pachurii-knowledge/empty-sekai-lake/fpga/openroad/ASAP7_STATIC_ANALYSIS.md

# ASAP7 Static RTL Analysis — Single-Core niigo-lake OoO + SoC

> **Scope:** the single-core out-of-order RISC-V core + SoC as it enters ASAP7 synthesis — build config
> `RV64 + OOO_4WIDE + L1_CACHES + L1D_CACHE + AXI_MEMSYS + FPGA_BUILD + SYNTHESIS` (COHERENT=0; CCD/L2 param/`ifdef`-gated off).
> **Target flow:** OpenROAD *integrated* synthesis (yosys-slang frontend + generic ABC technology map) onto the
> ASAP7 7.5-track 7nm predictive PDK (RVT cells, TT corner, 1× collateral). Generic ABC has **no DSP macros, no
> register retiming, and no SRAM-macro mapping step** — those three gaps drive most of what follows.

> **Method:** a multi-agent static-analysis workflow — 11 per-subsystem analyzers, each finding adversarially
> verified against the cited RTL by a second agent, then ranked/synthesized — cross-referenced against the
> real per-block ASAP7 Fmax measured in the OpenROAD trial run (pre-CTS, placed parasitics). 31 timing findings
> and 36 cell-mapping findings survived verification.

> _Generated 2026-07-02. This is a design reference for the `asap7-synth` branch; it recommends RTL/flow changes
> but the numbers above the whole-core scale wall are structural lower bounds, not a routed/closed Fmax._

---

## Executive summary

As synthesized today the single-core niigo-lake OoO+SoC is bound at **~41.7 MHz by the CVFPU FP64 FMA**, whose 53×53→106b mantissa multiply and the following 164-bit CPA sit in one register-bounded stage (`fpnew_fma.sv:338/381`); the CVFPU DISTRIBUTED split (NumPipeRegs=2) never partitions the `*` operator, and generic ABC has neither DSP macros nor register retiming to fix it. The `ooo_mul_unit` 64×64 multiply (`ooo_mul_unit.sv:94-95`) is the same disease one tier up at ~103.6 MHz. The single biggest *area/mappability* risk is that OpenROAD integrated-syn has **no SRAM-macro step, so every inferred memory becomes flops**: L1 data ~262 Kbit, ITTAGE ~306 Kbit, TAGE ~46 Kbit, plus the 4096-bit 8R4W phys_reg_file and the 32×~348b ROB — together the dominant cell area *and* the source of async 1024:1 / 64:1 read-mux delay cones. The whole-core Fmax is unmeasured (ABC died mid-rewrite at 8.85M ANDs — the scale wall), so the 42 MHz floor is a structural-certain lower bound, not a routed number. Headline recommendation: **blackbox the L1 data/tag and register-then-SRAM the ITTAGE/TAGE tables, and replace the two monolithic multipliers (`*`) with operator-internally-pipelined Booth/Wallace CSA trees** — this attacks the binding timing path and the #1 area sink simultaneously; everything else (branch_stack, LSQ store-format, phys_reg_file mux) is second-tier below the 42 MHz floor.

## Top timing bottleneck paths (ranked)

| Rank | Path | Subsystem | Root cause | Est. severity | Measured Fmax | Evidence |
|---|---|---|---|---|---|---|
| 1 | FMA mantissa mult → 164b CPA in one stage | niigo_fp_unit / CVFPU FMA | 53×53 `product = mantissa_a*mantissa_b` + `sum_pos/neg` 164b adders, no reg between; DISTRIBUTED doesn't split `*` | **BINDING (high)** | **41.7 MHz** | `cvfpu/src/fpnew_fma.sv:338,381,387`; `niigo_fp_unit.sv:44-52` |
| 2 | FMA normalize/round tail (no OUT reg) | niigo_fp_unit / CVFPU FMA | 109b LZC → 164b variable left shift → 63b round increment, NUM_OUT_REGS=0 | high (co-critical w/ #1) | 41.7 MHz | `fpnew_fma.sv:514-524,551,600-621`; `fpnew_rounding.sv:65` |
| 3 | ooo_mul 64×64 `*` in stage S1 | Int execute (mul) | monolithic 128-level array multiply, MUL_LATENCY=3 is metadata-only, no DSP/retiming | high | 103.6 MHz | `ooo_mul_unit.sv:94-95,91,160-170` |
| 4 | abort_mask/reset_mask squash broadcast | riscv_core_ooo cross-module | 4-bit net fanned to ~10 modules; `(* max_fanout=64 *)` ignored by yosys/ABC; routed OOC worst path abort_mask_q→DivUnit ~39ns | high (fanout/route-bound) | 199.8 (div logic); route binds | `riscv_core_ooo.sv:438-446,1506-1519` |
| 5 | branch_stack resolve→allocate two comb blocks in one cycle | Frontend checkpoints | Block R abort cross-product + 192b restore mux → Block A serial 4-slot allocate + 32×6b map copy, all reg→reg | high (frontend binder) | **74.3 MHz** | `branch_stack.sv:70-125,130-164,94-96` |
| 6 | LSQ block-W: wakeup CAM → AGU add → 128b store-format barrel shift ×16 | LSQ | per-entry CAM match → 64b AGU add → `format_store_split` 128b var shift, re-derived twice | high | — (standalone 12.2 artifact) | `load_store_queue.sv:855-919,1263-1286` |
| 7 | LSQ head-skip priority encoder → rotated 16:1 ~750b struct mux | LSQ | sq_valid over 16 + rotated reverse-priority scan + wide-struct mux, fed by abort_mask broadcast | high | — | `load_store_queue.sv:376-405,414,975-1038` |
| 8 | phys_reg_file 18-port async read + 4-way WB bypass | Rename/regfile | 64×64 flops, 18×64:1×64b read muxes + write-forward compare cascade pulls WB bus into read path | high | — (2229.9 is map-table, not RF) | `phys_reg_file.sv:26-43`; `riscv_core_ooo.sv:133` |
| 9 | ITTAGE async table read → 1024:1 mux → provider select → 64b target mux | Frontend indirect pred | async-read flop arrays at hashed idx, whole lookup in fetch cycle | high (unmeasured, pipelineable) | — (timeout >2400s) | `ittage_predictor.sv:66-102` |
| 10 | active_list commit head-skip → 4× 32:1 ~348b packet mux | ROB | rotating reverse-priority scan + wide-packet mux on input side of FB2b commit reg | medium | — (2.5 artifact) | `active_list.sv:257-292,306-348` |
| 11 | int_issue_queue wakeup CAM → select → 16:1 ~600b payload mux | Int issue | per-slot associative compare vs 6 tags → serial ALU 2-pick → 5-port payload mux, single-cycle loop | medium | — (0.9 artifact) | `int_issue_queue.sv:90-120,159-167,179-199` |
| 12 | ooo_writeback_bus 6→4 serial-priority crossbar + ready feedback | Writeback | lane-serial priority, 6:1 wide-packet mux, mul/div/fp_writeback_ready reg→comb→reg | medium | — | `ooo_writeback_bus.sv:70-106` |
| 13 | ooo_alu_pipe single-cycle 64b add + 3 barrel shifts + redundant target/cmp recompute | Int execute (ALU) | actual_target_for computed 3× + branch_cmp rerun, into one WB reg | medium | — (0/FAIL artifact) | `ooo_alu_pipe.sv:403-467,58-60,91` |
| 14 | DTLB/ITLB CAM → PMP 16-region priority match (data + 4× fetch) | Priv/MMU translate | 16-way assoc compare chained into 16×54b range-decode+priority-encode; 6 pmp_checker instances | medium | 264.6 (mmu_tlb UB) | `riscv_core_ooo.sv:1017-1071,1138-1170`; `pmp_checker.sv:65-119` |
| 15 | Commit-trap decode → trap_controller delegation → pc_next + die-wide flush | Commit/trap | 4-lane serial exception priority + medeleg/mideleg select + 32-wide restore mux fanout | medium | — | `riscv_core_ooo.sv:1944-2047,643-659,2361-2366` |

Below the 42 MHz floor and reported for completeness only: L1D/L1I load-hit 52-bit 4-way tag compare + way/word mux (`l1_dcache.sv:162-233`, `l1_icache.sv:149-171`), radix-16 divider 16-way mult-compare (199.8 MHz, `ooo_div_unit.sv:269-290`), PLIC 3-pass argmax (`plic.sv:120-150`), free_list 4-wide pointer carry (102.4 MHz).

## ASAP7 cell-mapping problems (ranked)

**Inferred-memory mass (flop-mapped; no SRAM step) — consolidated bit-count:**

| Array | Geometry | Bits | Read type | SRAM-able? |
|---|---|---|---|---|
| ITTAGE tables | 4×1024×64b target + tag/conf/useful/valid | **~306 Kbit** | **async** (hashed idx) | only after registering read |
| L1 data (L1I+L1D) | 2 × (4way×64set×512b) | **~262 Kbit** | sync 1R/1W-masked | **yes — textbook 1RW** |
| TAGE-SC-L tables | counter/useful/tag/base + sc_bias | ~46 Kbit | **async** | only after registering read |
| L1 tag (L1I 2×repl + L1D) | 4way×64set×52b (RV64) | ~40 Kbit | sync 1W1-2R | yes (1W2R→2×1RW) |
| RAS | 128×64b | ~8 Kbit | async 128:1 | no (shrink depth) |
| active_list ROB | 32×~348b | ~11 Kbit | 8W + 32-parallel | no (split payload) |
| phys_reg_file | 64×64b, 18R/4W async | 4096b | **async** | no (multiport) |
| FP regfile | 32×64b, 12R/4W async | 2048b | async | no (small) |
| LSQ entries | 16×~750b | ~12 Kbit | assoc CAM | no |
| IQ entries | 16×~600b | ~9.6 Kbit | assoc CAM 5R | no |

| Rank | Issue | Category | Geometry/detail | Severity | Evidence | Recommendation |
|---|---|---|---|---|---|---|
| 1 | L1 data arrays → ~262 Kbit flops | inferred-memory | 2×131072b, sync 1R(4-way)/1W byte-masked, reset-free | **high** | `l1_data_array.sv:36-50` | Blackbox 4× ASAP7 1RW 64×512 w/ byte-write (OpenRAM) per instance; #1 area sink |
| 2 | ITTAGE tables → ~306 Kbit flops, **async** read | inferred-memory | 1024-deep ×4 banks, 1024:1 async mux | **high** | `ittage_predictor.sv:34-47,80-102` | Register hashed idx into fetch-1 stage → sync-read → SRAM per bank; else cut INDEX_BITS |
| 3 | phys_reg_file 8R4W(→18-port) async RF | inferred-memory | 4096b flops + 18×64:1×64b mux + 4-way WB bypass in read cone | **high** | `phys_reg_file.sv:26-43` | Not SRAM-able; bank/replicate read ports, move WB bypass to registered read stage |
| 4 | ooo_mul + FMA monolithic `*` lose DSP+retiming | multiplier | 64×64→128b, 53×53→106b; ~104/~128 array levels | **high** | `ooo_mul_unit.sv:94-95`; `fpnew_fma.sv:338` | Booth-r4 + Wallace/Dadda CSA tree, pipe-cut at S0/S1/S2 (see roadmap #2) |
| 5 | TAGE tables → ~46 Kbit flops, async read | inferred-memory | 1024-deep, hashed idx | medium | `tage_sc_l_predictor.sv:39-49,85-130` | Register read → SRAM, or accept flops off critical path |
| 6 | L1 tag arrays flops; L1I 2× replicated (ren2 snoop) | inferred-memory | 52-bit RV64 tag drives 4-way compare; ~40 Kbit | medium | `l1_tag_array.sv:41-55`; `niigo_mem.vh:41` | Map 1W2R→two 1RW SRAM; or time-share L1I 2nd read port to avoid FF doubling |
| 7 | active_list ROB ~11 Kbit in squash/commit cone | inferred-memory | 32×348b, 8 random-idx writes + 32-wide clear | medium | `active_list.sv:89-120,196-209` | Split ~290b read-mostly payload into sync-read buffer keyed by active_id; keep control bits as flop ROB |
| 8 | RAS 128-deep flop array, full copy/cycle | inferred-memory | 8 Kbit + 128:1 mux; over-provisioned | medium | `riscv_core_ooo.sv:134,243,1734` | Reduce RAS_DEPTH 128→16-32 (4-8× FF cut); or 1W1R RF |
| 9 | FP regfile 12R4W async at rename | inferred-memory | 2048b, 3 src ×4 lanes broadcast | medium | `riscv_core_ooo.sv:412-413,1871-1874` | Read FP srcs at ISSUE not rename, or bank; shrinks 12×32:1 cone |
| 10 | Divider infers 16 mult-compares/iter | multiplier | 16×(68b×4b) + var 68b×4b per iter | medium | `ooo_div_unit.sv:274-278` | Comparator-only radix-16 (precompute 1..15× via adds) → no `*` inferred; timing OK, area lever |
| 11 | `(* max_fanout=64 *)` inert through yosys/ABC | xilinx-attr | 4-bit abort_mask to ~10 modules | medium | `riscv_core_ooo.sv:438-446` | Use OpenROAD `repair_design -max_fanout`; pre-replicate abort_mask per-consumer in RTL |
| 12 | Predictor arrays drop reset under SYNTHESIS → power-up X (not 0) as flops | reset-clock | ~352 Kbit no-reset flops; X tag/conf → spurious cold hits | medium | `ittage_predictor.sv:125-141`; `tage_sc_l_predictor.sv:170-187` | Add sync reset/POR-clear for tag/conf/valid bits (or BIST if SRAM); X-clean gate-sim |
| 13 | vendored `gated_clk_cell` is passthrough (ICG removed) | vendor-cell | `clk_out=clk_in`, enable dead → all CVFPU flops free-run | medium | `.../gated_clk_cell.v:37,47` | Swap in ASAP7 ICG cell for power gating, else accept dynamic power |
| 14 | reset-to-constant data arrays force async-set/reset DFF variety + wide reset net | reset-clock | RF SP/GP, free_list i+32, 32×348b ROB on one async tree | medium | `phys_reg_file.sv:45-49`; `free_list.sv:91-98` | Async-reset only pointers/valid; init payloads via first-write or small fill-FSM |
| 15 | niigo_memsys sim-fuzzer 5× 32b LCG + 64b cyc counter/adder/compare unguarded in FPGA build | initial-block / wide-arith | 5 const mults + `$test/$value$plusargs`; live device-latency 64b compare | low | `mem/niigo_memsys.sv:214-270,248-252,511-522` | `ifndef SYNTHESIS` the fuzzer; replace cyc_q scheme w/ small fixed down-counter |
| 16 | riscv_core_ooo perf-counter arrays + `initial $display` unguarded | initial-block | ~(buckets+40)×64b dead flops feeding only $display | low | `riscv_core_ooo.sv:2564-2567,2728-2745` | Wrap in `ifndef SYNTHESIS`/PERF_COUNTERS define |
| 17 | 6× pmp_checker duplicated 16×64b range-decode (4× FetchPMP) | wide-arith | per-fetch-lane replicas; page-granular perm identical across 16B block | low | `riscv_core_ooo.sv:992-999,1061-1068,1138-1147` | One region-match per fetch group + cheap per-word offset logic → cut ~3 decoders |
| 18 | Async reset core-wide, no reset-deassertion synchronizer | reset-clock | ~40 files posedge/negedge rst_l, single clock | low | `phys_reg_file.sv:45`; no rst_sync in src/ | Add 2-FF async-assert/sync-deassert reset synchronizer for tapeout |

CLINT/PLIC/UART state, mmu_tlb CAM, free_list/rename_map/busy_table, L1 valid/dirty/PLRU are **correctly** flops (associative/parallel/flash-clear semantics no SRAM can serve) — exclude from the SRAM pass; no latch/tri-state/vendor-primitive issues found outside the ICG cell.

## Recommended branch roadmap

Ordered by payoff-per-risk. Items 1-3 attack area+mappability with essentially zero functional risk; 4-5 attack the binding timing path with contained risk; 6+ are cleanup/flow.

1. **SRAM-macro blackbox the L1 data + L1 tag arrays.** The RTL is already textbook-SRAM-shaped (single sync read returning 4 ways, single byte-masked write per way). Map each L1 data way to an ASAP7 1RW 64×512 macro (OpenRAM/foundry compiler), L1 tag 1W2R→two 1RW copies, blackbox before ABC. **Payoff:** removes ~262 Kbit + ~40 Kbit of flops (the #1 area sink) and collapses the 64:1×512 read mux into a bitline access. **Correctness risk:** near-zero — module interface unchanged, behavior identical; verify byte-write-mask semantics match. **Bit-identical:** yes, single-core path unaffected (memory contents, not control).

2. **Replace the two monolithic multipliers with operator-internally-pipelined Booth/Wallace CSA trees.** `ooo_mul_unit` 64×64 and CVFPU FMA 53×53 each become Booth-radix-4 PP-gen + Dadda/Wallace reduction with an **explicit register between PP-generation and PP-reduction/CPA**, cutting at the existing S0/S1/S2 (mul) and INP/MID (FMA) boundaries. For the FMA the minimal first step is bumping ADDMUL `NumPipeRegs` (`niigo_fp_unit.sv:44`) so a reg lands mid-tree, but the coarse DISTRIBUTED split makes a dedicated pipelined multiplier module the reliable fix. **Payoff:** directly lifts the **41.7 MHz binding floor** and the 103.6 MHz mul path — the single highest-Fmax-leverage change. **Correctness risk:** medium — new multiplier RTL must be bit-exact vs the `*` result; validate against RV64G ACT M/D (289/289) and FP (D-fadd/fmul/fmadd) plus riscv-dv random vs Sail/Spike. Latency change ripples to scoreboard/wakeup timing — re-verify OoO scheduling. **Bit-identical:** architectural results identical; pipeline *depth* changes, so this is a microarchitectural (not COHERENT-gated) change — single-core semantics preserved, cycle counts differ.

3. **Register-then-SRAM (or shrink) the ITTAGE + TAGE tables.** Move the hashed index compute into a fetch-1 pipe stage so the array read is **synchronous**, do tag-compare/provider-select the next cycle, then map each 1024-deep bank to an ASAP7 SRAM; the async 1024:1 mux disappears. If a memory compiler is unavailable, cut INDEX_BITS (1024→256/512). **Payoff:** removes ~306+46 Kbit of async-read flops (largest predictor area) and takes the lookup off the fetch-cycle comb cone. **Correctness risk:** low-functional (predictions are hints, mispredicts recovered at branch resolve) but **adds a fetch-redirect latency cycle** — re-tune BP timing and confirm xv6 boot + branch-heavy riscv-dv still pass; also fix the power-up-X hazard (item 12) since flops no longer "power up to 0." **Bit-identical:** no (prediction timing shifts) — but architecturally transparent; keep off the COHERENT/CCD path (already excluded).

4. **branch_stack: split resolve/allocate into two pipe stages** (register `meta_premerge`/`valid_mask_premerge`), and register the 192b checkpoint restore mux. **Payoff:** lifts the 74.3 MHz frontend binder above the mul tier; unblocks whatever Fmax items 1-3 expose. **Correctness risk:** medium — checkpoint allocate/resolve is timing-sensitive to mispredict recovery; validate with riscv-dv branch-mask stress (the flow that found the `64daa82`/`80b6f86` deadlocks) + full ACT. **Bit-identical:** no (adds a cycle to checkpoint alloc) — microarch change, single-core semantics preserved.

5. **phys_reg_file + FP regfile: move the writeback bypass into a registered read stage and read FP sources at issue.** Bank/replicate read ports; drop the async-read requirement by adding one operand-read pipe stage. **Payoff:** removes the 18×64:1 + 4-way-compare cone from the read→execute path and the 12-way FP async read from rename. **Correctness risk:** high-touch — an added operand stage changes bypass timing across every FU; extensive ACT + riscv-dv re-verification. **Bit-identical:** no (pipeline depth) — do only if items 1-4 leave the RF cone binding.

6. **Latch/vendor/flow hygiene (low risk, do early alongside #1):** (a) swap `gated_clk_cell` passthrough for an ASAP7 ICG cell (or accept free-running FP flops); (b) `ifndef SYNTHESIS`-guard the niigo_memsys LCG fuzzer, the 64-bit cyc_q latency model, the perf-counter arrays, and the `initial $display`; (c) add a 2-FF reset-deassertion synchronizer; (d) reduce RAS_DEPTH 128→32; (e) rely on OpenROAD `repair_design -max_fanout` (not the inert Vivado attr) for abort_mask, and/or pre-replicate abort_mask per-consumer in RTL. **Payoff:** removes dead flops + wide sim-only arith from the netlist, fixes recovery/removal and X-propagation for tapeout. **Correctness risk:** minimal (sim-only or physical); the RAS-depth and buffering changes are functionally transparent. **Bit-identical:** RAS depth changes prediction only; the rest is synth-invisible.

7. **Flow-side options if the scale wall persists:** the whole-core ABC map died at 8.85M ANDs, so consider (a) an **external yosys + ABC with `-fast`/partitioned `synth` and `abc -dff`/retiming (`abc9`)** instead of integrated-syn, giving real register retiming that would materially help the multipliers/adders; (b) hierarchical/bottom-up synthesis (synthesize L1/predictor/FMA as pre-mapped macros, then the core) to dodge the flat-ABC blow-up; (c) config reduction for a first closing point — drop to RV32 (halves tag widths, mul/FMA sizes), fewer PHYS_REGS, smaller predictor tables. **Payoff:** a whole-core Fmax number at all, plus retiming for free on the `*`/CPA paths. **Risk:** flow-only, no RTL semantics change; RV32 config is a different verification target (RV32G 247/247), not the RV64 boot path.

## Verification & caveats

- **Structural-certain (verified by source inspection, independent of any Fmax number):** the two monolithic `*` operators (`ooo_mul_unit.sv:94-95`, `fpnew_fma.sv:338`), the async-read predictor arrays, the 8R4W phys_reg_file cone, the flop-mapping of all inferred memories (no SRAM step), the inert `max_fanout` attribute, the passthrough ICG cell, and the unguarded sim-only logic. These hold regardless of measurement.
- **Measured (pre-CTS placed parasitics, integrated-syn generic ABC):** only the **trustworthy self-contained blocks** — FMA 41.7, mul 103.6, div 199.8, branch_stack 74.3, free_list 102.4, mmu_tlb 264.6 (translate upper bound), ptw 655.6, rename_map 2229.9, busy_table 3506.6. The 42 MHz FMA is the lowest *real* block and the cited floor.
- **Do NOT quote as real numbers:** the standalone artifacts — int_issue_queue 0.9, tage_sc_l 1.3, active_list 2.5, load_store_queue 12.2, ooo_alu_pipe/dispatch/commit/fetch_decode 0/FAIL — are false combinational-loops through ports the core breaks externally, or const-fold to nothing in isolation. Their *structure* (ranked above) is real; their solo Fmax is meaningless.
- **Timeout (>2400s standalone, too big for solo ABC in 40 min):** l1_dcache, l1_icache, ittage_predictor, niigo_memsys — no isolated Fmax exists for these; their cones are ranked on structural depth only.
- **Scale wall / no whole-core number:** the full `riscv_core_ooo` slang-elaborates clean (0 err), ABC mapped 9.46M→8.85M ANDs then **died mid-rewrite** — there is **no measured whole-core Fmax**. The 42 MHz floor is therefore a *lower-bound binder*, not a routed/closed number; real whole-core Fmax will be at or below it once cross-module cones (abort_mask broadcast, translate chains, trap flush) and routing are included. FB2b's own observation that routed OOC ran ~5× worse than Quick-place on the Vivado/FPGA path corroborates that broadcast/route effects (rank 4) dominate once physical.
- **RV64 geometry drivers:** the 52-bit L1 tag comparator width and the FP64 53×53 / 64×64 multiply sizes are set by the RV64+Sv39 build; an RV32 config (roadmap #7c) materially shrinks all three. All numbers above are for the RV64 + OOO_4WIDE + L1_CACHES + L1D_CACHE + AXI_MEMSYS + FPGA_BUILD + SYNTHESIS single-core config (COHERENT=0, CCD/L2 param/ifdef-gated off).

---

## Appendix A — Per-subsystem verified findings (full detail)

_Every finding below survived the adversarial evidence-verification pass. `Fmax=-1` means no applicable
standalone measurement (artifact/timeout); see the caveats above._

### Frontend branch prediction (TAGE-SC-L / ITTAGE), fetch/decode, and branch checkpoint/recovery — single-core OoO RV64G+Sv39, ASAP7 via OpenROAD integrated-syn (yosys-slang + generic ABC, NO SRAM macros / NO retiming / NO DSP).

**Timing findings**

| # | Finding | Endpoints | Root cause | Sev | Fmax | Why ABC won't fix | Evidence |
|---|---|---|---|-----|---|---|---|
| 1 | branch_stack: two data-dependent always_comb blocks in series (resolve -> allocate) plus wide checkpoint restore/copy form the reg->reg critical path | meta_q[*]/valid_mask_q/map_q (regs) -> Block R resolve comb (meta_premerge/valid_mask_premerge) -> Block A allocate comb -> meta_next/valid_mask_next/map_next -> meta_q/valid_mask_q/map_q (regs) | The FB2b false-loop split left two combinational blocks chained in ONE cycle. Block R (resolve, lines 70-125) builds the abort cross-product by looping all BRANCH_STACK_SIZE(=4) checkpoints testing meta_q[slot].branch_mask[resolve_id] (lines 97-101), then clears/re-ANDs every checkpoint's branch_mask (lines 104-111). Its outputs valid_mask_premerge/meta_premerge feed Block A (allocate, lines 130-164): a serial first-free priority select over the 4 slots (lines 138-153) that also copies the 32x6-bit rename snapshot into map_next (lines 149-151). Add the 32x6b(=192-bit) map_q[resolve_id] restore mux (lines 94-96, a 4:1 over 32x6b vectors). All one register-to-register cone. | high | 74.3 | Single-cycle checkpoint allocate+resolve is architectural: both comb blocks read AND write the same registered arrays (meta_q/valid_mask_q/map_q) within one clock, so ABC cannot retime a register into the middle, and there is no DSP/arch lever. Only an RTL redesign (register meta_premerge, or split allocate/resolve into two pipe stages) removes it. Note: 74.3 MHz is above the 41.7 MHz FMA floor, so this is the frontend binding path but not the whole-core binder. | `src/branch_stack.sv:70-125 (Block R resolve + abort cross-product 97-111), 130-164 (Block A serial allocate + 32x6b map copy 149-151), 94-96 (192-bit restore mux)` |
| 2 | ittage_predictor: combinational (async) read of 1024-deep multi-bank tables -> 1024:1 mux tree -> tag compare -> serial provider priority -> 64-bit target select, all inside the fetch cycle | lookup_pc / history_q (input + reg) -> prediction_target / prediction_valid / prediction_info (comb outputs, consumed same fetch cycle to redirect fetch) | idx[0..2]/tag[0..2] are XOR hashes of lookup_pc and history_q (lines 66-78) used as COMBINATIONAL addresses into 1024-entry arrays read directly in always_comb (lines 80-102). With no SRAM step each async read is a 1024:1 mux; three banks are tag(10b)+confidence(2b) compared for hit (lines 80-82), a serial if-chain resolves the provider (lines 84-93), then a 4:1 unique-case mux selects among four XLEN=64-bit targets (lines 97-102). Giant mux cones stacked before the compare and the wide target select. | high | -1 | No SRAM-macro mapping step means the 306 Kbit stays flip-flops with async-read mux trees; because the read address is combinational, the array cannot even become a synchronous-read SRAM without moving the hash/read to a prior stage. ABC has no retiming/pipelining authority over this fetch-cycle lookup — it is an RTL/microarchitecture change. (Standalone ABC times out >2400s; no isolated Fmax.) | `src/ittage_predictor.sv:66-78 (hash addresses), 80-82 (per-bank hit compare), 84-93 (serial provider priority), 97-102 (64-bit 4:1 target mux)` |
| 3 | tage_sc_l_predictor: async multi-bank read + serial provider priority + statistical-corrector threshold compare produce the conditional prediction combinationally in the fetch cycle | lookup_pc / history (inputs) -> prediction / prediction_info (comb outputs, same fetch cycle) | Counter/tag/useful arrays are read combinationally at hashed indices (lines 85-112), feeding hit compares, a serial if-chain provider select (lines 114-123), a unique-case tage_prediction mux (lines 125-130), then the SC path: async sc_bias read, signed threshold pick and two signed comparisons for sc_override (lines 138-144). A chained read -> select -> signed-compare cone in one cycle. Tables ~45.5 Kbit, smaller than ITTAGE, so lower absolute depth. | medium | -1 | Same async-read flop-array structure with no SRAM step; the SC signed compares and provider chain are inherent to the algorithm in this stage. ABC cannot register/pipeline the fetch-cycle read; only registering the read (sync-read) or shrinking the corrector changes it. (Its standalone 1.3 MHz is a false-comb-loop artifact — not quoted as a real number.) | `src/tage_sc_l_predictor.sv:85-112 (async hashed reads), 114-130 (serial provider + tage_prediction), 138-144 (SC signed-threshold override compare)` |
| 4 | ooo_fetch_decode: serial control-prefix/fault dependency chain across the 4 lanes plus x4-replicated deep nested-case decoder feed decode_lanes combinationally | instr[3:0]/fetch_pc/fetch_fault_lane (inputs) -> decode_lanes[OOO_WIDTH] (comb outputs into rename) | prefix_unpredicted_control is a serial JAL/JALR carry chain across the 4 lanes (lines 37-43) and prefix_fault a second serial carry (lines 50-52); each lane's validity depends on the older lane. These gate four parallel riscv_decode instances (lines 57-75), each a deep nested unique-case opcode->funct3->funct7/funct12 tree (riscv_decode.sv:171-944), followed by immediate_for and uses_rs1/uses_rs2 combinational functions (lines 97-99). Replicated 4x with a serial prefix in front. | low | -1 | ABC can flatten/optimize the case logic but cannot remove the inherent per-lane serial prefix dependency or the 4x decoder replication; those are microarchitectural. Not the binding path (decode is registered before rename and the design floor is the 42 MHz FMA), listed for completeness of the fetch/decode cone. | `src/ooo_fetch_decode.sv:37-53 (serial prefix/fault chains), 57-75 (x4 decoder instantiation), 97-99 (imm/use functions); src/riscv_decode.sv:171-944 (nested unique-case decode tree)` |

**Cell-mapping findings**

| # | Issue | Category | Geometry/detail | Sev | Evidence | Recommendation |
|---|---|---|---|-----|---|---|
| 1 | ITTAGE predictor tables are ASYNCHRONOUS-read inferred memories; with OpenROAD integrated-syn having no SRAM-macro step they all map to flip-flops with 1024:1 async-read mux trees (largest single memory in this scope, and a real timing contributor to the ITTAGE timing finding). | inferred-memory | base_target + tage_target_0/1/2 = 4 x 1024 x 64b = 262,144b targets; base_valid 1024x1; tage_confidence/useful = 6 x 1024 x 2b = 12,288b; tage_tag = 3 x 1024 x 10b = 30,720b. Total 306,176 bits (~306 Kbit). Read: COMBINATIONAL/async, up to 4 distinct addresses/cycle (base_index + idx[0..2]); Write: 1 port (update). Async read. | high | `src/ittage_predictor.sv:34-47 (array declarations), 80-102 (combinational reads at idx/base_index)` | #1 area+timing item in this scope. As written the read is combinational so it cannot map to any SRAM macro: first register the read (compute idx/tag and read in a fetch-1 stage, feed a registered lookup) to make it synchronous-read, THEN target ASAP7 single-/dual-port SRAM macros via a memory compiler (one bank per 1024-deep array, packing tag+conf+useful into one word). If macros are unavailable, cut INDEX_BITS to shrink the flop count. Leaving it as 306 Kbit of async-read flops is the dominant area cost of the block. |
| 2 | TAGE-SC-L predictor tables are ASYNCHRONOUS-read inferred memories mapping to flip-flops (no SRAM step); smaller than ITTAGE but same structural problem. | inferred-memory | base_table 1024x2b + tage_counter_0/1/2 3x1024x2b + tage_useful 3x1024x2b + tage_tag 3x1024x10b + sc_bias 256x6b(signed). Total 46,592 bits (~45.5 Kbit). Read: combinational/async at hashed idx/base_index/sc_index; Write: 1 port. Async read. | medium | `src/tage_sc_l_predictor.sv:39-49 (declarations), 85-112 (async bank reads), 138-139 (async sc_bias read)` | Register the lookup read to enable sync-read SRAM mapping, or accept flops (45 Kbit is tolerable but still worst-case flop area). If moving to SRAM, merge each bank's counter+useful+tag into a single word so one 1024-deep macro serves a bank; the sc_bias (256x6) is small enough to stay flops. |
| 3 | Predictor arrays deliberately drop their reset under SYNTHESIS (`ifndef SYNTHESIS` gates the async reset and the array-clear loops), on the premise that inferred RAM powers up to 0 — but with no SRAM-macro step they become FLOPS that power up to X in silicon; uninitialized tag/confidence bits can produce spurious cold-start 'hits'. | reset-clock | ~306 Kbit (ITTAGE) + ~46 Kbit (TAGE-SC-L) of flip-flops with no reset. always_ff is posedge-clk-only under SYNTHESIS; tag/confidence/useful/valid start X until first overwrite. | medium | `src/tage_sc_l_predictor.sv:170-187 (reset in `ifndef SYNTHESIS`, comment 32-38); src/ittage_predictor.sv:125-141 (reset in `ifndef SYNTHESIS`, comment 29-32)` | Functionally self-correcting (targets/predictions are hints, mispredicts recovered by branch resolve), but the 'RAM powers up to 0' premise is false under ASAP7 flop mapping. If the tables stay flops, add a synchronous reset for at least the tag/confidence/valid bits (or a small power-on clear FSM) so cold-start hits cannot fire on X; if they become SRAM macros, add a BIST/clear sequence. Also flag for X-propagation-clean gate-sim. |

### OoO rename/dispatch/ROB/regfile array cluster (ooo_dispatch_control, rename_map_table, free_list, busy_table, active_list, phys_reg_file) — RV64G single core, ASAP7 integrated-syn (yosys-slang + generic ABC, no SRAM macros / no retiming / no DSP)

**Timing findings**

| # | Finding | Endpoints | Root cause | Sev | Fmax | Why ABC won't fix | Evidence |
|---|---|---|---|-----|---|---|---|
| 1 | phys_reg_file: 18 async read ports x 64:1x64b operand mux + 4-port write-forward cascade over a 64x64 flop RF | registers[63:0][63:0] flops (and writeback-bus write_data) -> rs1_data[9]/rs2_data[9] outputs -> ALU0/ALU1/mul/div/FP operand inputs | READ_PORTS is overridden at instantiation to PHYS_READ_PORTS = FU_ISSUE_PORTS(5)+OOO_WIDTH(4) = 9 (riscv_core_ooo.sv:133), so the always_comb builds 18 combinational read ports (9 rs1 + 9 rs2). Each read is registers[rs1[i]] -- a 64:1, 64-bit-wide select tree off the flat flop array (phys_reg_file.sv:30-31) -- followed by a 4-way write-forward compare/mux cascade (write_prd[w]==rs1[i] -> substitute write_data[w], :32-40). With no SRAM-macro step the whole 4096-bit array is flops and every operand is a pure combinational AOI mux cone; the write-forward also pulls the writeback bus into the read path. | high | -1 | Generic ABC has no SRAM-macro mapping step, so the array stays flops and the read stays a combinational 64:1x64b tree per port; the read is async (always_comb) so it cannot become a clocked SRAM port without an added operand pipe stage (an RTL/arch change ABC cannot do); ABC can only rebalance the mux/AOI depth, not remove the 18x64:1 select or the write-forward compare cascade. | `src/phys_reg_file.sv:26 (flat flop array), :28-43 (18-port async read + 4-way write bypass), :30-31 (64:1 read), :32-40 (write-forward); src/riscv_core_ooo.sv:133 (PHYS_READ_PORTS=9)` |
| 2 | free_list: 4-wide serial allocate/free pointer carry chain over the 64-entry circular buffer | entries_q[64]/head_q/tail_q/count_q flops -> alloc_prd[3:0] outputs (and entries_next -> entries_q writeback) | The allocate loop advances head_next data-dependently through 4 lanes, each iteration doing a 64:1 6-bit read entries_next[head_next] then head_next+1 (carry-style serial dependency, free_list.sv:61-70); the free loop then advances tail_next through 4 lanes writing entries_next[tail_next] (:72-78); count_next threads a serial 4-add/4-sub chain and the restore path adds free_distance() (a subtract + wrap-compare, :46 & :81-89). All 4 pops + 4 pushes of the FIFO resolve in one cycle as a serial ripple. | medium | 102.4 | The 4-deep pointer carry-dependency and the variable-index array read/write muxes are algorithmic (one-cycle 4-wide pop+push of a circular FIFO); the entire cone is confined to one always_comb feeding registers, so there is no internal register boundary for ABC to retime across, and ABC keeps no DSP/carry structure that would collapse the serial adds. Measured 102 MHz is well above the 42 MHz binding block, so this is a second-tier structural item, not the critical path. | `src/free_list.sv:61-70 (serial head_next alloc chain + indexed read), :72-78 (serial tail_next free-push), :46 & :81-89 (restore_reclaim free_distance), :39-48 (count reductions)` |
| 3 | active_list commit SKIP+PRESENT: 32-entry rotating head-skip priority scan feeding four 32:1 ~348-bit ROB-packet muxes | entries_q[32] (~348b each) + abort_mask -> sq_valid[32] -> head_skip_n reverse-priority scan -> base_head -> 4x 32:1 commit-packet select -> commit_valid_next/commit_packet_next register | sq_valid is computed from all 32 entries (valid && (branch_mask & abort_mask)==0, active_list.sv:257-260). head_skip_n is a 32-iteration reverse (k=31..0) priority encode whose index is a variable-rotated wrap address head_after_pop+k, i.e. a barrel-rotate select over the 32-bit valid vector (:283-292). base_head then drives four parallel 32:1 muxes each selecting a full ~348-bit active_entry_t packet (pc/instr/data/csr_wdata/fp_data..., :293 & :306-348). This rotate-priority-select + wide packet mux is the deepest residual combinational cone inside the ROB on the input side of the FB2b commit register. | medium | -1 | The FB2b 2-stage cut already registered the commit OUTPUT (commit_valid_q/commit_packet_q), but this select cone lives entirely on the input side of that register, so retiming cannot move it further without a new arch stage; the variable-rotation priority select and the 4x 32:1 wide-packet mux are structural -- ABC rebalances AOI depth but cannot remove the 32-way rotate/select or narrow the packet. (Standalone active_list Fmax of 2.5 MHz is a false-comb-loop artifact and not quoted.) | `src/active_list.sv:257-260 (sq_valid over 32), :283-292 (rotating reverse priority scan), :293 & :306-348 (base_head -> 4x 32:1 ~348b packet mux), :89-115 (active_entry_t width, ACTIVE_LIST_SIZE=32 in ooo_types.vh:22)` |

**Cell-mapping findings**

| # | Issue | Category | Geometry/detail | Sev | Evidence | Recommendation |
|---|---|---|---|-----|---|---|
| 1 | phys_reg_file 'registers' infers a 64x64-bit (4096-bit) multi-ported register file with 18 async read ports + 4 write ports; with no SRAM-macro step it becomes ~4k flops plus 18 combinational read-mux cones -- the #1 area item and a real read-mux timing item. | inferred-memory | 64 deep x 64 wide = 4096 bits; 18 async (combinational) read ports (9 rs1 + 9 rs2, READ_PORTS=9) with 4-port same-cycle write-forward; 4 sync write ports | high | `src/phys_reg_file.sv:26 (logic [PHYS_REGS-1:0][XLEN-1:0] registers), :28-43 (async read + write-forward), :51-56 (4 write ports); src/riscv_core_ooo.sv:133 (READ_PORTS=PHYS_READ_PORTS=9)` | An 18-async-read / 4-write RF cannot map to a single-/dual-port ASAP7 SRAM. Options: (1) instantiate a hard multi-port RF / latch-array macro; (2) bank + read-replicate into compiled SRAMs with synchronous (registered) read and add one operand-read pipe stage (drops the async-read requirement); or (3) accept flops but expect ~4k DFF + 18x64:1x64b mux area/delay. As-is it stays flops and is both the largest area and a HIGH operand-mux delay. |
| 2 | active_list entries_q infers a 32-entry x ~348-bit (~11 Kbit) ROB flop array with 8 random-index write ports (4 allocate-by-active_id + 4 writeback-by-writeback_id) plus an all-32-entry branch-mask clear/squash every cycle -- correctly flops (not SRAM-able), but ~11 Kbit of flops sitting in the commit/broadcast cone. | inferred-memory | 32 deep x ~348 bits (~11 Kbit); 4 allocate + 4 writeback random-index write ports + 32-wide parallel branch-mask clear; 4x 32:1 read for commit present | medium | `src/active_list.sv:89-115 (active_entry_t ~348b), :119-120 (entries_q[32]/entries_next), :196-209 (all-entry reset_mask/abort_mask update), :380-428 (4 allocate writes), :434-452 (4 writeback writes)` | Keep the control ROB as flops (8 write ports + all-entry parallel update rule out an SRAM), but shrink the flop count: split the wide read-mostly payload (pc/instr/data/csr_wdata/fp_data ~290 of the ~348 bits) into a separate sync-read buffer/SRAM indexed by active_id and keep only the control/status bits (valid/done/exception/exc_cause/halted/branch_mask/is_*/rd/prd/old_prd) in the flop ROB. That removes ~9 Kbit of flops from the squash-broadcast and commit-present cones. |
| 3 | Large async-reset-to-constant data arrays force the bigger async-reset DFF variants and a per-index SET/RESET flop mix, and create a very high-fanout reset net: phys_reg_file resets 4096 RF flops (all-0 then SP=STACK_END, GP=USER_DATA_START), free_list resets entries_q[i] <= i+32 (64 flops each to a DIFFERENT constant), active_list resets 32x~348-bit entries_q. | reset-clock | async active-low reset; ~4096 RF flops (2 per-index non-zero constants) + 64x6 free-list flops (64 distinct constants) + ~11 Kbit ROB flops, all on one async reset tree | medium | `src/phys_reg_file.sv:45-49 (registers<='0 + SP/GP constants); src/free_list.sv:91-98 (entries_q[i]<=i+32 per-index constant); src/active_list.sv:477-490 (32x~348b async reset)` | On ASAP7 async reset-to-constant needs the larger async DFF cells and, for free_list's i+32 / phys_reg_file's SP/GP, a bit-pattern-dependent mix of preset/clear flops plus a die-wide reset net. Reset only the pointers/valid bits async (head/tail/count, entry.valid) and make the data payloads reset-less or sync-reset, initializing the free-list ordering and SP/GP via the first writes or a tiny reset-fill FSM. This cuts reset fanout, avoids the SET/RESET DFF variety, and unblocks moving payloads to SRAM (per the active_list/phys_reg_file recommendations). |
| 4 | free_list entries_q (64x6), rename_map_table map_q (32x6) and busy_table busy_q (64x1) infer small multi-ported flop arrays -- confirmed NOT SRAM candidates (too small / too many concurrent random-index ports) and correctly left as flops; no latch inference in any of the six modules (every always_comb output is fully defaulted). | inferred-memory | free_list entries_q 64 x 6 bits (384b); rename map_q 32 x 6 bits (192b); busy_q 64 x 1 bit; all small, multi-write, async-read | low | `src/free_list.sv:25-26 (entries_q 64x6); src/rename_map_table.sv:25-26 (map_q/map_next 32x6); src/busy_table.sv:20 (busy_q 64x1); default-assign heads at phys_reg_file.sv:30-31 (rs*_data defaulted before write-forward), no latches` | Leave these as flops -- an SRAM macro cannot serve their 4 concurrent write / 8-12 concurrent async-read random-index patterns, and at 384/192/64 bits the flop cost is negligible. No action needed; documented here to close out the SRAM-vs-flops question and to confirm no latch/tri-state/vendor-primitive/initial-block issues exist in this scope. |

### OoO integer issue/execute + writeback datapath (int_issue_queue, ooo_alu_pipe, ooo_mul_unit, ooo_div_unit, ooo_writeback_bus); RV64 + OOO_4WIDE + L1D + AXI + FPGA_BUILD + SYNTHESIS, ASAP7 via OpenROAD integrated-syn (yosys-slang + generic ABC map, no DSP/no retiming/no SRAM macros)

**Timing findings**

| # | Finding | Endpoints | Root cause | Sev | Fmax | Why ABC won't fix | Evidence |
|---|---|---|---|-----|---|---|---|
| 1 | Monolithic 64x64 combinational multiply confined to one pipe stage (mul unit critical path) | s0_lhs_mag_q / s0_rhs_mag_q (stage-0 magnitude regs) -> combinational 64x64 unsigned array multiply -> s1_prod_mag_q (stage-1 128-bit product reg) | MUL_LATENCY=3 is a METADATA pipeline: S0 captures operand magnitudes+sign, S2 does the two's-complement sign-restore + width-select, but the ENTIRE 128-bit partial-product reduction is a single '*' living wholly in S1 ({0,s0_lhs_mag_q}*{0,s0_rhs_mag_q} at :94-95). No register in the middle of the product, so the CSA/array reduction is one un-split combinational cone. | high | 103.6 | Generic ABC has no register retiming to spread the CSA tree across the S0->S1->S2 flops, and no DSP48 macro to absorb the array; it maps '*' to a flat ~128-level ripple of AND2 + full-adder cells with no re-balance/pipeline. Fix requires an explicitly-registered Booth/Wallace multiplier in RTL. | `src/ooo_mul_unit.sv:94-95 (single '*'); :42-48 (S0/S1 stage regs); :30 (MUL_LATENCY=3); :160-170 (S2 mul_select negate+width-select)` |
| 2 | Wakeup-CAM -> ready-select priority pick -> 16:1 wide payload mux (single-cycle scheduler wakeup/select loop) | entries_q[0..15] (IQ slot regs) -> associative wakeup compare (entries_wake) -> sel_rdy -> lowest_idx pick-2 -> 16:1 issue_entry_t (~600b) mux -> issue_entry[port] (select->execute pipeline register) | Per cycle every one of 16 slots compares prs1 AND prs2 (6b each) against OOO_WIDTH=4 completion tags + ALU_ISSUE_PORTS=2 speculative tags, the ready set feeds sel_rdy, then a SERIAL ALU pick-2 (alu1 candidate mask depends on alu0_idx), then a 16-to-1 mux of the ~600-bit issue_entry_t on each of 5 FU ports. Classic wakeup->select->payload-mux single-cycle loop. | medium | -1 | Single-cycle by construction (back-to-back issue needs wakeup->select->execute in one cycle), so no register to retime into; ABC cannot restructure a CAM/associative compare into a faster primitive. NOTE: the standalone 0.9 MHz is a false comb-loop artifact through core-broken ports, NOT a real number. | `src/int_issue_queue.sv:90-120 (wakeup CAM); :143-154 (sel_rdy/eligibility); :159-167 (serial ALU 2-pick); :317-322 (lowest_idx priority encoder); :179,184,189,194,199 (16:1 entries_wake[idx] payload muxes); struct src/ooo_types.vh:104-130` |
| 3 | 6->4 serial-priority writeback crossbar with writeback_ready readback into FU advance | alu0/alu1/load/mul/div/fp writeback packets -> source_valid abort gate -> serial lane(4) x source(6) priority arbiter -> per-lane 6:1 wide packet mux -> writeback_data/prd/... (phys_reg_file write + wakeup); AND source_accepted[3/4/5] -> mul/div/fp_writeback_ready -> FU advance | A 6-source -> 4-lane crossbar where lane N's assignment depends on lanes 0..N-1 via source_accepted (serial priority chain), each lane a 6:1 mux of the full writeback_packet_t. The same arbiter combinationally produces mul/div/fp_writeback_ready which flow back to the FU advance logic (reg->comb->reg cross-module path). | medium | -1 | The arbiter must resolve within the writeback cycle (pure comb between reg stages by design), so no retiming applies; ABC cannot parallelize the lane-serial priority dependency or shrink the wide 6:1 packet mux without an RTL restructure (e.g. per-source pre-assigned lanes). | `src/ooo_writeback_bus.sv:70-73 (source_valid abort gate); :75-99 (serial lane x source arbiter + wide packet mux); :101-106 (writeback_ready feedback to FUs)` |
| 4 | abort_mask / reset_mask high-fanout broadcast to per-FU/per-slot branch-mask compares | branch-recovery register (abort_mask_q / reset_mask) -> (branch_mask & abort_mask)!=0 compares and (branch_mask & ~reset_mask) ages in every issue-queue slot, both ALU pipes, mul (per stage), div, and the writeback bus | A single 4-bit control vector is broadcast to essentially every stateful element in the issue/execute/writeback cluster; a very high-fanout net whose placed delay is buffer-tree/routing dominated, not logic-level dominated. | medium | -1 | Fanout/buffering is a place-and-route + buffer-tree problem, not Boolean restructuring. The committed (* max_fanout=64 *) split (riscv_core_ooo.sv ~445) caps levels but latency plateaus once route-bound (matches the FB2b routed-OOC ~5x-worse observation); ABC does not add or balance the buffer tree. | `abort_mask: src/int_issue_queue.sv:145,223,291; src/ooo_alu_pipe.sv:45,115; src/ooo_mul_unit.sv:54,89,99,109; src/ooo_div_unit.sv:61,111; src/ooo_writeback_bus.sv:72,101-106,121-125. reset_mask: src/int_issue_queue.sv:91; src/ooo_mul_unit.sv:87,93,102,117; src/ooo_div_unit.sv:172` |
| 5 | Single-cycle 64-bit ALU: barrel shift + adder + branch-target adder + redundant compare/target recompute | rs1_data / rs2_data -> {alu_result 64b add/sub + SLL/SRL/SRA barrel shifters + SLT comparators, op-muxed} and {actual_target_for pc+imm / (src1+imm) adders} and {branch_cmp} -> wb_next.{data,redirect_pc,branch_mispredict} -> writeback reg | One always_comb builds the whole ALU result AND branch resolution in a single cycle: a 64-bit adder plus three 64-bit barrel shifters op-muxed, in parallel with actual_target_for (evaluated at :60, AGAIN inside branch_mispredict_for :383, and control_taken re-runs branch_cmp at :91). The redundant target/compare re-evaluations widen the cone into the single writeback register. | medium | -1 | Single-cycle ALU by design -- no register to retime into. ABC may CSE the thrice-computed actual_target_for/branch_cmp, but the irreducible 64-bit barrel-shift + adder + comparator mux cone remains. Standalone 0/FAIL is a const-fold artifact, not a real number. | `src/ooo_alu_pipe.sv:433-451 (alu_result add/shift/slt case); :403-415 (actual_target_for adders); :58-60 (redirect_pc + branch_mispredict); :91 (control_taken -> branch_cmp); :454-467 (branch_cmp)` |
| 6 | Radix-16 quotient-digit select: 16-way multiply-compare per iteration + terminal-iteration tail | remainder_q / divisor_q / dividend_q (regs) -> trial_remainder shift-in -> select_qdigit (16x (68b x 4b) multiply + 68b '<=' compare, keep-largest) -> 68b subtract -> (final iter) sign-restore negate + word_result sext -> remainder_q / packet_q.data (regs) | select_qdigit evaluates divisor*i and compares against the remainder for all 16 candidate digits combinationally (a 16-wide multiply+compare tree), followed by the 68-bit partial-remainder subtract. On the terminal iteration the same cone additionally chains final_result's two's-complement negate and the W-form sext in one cycle. | low | 199.8 | No retiming across the iterative FSM's per-cycle boundary; the 16-way mult-compare is structural. Reported for completeness -- 199.8 MHz is well above the mul/FP binding floor, so not the core critical path, but it is why the divider does not go faster. | `src/ooo_div_unit.sv:269-279 (select_qdigit 16-way mult-compare); :136-140 (trial_remainder + subtract); :144-150 (terminal-iteration inline recompute); :281-290 (final_result negate)` |

**Cell-mapping findings**

| # | Issue | Category | Geometry/detail | Sev | Evidence | Recommendation |
|---|---|---|---|-----|---|---|
| 1 | The 64x64 magnitude multiply is a single behavioral '*'. On Vivado this infers a retimed DSP48 cascade; under ASAP7 integrated-syn (generic ABC, no DSP, no retiming) it maps to a flat combinational array/CSA multiplier of AND2 + full-adder cells -- the ~104 MHz path and a large AND-gate/area contributor. | multiplier | 64x64 -> 128-bit unsigned product, one combinational stage (S1); ~128 logic levels; plus a 128-bit negate + 128:64 width-select in S2 | high | `src/ooo_mul_unit.sv:94-95 (the '*'); :160-170 (128-bit two's-complement negate + width-select in mul_select); :30 (MUL_LATENCY=3, metadata-only)` | Do not rely on retiming/DSP. Instantiate an explicitly-pipelined multiplier: Booth-radix-4 partial-product gen + a Wallace/Dadda CSA tree with the partial sums REGISTERED across S0/S1/S2 so ABC sees a balanced, already-split array; or split the '*' into hi/lo partial products registered mid-tree. |
| 2 | The divider infers multipliers inside its iteration: select_qdigit computes divisor_ext*i for i=0..15 (16 constant multiplies) and the remainder/terminal update use divisor_q*qdigit (variable 68b x 4b). Generic ABC folds the constant multiplies to shift-add and maps the variable one to array logic, replicated per iteration -- area-heavy even though timing (200 MHz) is acceptable. | multiplier | 16x (68b x 4b-constant) multiply + 68b compare per iteration; plus one 68b x 4b variable multiply on the remainder update | medium | `src/ooo_div_unit.sv:274-278 (16x divisor_ext*REM_W'(i) compare); :139-140 and :148-149 (REM_W'(divisor_q) * REM_W'(qdigit))` | Replace the 16-way multiply-compare with comparator-only radix-16 digit selection: precompute the 1x..15x divisor multiples once per division via adds (or drop to non-restoring radix-4 with 2 subtract/compare per step) so NO '*' is inferred inside the loop; removes the array-multiplier instances from the mapped netlist. |
| 3 | entries_q is a 16-entry array of the ~600-bit issue_entry_t (~9.6 Kflop) with 4-wide parallel insert, per-slot associative wakeup writes, and an all-slot parallel read for the 5-port select. This is the 'memories-become-flops' area problem, but here it correctly CANNOT be an SRAM (associative wakeup CAM + parallel 5-port select read + 4-wide write). Note the 3x64b FP operand fields (fp_src1/2/3_data) ride in every integer slot too. | inferred-memory | 16 depth x ~600b x (4 write ports + per-slot wakeup update) x (5-port full parallel read) -- async associative read/CAM, ~9.6 Kflop; ~192b of that is FP operand payload (3x fp_reg_data_t=64b) | low | `src/int_issue_queue.sv:32-33 (entries_q/entries_next); struct src/ooo_types.vh:104-130 (issue_entry_t: pc/imm/predicted_pc 3x64b + fp_src1/2/3_data 3x64b)` | Keep as flops -- no SRAM macro applies (associative + 5-port parallel). The actionable ASAP7 area lever is narrowing what the IQ replicates: hold the 3x64b FP operands in a separate small payload store read only when an FU_FP entry is picked, instead of carrying fp_src1/2/3_data in all 16 CAM slots. |

### niigo_fp_unit / CVFPU FMA (fpnew_fma, FP64 PARALLEL ADDMUL instance)

**Timing findings**

| # | Finding | Endpoints | Root cause | Sev | Fmax | Why ABC won't fix | Evidence |
|---|---|---|---|-----|---|---|---|
| 1 | 53x53 mantissa multiply co-located with the 164-bit 3-operand aligned adder in ONE pipeline stage (the FP64 FMA binding cone) | inp_pipe_operands_q[1] (FMA input pipe reg, NUM_INP_REGS=1) -> mid_pipe_sum_q[1] (FMA mid pipe reg, NUM_MID_REGS=1) | In DISTRIBUTED mode with NumPipeRegs=2 the split resolves to NUM_INP_REGS=1 / NUM_MID_REGS=1 / NUM_OUT_REGS=0 (fpnew_fma.sv:79-93). Between the input reg and the mid reg (which captures `sum`) sit, in strict series: fpnew_classifier -> op_select -> the single combinational mantissa multiply `product = mantissa_a * mantissa_b` (53x53 -> 106b, fpnew_fma.sv:338) in parallel with the variable addend align barrel-shift `(mantissa_c << 163) >> addend_shamt` (fpnew_fma.sv:362-363), both feeding the 164-bit (3p+5) carry-propagate adder `sum_pos = product_shifted + addend_shifted + inject_carry_in` (:381) plus the parallel 164-bit subtractor `sum_neg` (:387) and the select mux (:390). No register sits between the multiplier product and the CPA, so a full 53x53 array multiply followed by a 164-bit add resolves in a single clock => 41.7 MHz. | high | 41.7 | Generic ABC technology mapping does NO register retiming and NO DSP inference: the `*` becomes a flat partial-product ripple/array (no Booth/Wallace pipelining, no DSP48 macro), and the fixed DISTRIBUTED register placement pins the multiply and the 164-bit CPA into the same stage. ABC cannot move a register between product and sum, balance the two stages, or map the array multiply to a faster macro. Fix requires an RTL change: raise NumPipeRegs so a register lands between PP-generation and PP-reduction/add, or swap in an explicitly pipelined multiplier. | `src/cvfpu/src/fpnew_fma.sv:338 (product = mantissa_a*mantissa_b), :328-330 (widths: product 2p=106b, product_shifted 3p+4=163b), :343 (product_shifted), :362-363 (addend align barrel shift), :381/:387/:390 (sum_pos/sum_neg 164b adders + select mux); split params src/cvfpu/src/fpnew_fma.sv:79-93; NumPipeRegs=2/DISTRIBUTED src/niigo_fp_unit.sv:43-53; wrapper note src/niigo_fp_unit.sv:34-42` |
| 2 | Second FMA stage (normalize + round) has no trailing output register: LZC(109b) -> 164-bit variable left barrel shift -> 63-bit rounding increment resolve in one clock | mid_pipe_sum_q[1] (FMA mid reg) -> fpnew_buffer_result_q (niigo_fp_unit output buffer reg, niigo_fp_unit.sv:200-205) | Because NUM_OUT_REGS=0 (NumPipeRegs=2, DISTRIBUTED), the entire post-multiply cone is one register-bounded stage: leading-zero count over LOWER_SUM_WIDTH=2p+3=109 bits (i_lzc, fpnew_fma.sv:517-524) -> norm_shamt select (:529-548) -> the variable NORMALIZATION left barrel shift `sum_shifted = sum_q << norm_shamt` over 164 bits with shamt ~0..163 (:551) -> small_norm 1-bit renorm mux (:555-575) -> the rounding carry-propagate increment `abs_rounded_o = abs_value_i + round_up` over EXP+MAN=63 bits (fpnew_rounding.sv:65). Its output feeds straight out of fpnew_fma (out_pipe has 0 regs) into the wrapper buffer register. Co-critical with (next-limiting after) the multiply stage inside the same measured 41.7 MHz block. | medium | 41.7 | No retiming means ABC cannot pull a register into this stage from the wrapper buffer, and the 164-bit variable shift + 63-bit CPA are inherently log-depth mux/carry chains that ABC maps as-is. Only an added pipeline register (higher NumPipeRegs, i.e. an OUT stage) or a carry-select/prefix-adder + registered LZC restructure shortens it. | `src/cvfpu/src/fpnew_fma.sv:514-524 (sum_lower + 109b lzc), :551 (sum_q << norm_shamt, 164b variable shift), :555-575 (small_norm + sticky), :600-621 (pre-round assemble + fpnew_rounding instance), src/cvfpu/src/fpnew_rounding.sv:65 (63b increment); NUM_OUT_REGS=0 at src/cvfpu/src/fpnew_fma.sv:89-93; buffer capture src/niigo_fp_unit.sv:200-205` |

**Cell-mapping findings**

| # | Issue | Category | Geometry/detail | Sev | Evidence | Recommendation |
|---|---|---|---|-----|---|---|
| 1 | The FMA mantissa multiply is a single combinational `*` that loses both DSP mapping and retiming under OpenROAD generic-ABC synthesis, becoming a flat partial-product array (the #1 timing AND area cost of the binding block). | multiplier | 53x53 -> 106-bit unsigned combinational multiply (PRECISION_BITS=53 for FP64); one fpnew_fma instance per active FP format under PARALLEL ADDMUL; purely combinational, no internal registers, product width 2p=106b. | high | `src/cvfpu/src/fpnew_fma.sv:338 (assign product = mantissa_a * mantissa_b) with widths at :328-330` | ASAP7/ABC has no DSP macro and no retiming, so the monolithic `*` must be restructured in RTL: instantiate a pipelined Booth-radix-4 + Wallace/Dadda-tree multiplier with an explicit register between PP-generation and PP-reduction (or between reduction and the final CPA), or map to a characterized ASAP7 multiplier block. Minimally bump ADDMUL NumPipeRegs (niigo_fp_unit.sv:44), but the coarse DISTRIBUTED split means a hand-placed register or a dedicated multiplier module is the reliable fix. |
| 2 | Two large VARIABLE barrel shifters in the FMA datapath map to deep 2:1 mux trees (no shifter macro, no retiming) and, with the multiply, dominate the two FMA stages. | wide-arith | Addend align shift: 53-bit mantissa_c placed into a 3p+4=163b field then right-shifted by a 0..163 variable amount. Normalization shift: 164b (3p+5) `sum_q << norm_shamt`, shamt ~0..163. Both fully combinational. | medium | `src/cvfpu/src/fpnew_fma.sv:362-363 (addend align shift) and :551 (normalization shift)` | Register the shift amount and split each barrel shifter across a pipeline boundary (log-depth mux tree per stage), keeping the align shift out of the same stage as the multiply. On ASAP7 these become balanced 2:1 MUX2 trees; without an added register ABC leaves them in the single register-bounded stage they sit in today. |
| 3 | Wide ripple carry-propagate adders in the FMA/round path (no carry-select / prefix-adder structure, no retiming) add to the two stage delays. | wide-arith | Two 164-bit (3p+5) mantissa adders sum_pos/sum_neg in stage 1, and one 63-bit (EXP+MAN) rounding increment in stage 2; all plain `+` combinational CPAs. | low | `src/cvfpu/src/fpnew_fma.sv:381 (sum_pos) and :387 (sum_neg); src/cvfpu/src/fpnew_rounding.sv:65 (abs_value_i + round_up)` | ABC synthesizes these as ripple/simple CPAs; for ASAP7 timing let them share a pipeline boundary with the shifters (see above) and, if still critical, force a prefix (Kogge-Stone/Brent-Kung) adder via an explicit adder module rather than relying on ABC to pick a fast carry structure. |

### LSQ + OoO memory subsystem (load_store_queue, niigo_memsys) — synth config RV64 + OOO_4WIDE + L1_CACHES + L1D_CACHE + AXI_MEMSYS + FPGA_BUILD, single core (COHERENT=0, no CCD)

**Timing findings**

| # | Finding | Endpoints | Root cause | Sev | Fmax | Why ABC won't fix | Evidence |
|---|---|---|---|-----|---|---|---|
| 1 | LSQ wakeup CAM -> AGU 64-bit adder -> 128-bit store-format barrel shifter (format_store_split), replicated x16 entries | writeback bus wakeup_prd[3:0]/wakeup_data[3:0] -> entries_wake[*].store_data/.store_mask/.addr (registered into entries_q) | Block W (the sole wakeup reader) runs, for each of the 16 MemQ entries, a 4-lane x 2-operand 6-bit associative match (prs1==wakeup_prd[w], prs2==wakeup_prd[w]). An rs1 match drives a 64-bit AGU add (addr = wakeup_data + imm, line 862); an rs2 match calls format_store_split, a 128-bit variable left shift ({{XLEN{0}},value}<<{byte_sel,3'b0}) plus a parallel 16-bit byte-mask barrel shift (1280-1281). A SECOND per-entry loop (896-919) re-derives the same fields with another format_store_split, duplicating the barrel shifter. The per-entry tail CAM-match -> wakeup_data mux -> 64-bit adder -> 128-bit barrel shifter is in series, once per registered input, all in one always_comb. | high | -1 | format_store_split is a pure combinational task writing the entry array once per cycle; there is no intermediate register in the cone for ABC to retime, so the barrel shift + AGU add stay one stage. A barrel shifter has no carry-save/DSP equivalent and generic ABC only restructures the mux tree, not shorten it across a register boundary. FB2b comments (line 850) already label format_store_split 'the store_data worst-path tail'. | `src/load_store_queue.sv:855-884 (CAM match + AGU add), :872-879 and :896-919 (format_store_split re-derive), :1263-1286 (format_store_split barrel-shift/mask definition)` |
| 2 | Leading-invalid head-skip priority encoder -> rotated 16:1 wide-struct mux (headq) feeding all per-op head decisions, rooted at high-fanout abort_mask | entries_q[*].entry.valid/.branch_mask + abort_mask broadcast -> headq -> load_writeback packet + head_delta + store-commit data-port outputs | sq_valid[i] = ((branch_mask & abort_mask)==0) && valid over all 16 entries (377-378); head_skip_n is a reverse-scan 16-way priority encoder over ROTATED indices sq_valid[head_q+k] (398-404); headq = entries_q[head_next_skip] is a 16:1 mux of the ~750-bit entry struct (414). headq feeds all six per-op head-decision blocks plus load formatting, and head_after_retire drives a SECOND rotated 16:1 struct read entries_q[head_after_retire] for the store-commit beat (975-1038). abort_mask is a high-fanout broadcast ((* max_fanout=64 *) upstream in riscv_core_ooo.sv) fanning into all 16 sq_valid compares here AND the 16-entry block-M squash-zero (938-942). | high | -1 | Architectural priority-select + wide-struct mux inside one always_comb from registered state to registered outputs; ABC can rebalance the priority tree but cannot pipeline it (no register in the cone) and cannot reduce the abort_mask broadcast fanout, which the tool must buffer/route. No arithmetic transform applies to a priority encoder or a ~750-bit struct mux. | `src/load_store_queue.sv:376-379 (sq_valid), :398-405 (priority head-skip), :414 (headq 16:1 struct mux), :975-1038 (head_after_retire second rotated read + store-commit), :938-942 (block-M abort_mask 16-entry squash)` |
| 3 | Single-core AMO read-modify-write cone: format_load -> amo_result (wide ALU/min-max) -> format_store_split (three serial variable-shift/wide-arith stages) | data_load (memsys load response) -> entries_q[head].store_data/.store_mask + load_writeback.data (via head_delta) | With COHERENT=0 the agent COP_AMO path const-folds out, so AMOs resolve in the LSQ load-complete branch (735-770): format_load(data_load) (64-bit variable right shift + 7-way sign/zero-extend mux, 1290-1304) -> amo_result (64-bit adder + XOR/AND/OR + two signed and two unsigned 64-bit magnitude comparators selected by a 9-way amo_op case, plus a word_op sign-extend pre-stage, 1328-1354) -> format_store_split (128-bit variable left shift, 1263-1286). Three serial variable-shift/wide-ALU stages in one combinational cycle off a single registered input. | medium | -1 | The whole RMW is one always_comb expression from a registered response to a registered store field with no intermediate flop, so ABC has no register to retime; the min/max magnitude comparators and the two barrel shifts are structurally deep and gain nothing from DSP or carry-save mapping. Only an added pipeline stage (arch change) shortens it. | `src/load_store_queue.sv:735-770 (AMO load-complete branch), :1290-1304 (format_load), :1328-1354 (amo_result add/logic/min-max), :1263-1286 (format_store_split)` |

**Cell-mapping findings**

| # | Issue | Category | Geometry/detail | Sev | Evidence | Recommendation |
|---|---|---|---|-----|---|---|
| 1 | niigo_memsys latency-fuzzer 5 LCG streams (each a 32-bit constant multiply s*1664525) plus the fz config initial blocks with $test$plusargs/$value$plusargs/$display are compiled into the synth/FPGA build with no `ifndef SYNTHESIS` guard. They should const-fold out (fz_en is initial-only, driven by $test$plusargs -> 0 at synth), but the guard makes elimination deterministic rather than DCE-dependent. | initial-block | 3 initial blocks (fz config via $test/$value$plusargs/$display, LCG seeding, stall-counter init) + 5x 32-bit LCG feedback regs updated by lcg_next = s*32'd1664525 + 32'd1013904223 (constant mult -> shift-add tree + 32-bit add) | low | `src/mem/niigo_memsys.sv:214-224 (fz config initial + $test/$value$plusargs/$display), :226-228 (lcg_next constant multiply), :234-240 (LCG seed initial), :263-270 (fuzz ready streams)` | Wrap the fuzzer (config initials, the 5 LCG streams, lcg_next/lcg_range, the ready/ack fuzz FSMs) in `ifndef SYNTHESIS`, or force `assign fz_en=1'b0;` under SYNTHESIS/FPGA_BUILD, so ABC never sees the $-tasks or the five 32-bit constant multipliers and they fold out deterministically instead of relying on frontend DCE of an initial-only fz_en. |
| 2 | 64-bit free-running cyc_q counter plus a 64-bit adder and 64-bit magnitude comparator are sim-latency-model machinery carried live into the FPGA build; in the active L1D device-bypass path they only reproduce a fixed D_RESP_DELAY that a small counter could do. This logic is NOT DCE'd (it drives the real dev_resp_valid/dev_pend_q device response path). | wide-arith | cyc_q = 64-bit up-counter (increments every cycle); dev_due_q = cyc_q + const (64-bit add); dev_resp_valid = (cyc_q >= dev_due_q) (64-bit unsigned compare), per device-bypass response | low | `src/mem/niigo_memsys.sv:248-252 (64-bit cyc_q counter), :511 (cyc_q>=dev_due_q compare), :521-522 (dev_due_q 64-bit add)` | Under FPGA_BUILD replace the cyc_q/due-time scheme with a small fixed-latency down-counter (or 1-cycle device response), removing the 64-bit counter + 64-bit adder + 64-bit comparator from the synth netlist; it is pure sim-timing modelling that costs real flops and a wide comparator on the live device path. |
| 3 | LSQ entries_q is the largest flop bank in this scope and is correctly a register array, NOT a missed SRAM target. Flag so the ASAP7 flow (no SRAM-macro step) neither tries to macro-map it nor mis-attributes its area/read-mux depth to a 'missing SRAM'. | inferred-memory | 16 entries deep x ~750-bit packed mem_entry_t (~12 Kbit at RV64); fully async (combinational) read from many contexts in one cycle (4 insert lanes, per-entry wakeup CAM, per-entry branch-abort squash, head_delta head write, store-commit read) with an associative wakeup/snoop match on EVERY entry | low | `src/load_store_queue.sv:98-128 (mem_entry_t), :171-186 (entries_q/entries_wake/entries_premerge arrays), :845-920 (block-W associative wakeup), :1119-1138 (multi-lane insert)` | Keep entries_q as flops: the per-entry associative wakeup match + per-entry squash preclude any single/dual-port SRAM macro. Do NOT attempt SRAM mapping; budget it as ~12 Kbit of flops and focus reduction on the update logic (block-W barrel shifters) and the head-select mux, not on memory-macro substitution. |

### L1 caches (l1_dcache / l1_icache + shared l1_tag_array / l1_data_array / l1_plru), RV64G+Sv39 FPGA_BUILD synth config

**Timing findings**

| # | Finding | Endpoints | Root cause | Sev | Fmax | Why ABC won't fix | Evidence |
|---|---|---|---|-----|---|---|---|
| 1 | L1D load-hit resolve cone: 4-way 52-bit PA tag compare -> way-select -> word-select mux to resp_data | l1_tag_array/l1_data_array sync-read output regs (tag_rdata/dat_rdata) + valid_q[] flops -> combinational hit_oh/any_hit/hit_way -> 512b way mux -> 64b word mux -> resp_data output pin (captured in the LSQ load-response stage) | In the single S_LOOKUP cycle: (a) four parallel L1_TAG_BITS-wide equality compares tag_rdata[w]==op_tag; at RV64/Sv39 L1_TAG_BITS = MEMORY_ADDR_WIDTH(61) - INDEX(6) - WORD(3) = 52 bits (only 20 at RV32); (b) an async 64:1 mux valid_q[op_idx] qualifying each compare; (c) a priority encode to hit_way; (d) a 4:1 512-bit way mux dat_rdata[hit_way]; (e) an 8:1 64-bit word mux [op_woff*XLEN+:XLEN]. The whole compare+2-level-select chain is combinational between the registered array read and the module output. | medium | -1 | The tag/data array reads are a hard registered boundary on the input and resp_data is a module output, so ABC cannot retime the compare+select into an adjacent cycle; generic mapping cannot restructure a 4-way set-associative lookup (associative compare + way-then-word select is architectural). The 52-bit comparator width is fixed by RV64 address geometry, not by mapping. | `src/mem/l1_dcache.sv:162-168 (hit_oh/any_hit/hit_way), src/mem/l1_dcache.sv:230-233 (resp_data way+word mux), src/mem/niigo_mem.vh:41 (L1_TAG_BITS = MEMORY_ADDR_WIDTH - L1_INDEX_BITS - LINE_WORD_BITS)` |
| 2 | L1I fetch-group extraction: 4-way 52-bit tag compare -> 512-bit way mux -> 4x variable word-select barrel extract | l1_tag_array/l1_data_array sync-read regs (tag_rdata/dat_rdata) + valid_q[] flops -> any_hit/hit_way -> sel_line 512b way mux -> per-lane wsel word select -> ifetch_resp_data[MEMORY_READ_WIDTH] output pins | Same 4x 52-bit associative tag compare and 64:1 valid_q[p_idx] qualification as the L1D, feeding hit_way, then sel_line = dat_rdata[hit_way] (4:1 512-bit way mux), then a MEMORY_READ_WIDTH-wide replicated variable word extraction: for each lane j, wsel = p_loff + LINE_WORD_BITS'(j) (a 3-bit add) selects an 8:1 64-bit slice sel_line[wsel*XLEN+:XLEN]. That is MEMORY_READ_WIDTH parallel barrel-style 8:1 muxes off the 512-bit line, all combinational after the registered array read. | medium | -1 | tag_rdata/dat_rdata are registered array outputs and ifetch_resp_data is a module output, so the compare + way mux + per-lane word barrel cannot be retimed away; no arch change is available to generic ABC. Width (52-bit tag, 512-bit line, MEMORY_READ_WIDTH lanes) is set by RV64 geometry + MEMORY_READ_WIDTH. | `src/mem/l1_icache.sv:149-158 (any_hit/hit_way), src/mem/l1_icache.sv:163-171 (sel_line + per-lane wsel word extract), src/mem/niigo_mem.vh:41 (L1_TAG_BITS)` |
| 3 | Flop-inferred array read is a 64:1 wide registered mux (no SRAM macro to absorb it) | l1_data_array mem[] / l1_tag_array tags[] storage flops -> 64:1 select by ridx -> rdata/rtag read register (registered->registered, one cycle apart) | Because OpenROAD integrated-syn has no SRAM-macro step, mem[SETS]/tags[SETS] become flip-flop arrays and the sync read rdata[w] <= mem[ridx] becomes a full L1_SETS(64):1 mux -- 512 bits wide per way for data (x4 ways) and 52 bits wide per way for tag (x4 ways, x2 read ports in the L1I because ren2/snoop is active). This registered->registered array-access mux (log2(64)=6 mux levels x wide datapath) is instantiated for every cache access and is the physical form the array read takes once macros are absent. | medium | -1 | ABC cannot infer/instantiate an SRAM macro to collapse the addressed read into a bitline access; it can only build a discrete mux tree over the storage flops. Both ends are registers one cycle apart by construction so no retiming helps. Fix requires a memory-compiler / macro step outside ABC. | `src/mem/l1_data_array.sv:36-50 (per-way mem decl + sync read), src/mem/l1_tag_array.sv:41-55 (per-way tags + two sync-read ports)` |

**Cell-mapping findings**

| # | Issue | Category | Geometry/detail | Sev | Evidence | Recommendation |
|---|---|---|---|-----|---|---|
| 1 | l1_data_array infers as a large flip-flop array (no SRAM-macro step) -- the #1 area sink and the source of the array read/write mux logic | inferred-memory | Per instance: WAYS(4) x SETS(64) x LINE_BITS(512) = 131,072 bits; L1I + L1D together = 262,144 bits (~256 Kbit). Ports: 1 sync-read (registered, returns ALL 4 ways in parallel -> 2048-bit read register) + 1 byte-masked write (one way per access, LINE_BITS/8 = 64 byte-write enables). Sync read. | high | `src/mem/l1_data_array.sv:36-50 (generate per-way mem decl :38, sync read :39-41, per-byte masked write :42-48), src/mem/niigo_mem.vh:27-28,37-38` | Provide an ASAP7-compatible SRAM macro (OpenRAM or foundry compiler) and blackbox it in synthesis: e.g. 4x single-bank 64x512 1RW with native byte-write-mask (or fold ways into one 64x2048 with a way-select), instantiated behind this module's interface. Absent a macro step this array alone is ~131K flops/instance and dominates cell area + adds the 64:1x512 read mux and 64-lane write-enable decode -- it should be the first block pointed at a memory compiler. |
| 2 | l1_tag_array infers as flops with duplicate-tags read-port replication; RV64/Sv39 pushes the tag to 52 bits, driving the 4-way compare cone | inferred-memory | Per instance: WAYS(4) x SETS(64) x TAG_BITS = 13,312 bits at TAG_BITS=52 (RV64: MEMORY_ADDR_WIDTH 61 - INDEX 6 - WORD 3; only 20 bits at RV32). L1I activates the 2nd read port (ren2, snoop) -> per-way replication ~2x (~26.6 Kbit); L1D ties ren2=0 so the replica optimizes away. Ports: 1-2 sync-read + 1 write. | medium | `src/mem/l1_tag_array.sv:41-55 (per-way tags, two sync-read ports :45-50, write :51-53), src/mem/niigo_mem.vh:41 (L1_TAG_BITS = MEMORY_ADDR_WIDTH - L1_INDEX_BITS - LINE_WORD_BITS)` | 13 Kbit is tolerable as flops, but (a) recognize the 52-bit RV64 tag as the width driver of the 4x tag comparators in the L1I/L1D hit cones, and (b) since the C4b snoop is intentionally off the fetch critical cycle, consider not replicating a 2nd physical read port (time-share the single read port or a tiny 2R1W RF macro) to avoid doubling the L1I tag flops. If a small dual-read SRAM/RF macro is available in ASAP7, map it; otherwise keep as flops. |
| 3 | valid/dirty/PLRU are flop arrays with async index read and single-cycle flash-clear -- correctly NOT SRAM, but the 64:1 async read sits in the hit/PLRU cone | inferred-memory | Per cache: valid_q [L1_SETS(64)] x [L1_WAYS(4)], dirty_q 64x4 (L1D only), plru_q 64x3. Read: ASYNC by op_idx/p_idx (a 64:1 mux over the flop array) feeding hit-detect and the PLRU victim; Write: single-cycle flash-clear of ALL 64 sets on fence.i/inval_all + per-access updates. | low | `src/mem/l1_dcache.sv:101-105 (decls), src/mem/l1_dcache.sv:460-479 (all-set valid/dirty next-state loop); src/mem/l1_icache.sv:85-88 (decls), src/mem/l1_icache.sv:321-336 (flash-invalidate all sets)` | Keep as flops -- the single-cycle all-set flash-clear (fence.i / halt flush) is exactly why these cannot live in the tag/data SRAM, so this is the correct structure. Only note the async 64:1 valid_q[idx] read as a contributor to the L1I/L1D hit cones. If area-pressed later, an epoch/valid-generation scheme would let valid move into the tag SRAM, but it is not required for correctness or for the FMA-bound critical path. |

### Privileged CSR / MMU / PMP subsystem (priv_csr_file.sv, trap_controller.sv, ptw.sv, mmu_tlb.sv, pmp_checker.sv) for niigo-lake single-core OoO, RV64G+Sv39, ASAP7 via OpenROAD integrated-syn (yosys-slang + generic ABC, no SRAM/DSP/retiming).

**Timing findings**

| # | Finding | Endpoints | Root cause | Sev | Fmax | Why ABC won't fix | Evidence |
|---|---|---|---|-----|---|---|---|
| 1 | PMP check: 16 parallel 54-bit TOR/NAPOT comparators feeding a serial lowest-matching-entry priority select, replicated 3x on the translate/fetch/PTW paths | post-DTLB resolved PA / fetched-word PA / PTE PA + pmpcfg[4]/pmpaddr[16] CSR flops -> fault -> access-fault gating (DataPMP on LSQ data path, FetchPMP on fetch path, PtwPMP on PTW address) | pmp_checker.always_comb evaluates all 16 entries: each does a 54-bit TOR pair-compare (addr_word>=lo && addr_word<hi) or a NAPOT a^(a+1) ignore-mask + 54-bit masked equality or NA4 equality (parallel), then a running 'matched' flag implements lowest-index-wins. This is a genuine priority-select over 16 wide comparators with no internal register, and the cone is instantiated 3x (PtwPMP/DataPMP/FetchPMP) in this single-core RV64+L1D+AXI build. The paddr it consumes is itself a late TLB-output mux, so PMP sits on the translate/fetch critical path. Above the 42 MHz FMA floor (mmu_tlb standalone 264.6 MHz, ptw 655.6 MHz), so it is not the core Fmax limiter, but it is the priv-mmu subsystem's own worst un-retimeable comb cone. | low | -1 | There is no internal register to retime; ABC can rebalance the priority-select boolean and the parallel comparators but cannot remove the lowest-index-wins serialization semantics or the 3x replication, and no DSP/macro implements a comparator-priority structure. Only an RTL change (register the paddr->PMP handoff, or compute one shared PMP result and route it) shortens it. | `src/pmp_checker.sv:65-119 (16-entry loop + serial 'matched' priority), 48-59 (napot_match a^(a+1) + 54-bit masked compare), 81-90 (54-bit TOR/NA4 comparators), 92-110 (lowest-match select), 38-41 (PMP_AW=54 at RV64)` |

**Cell-mapping findings**

| # | Issue | Category | Geometry/detail | Sev | Evidence | Recommendation |
|---|---|---|---|-----|---|---|
| 1 | mmu_tlb is a 16-entry fully-associative flop CAM with an asynchronous associative read; with no SRAM-mapping step it correctly becomes flops + 16-way comparators, and it is instantiated twice (ITLB + DTLB). | inferred-memory | 16 entries x {1b valid + VM_VPN_W(27b) vpn + VM_ASID_W asid + VM_PPN_W(44b) ppn + 8b perm + 2b level} ~= 1.6 Kbit/instance; 1 synchronous write port, 1 fully-associative ASYNCHRONOUS read port; x2 instances (ITLB+DTLB) ~= 3.1 Kbit total | low | `src/mmu_tlb.sv:49-55 (valid_q/vpn_q/asid_q/ppn_q/perm_q/level_q unpacked arrays), 58-78 (vpn_match per-bit compare + match[] associative compute), 80-95 (async first-match ENTRIES:1 mux of ppn/perm/level), 97-112 (single synchronous round-robin write via repl_q)` | Leave as standard-cell flop CAM: a 16-entry fully-associative single-cycle-async-lookup TLB is NOT an SRAM-macro candidate at any PDK (an SRAM cannot do the parallel VPN/level associative compare), so no macro-mapping action applies. Measured 264.6 MHz standalone, so timing is fine; if TLB area/compare depth becomes a concern that is an RTL/arch change (fewer ENTRIES or a set-associative sync-read TLB). |
| 2 | priv_csr_file holds the PMP config/address CSRs as async-read register arrays copied every cycle in an always_comb onto packed output ports that drive the three pmp_checker instances -- architectural CSR flops (correctly not SRAM), but the source of the 3x PMP compare-cone replication. | inferred-memory | pmpaddr_q[16] x MXLEN(64b) = 1024b + pmpcfg_q[4] x 32b = 128b = ~1.15 Kbit of SW-visible CSR flops, async random read, fanned combinationally (fanout ~3, one per PtwPMP/DataPMP/FetchPMP checker) | low | `src/priv_csr_file.sv:178-179 (pmpcfg_q[4]/pmpaddr_q[16] decls), 184-187 (always_comb copy to pmpcfg_o/pmpaddr_o), 176-177 (PMPADDR WARL mask)` | Keep as flops (architectural CSRs, not an SRAM target); there is no mapping-step remedy. The fanout itself is modest (~3), so the real cost is the triplicated PMP compare cone this feeds (see the PMP timing finding). To bound both, an RTL change -- register the pmpaddr/pmpcfg handoff or compute one shared PMP result and route it -- is the lever, not a cell-mapping action. |

### SoC device bus (CLINT/PLIC/UART) — src/clint.sv, src/plic.sv, src/uart.sv. Build: RV64G+Sv39, OOO_4WIDE + L1_CACHES + L1D_CACHE + AXI_MEMSYS + FPGA_BUILD + SYNTHESIS, single core (NUM_HARTS=1, NPORT=1, NCTX=2, NSOURCES=31, XLEN=64 so NSUB=2). ASAP7 integrated-syn (yosys-slang + generic ABC, no SRAM/DSP/retiming).

**Timing findings**

| # | Finding | Endpoints | Root cause | Sev | Fmax | Why ABC won't fix | Evidence |
|---|---|---|---|-----|---|---|---|
| 1 | PLIC highest-priority-source argmax (3 serially-dependent priority-bit narrowing passes + 31-way lowest-id encoder) feeds the LSQ device-read data path — deepest cone in the device block, non-binding | prio_q/enable_q/thresh_q/inflight_q/sw_pend_q registers (+ src_irq input) -> best_pri[c]/best_id[c] -> reg_read(claim)/claim-arbiter -> load_data output -> LSQ device-read capture reg (also -> irq_m/s_external -> trap logic) | Associative select-highest-priority over 31 sources. elig[s] first does 31 parallel 3-bit (prio_q[s] > thresh_q[c]) compares ANDed with gw_pending & enable (plic.sv:127-130). Max priority is found by three SEQUENTIALLY-dependent priority-bit passes b=2->1->0 (plic.sv:132-143): each pass is a 31-input OR-reduction followed by a 31-wide 'alive' mask update the NEXT bit's pass consumes — a hard cross-bit serial chain. A 31-entry lowest-id-wins priority encoder then extracts best_id (plic.sv:146-148). best_id fans into the claim arbiter (plic.sv:233-238) and the RV64 device load_data for both bus subwords (plic.sv:203,262), i.e. the whole cone sits in the combinational reg->output device-read path. | low | -1 | Pure combinational reg->output cone with no register boundary inside PLIC, so generic ABC has nothing to retime. ABC can balance each 31-input OR-reduction but cannot remove the architecturally-serial dependency where each priority-bit pass's 'alive' update feeds the next bit, nor collapse the 31-way lowest-id priority encoder — reducing depth further needs an architectural rewrite (parallel comparator/max-tree) or an added pipeline stage. Already mitigated from the old serial running-max scan to this parallel-argmax form (comment 112-119); it is ~log-depth and sits well above the 41.7 MHz CVFPU-FMA floor, so worst-in-block, NOT binding. | `src/plic.sv:120-150 (argmax), src/plic.sv:112-119 (comment: LSQ device-read worst-path cone / former post-R2' #1..#25 bottleneck), src/plic.sv:203,233-238,262 (fan-out into claim + load_data)` |

**Cell-mapping findings**

| # | Issue | Category | Geometry/detail | Sev | Evidence | Recommendation |
|---|---|---|---|-----|---|---|
| 1 | PLIC and CLINT state arrays infer flip-flop register files under integrated-syn (no SRAM-macro step) — CORRECT here: they are tiny and read fully-parallel/associatively every cycle, unlike the L1 data / ITTAGE / TAGE flop-arrays that are the real SRAM problem | inferred-memory | PLIC: prio_q 32x3b (combinational store-snoop write, read 32-wide in parallel by the argmax + a 32:1 read mux), sw_pend_q 32x1b, inflight_q 32x1b, enable_q 2x32b, thresh_q 2x3b — ~230 bits total, all read associatively with combinational read. CLINT: mtime_q 64b, mtimecmp_q 1x64b, msip_q 1x1b — combinational read plus a 64b compare/increment. | low | `src/plic.sv:94-98 (state decls), src/clint.sv:69-71 (state decls); read use at src/plic.sv:127-148 and src/clint.sv:107-115` | Keep these as standard-cell flops + read muxes; do NOT force SRAM-macro mapping. Every entry is read in parallel each cycle (the priority argmax touches all 31 sources) and written by a combinational store-snoop, which a 1-2-port synchronous SRAM cannot serve. Area is negligible (~hundreds of bits), so flop mapping is fine — the ASAP7 SRAM effort belongs on the L1 data (~262 Kbit) / ITTAGE (~306 Kbit) / phys_reg_file arrays, not here. |
| 2 | CLINT mtimecmp_q async-resets to all-ones ({64{1'b1}}), i.e. requires async-set (preset) flops; otherwise reset/clock style across all three files is clean single-clock async-active-low | reset-clock | 64-bit register (per hart) with async-active-low reset that LOADS all-ones (a set, not a clear); single clock domain (clk); reset = negedge rst_l throughout (clint.sv:142, plic.sv:270, uart.sv:117). | low | `src/clint.sv:146 (mtimecmp_q[h] <= {64{1'b1}}); reset headers src/clint.sv:142-148, src/plic.sv:270-280, src/uart.sv:117-121` | Ensure the ASAP7 target .lib exposes async-set / async-reset DFF variants so OpenROAD/ABC can map the all-ones reset to set-flops (or reset-flops with an inverted Q). No RTL change needed. UART (src/uart.sv) is otherwise clean for cell-mapping: only 8-bit architectural regs and small unique-case read muxes (read_reg), no inferred RAM, no latches; all sim-only constructs ($write/$fflush, string rx_str/$value$plusargs) are correctly excluded from synth via `ifndef SYNTHESIS (uart.sv:103-106,125-128,161-164) — no initial blocks, no vendor/Xilinx primitives, no tri-state/multi-driver in any of the three files. |

### riscv_core_ooo (OoO single-core datapath top): cross-module combinational paths, TLB+PMP translate cones, and squash/redirect broadcasts. Build: RV64 + OOO_4WIDE + L1_CACHES + L1D_CACHE + AXI_MEMSYS + FPGA_BUILD + SYNTHESIS, single core.

**Timing findings**

| # | Finding | Endpoints | Root cause | Sev | Fmax | Why ABC won't fix | Evidence |
|---|---|---|---|-----|---|---|---|
| 1 | abort_mask / abort_mask_q branch-squash broadcast: single-source high-fanout net to every speculative structure | branch_writeback (FU/branch resolve) -> ooo_branch_recovery (comb abort_mask) -> IQ / LSQ / ROB(active_list) / branch_stack / MUL / DIV / FP / ALU-S2 gate / spec_wake; abort_mask_q -> writeback_bus | abort_mask is produced combinationally by ooo_branch_recovery (:1506-1519) from the resolved branch_writeback, then consumed as a squash gate by ~10 modules across the die (active_list, int_issue_queue, ALU-S2 issue register, spec_wake, mul, div, fp, LSQ, writeback_bus). It is only a 4-bit mask (branch_mask_t) but with very high load count; the documented routed OOC worst path was abort_mask_q -> DivUnit at ~39 ns route. | high | 199.8 | This is a fanout/placement problem, not logic depth: the fix is driver replication + buffer insertion, a physical (place/route) transform. Generic ABC technology-map does not replicate high-fanout drivers, and the (* max_fanout = 64 *) attribute at :445-446 is a Vivado directive that yosys-slang/ABC ignore, so the squash net stays one global driver until OpenROAD repair_design fixes fanout. DivUnit logic is 199.8 MHz standalone; the broadcast route binds. | `src/riscv_core_ooo.sv:438-446 (max_fanout decl + FB2b comment), :1506-1519 (ooo_branch_recovery produces abort_mask), :1440-1441/:1483 (LSQ/writeback_bus consumers)` |
| 2 | DTLB associative lookup chained into DataPMP 16-region priority match (data head-translate cone) | LSQ head-VA (mem_req_vaddr) -> DTLB(mmu_tlb) CAM -> make_pa mux -> DataPMP(pmp_checker) -> lsq_xlate_fault/data_pa -> LSQ 2nd-stage translate reg | mem_req_vaddr drives the 16-entry DTLB associative lookup (mmu_tlb, :1017-1029), whose comb hit/ppn/perm/level feed dtlb_usable (:899), the make_pa superpage mux (:1045-1050), then the DataPMP pmp_checker (:1061-1068), a 16-region XLEN-wide address-range decode with first-match priority encode. pmp_data_fault -> lsq_xlate_fault (:1069-1071) and data_pa close back into the LSQ. Serial CAM-compare -> mux -> priority-match chain spanning three modules in one cycle; the FB2b registered head-translate splits only the LSQ side, not the compare/decode cone. | medium | 264.6 | Generic ABC cannot retime across the LSQ->mmu_tlb->pmp_checker module boundaries and cannot restructure an associative 16-way tag compare or a PMP first-match priority chain into a balanced tree; the CAM+priority structure is architecturally fixed. mmu_tlb alone is 264.6 MHz (upper bound); the chained PMP decode pushes below that (still well above the 42 MHz binding FMA, hence medium). | `src/riscv_core_ooo.sv:1017-1029 (DTLB inst), :899 (dtlb_usable), :1045-1050 (data_pa make_pa mux), :1061-1071 (DataPMP + lsq_xlate_fault)` |
| 3 | ITLB lookup chained into FOUR parallel FetchPMP priority matches (per-lane fetch-translate cone) | pc_q -> ITLB(mmu_tlb) CAM -> fetch_pa make_pa mux -> +4*lane adder -> 4x FetchPMP(pmp_checker) -> pmp_fetch_fault_lane -> fetch_fault_lane/fetch_fault | pc_q feeds the 16-entry ITLB lookup (:1001-1015), then itlb_usable/make_pa resolve fetch_pa (:1102-1107), then a generate loop instantiates FOUR pmp_checker instances (paddr = fetch_pa + fpl*4, :1138-1147). Outputs are per-lane in-block gated and OR-reduced into fetch_fault_lane/fetch_fault (:1159-1167). Each FetchPMP is an independent 16-region XLEN-wide decode + priority encode; the ITLB compare and PMP decode are chained; 6 pmp_checker instances total exist in this module (4x FetchPMP + DataPMP + PtwPMP). | medium | 264.6 | Same structural class as the data path: ABC cannot retime across mmu_tlb->pmp_checker or collapse associative-compare-then-priority-match; the 4-way FetchPMP replication is architectural (one PMP check per fetched word). mmu_tlb=264.6 MHz is an upper bound; the ITLB+PMP+reduce chain is slower but remains far above the binding FMA (medium). | `src/riscv_core_ooo.sv:1001-1015 (ITLB inst), :1102-1107 (fetch_pa), :1138-1147 (4x FetchPMP gen), :1159-1170 (fetch_fault_lane collapse/cause)` |
| 4 | Commit-trap detection -> trap_controller delegation -> pc_next redirect + full-pipeline flush broadcast | active_commit_packet (2-stage ROB read) -> B4 4-lane chained priority case-decode -> commit_exc_valid/commit_take_trap -> trap_controller (comb delegation) -> tc_vector/trap_redirect_pc -> pc_next; trap_take -> flush fanout + 32-entry rename-map/free-list restore mux | B4 (:1944-2047) walks OOO_WIDTH lanes in a serial priority chain (each guarded by !commit_exc_valid && !commit_take_ret) doing a full unique-case decode of MRET/SRET/ECALL/EBREAK/WFI/SFENCE plus per-mode legality checks. commit_take_trap feeds the purely combinational trap_controller (:643-659) doing medeleg/mideleg delegation + vector select, producing tc_vector -> trap_redirect_pc -> pc_next (:2361-2366). In parallel trap_take (:2061) broadcasts a flush to every speculative module and drives the 32-wide map/free restore muxes into rename_map_table/free_list. One combinational cone from ROB read to frontend redirect + die-wide flush. | medium | -1 | The cross-lane exception-priority chain and trap delegation are inherently serial (a younger-lane trap must observe older-lane results), and ABC cannot retime across the active_list -> commit-decode -> trap_controller -> priv_csr_file/frontend boundaries. The wide flush/restore fanout is again a physical broadcast, not a logic-map transform. | `src/riscv_core_ooo.sv:1944-2047 (B4 trap decode), :643-659 (trap_controller), :2061-2085 (trap_take + restore muxes), :2361-2366 (trap_redirect_pc->pc_next)` |

**Cell-mapping findings**

| # | Issue | Category | Geometry/detail | Sev | Evidence | Recommendation |
|---|---|---|---|-----|---|---|
| 1 | Architectural FP register file (fp_regs_q) is inferred as a flat flop array with a wide multi-ported async-read cone; no SRAM-macro step maps it, so it stays flops with a 12-port read mux read every dispatch cycle. | inferred-memory | 32 entries x fp_reg_data_t(64b) = 2048 bits; 12 ASYNC read ports (3 FP sources x 4 dispatch lanes, read at RENAME) + up to 4 write ports at commit; combinational (async) read | medium | `src/riscv_core_ooo.sv:412-413 (fp_regs_q/fp_regs_next decl), :1871-1874 (fp_src1/2/3_data = fp_regs_q[...] x4 lanes = 12 async reads), :2295-2298 (write at retire)` | ASAP7 integrated-syn has no SRAM-macro mapping and a 32x64 12R4W array is small enough to legitimately stay flops, but the 12-way async-read 32:1 mux is a real area+delay cost. Prefer reading FP sources at ISSUE (like the int phys regfile) rather than broadcasting all 3 sources x4 lanes at rename, or bank the array; either shrinks the async-read cone. If kept, ensure it maps to a compiled register-file cell rather than random flops+muxes. |
| 2 | Return-address stack (ras_stack_q) is a deep flop array copied wholesale every cycle with indexed combinational read/write; 128-deep is unusually large and infers ~8 Kbit of flops plus 128:1 read muxes. | inferred-memory | RAS_DEPTH=128 entries x XLEN(64b) = 8192 bits; ras_stack_next = ras_stack_q full copy each cycle (:1734) + per-lane indexed push write and indexed return-target read (128:1 async mux) | medium | `src/riscv_core_ooo.sv:134 (RAS_DEPTH=128), :243-244 (ras_stack_q/next decl), :1734 (full-array copy), :1758-1772 (per-lane indexed write on call / indexed read on return)` | 128 entries is far deeper than needed for a RAS; reduce RAS_DEPTH to 16-32 to cut the flop count ~4-8x and shrink the indexed read mux. With no SRAM macro it remains flops, so depth reduction is the direct area/timing lever; alternatively implement as a small dedicated 1W1R register-file rather than a fully-rewritten packed array. |
| 3 | (* max_fanout = 64 *) on the abort_mask/abort_mask_q squash nets is a Vivado-oriented directive that yosys-slang + generic ABC do not honor, so in the ASAP7 flow the high-fanout squash net is NOT replicated at map time. | xilinx-attr | branch_mask_t = 4-bit net, fanned to ~10 modules (IQ/LSQ/ROB/branch_stack/MUL/DIV/FP/ALU-S2/spec_wake/writeback_bus) -> very high load count per bit | medium | `src/riscv_core_ooo.sv:438-446 (max_fanout attr + comment stating it is a Vivado Quick-place directive; 'Verilator ignores it')` | Do not rely on this attribute in the OpenROAD/ASAP7 path; it is inert through yosys/ABC. Handle the abort_mask fanout with OpenROAD repair_design -max_fanout (buffer insertion / driver cloning) after tech-map, and/or manually pre-replicate abort_mask into per-consumer copies in RTL so the mapped netlist starts with distributed drivers rather than one global net. |
| 4 | Six pmp_checker instances (4x FetchPMP + DataPMP + PtwPMP) each replicate a 16-region XLEN-wide address-range decode + priority encode; as combinational cells this is a large duplicated wide-comparator area block with no SRAM/DSP mapping available. | wide-arith | 6 instances x 16 PMP entries x XLEN(64b) address-range (NAPOT/TOR) comparators + first-match priority encode; 4 of them (FetchPMP) are per-fetch-lane replicas | low | `src/riscv_core_ooo.sv:992-999 (PtwPMP), :1061-1068 (DataPMP), :1138-1147 (4x FetchPMP generate)` | The 4-way FetchPMP replication is the main duplication cost (page-granular exec permission is identical across the 16-byte block; only the region match differs per word). Consider computing one PMP region-match per fetch group and deriving per-word faults from cheap offset logic, or sharing a single region-decode with 4 lightweight range selects, to cut ~3 PMP decoders. No DSP/macro lever exists in ASAP7; this is pure comparator area/delta-delay reduction. |

### Cross-cutting ASAP7 cell-mapping + STA sweep of the single-core niigo-lake OoO core (RV64 + OOO_4WIDE + L1_CACHES + L1D_CACHE + AXI_MEMSYS + FPGA_BUILD + SYNTHESIS): whole src/ tree incl. src/mem and src/cvfpu; CCD/L2 excluded (param/ifdef-gated off in this build).

**Timing findings**

| # | Finding | Endpoints | Root cause | Sev | Fmax | Why ABC won't fix | Evidence |
|---|---|---|---|-----|---|---|---|
| 1 | CVFPU FMA mantissa multiply is one monolithic combinational '*' (BINDING block) - no DSP, no retiming to split it | operand pipe reg (mantissa_a/mantissa_b) -> product/sum pipe reg inside fpnew_fma_multi ADDMUL stage; feeds niigo_fp_unit result buffer | src/cvfpu/src/fpnew_fma_multi.sv:467 `assign product = mantissa_a * mantissa_b;` is a single 53x53->106-bit unsigned multiply (PRECISION_BITS=53 for FP64). niigo_fp_unit sets ADDMUL PipeRegs=2 / DISTRIBUTED (src/niigo_fp_unit.sv:44,52), but DISTRIBUTED only inserts registers BETWEEN dataflow modules - it does NOT partition the '*' operator, so the 106-bit product plus the product_shifted+addend sum stay one combinational cone. | high | 41.7 | Generic ABC maps '*' to a ripple/array multiplier (~106 logic levels for FP64) with no DSP hard-macro and no register retiming, so it cannot fold the existing pipe flops into the multiply array. Only an RTL change (Booth+CSA tree with an operator-internal pipeline cut) or a retiming-capable flow breaks it - out of scope for the generic map. | `src/cvfpu/src/fpnew_fma_multi.sv:458,467,469 (2p-bit product = mantissa_a*mantissa_b, product_shifted); src/niigo_fp_unit.sv:44-52 (PipeRegs=2, DISTRIBUTED)` |
| 2 | ooo_mul_unit 64x64 product is a single combinational '*' confined to stage 1 - loses DSP48 cascade + retiming | s0_lhs_mag_q / s0_rhs_mag_q (stage-0 magnitude regs) -> s1_prod_mag_q (stage-1 product reg) | src/ooo_mul_unit.sv:94-95 `s1_prod_mag_q <= {64'b0,s0_lhs_mag_q} * {64'b0,s0_rhs_mag_q};` is a 64x64->128-bit multiply as one operator. MUL_LATENCY=3 but the pipeline only brackets it (S0 capture, S1 multiply, S2 sign/width-select) - the multiply is not staged internally. The in-source comment even assumes 'Vivado infers a pipelined DSP cascade' (src/ooo_mul_unit.sv:91), which does not hold on ASAP7/ABC. | high | 103.6 | No DSP hard blocks and no register retiming in the generic ABC map, so the 128-level array multiply cannot be pipelined or mapped to a DSP cascade; the surrounding stage flops stay outside the operator. Needs an operator-internal RTL pipeline (partial-product tree split across S0->S1->S2). | `src/ooo_mul_unit.sv:30 (MUL_LATENCY=3), :91 (DSP-cascade assumption comment), :94-95 (the 64x64 '*'); result select :160-168 (mul_select)` |
| 3 | TAGE + ITTAGE predictor tables are read ASYNCHRONOUSLY from large flop arrays at a variable hashed index (per-bank 1024:1 mux + hit-compare + provider select + target mux, all combinational in one cycle) | registered history_q / lookup_pc -> hashed idx[0..2] -> async flop-array read -> tag-compare/provider-select -> prediction_info / redirect-target register | Tables are per-bank 1D arrays (src/tage_sc_l_predictor.sv:39-49, src/ittage_predictor.sv:34-47) read inside always_comb at a data-dependent index (tage:108-130, ittage:80-102). Despite the RAM-intent comments, there is NO read-address register, so with no SRAM-macro step each `tage_target_k[idx[k]]` is a 1024:1 combinational mux (ITTAGE muxes 64-bit targets x3 banks); the bank muxes feed parallel tag==tag compares, the provider priority select, and a final 64-bit target mux - one combinational chain from index hash to predicted PC. | medium | -1 | ABC cannot turn an async-read flop array into a registered sync-read SRAM - that is an RTL/architecture change (register the hashed index into a pipe stage, or map to a real SRAM). The generic map is stuck implementing 1024:1 select muxes over flops and cannot retime across the always_comb read. (Severity medium not high: the standalone 1.3 MHz number is a false-comb artifact - not quoted - and the whole-core path here is unmeasured/pipelineable, not the binding block.) | `src/ittage_predictor.sv:24 (ENTRIES=1024), :34-47 (arrays), :80-102 (async hit/provider/target select); src/tage_sc_l_predictor.sv:26-27 (ENTRIES), :39-49 (arrays), :108-130 (async reads + provider case), :138-144 (SC override chain)` |
| 4 | phys_reg_file: 8 async read ports + 4-way writeback bypass form one combinational cone feeding every execute unit | issue-queue rs1[0..3]/rs2[0..3] phys tags -> combinational RF read + 4-write-port bypass mux -> ALUx2/AGU/mul/div/FP operand inputs | src/phys_reg_file.sv:26 `logic [PHYS_REGS-1:0][XLEN-1:0] registers` (64x64) is read in always_comb (:28-43) with READ_PORTS=OOO_WIDTH=4 -> 8 async 64:1 read muxes (rs1x4+rs2x4), and each read is compared against all 4 write_prd and bypassed (write_valid[w] && write_prd[w]==rs*[i]) in the SAME always_comb. With no SRAM step the RF is flops, so the operand read that fans into every functional unit is a 64:1 mux plus a 4-entry associative bypass, all combinational, on the read->execute path. | medium | -1 | A true 8R4W async-read register file cannot be mapped to a 1-2 port synchronous SRAM; ABC must build the mux+bypass in std cells. Only RTL restructuring (banked/replicated RF, or a registered read stage that moves the WB bypass off the read-to-execute path) shrinks the cone - the generic map cannot. | `src/phys_reg_file.sv:12 (READ_PORTS=OOO_WIDTH), :17-23 (read ports), :26 (flat 64x64 array), :28-43 (async read + 4-way WB bypass in one always_comb)` |

**Cell-mapping findings**

| # | Issue | Category | Geometry/detail | Sev | Evidence | Recommendation |
|---|---|---|---|-----|---|---|
| 1 | L1 data arrays become ~262 Kbit of flip-flops (no SRAM-macro mapping step) - the single largest area item and the #1 cell-mapping problem | inferred-memory | per instance: 4 ways x 64 sets x 512b = 131072 bit; SYNC read (registered rdata), 1 read port (all 4 ways) + 1 byte-masked write port per way; instantiated TWICE (L1I + L1D) = 262144 bit total. Reset-free (RAM-style always_ff @posedge clk, no reset). | high | `src/mem/l1_data_array.sv:38 (mem[SETS] per way), :39-48 (sync read + masked write, no reset); instantiated src/mem/l1_icache.sv:79, src/mem/l1_dcache.sv:95` | RTL is already textbook-SRAM-shaped (single sync read, single write, per-way single-port). Add an SRAM-macro mapping step: map each way to an ASAP7 1RW compiled SRAM (OpenRAM) and blackbox before ABC. Left as flops it is ~262K FF (dominant area) AND slows the read-way mux. |
| 2 | ITTAGE predictor tables become ~306 Kbit of flops with ASYNC read - #1 predictor area and a real timing item (see async-read timing finding) | inferred-memory | ENTRIES=1<<INDEX_BITS=1024. base_target 1024x64 + 3x tage_target 1024x64 (=196608) + base_valid 1024x1 + 3x confidence 1024x2 + 3x useful 1024x2 + 3x tag 1024x10 ~= 306176 bit. ASYNC read (always_comb) at a variable hashed index; single write port per bank. | high | `src/ittage_predictor.sv:24 (ENTRIES), :34-47 (target/tag/counter arrays), :80-102 (async read + select)` | Shrink INDEX_BITS or convert to SYNC read: register the hashed index into a pipe stage, do tag-compare/provider-select the next cycle, then the tables map to ASAP7 SRAM and the async 1024:1 mux disappears. As-is -> ~300K FF plus the async mux cone. |
| 3 | TAGE-SC-L tables become ~46 Kbit of flops with ASYNC read (same class as ITTAGE) | inferred-memory | ENTRIES=1024, SC_ENTRIES=256. base_table 1024x2 + 3x counter 1024x2 + 3x useful 1024x2 + 3x tag 1024x10 + sc_bias 256x6 ~= 46592 bit. ASYNC read at variable hashed index. | medium | `src/tage_sc_l_predictor.sv:26-27 (ENTRIES/SC_ENTRIES), :39-49 (arrays), :108-130 (async reads + provider case)` | Same as ITTAGE: register-read (sync) to enable SRAM mapping and cut the combinational 1024:1 select; or accept as flops (smaller than ITTAGE) but keep it off the frontend critical path via a read pipeline stage. |
| 4 | phys_reg_file is a multiport (8R4W) async-read register file -> stays flops, cannot be an SRAM macro; flag so the SRAM pass does NOT grab it | inferred-memory | 64 entries x 64b = 4096 bit; 8 async read ports (rs1x4 + rs2x4) + 4 write ports + 4-way write bypass in the read always_comb. | medium | `src/phys_reg_file.sv:26 (flat registers array), :28-43 (8-port async read + WB bypass), :45-57 (4-write-port clocked write)` | Correctly kept as flops (no SRAM supports 8R4W async), so this is an accepted flop RF, not an SRAM candidate - exclude it from the SRAM-mapping pass. For timing/area, consider banking/replicating read ports and moving the write bypass into a registered read stage. |
| 5 | L1 tag arrays become flops; the L1I copy is duplicated for the C4 snoop read port (ren2), doubling its FF count | inferred-memory | per way 64 sets x L1_TAG_BITS(=MEMORY_ADDR_WIDTH - L1_INDEX_BITS - LINE_WORD_BITS ~= 52) bit x 4 ways = 13312 bit; SYNC read. L1I uses ren2 (2nd read port -> tag mem replicated => ~26624 bit); L1D ties ren2=0 (single copy ~13312 bit). | medium | `src/mem/l1_tag_array.sv:44 (tags[SETS] per way), :45-53 (two sync read ports + write); L1I ren2 used src/mem/l1_icache.sv:76, L1D ren2 tied off src/mem/l1_dcache.sv:91-92; L1_TAG_BITS src/mem/niigo_mem.vh:41` | SRAM-shaped (sync 1W2R -> two 1RW copies). Map to small ASAP7 SRAM or keep as flops (small). The tag stores a full word-address field; confirm the high PA bits are actually needed for the 0x8000_0000 RAM window before paying the width. |
| 6 | Integer and FP multipliers lose DSP hard-macros AND register retiming under generic ABC (divider is fine - iterative) | multiplier | ooo_mul_unit 64x64->128 single '*'; CVFPU FMA 53x53->106 single '*'. ooo_div_unit is iterative radix-16 (small REM_W x 4-bit qdigit products only) and measured 199.8 MHz - OK. | high | `src/ooo_mul_unit.sv:94-95; src/cvfpu/src/fpnew_fma_multi.sv:467; src/ooo_div_unit.sv:34 (DIV_ITERS=XLEN/4), :140,:275 (small qdigit products)` | Cell-mapping lens on the two timing multiplier findings: for an ASAP7 flow with no DSP and no retiming, replace the two monolithic '*' with structural operator-internally-pipelined multipliers (Booth partial products + Wallace/Dadda CSA tree with pipe cuts at the existing stage boundaries), or enable a retiming-capable synth pass. Leave the divider iterative (already good). |
| 7 | Vendored clock-gating cell gated_clk_cell.v is a functional passthrough (clk_out = clk_in) - the ICG latch/gate is removed, so all CVFPU sequential elements free-run and the enable net is dead | vendor-cell | gated_clk_cell computes clk_en_bf_latch/SE then `assign clk_out = clk_in;` (no latch, no gate); clk_en_bf_latch is unused. Cell is in the synth file list. | medium | `src/cvfpu/vendor/opene906/E906_RTL_FACTORY/gen_rtl/clk/rtl/gated_clk_cell.v:37,47 (clk_en_bf_latch computed then clk_out=clk_in); listed src/verilator.mk:29` | Replace gated_clk_cell with an ASAP7 integrated clock-gating (ICG) cell if power gating is wanted, else accept higher dynamic power (all FP flops toggle every cycle). Functionally correct for sim; a power/area concern only for the ASIC flow. |
| 8 | Simulation-only initial block and live-but-dead perf-counter flop arrays sit in the synth path unguarded (rely on the frontend to drop them) | initial-block | initial begin wait(halted); $display(...) perf dump; perf counters perf_stall_instr[PERF_STALL_BUCKETS], perf_branch_instr_counter[16], perf_jal[8], perf_jalr[8] (64b each) - live flops feeding only $display. | low | `src/riscv_core_ooo.sv:2728-2745 (initial wait/$display), :2564-2567 (perf arrays); src/ooo_alu_pipe.sv:36-41 shows the good pattern (ecall_halt_en `ifndef SYNTHESIS`)` | Wrap the wait/$display initial in `ifndef SYNTHESIS`, and gate the perf-counter arrays under `ifndef SYNTHESIS` (or a PERF_COUNTERS define) so ABC never sees ~(buckets+40)x64 dead counter flops (they synthesize unless pruned as dangling). |
| 9 | Async active-low reset used core-wide with a single clock but NO reset-deassertion synchronizer | reset-clock | ~40 RTL files use `always_ff @(posedge clk or negedge rst_l)` (async assert). Single clock domain. Large arrays (L1 data/tag, TAGE/ITTAGE) correctly drop the array-wide reset under SYNTHESIS (power-up-to-0 assumption). | low | `src/phys_reg_file.sv:45 (posedge clk or negedge rst_l) representative; src/tage_sc_l_predictor.sv:33-38 (no reset under SYNTHESIS, power-up-0); no rst_sync/reset_sync anywhere in src/` | For ASAP7 tapeout add an async-assert / sync-deassert reset synchronizer (2-FF) on the single clock domain to avoid recovery/removal violations, and verify the reset-skipping flop arrays tolerate an X-then-warmup start (TAGE/ITTAGE self-correct; confirm L1 valid bits, which live in resettable flops, still clear). |

---

## Appendix B — Measured ASAP7 per-block Fmax (baseline)

RVT/TT std cells, pre-CTS placed parasitics, OpenROAD integrated-syn + generic ABC. Harness:
`fpga/openroad/timing_flow.tcl` + `char.sh` (per-module synth→place→STA), ORFS asap7 platform RC.

| Block | Fmax (MHz) | Trust |
|---|---:|---|
| niigo_fp_unit (CVFPU FMA) | 41.7 | **binding — real** |
| ooo_mul_unit | 103.6 | real |
| ooo_div_unit | 199.8 | real |
| branch_stack | 74.3 | real |
| free_list | 102.4 | real |
| mmu_tlb | 264.6 | real (translate UB) |
| ptw | 655.6 | real |
| rename_map_table | 2229.9 | real |
| busy_table | 3506.6 | real |
| int_issue_queue | 0.9 | artifact — false comb-loop |
| tage_sc_l_predictor | 1.3 | artifact |
| active_list | 2.5 | artifact |
| load_store_queue | 12.2 | artifact |
| ooo_alu_pipe / dispatch / commit / fetch_decode | 0 / FAIL | artifact |
| l1_dcache / l1_icache / ittage_predictor / niigo_memsys | — | TIMEOUT(2400s) |
| riscv_core_ooo (whole core) | — | scale wall: ABC died at 8.85M ANDs |

Fmax = 1e6 / (period_ps − WNS_ps). ASAP7 Liberty `time_unit = 1ps`, so all STA math is in ps.
