pachurii-knowledge/empty-sekai-lake/act-config/niigo-lake/niigo-rv64gc/niigo-rv64gc.yaml

# yaml-language-server: $schema=../../../external/riscv-unified-db/spec/schemas/config_schema.json
---
$schema: config_schema.json#
kind: architecture configuration
type: fully configured
name: niigo-rv64gc
description: niigo-lake RV64GC OoO core (IMAFDC + Zicsr + Zifencei)
implemented_extensions:
  - { name: I, version: "= 2.1" }
  - { name: M, version: "= 2.0" }
  - { name: A, version: "= 2.1.0" }
  - { name: F, version: "= 2.2.0" }
  - { name: D, version: "= 2.2.0" }
  - { name: C, version: "= 2.0" }
  - { name: Zca, version: "= 1.0.0" }
  - { name: Zcd, version: "= 1.0.0" }
  - { name: Zicntr, version: "= 2.0" }
  - { name: Zicsr, version: "= 2.0" }
  - { name: Zifencei, version: "= 2.0.0" }
  - { name: Zaamo, version: "= 1.0.0" }
  - { name: Zalrsc, version: "= 1.0.0" }
  - { name: Sm, version: "= 1.12.0" }
  - { name: S, version: "= 1.12.0" }
  - { name: U, version: "= 1.0.0" }
  - { name: Svbare, version: "= 1.0.0" }
  - { name: Sv39, version: "= 1.0.0" }
  - { name: Svadu, version: "= 1.0.0" }

params:
  MISALIGNED_AMO: false
  LRSC_RESERVATION_STRATEGY: "reserve exactly enough to cover the access"
  LRSC_FAIL_ON_VA_SYNONYM: false
  LRSC_MISALIGNED_BEHAVIOR: "always raise access fault"
  LRSC_FAIL_ON_NON_EXACT_LRSC: true
  MUTABLE_MISA_A: false
  MUTABLE_MISA_C: false
  MUTABLE_MISA_M: false
  MUTABLE_MISA_F: false
  HW_MSTATUS_FS_DIRTY_UPDATE: precise
  MSTATUS_FS_LEGAL_VALUES: [0, 1, 2, 3]
  MUTABLE_MISA_D: false
  TIME_CSR_IMPLEMENTED: true
  MXLEN: 64
  PRECISE_SYNCHRONOUS_EXCEPTIONS: true
  TRAP_ON_ECALL_FROM_M: true
  TRAP_ON_EBREAK: true
  MARCHID_IMPLEMENTED: false
  MIMPID_IMPLEMENTED: false
  VENDOR_ID_BANK: 0x0
  VENDOR_ID_OFFSET: 0x0
  MISALIGNED_LDST: true
  MISALIGNED_LDST_EXCEPTION_PRIORITY: low
  MISALIGNED_MAX_ATOMICITY_GRANULE_SIZE: 4096
  MISALIGNED_SPLIT_STRATEGY: sequential_bytes
  TRAP_ON_ILLEGAL_WLRL: false
  TRAP_ON_UNIMPLEMENTED_INSTRUCTION: true
  TRAP_ON_RESERVED_INSTRUCTION: true
  TRAP_ON_UNIMPLEMENTED_CSR: true
  REPORT_VA_IN_MTVAL_ON_BREAKPOINT: true
  REPORT_VA_IN_MTVAL_ON_LOAD_MISALIGNED: true
  REPORT_VA_IN_MTVAL_ON_STORE_AMO_MISALIGNED: true
  REPORT_VA_IN_MTVAL_ON_INSTRUCTION_MISALIGNED: true
  REPORT_VA_IN_MTVAL_ON_LOAD_ACCESS_FAULT: true
  REPORT_VA_IN_MTVAL_ON_STORE_AMO_ACCESS_FAULT: true
  REPORT_VA_IN_MTVAL_ON_INSTRUCTION_ACCESS_FAULT: true
  REPORT_ENCODING_IN_MTVAL_ON_ILLEGAL_INSTRUCTION: true
  MTVAL_WIDTH: 64
  CONFIG_PTR_ADDRESS: 0
  PMA_GRANULARITY: 3
  PHYS_ADDR_WIDTH: 56
  M_MODE_ENDIANNESS: little
  MISA_CSR_IMPLEMENTED: false
  MTVEC_ACCESS: rw
  MTVEC_MODES: [0, 1]
  MTVEC_BASE_ALIGNMENT_DIRECT: 4
  MTVEC_BASE_ALIGNMENT_VECTORED: 4
  MTVEC_ILLEGAL_WRITE_BEHAVIOR: retain
  # PMP: the OoO core implements 16 entries (pmpcfg0..3 / pmpaddr0..15) with
  # 4-byte granularity (NA4 selectable, pmpaddr fully writable), matching
  # src/pmp_checker.sv + the pmpcfg/pmpaddr WARL in src/priv_csr_file.sv.
  # Here PMP_GRANULARITY is G+2 (privileged-arch G=0 -> 4-byte region).
  NUM_PMP_ENTRIES: 16
  PMP_GRANULARITY: 2

  # ---- Supervisor / User mode (Phase 3-4: S/U privilege + Sv32) ----
  MUTABLE_MISA_S: false
  MUTABLE_MISA_U: false
  SXLEN: [64]
  UXLEN: [64]
  S_MODE_ENDIANNESS: little
  U_MODE_ENDIANNESS: little
  ASID_WIDTH: 16
  SATP_MODE_BARE: true
  MSTATUS_TVM_IMPLEMENTED: true
  MSTATUS_VS_LEGAL_VALUES: [0]
  STVEC_MODE_DIRECT: true
  STVEC_MODE_VECTORED: true
  STVAL_WIDTH: 64
  TRAP_ON_ECALL_FROM_S: true
  TRAP_ON_ECALL_FROM_U: true
  REPORT_ENCODING_IN_STVAL_ON_ILLEGAL_INSTRUCTION: true
  REPORT_VA_IN_MTVAL_ON_INSTRUCTION_PAGE_FAULT: true
  REPORT_VA_IN_MTVAL_ON_LOAD_PAGE_FAULT: true
  REPORT_VA_IN_MTVAL_ON_STORE_AMO_PAGE_FAULT: true
  REPORT_VA_IN_STVAL_ON_BREAKPOINT: true
  REPORT_VA_IN_STVAL_ON_INSTRUCTION_ACCESS_FAULT: true
  REPORT_VA_IN_STVAL_ON_INSTRUCTION_MISALIGNED: true
  REPORT_VA_IN_STVAL_ON_INSTRUCTION_PAGE_FAULT: true
  REPORT_VA_IN_STVAL_ON_LOAD_ACCESS_FAULT: true
  REPORT_VA_IN_STVAL_ON_LOAD_MISALIGNED: true
  REPORT_VA_IN_STVAL_ON_LOAD_PAGE_FAULT: true
  REPORT_VA_IN_STVAL_ON_STORE_AMO_ACCESS_FAULT: true
  REPORT_VA_IN_STVAL_ON_STORE_AMO_MISALIGNED: true
  REPORT_VA_IN_STVAL_ON_STORE_AMO_PAGE_FAULT: true
  SCOUNTENABLE_EN:
    [
      true, true, true, false, false, false, false, false,
      false, false, false, false, false, false, false, false,
      false, false, false, false, false, false, false, false,
      false, false, false, false, false, false, false, false,
    ]
  HPM_COUNTER_EN:
    [
      false,
      false,
      false,
      false,
      false,
      false,
      false,
      false,
      false,
      false,
      false,
      false,
      false,
      false,
      false,
      false,
      false,
      false,
      false,
      false,
      false,
      false,
      false,
      false,
      false,
      false,
      false,
      false,
      false,
      false,
      false,
      false,
    ]

  MCOUNTINHIBIT_IMPLEMENTED: false
  MCOUNTENABLE_EN:
    [
      false,
      false,
      false,
      false,
      false,
      false,
      false,
      false,
      false,
      false,
      false,
      false,
      false,
      false,
      false,
      false,
      false,
      false,
      false,
      false,
      false,
      false,
      false,
      false,
      false,
      false,
      false,
      false,
      false,
      false,
      false,
      false,
    ]
