pachurii-knowledge/empty-sekai-lake/src/riscv_core_ooo.sv

`include "ooo_types.vh"
`include "superscalar_types.vh"
`include "riscv_abi.vh"
`include "memory_segments.vh"
`include "riscv_priv.vh"

// The fence.i / halt write-back D-side flush handshake (defer the pc+4 redirect,
// raise dcache_flush_req, hold the frontend until dcache_flush_done, then
// invalidate the L1I and refetch) is needed by ANY write-back D-side: the L1D
// cache (L1D_CACHE) and the M3d grant-and-go MOESI agent (CCD_AGENT). Derive one
// guard so both get byte-identical behavior; the L1=0 / passthrough builds keep
// the immediate fence.i redirect. (undef'd after endmodule to avoid leakage.)
`ifdef L1D_CACHE
  `define NIIGO_DSIDE_WB
`elsif CCD_AGENT
  `define NIIGO_DSIDE_WB
`endif

`ifdef LOAD_SPEC_WAKE
`ifndef L1D_CACHE
  // LOAD_SPEC_WAKE requires the L1D's 1-cycle hit latency as its spec-wake
  // timing anchor (load-spec-wake.md §top): on the passthrough memsys the
  // fixed D_RESP_DELAY (>1) makes every spec-wake resolve as a miss.
  `error "LOAD_SPEC_WAKE requires L1D_CACHE (1-cycle hit anchor); use L1D=1 / PERF=1"
`endif
`endif

`default_nettype none

module riscv_core_ooo
    import OOO_Types::*;
    import RISCV_ISA::XLEN_BYTES;
    import RISCV_UArch::MEMORY_READ_WIDTH, RISCV_UArch::MEMORY_ADDR_WIDTH;
#(
    parameter logic [XLEN-1:0] HART_ID = '0,  // M4: per-core mhartid (default 0 = single core; XLEN via OOO_Types)
    parameter bit              COHERENT = 1'b0 // M4 B9: SC resolves rd at commit (multi-core); default 0 = single-core verbatim
)
(
    input wire logic             clk, rst_l,

    // Instruction-fetch port: one 16-byte block per request, handshaked.
    // Responses arrive in request order after an arbitrary >= 1 cycle
    // latency; the core associates them with requests by arrival order.
    output logic             ifetch_req_valid,
    input wire logic             ifetch_req_ready,
    output logic [MEMORY_ADDR_WIDTH-1:0] ifetch_req_addr,
    input wire logic             ifetch_resp_valid,
    input wire logic [MEMORY_READ_WIDTH-1:0][XLEN-1:0] ifetch_resp_data,
    input wire logic             ifetch_resp_excpt,

    // Data port: one word-granular load or store per request, handshaked.
    // Load responses arrive in order after an arbitrary >= 1 cycle latency
    // (the request word address is echoed for the device decode at
    // delivery); accepted stores are fire-and-forget.
    output logic             dmem_req_valid,
    input wire logic             dmem_req_ready,
    output logic             dmem_req_write,
    output logic [MEMORY_ADDR_WIDTH-1:0] dmem_req_addr,
    output logic [XLEN-1:0]  dmem_req_wdata,
    output logic [XLEN_BYTES-1:0]        dmem_req_wmask,
    // M3d Stage 2: typed memory-op code (LOAD/STORE/LR/AMO_RD) for the CCD L1D
    // agent; ignored by the L1D/passthrough memsys arms. See load_store_queue.sv.
    output logic [2:0]       dmem_req_op,
    // M4 #3: fine AMO sub-op accompanying a COP_AMO beat (agent-authoritative AMO).
    output logic [3:0]       dmem_req_amo,
    input wire logic             dmem_resp_valid,
    input wire logic [MEMORY_ADDR_WIDTH-1:0] dmem_resp_addr,
    input wire logic [XLEN-1:0]  dmem_resp_data,
    // M3d Stage 3 (S1): snoop-kill from the CCD agent (remote write -> reservation-kill /
    // spec-load squash in the LSQ). Constant 0 in non-CCD + single-core CCD builds.
    input wire logic             dmem_snoop_kill_valid,
    input wire logic [MEMORY_ADDR_WIDTH-1:0] dmem_snoop_kill_laddr,

    // MMU page-table-walk port: the walker's level req/ack word port (PTE
    // reads + A/D writebacks); rdata is valid in the ack cycle.
    output logic             ptw_mem_req,
    output logic             ptw_mem_we,
    output logic [MEMORY_ADDR_WIDTH-1:0] ptw_mem_addr_w,
    output logic [XLEN-1:0]  ptw_mem_wdata,
    input wire logic             ptw_mem_ack,
    input wire logic [XLEN-1:0]  ptw_mem_rdata,

    // fence.i: flash-invalidate the L1I (consumed by niigo_memsys at L1=1;
    // ignored by the L1=0 passthrough). Pulsed when a fence.i retires.
    output logic             ifetch_inval,
    // Cacheable/device split for the data port (L1D=1): high when the current
    // dmem request targets a memory-mapped device (CLINT/PLIC/UART) and must
    // bypass the L1D. Ignored by the L1=0/C1 passthrough.
    output logic             dmem_req_device,
    // L1D writeback flush handshake: the core raises dcache_flush_req on a
    // fence.i and holds the frontend until dcache_flush_done (memsys writes back
    // all dirty L1D lines). Under L1=0/C1 the memsys completes it immediately.
    output logic             dcache_flush_req,
    input wire logic             dcache_flush_done,
    // Cache event pulses from the memsys for mhpmcounter3-5 (phase C3).
    input wire logic             hpm_l1i_miss,
    input wire logic             hpm_l1d_miss,
    input wire logic             hpm_l1d_wb,
`ifdef NIIGO_EXT_DEVICES
    // M4 SMP: the per-core CLINT/PLIC/UART are lifted to ONE shared instance at
    // the SMP top. This core EXPORTS its committed-store snoop + device-load
    // query and IMPORTS the shared device's load result, mtime, and the four
    // per-hart interrupt lines. (NIIGO_EXT_DEVICES is set only by the SMP build
    // targets; the default build never sees these ports or the external arm.)
    output logic             dsnoop_store_en,
    output logic [MEMORY_ADDR_WIDTH-1:0] dsnoop_store_waddr,
    output logic [XLEN-1:0]  dsnoop_store_wdata,
    output logic [XLEN_BYTES-1:0] dsnoop_store_mask,
    output logic [MEMORY_ADDR_WIDTH-1:0] dsnoop_load_addr,
    output logic             dsnoop_load_en,
    output logic [$clog2(XLEN_BYTES)-1:0] dsnoop_load_off,
    input  wire logic        ext_load_hit,
    input  wire logic [XLEN-1:0] ext_load_data,
    input  wire logic [63:0] ext_mtime,
    input  wire logic        ext_irq_m_timer,
    input  wire logic        ext_irq_m_software,
    input  wire logic        ext_irq_m_external,
    input  wire logic        ext_irq_s_external,
`endif

    output logic             halted
`ifdef LSQ_MLP2
    ,
    // Track A: dmem transaction id, threaded LSQ->core->memsys->l1_dcache and back
    // so a data response can be matched to its outstanding slot (P3c parked
    // completion). Const-0 at P3a. Width via DMEM_ID_W (body localparam). Placed
    // last so it composes with the optional FPGA_BUILD port block.
    output logic [DMEM_ID_W-1:0] dmem_req_id,
    input  wire logic [DMEM_ID_W-1:0] dmem_resp_id
`endif
`ifdef FPGA_BUILD
    ,
    // ---- FB1: vUART byte streams (rerouted from the sim console) + a debug
    // observability probe (pure tap off the commit stage). Both inert unless
    // FPGA_BUILD; see niigo_soc.sv / cl_niigo.sv.
    output logic             vuart_tx_valid,
    output logic [7:0]       vuart_tx_byte,
    input  wire logic        vuart_rx_valid,
    input  wire logic [7:0]  vuart_rx_byte,
    output logic             vuart_rx_pop,
    output debug_probe_t     dbg_probe
`endif
);

    // Byte-address -> word-address shift for the word-granular memory bus.
    localparam int ADDR_SHIFT = $clog2(XLEN_BYTES);

`ifdef LSQ_MLP2
    // Track A dmem transaction-id width. LSQ_MLP in {1,2} (a coherent build pins 1)
    // => 1 bit; matches the LSQ's LSQ_ID_W and the memsys id ports. Revisit for MLP>2.
    localparam int DMEM_ID_W = 1;
`endif

    import RISCV_ABI::ECALL_ARG_HALT;
    import MemorySegments::USER_TEXT_START;

    localparam int PHYS_READ_PORTS = FU_ISSUE_PORTS + OOO_WIDTH;
    // Return-address stack depth. This is a pure prediction hint: a RAS
    // mispredict is caught and recovered at JALR resolve, so depth affects
    // accuracy (call-nesting reach) but never architectural correctness.
    // 128 was heavily over-provisioned -- typical call-nesting that the RAS
    // usefully predicts is shallow. 32 is a standard depth and cuts the
    // ras_stack flop array 4x (128->32 entries x XLEN) plus the fetch-cycle
    // 128:1 top-of-stack read mux down to 32:1 (ASAP7 area+timing; the array
    // maps to flops, not SRAM, since push/pop/checkpoint want parallel access).
    // Target-selected (results-identical hint sizing): ASAP7 = 32, FPGA/sim = 128
    // (the FPGA lineage's validated depth; BRAM/LUT area there is cheap).
`ifdef NIIGO_ASIC
    localparam int RAS_DEPTH = 32;    // ASAP7 7nm ASIC
`else
    localparam int RAS_DEPTH = 128;   // FPGA + functional sim
`endif
    localparam int RAS_INDEX_BITS = $clog2(RAS_DEPTH);
    localparam int RAS_COUNT_BITS = $clog2(RAS_DEPTH + 1);
    localparam int DIRECT_HISTORY_BITS = 30;

    logic [XLEN-1:0] pc_q, pc_next;
    logic [XLEN-1:0] fetch_pa;   // translated fetch address (driven in MMU section)
    // Fetch fault for pc_q's group, computed combinationally in the MMU
    // section and captured into the request metadata at issue.
    logic        fetch_fault;            // combinational: any lane of pc_q faults
    logic [OOO_WIDTH-1:0] fetch_fault_lane;  // per-lane fetch fault for pc_q's group
    logic [4:0]  fetch_fault_cause;

    // ---- Handshaked fetch frontend ----
    // Up to FETCH_DEPTH fetch requests may be in flight or buffered at once
    // (outstanding requests tracked by a small in-order metadata FIFO, plus a
    // 2-entry fetched-group buffer presented to decode). Responses arrive in
    // request order; redirect events mark every outstanding request killed
    // (its response is dropped on arrival) and clear the group buffer, so no
    // stale group is ever presented -- the role the old fixed-depth
    // fetch_pc/fetch_valid pipe clears played, without assuming a fixed
    // memory latency.
    localparam int FETCH_DEPTH = 2;
    typedef struct packed {
        logic                 valid;
        logic                 kill;
        logic [XLEN-1:0]      pc;
        logic [OOO_WIDTH-1:0] fault_lane;
        logic [4:0]           fault_cause;
`ifdef BTB
        // P2a: when this block was fetched, the BTB steered the NEXT fetch to
        // btb_tgt (btb_hit=1). Carried to decode so it can verify the steer
        // against B2's real prediction and suppress the flush on a block-ending
        // agree. btb_hit=0 => fetch continued sequentially after this block.
        // btb_off (P2b) = the predicted branch's last in-block parcel (the offset
        // at which the realigner terminates the block on a steered hit).
        logic                 btb_hit;
        logic [XLEN-1:0]      btb_tgt;
        logic [2:0]           btb_off;
`endif
    } fetch_meta_t;
    typedef struct packed {
        logic                 valid;
        logic [XLEN-1:0]      pc;
        logic [MEMORY_READ_WIDTH-1:0][XLEN-1:0] data;
        logic                 excpt;
        logic [OOO_WIDTH-1:0] fault_lane;
        logic [4:0]           fault_cause;
`ifdef BTB
        logic                 btb_hit;
        logic [XLEN-1:0]      btb_tgt;
        logic [2:0]           btb_off;
`endif
    } fetch_group_t;
    fetch_meta_t  fmeta_q [FETCH_DEPTH];
    fetch_meta_t  fmeta_next [FETCH_DEPTH];
    logic         fmeta_rd_q, fmeta_rd_next;   // FETCH_DEPTH == 2: 1-bit ptrs
    logic         fmeta_wr_q, fmeta_wr_next;
    logic [1:0]   fmeta_cnt_q, fmeta_cnt_next;
    fetch_group_t fbuf_q [2];                  // [0] = head (presented)
    fetch_group_t fbuf_next [2];
    logic [1:0]   fbuf_cnt_q, fbuf_cnt_next;
    // Presented group (head of the buffer, or the arriving response bypassed
    // when the buffer is empty).
    logic         fgrp_valid;
    logic [XLEN-1:0] fgrp_pc;
    logic [MEMORY_READ_WIDTH-1:0][XLEN-1:0] fgrp_data;
    logic         fgrp_excpt;
    logic [OOO_WIDTH-1:0] fgrp_fault_lane;
    logic [4:0]   fgrp_fault_cause;
    // Control strobes computed in the main combinational block.
    logic         fetch_flush;     // kill all outstanding + buffered fetches
`ifdef DISPATCH_STATS
    logic [3:0]   ff_src;          // stats only: which redirect arm won this flush
`endif
    logic         fetch_consume;   // pop the presented group
    logic         fetch_issue;     // issue a fetch for pc_q this cycle
    logic         fresp_take;      // a response arrives (pops metadata)
    logic         fresp_live;      // ...and its requester was not killed
    fetch_meta_t  fmeta_head;
    assign fmeta_head = fmeta_q[fmeta_rd_q];
    assign fresp_take = ifetch_resp_valid;
    assign fresp_live = fresp_take && fmeta_head.valid && !fmeta_head.kill;
    assign fgrp_valid       = (fbuf_cnt_q != 2'd0) ? fbuf_q[0].valid : fresp_live;
    assign fgrp_pc          = (fbuf_cnt_q != 2'd0) ? fbuf_q[0].pc    : fmeta_head.pc;
    assign fgrp_data        = (fbuf_cnt_q != 2'd0) ? fbuf_q[0].data  : ifetch_resp_data;
    assign fgrp_excpt       = (fbuf_cnt_q != 2'd0) ? fbuf_q[0].excpt : ifetch_resp_excpt;
    assign fgrp_fault_lane  = (fbuf_cnt_q != 2'd0) ? fbuf_q[0].fault_lane
                                                   : fmeta_head.fault_lane;
    assign fgrp_fault_cause = (fbuf_cnt_q != 2'd0) ? fbuf_q[0].fault_cause
                                                   : fmeta_head.fault_cause;
    // P2a: suppress a decode-stage redirect flush when the BTB already steered
    // fetch to the correct block-ending target. Declared unconditionally (it
    // gates the always-present redirect arms); tied 0 when the BTB is disabled.
    logic            btb_suppress;
`ifdef BTB
    logic            fgrp_btb_hit;
    logic [XLEN-1:0] fgrp_btb_tgt;
    logic [2:0]      fgrp_btb_off;
    assign fgrp_btb_hit = (fbuf_cnt_q != 2'd0) ? fbuf_q[0].btb_hit : fmeta_head.btb_hit;
    assign fgrp_btb_tgt = (fbuf_cnt_q != 2'd0) ? fbuf_q[0].btb_tgt : fmeta_head.btb_tgt;
    assign fgrp_btb_off = (fbuf_cnt_q != 2'd0) ? fbuf_q[0].btb_off : fmeta_head.btb_off;

    // P2a fetch-directed BTB. Looked up on pc_next (the block about to be fetched)
    // so its sync-read result is ready the cycle that block becomes pc_q: a hit
    // then steers this cycle's pc_next to the target (stream N->T, no wrong-path
    // N+16) and tags the block's fmeta entry. Every steer is verified at decode
    // (and, on a mispredict, at execute), so this is a pure performance hint.
    logic            btb_pred_valid;
    logic [XLEN-1:0] btb_pred_target;
    logic [2:0]      btb_pred_offset;
    logic [1:0]      btb_pred_type;
    logic [XLEN-1:0] btb_lk_blk_q;     // block(pc_next) looked up last cycle
    logic            btb_hit_now;      // BTB hit for the block being fetched (pc_q)
    logic            btb_train_valid, btb_train_taken;
    logic [XLEN-1:0] btb_train_pc, btb_train_target;
    logic [2:0]      btb_train_offset;
    logic [1:0]      btb_train_type;

    btb #(.SETS(512)) Btb (
        .clk(clk), .rst_l(rst_l),
        .lookup_valid(1'b1),
        .lookup_pc(pc_next),
        .pred_valid(btb_pred_valid),
        .pred_target(btb_pred_target),
        .pred_offset(btb_pred_offset),
        .pred_type(btb_pred_type),
        .train_valid(btb_train_valid),
        .train_taken(btb_train_taken),
        .train_pc(btb_train_pc),
        .train_target(btb_train_target),
        .train_offset(btb_train_offset),
        .train_type(btb_train_type)
    );
    always_ff @(posedge clk or negedge rst_l) begin
        if (!rst_l) btb_lk_blk_q <= '0;
        else        btb_lk_blk_q <= {pc_next[XLEN-1:4], 4'b0};
    end
    // Steer only if the registered prediction is for the block we are actually
    // fetching now (a redirect may have moved pc_q off the looked-up pc_next).
    assign btb_hit_now = btb_pred_valid &&
        (btb_lk_blk_q == {pc_q[XLEN-1:4], 4'b0});

    // ---- decode-time verify + train (drives B7's redirect arms + the BTB) ----
    // Scoped to predictor_redirect ONLY (TAGE-taken conditionals, P1 JALs,
    // ITTAGE-hit indirects). RETURNS (ras_redirect) are RAS-predicted with a
    // dynamic target -- caching them in the BTB pollutes it, so the ras arm below
    // stays un-suppressed and returns are never trained/steered.
    logic [XLEN-1:0] btb_seq_for_fgrp;    // sequential next block (base + 16)
    logic            btb_mis_steer;       // any steer that must flush + redirect
    logic [XLEN-1:0] btb_mis_recover_pc;  // where a mis-steer redirects to
    assign btb_seq_for_fgrp = {fgrp_pc[XLEN-1:4], 4'b0} + XLEN'(16);
`ifdef RVC
    // ---- P2b OFFSET-PRECISE verify: rvc_realign terminates the block AT btb_off
    // (the predicted branch's last parcel), so the branch and its target are the
    // whole in-stream picture -- no wrong-path tail parcels, no orphaned straddle.
    logic [2:0]      btb_branch_off;
    logic            btb_branch_straddle;  // 32-bit branch low half at parcel 7
    logic [XLEN-1:0] btb_fallthrough_pc;   // continue after a not-taken terminator
    logic            btb_mis_term;         // terminated, but resolves not-taken/non-branch
    logic            btb_mis_drain;        // steered + drained without matching btb_off
    assign btb_branch_off      = btb_branch_pc[3:1] + (btb_branch_is_c ? 3'd0 : 3'd1);
    assign btb_branch_straddle = !btb_branch_is_c && (btb_branch_pc[3:1] == 3'd7);
    // fall-through of the terminating branch = base + 2*(off + 1) (off is straddle-free
    // so off <= 7 and off+1 <= 8 => base .. base+16).
    assign btb_fallthrough_pc  = {fgrp_pc[XLEN-1:4], 4'b0} +
        XLEN'({1'b0, fgrp_btb_off, 1'b0} + 12'd2);
    // WIN: the realigner terminated AT the predicted branch and it resolves taken to
    // the BTB target -- the target is already streaming, so suppress the flush.
    // NOTE: every verify arm is gated on fgrp_valid. After a mis-steer flush the group
    // buffer empties (fgrp_valid=0) but fmeta_head/pblock keep STALE btb_hit + tail_straddle,
    // which would keep btb_mis_drain asserted -> perpetual flush -> fetch never re-issues ->
    // hang (observed at xv6 pc 8000041e). btb_suppress/btb_mis_term are implicitly gated
    // (rvc_btb_terminate <= out_valid[0] <= fgrp_valid) but carry it for clarity.
    assign btb_suppress = fgrp_valid && rvc_btb_terminate && predictor_redirect_valid &&
        (predictor_redirect_pc == fgrp_btb_tgt);
    // MIS-STEER (terminated wrong): the block terminated at btb_off but no redirect
    // fired (branch not-taken, or the offset instr is not a branch) -- recover to the
    // fall-through. A redirect to a DIFFERENT target needs no special case: btb_suppress
    // is 0, so the normal predictor_redirect arm flushes + redirects to the real target.
    assign btb_mis_term = fgrp_valid && rvc_btb_terminate && !predictor_redirect_valid &&
        !ras_redirect_valid && !dispatched_unpredicted_control;
    // MIS-STEER (aliased/stale): steered, but the block drained WITHOUT terminating at
    // btb_off (offset landed mid-instruction / the block never branches there) and no
    // redirect fired -- recover to base+16, or re-fetch base+14 to re-establish a
    // pending tail straddle the flush would otherwise orphan.
    assign btb_mis_drain = fgrp_valid && fgrp_btb_hit && rvc_block_drained && !rvc_btb_terminate &&
        !predictor_redirect_valid && !ras_redirect_valid && !dispatched_unpredicted_control;
    assign btb_mis_steer = btb_mis_term || btb_mis_drain;
    assign btb_mis_recover_pc = btb_mis_term ? btb_fallthrough_pc :
        (rvc_tail_straddle ? ({fgrp_pc[XLEN-1:4], 4'b0} + XLEN'(14)) : btb_seq_for_fgrp);
    // TRAIN: cache the taken branch's block + terminating offset; REFUSE a straddling
    // 32-bit branch (its high half lives in the next block -> cannot be a clean in-block
    // terminate; refusing it is the P2a straddle-bug fix). Invalidate on any mis-steer.
    assign btb_train_valid = (!dispatch_stall && !halted_q) &&
        ((predictor_redirect_valid && !btb_branch_straddle) || btb_mis_steer);
    assign btb_train_taken  = predictor_redirect_valid && !btb_branch_straddle;
    assign btb_train_pc     = fgrp_pc;
    assign btb_train_target = predictor_redirect_pc;
    assign btb_train_offset = btb_branch_off;
    assign btb_train_type   = 2'd0;
`else
    // ---- non-RVC: block-granular P2a. Fixed 4-byte insns => no realigner, no
    // straddle, so block-ending steering is correct as-is. (Mid-block non-RVC via a
    // tail mask is a future extension; block-ending covers loop back-edges.)
    logic btb_block_ending;
    assign btb_block_ending = fgrp_valid && (dispatch_count == valid_count);
    assign btb_suppress = predictor_redirect_valid && fgrp_btb_hit &&
        (fgrp_btb_tgt == predictor_redirect_pc) && btb_block_ending;
    assign btb_mis_steer = fgrp_btb_hit && btb_block_ending &&
        !predictor_redirect_valid && !ras_redirect_valid &&
        !dispatched_unpredicted_control && (fgrp_btb_tgt != btb_seq_for_fgrp);
    assign btb_mis_recover_pc = btb_seq_for_fgrp;
    assign btb_train_valid = (!dispatch_stall && !halted_q) &&
        ((predictor_redirect_valid && btb_block_ending) || btb_mis_steer);
    assign btb_train_taken  = predictor_redirect_valid && btb_block_ending;
    assign btb_train_pc     = fgrp_pc;
    assign btb_train_target = predictor_redirect_pc;
    assign btb_train_offset = 3'd0;
    assign btb_train_type   = 2'd0;
`endif
`else
    assign btb_suppress = 1'b0;
`endif
    logic halted_q, halted_next;
    logic terminal_pending_q, terminal_pending_next;
    logic control_pending_q, control_pending_next;
    branch_id_t control_pending_id_q, control_pending_id_next;
    logic frontend_stall;
    logic redirect_valid;
    logic [XLEN-1:0] redirect_pc;
    logic [XLEN-1:0] sequential_next_pc;

    decode_lane_t decode_lanes [OOO_WIDTH];
    logic [OOO_WIDTH-1:0] lane_valid;
    logic [OOO_WIDTH-1:0] lane_has_dest;
    logic [OOO_WIDTH-1:0] lane_is_branch;
`ifdef JAL_NO_CKPT
    logic [OOO_WIDTH-1:0] lane_needs_ckpt;  // lane_is_branch minus JAL (PC_uncond)
`endif
    logic [OOO_WIDTH-1:0] lane_is_unpredicted_control;
    logic [OOO_WIDTH-1:0] lane_is_call;
    logic [OOO_WIDTH-1:0] lane_is_return;
    logic [OOO_WIDTH-1:0] lane_control_predicted;
    logic [OOO_WIDTH-1:0][XLEN-1:0] lane_predicted_pc;
    logic [OOO_WIDTH-1:0] lane_is_memory;
    logic [OOO_WIDTH-1:0] lane_is_terminal;
    logic [OOO_WIDTH-1:0] lane_is_serializing;
    // P5b FP de-serialization scoreboard taps (driven 0 unless -DFP_OOO).
    logic [OOO_WIDTH-1:0] lane_is_fp;
    logic [OOO_WIDTH-1:0] lane_fp_src_busy;
    logic [OOO_WIDTH-1:0] lane_reads_fflags;
    logic                 fflags_drain_stall;
`ifdef FUSE_ANY
    // Macro-op fusion shared detector outputs (plans/dhry-attack-plan/shared-infra.md
    // §3): lane i is the older op of a fusable ADJACENT pair (i, i+1); lane i+1 is
    // the folded younger op. Decode-derived ONLY (never dispatch_valid) so no
    // combinational loop through dispatch_control is introduced.
    logic [OOO_WIDTH-1:0] fuse_master;
    logic [OOO_WIDTH-1:0] fuse_slave;
    logic [OOO_WIDTH-1:0][1:0] fuse_kind_lane;
`endif
`ifdef FUSE_LDBR
    // FUSE_LDBR: lane i is the SLAVE of an LDBR pair — NOT born-done (its ROB
    // entry retires via the pend_fbr fused-resolve writeback; active_list).
    logic [OOO_WIDTH-1:0] fuse_slave_ldbr;
    // pend_fbr: the 1-deep fused-branch-resolve buffer + its LSQ handshake.
    writeback_packet_t pend_fbr_q, pend_fbr_next;
    writeback_packet_t fbr_writeback;         // pend_fbr_q, drive-gated
    logic            pend_fbr_full;           // -> LSQ fused-issue gate
    logic            pend_fbr_drain_ready;    // WB bus accepted/aborted it
    logic            fused_resolve_valid;
    active_id_t      fused_resolve_active_id;
    branch_id_t      fused_resolve_branch_id;
    logic [XLEN-1:0] fused_resolve_pc;
    logic [31:0]     fused_resolve_instr;
    logic [XLEN-1:0] fused_resolve_redirect_pc;
    logic            fused_resolve_mispredict;
    logic            fused_resolve_ctrl_pred;
    logic [XLEN-1:0] fused_resolve_pred_pc;
    predictor_info_t fused_resolve_pred_info;
    branch_mask_t    fused_resolve_branch_mask;
    logic            fused_resolve_is_comp;
`endif
`ifdef FUSE_UADDR
    // FUSE_UADDR (c) survivor overrides (fuse-uaddr.md §2): the surviving
    // YOUNGER load keeps its lane but reads x0 for rs1 (map_rs1<-0), takes the
    // folded hi+off immediate, and selects the LSQ AGU pc-base path. The nulled
    // OLDER auipc rides the shared fuse_slave[] null path (born-done ROB slot).
    logic [OOO_WIDTH-1:0]           fu_zero_rs1;
    logic [OOO_WIDTH-1:0]           fu_imm_ovr;
    logic [OOO_WIDTH-1:0][XLEN-1:0] fu_imm;
    logic [OOO_WIDTH-1:0]           fu_pc_base;
`endif
`ifdef FUSE_BRANCH
    // Fuse-master whose folded slave is a branch (drives dispatch_control's
    // atomic-pair branch-stack stall, shared-infra §4b).
    logic [OOO_WIDTH-1:0] lane_fuse_pre_branch;
`endif
`ifdef FUSE_CMPBR_LI
    // FUSE_CMPBR Case B (li fusion, fuse-cmpbr.md §7b): lane i is a li master
    // whose folded branch compares against the branch's OTHER source register
    // (not x0). fu_caseb_src is that arch register; the master re-reads it via
    // its (otherwise unused) rs2 rename port (the li reads only x0).
    logic [OOO_WIDTH-1:0]           fu_caseb;
    logic [OOO_WIDTH-1:0][4:0]      fu_caseb_src;
`endif
    logic [OOO_WIDTH-1:0] dispatch_valid;
    logic [OOO_WIDTH-1:0] alloc_req;
    logic [OOO_WIDTH-1:0] map_has_dest;
    logic dispatch_stall;
`ifdef DISPATCH_STATS
    logic       dstat_cut_valid;
    logic [3:0] dstat_cut_reason;
    logic [$clog2(OOO_WIDTH+1)-1:0] dstat_cut_idx;
    logic [3:0] dstat_stall_reason;
`endif
    logic [2:0] dispatch_count;
    logic [2:0] valid_count;
    logic [2:0] lane_active_offset [OOO_WIDTH];
    logic partial_resume_valid;
    logic [2:0] partial_resume_lane;
    logic partial_resume_lane_is_branch;
    logic dispatched_unpredicted_control;
    logic ras_redirect_valid;
    logic [XLEN-1:0] ras_redirect_pc;
    logic predictor_redirect_valid;
    logic [XLEN-1:0] predictor_redirect_pc;
    // P2b: PC + is_compressed of the predictor-redirecting branch, captured in the
    // B2 predictor loop, so the BTB can train its terminating parcel offset.
    logic [XLEN-1:0] btb_branch_pc;
    logic            btb_branch_is_c;

    logic [XLEN-1:0] ras_stack_q [RAS_DEPTH];
    logic [XLEN-1:0] ras_stack_next [RAS_DEPTH];
    logic [RAS_COUNT_BITS-1:0] ras_count_q, ras_count_next;
    logic [RAS_COUNT_BITS-1:0] ras_checkpoint_count_q [BRANCH_STACK_SIZE];
    logic [RAS_COUNT_BITS-1:0] ras_checkpoint_count_next [BRANCH_STACK_SIZE];
    logic [RAS_COUNT_BITS-1:0] ras_branch_snapshot_count;

    logic [DIRECT_HISTORY_BITS-1:0] ghr_q, ghr_next;
    logic [DIRECT_HISTORY_BITS-1:0] ghr_checkpoint_q [BRANCH_STACK_SIZE];
    logic [DIRECT_HISTORY_BITS-1:0] ghr_checkpoint_next [BRANCH_STACK_SIZE];
    logic [DIRECT_HISTORY_BITS-1:0] ghr_branch_snapshot;

    // Predictor sync-read hold. The TAGE/ITTAGE tables are sync-read, so the
    // prediction for the presented group's lookup_pc is registered and available
    // the NEXT cycle. When a branch-bearing group first appears we hold it one
    // cycle (suppress dispatch -> also freezes fetch via frontend_stall, and
    // freezes pc_q/ghr_q) so B2 consumes the registered prediction matched to the
    // SAME (fgrp_pc, ghr_q). Architecturally inert: predictions are hints and
    // every branch is precisely recovered at resolve, so a mismatched/stale/late
    // prediction can only change cycle counts, never a committed result. The
    // (pc, ghr) key is exact because ghr_q cannot change during a non-flush hold
    // (the speculative push is under dispatch_valid; a restore implies a flush
    // that discards the held group).
    logic pred_ready_q;
    logic [XLEN-1:0] pred_key_pc_q;
    logic [DIRECT_HISTORY_BITS-1:0] pred_key_ghr_q;
    logic pred_launch, prediction_ready, predict_stall;
    // A branch-bearing group is presented and its sync-read lookup is in flight.
    // DFE_S2: the DIRECT (TAGE, conditional) read is combinational (async) under
    // -DDFE_S2 (tage_sc_l_predictor.sv), so direct_prediction is available the same
    // cycle the branch is at the dispatch head -- no hold needed. Only the INDIRECT
    // (ITTAGE) sync read still holds (S2b territory). Default: both terms (bit-identical).
    assign pred_launch = fgrp_valid && !halted_q &&
`ifdef DFE_S2
                         indirect_lookup_valid;
`else
                         (direct_lookup_valid || indirect_lookup_valid);
`endif
    // The registered prediction is ready and matches THIS held group's key.
    assign prediction_ready = pred_ready_q && (pred_key_pc_q == fgrp_pc) &&
                              (pred_key_ghr_q == ghr_q);
    assign predict_stall = pred_launch && !prediction_ready;

    logic direct_lookup_valid;
    logic [XLEN-1:0] direct_lookup_pc;
    logic direct_prediction;
    predictor_info_t direct_prediction_info;
    logic indirect_lookup_valid;
    logic [XLEN-1:0] indirect_lookup_pc;
    logic indirect_prediction_valid;
    logic [XLEN-1:0] indirect_prediction_target;
    predictor_info_t indirect_prediction_info;
    predictor_info_t lane_predictor_info [OOO_WIDTH];

    arch_reg_t map_rs1 [OOO_WIDTH];
    arch_reg_t map_rs2 [OOO_WIDTH];
    arch_reg_t map_rd [OOO_WIDTH];
    phys_reg_t map_prs1 [OOO_WIDTH];
    phys_reg_t map_prs2 [OOO_WIDTH];
    phys_reg_t map_old_prd [OOO_WIDTH];
    phys_reg_t map_snapshot [32];

    logic [OOO_WIDTH-1:0] free_alloc_valid;
    phys_reg_t free_alloc_prd [OOO_WIDTH];
    logic free_can_allocate;
    logic [$clog2(PHYS_REGS)-1:0] free_head_snapshot;
    logic [$clog2(PHYS_REGS)-1:0] free_tail_snapshot;
    logic [$clog2(PHYS_REGS+1)-1:0] free_count_snapshot;
    logic [OOO_WIDTH-1:0] active_free_valid;
    phys_reg_t active_free_prd [OOO_WIDTH];

    logic [OOO_WIDTH-1:0] busy_src1_ready;
    logic [OOO_WIDTH-1:0] busy_src2_ready;
    logic [OOO_WIDTH-1:0] wakeup_valid;
    phys_reg_t wakeup_prd [OOO_WIDTH];

    rename_packet_t rename_packets [OOO_WIDTH];
    issue_entry_t dispatch_issue_entries [OOO_WIDTH];
    logic [OOO_WIDTH-1:0] int_insert_valid;
    logic [OOO_WIDTH-1:0] mem_insert_valid;

    logic active_full;
    logic active_empty;
    active_id_t active_tail;
    logic [OOO_WIDTH-1:0] active_commit_valid;
    commit_packet_t active_commit_packet [OOO_WIDTH];

    logic int_iq_full;
    logic [FU_ISSUE_PORTS-1:0] int_issue_valid;
    logic [FU_ISSUE_PORTS-1:0] int_issue_ready;
    issue_entry_t int_issue_entry [FU_ISSUE_PORTS];

    // Select -> Execute pipeline register (S2) for the two ALU ports. The IQ select
    // (S1) registers the chosen entry here; the ALU pipe / regfile read / CSR read
    // all run from the registered copy in S2. Halves the single-cycle select+wakeup
    // +regread+execute critical cone. MUL/DIV/FP keep their combinational issue path
    // (own multi-cycle pipelines, not on the critical path). spec_wake_* broadcasts
    // an in-S2 ALU producer's dest one cycle early for zero-bubble ALU->ALU chains.
    logic [ALU_ISSUE_PORTS-1:0] alu_issue_valid_q;
    issue_entry_t alu_issue_entry_q [ALU_ISSUE_PORTS];
    logic [ALU_ISSUE_PORTS-1:0] spec_wake_valid;
    phys_reg_t spec_wake_prd [ALU_ISSUE_PORTS];

`ifdef LOAD_SPEC_WAKE
    // LOAD_SPEC_WAKE (plans/dhry-attack-plan/load-spec-wake.md): the LSQ's
    // hit-predicted load broadcast (wired LSQ -> IQ directly) plus the core's
    // one-cycle verdict. ld_spec_pending_q tracks a broadcast made last cycle;
    // a response this cycle is that load's HIT (sole-outstanding at broadcast),
    // its absence the MISS. Under LSQ_MLP2 the verdict id-matches
    // dmem_resp_id vs the broadcast's allocated inflight id (adversarial
    // finding 1: never trust raw dmem_resp_valid). alu_issue_ld_spec_q is the
    // S2 poison riding alongside alu_issue_valid_q; iq_issue_ld_spec is the
    // IQ's per-port pick poison.
    logic       lsq_load_spec_wake_valid;
    phys_reg_t  lsq_load_spec_wake_prd;
    logic       ld_spec_pending_q;
    logic       ld_spec_hit, ld_spec_miss;
    logic [ALU_ISSUE_PORTS-1:0] iq_issue_ld_spec;
    logic [ALU_ISSUE_PORTS-1:0] alu_issue_ld_spec_q;
`ifdef LSQ_MLP2
    logic [DMEM_ID_W-1:0] lsq_load_spec_wake_id;
    logic [DMEM_ID_W-1:0] ld_spec_id_q;
`endif
`endif

    phys_reg_t phys_rs1 [PHYS_READ_PORTS];
    phys_reg_t phys_rs2 [PHYS_READ_PORTS];
    logic [PHYS_READ_PORTS-1:0][XLEN-1:0] phys_rs1_data;
    logic [PHYS_READ_PORTS-1:0][XLEN-1:0] phys_rs2_data;
    logic [OOO_WIDTH-1:0][XLEN-1:0] mem_insert_rs1_data;
    logic [OOO_WIDTH-1:0][XLEN-1:0] mem_insert_rs2_data;
    logic [OOO_WIDTH-1:0] phys_write_valid;
    phys_reg_t phys_write_prd [OOO_WIDTH];
    logic [OOO_WIDTH-1:0][XLEN-1:0] phys_write_data;

    writeback_packet_t alu0_writeback;
    writeback_packet_t alu1_writeback;
`ifdef ALU4
    writeback_packet_t alu2_writeback;   // 3rd integer ALU issue port
`endif
    writeback_packet_t load_writeback;
    writeback_packet_t mul_writeback;
    writeback_packet_t div_writeback;
    writeback_packet_t fp_writeback;
    writeback_packet_t branch_writeback;
    logic mul_writeback_ready;
    logic div_writeback_ready;
    logic fp_writeback_ready;
    logic [OOO_WIDTH-1:0] writeback_valid;
    active_id_t writeback_active_id [OOO_WIDTH];
    phys_reg_t writeback_prd [OOO_WIDTH];
    logic [OOO_WIDTH-1:0][XLEN-1:0] writeback_data;
    logic [OOO_WIDTH-1:0] writeback_has_dest;
    logic [OOO_WIDTH-1:0] writeback_fp_write;
    arch_reg_t writeback_fp_rd [OOO_WIDTH];
    fp_reg_data_t writeback_fp_data [OOO_WIDTH];
    logic [OOO_WIDTH-1:0] writeback_csr_write;
    logic [OOO_WIDTH-1:0][11:0] writeback_csr_addr;
    logic [OOO_WIDTH-1:0][XLEN-1:0] writeback_csr_wdata;
    logic [OOO_WIDTH-1:0] writeback_fp_fflags_valid;
    logic [OOO_WIDTH-1:0][4:0] writeback_fp_fflags;
    logic [OOO_WIDTH-1:0] writeback_exception;
    logic [OOO_WIDTH-1:0][4:0] writeback_exc_cause;
    logic [OOO_WIDTH-1:0] writeback_halted;

    logic [XLEN-1:0] csr_read_data [2];
    logic [1:0] csr_read_illegal;
    logic csr_commit_write;
    logic [11:0] csr_commit_addr;
    logic [XLEN-1:0] csr_commit_wdata;
    logic csr_fp_fflags_valid;
    logic [4:0] csr_fp_fflags;
    logic [2:0] csr_frm;
    logic [2:0] retire_count;   // # instructions retired this cycle (0..OOO_WIDTH)

    // --- Privileged-ISA / trap state (Phase 3) ---
    // Architectural privilege + CSR state exposed by priv_csr_file.
    RISCV_Priv::priv_mode_t cur_priv;
    logic [XLEN-1:0] csr_mstatus, csr_medeleg, csr_mideleg, csr_mie, csr_mip;
    logic [XLEN-1:0] csr_mtvec, csr_stvec, csr_mepc, csr_sepc, csr_satp;
    logic [31:0] csr_pmpcfg_arr [4];
    logic [XLEN-1:0] csr_pmpaddr_arr [16];
    logic        csr_menvcfg_adue;
    logic [63:0] clint_mtime;
    logic        irq_mtimer, irq_msoft;
    logic        clint_load_hit;
    logic [XLEN-1:0] clint_load_data;
    logic        plic_load_hit;
    logic [XLEN-1:0] plic_load_data;
    logic        plic_m_ext, plic_s_ext;
    logic        uart_load_hit;
    logic [XLEN-1:0] uart_load_data;
    logic        uart_irq;
    logic [ADDR_SHIFT-1:0] dev_load_off;   // head load byte offset (from LSQ)

    // Commit-time trap evaluation (driven combinationally in the commit block).
    logic        commit_exc_valid;
    logic [4:0]  commit_exc_cause;
    logic [XLEN-1:0] commit_exc_tval;
    logic [XLEN-1:0] commit_trap_epc;
    logic        commit_take_trap, commit_take_ret, commit_ret_from_s;
    // trap_controller outputs
    logic        tc_trap_valid, tc_is_int;
    logic [4:0]  tc_cause;
    RISCV_Priv::priv_mode_t tc_target;
    logic [XLEN-1:0] tc_vector;
    logic [XLEN-1:0] trap_redirect_pc;

    // --- Precise interrupts via ROB drain (Phase 3b) ---
    // When an interrupt is pending+enabled we stop dispatching new instructions
    // and let the ROB drain. Once empty, the interrupt is taken with epc set to
    // the oldest undispatched instruction. All of this is gated by
    // irq_pending_now, which is identically zero whenever interrupts are
    // disabled (e.g. every RV32G test), so it has no effect there.
    logic        irq_pending_now;
    logic [31:0] irq_eff;
    logic        m_irq_en, s_irq_en;
    logic        irq_drain_q, irq_drain_next;
    logic        commit_take_int;
    logic [XLEN-1:0] commit_int_epc;
    // WFI: while wfi_wait_q the core idles (dispatch suppressed) until an
    // enabled interrupt is pending (wfi_wake), ignoring the global enable.
    logic        wfi_wait_q, wfi_wait_next, wfi_wait_set, wfi_wake;
    assign wfi_wake = (csr_mip & csr_mie) != 32'b0;

    fp_reg_data_t fp_regs_q [FP_REGS];
    fp_reg_data_t fp_regs_next [FP_REGS];
    logic serial_pending_q, serial_pending_next;

`ifdef FP_OOO
    // P5b: single-producer arch-FPR scoreboard. fpr_busy_q[x]=1 while an FP writer
    // to FPR x is in flight (dispatch->retire); a WAW dispatch-stall keeps at most
    // one writer per FPR live, so the producer's aged branch_mask alone suffices
    // for abort recovery (fpr_prod_mask_q, aged by ~reset_mask -- the same trick
    // niigo_fp_unit uses for its single in-flight op). No branch_stack snapshot.
    logic [FP_REGS-1:0] fpr_busy_q, fpr_busy_next;
    branch_mask_t       fpr_prod_mask_q   [FP_REGS];
    branch_mask_t       fpr_prod_mask_next [FP_REGS];
`endif

    logic branch_stack_full;
    logic branch_allocate;
    logic branch_allocate_valid;
    branch_id_t branch_allocate_id;
    active_id_t branch_active_tail_snapshot;
    logic [$clog2(PHYS_REGS)-1:0] branch_free_head_snapshot;
    logic [$clog2(PHYS_REGS)-1:0] branch_free_tail_snapshot;
    logic [$clog2(PHYS_REGS+1)-1:0] branch_free_count_snapshot;
    phys_reg_t branch_map_snapshot [32];
    branch_mask_t current_branch_mask;
    logic branch_restore_valid;
    active_id_t branch_restore_active_tail;
    logic [$clog2(PHYS_REGS)-1:0] branch_restore_free_head;
    logic [$clog2(PHYS_REGS)-1:0] branch_restore_free_tail;
    logic [$clog2(PHYS_REGS+1)-1:0] branch_restore_free_count;
    phys_reg_t branch_restore_map [32];
    branch_mask_t stack_reset_mask;
    branch_mask_t stack_abort_mask;
    logic branch_resolve_valid;
    branch_id_t branch_resolve_id;
    logic branch_resolve_mispredict;
    branch_mask_t reset_mask;
    // FB2b routed-WNS fix: abort_mask / abort_mask_q are the branch-recovery squash
    // broadcast -- they fan out to every speculative structure (IQ/LSQ/ROB/branch_
    // stack/FUs) across the die. The OOC route showed abort_mask_q -> DivUnit at 39 ns
    // route (90%), the routed worst path. max_fanout makes synth REPLICATE the driver
    // into local copies so Quick-place can put each near its consumers (short routes),
    // instead of one global net the router stretches across the chip. Synthesis-only
    // attribute -- Verilator ignores it, so the functional design is unchanged.
    (* max_fanout = 64 *) branch_mask_t abort_mask;
    (* max_fanout = 64 *) branch_mask_t abort_mask_q;
    branch_mask_t dispatch_branch_mask;

    logic mem_queue_full;
    logic mem_data_load_en;
    logic [MEMORY_ADDR_WIDTH-1:0] mem_data_addr;
    logic [XLEN-1:0] mem_data_store;
    logic [XLEN_BYTES-1:0] mem_data_store_mask;
    logic [2:0] mem_dmem_op;            // M3d Stage 2: LSQ typed op -> dmem_req_op
    logic [3:0] mem_dmem_amo;           // M4 #3: LSQ fine AMO op -> dmem_req_amo
`ifdef LSQ_MLP2
    logic [DMEM_ID_W-1:0] mem_dmem_id;  // Track A: LSQ-allocated dmem txn id -> dmem_req_id
    assign dmem_req_id = mem_dmem_id;
`endif
    logic lsq_store_second_beat;
    logic lsq_store_port_busy;
    logic lsq_sc_commit_done;           // M4-S5b: LSQ resolved the coherent SC -> release ROB retire
    logic [2:0] lsq_head_reason;        // P3-M0: LSQ head-blocking-reason (display-only perf)
    logic [2:0] lsq_fwd_class;          // P3 L2a: store->load forwarding opportunity (display-only)
    logic commit_store;
    active_id_t commit_store_id;

    logic [OOO_WIDTH-1:0] retire_valid;
    logic [OOO_WIDTH-1:0] commit_free_valid;
    phys_reg_t commit_free_prd [OOO_WIDTH];
    logic precise_halt;
    logic precise_exception;

    // ---- Precise-trap full flush for non-serializing faults (Phase 3c) ----
    // Memory access/page faults and instruction-fetch faults are NOT
    // serializing, so younger instructions are in flight behind them when the
    // fault reaches commit. Taking such a trap therefore squashes every
    // in-flight instruction (active list / issue queues / LSQ / branch stack /
    // multi-cycle FUs) in one cycle and rolls the rename map and free list back
    // to the committed architectural state. The multi-cycle units (mul/div/fp)
    // are flushed directly so no stale writeback lands on a reused active-list
    // id; single-cycle ALU writebacks and LSQ load completions are wiped by the
    // same-cycle active-list / LSQ flush, so no drain is required.
    //
    // arch_map_q is a committed (retirement) rename map (RRAT); arch_free_head_q
    // is the free-list head as of the committed point, so squashed speculative
    // allocations are reclaimed by rolling the free-list head back to it.
    logic        trap_take;         // exception committed this cycle -> full flush
    phys_reg_t   arch_map_q [32];
    phys_reg_t   arch_map_next [32];
    logic [$clog2(PHYS_REGS)-1:0] arch_free_head_q;
    logic [$clog2(PHYS_REGS)-1:0] arch_free_head_next;
    logic        map_restore_valid;
    phys_reg_t   map_restore_map [32];
    logic        free_restore_valid;
    logic [$clog2(PHYS_REGS)-1:0] free_restore_head;

    logic [OOO_WIDTH-1:0] arch_rd_we;
    // register_file declares its index ports as [$clog2(WIDTH)-1:0] (WIDTH=XLEN),
    // so on RV64 each selector is 6 bits, not 5. The index arrays must match that
    // per-way width or the packed-array connection misaligns lanes 1+ (writing
    // scrambled architectural register numbers).
    logic [OOO_WIDTH-1:0][$clog2(XLEN)-1:0] arch_rs1;
    logic [OOO_WIDTH-1:0][$clog2(XLEN)-1:0] arch_rs2;
    logic [OOO_WIDTH-1:0][$clog2(XLEN)-1:0] arch_rd;
    logic [OOO_WIDTH-1:0][XLEN-1:0] arch_rd_data;
    logic [OOO_WIDTH-1:0][XLEN-1:0] arch_rs1_data;
    logic [OOO_WIDTH-1:0][XLEN-1:0] arch_rs2_data;

    assign halted = halted_q;
    // A fetch request fires only if no same-cycle redirect/flush retargets the
    // PC (fetch_flush setters later in the commit logic override pc_next, so a
    // request issued for the stale pc_q would be a dead fetch -- suppress it).
    logic fetch_fire;
    assign fetch_fire = fetch_issue && !fetch_flush;
    assign ifetch_req_valid = fetch_fire;
    // The request address is the translated fetch block address (fetch_pa,
    // computed in the MMU section below; identity when paging is off). The
    // 16-byte fetch block is {fetch_pa[..:4]} as a word address (2 zeros for
    // RV32's 4-byte words, 1 for RV64's 8-byte words).
    assign ifetch_req_addr = {fetch_pa[XLEN-1:4], {(4-ADDR_SHIFT){1'b0}}};
    assign sequential_next_pc = {pc_q[XLEN-1:4], 4'b0} + XLEN'(16);
    assign dispatch_branch_mask = current_branch_mask & ~reset_mask & ~abort_mask;

    // Extract the 4 32-bit instructions of the 16-byte fetch block from the
    // word-granular memory read. RV32: one instruction per memory word. RV64:
    // two 32-bit instructions per 64-bit word, so the block is the low 2 words.
    logic [3:0][31:0] decode_fetch_instr;
    always_comb begin
        for (int j = 0; j < 4; j++)
`ifdef RV64
            decode_fetch_instr[j] = fgrp_data[j/2][ (j[0] ? 32 : 0) +: 32 ];
`else
            decode_fetch_instr[j] = fgrp_data[j];
`endif
    end

`ifdef DFE_S1
`ifdef RVC
    // DFE S1a realigner taps. RVC-only: DFE_S1 is OoO-only and the OoO frontend
    // requires RVC (a non-RVC OoO build does not elaborate -- pre-existing
    // is_compressed), and the predecode is RVC-parcel-based.
    logic [2:0]      dfe_s0;
    logic            dfe_completing;
    logic [XLEN-1:0] dfe_straddle_pc;
    logic [15:0]     dfe_straddle_half;
`endif
`endif

`ifdef RVC
    // RV64C: the two-wide expand-before-decode realign stage drains the
    // presented 16-byte group as 2-byte parcels and emits up to two canonical
    // 32-bit instructions/cycle with true 2-byte-granular PCs. Under -DRVC the
    // fgrp_fault_lane carried through the buffer is ABSOLUTE per-4B-word (see the
    // FetchPMP fork below), which the realigner maps to each instruction.
    logic [`RVC_NLANES-1:0]            rvc_lane_valid;
    logic [`RVC_NLANES-1:0][XLEN-1:0]  rvc_lane_pc;
    logic [`RVC_NLANES-1:0][31:0]      rvc_lane_instr;
    logic [`RVC_NLANES-1:0]            rvc_lane_is_comp;
    logic [`RVC_NLANES-1:0]            rvc_lane_fault;
    logic [`RVC_NLANES-1:0]            rvc_lane_fault_hi;
    logic [`RVC_NLANES-1:0][4:0]       rvc_lane_cause;
    logic [`RVC_NLANES-1:0][15:0]      rvc_lane_parcel;
    logic                  rvc_consume_block;
    logic                  rvc_block_drained;
    logic                  rvc_btb_terminate;
    logic                  rvc_tail_straddle;
    logic                  rvc_oldest_valid;
    logic [XLEN-1:0]       rvc_oldest_pc;
    // P2b BTB steer inputs to the realigner (tied 0 when BTB is disabled).
    logic                  realign_btb_hit;
    logic [2:0]            realign_btb_off;
`ifdef BTB
    assign realign_btb_hit = fgrp_btb_hit;
    assign realign_btb_off = fgrp_btb_off;
`else
    assign realign_btb_hit = 1'b0;
    assign realign_btb_off = 3'd0;
`endif

    rvc_realign RvcRealign (
        .clk,
        .rst_l,
        .fgrp_valid(fgrp_valid && !halted_q),
        .fgrp_pc,
        .fgrp_data,
        .fgrp_excpt,
        .fgrp_fault_word(fgrp_fault_lane & {OOO_WIDTH{fgrp_valid}}),
        .fgrp_fault_cause,
        .dispatch_count,
        .frontend_hold(dispatch_stall || halted_q),
        .fetch_flush,
        .btb_hit_in(realign_btb_hit),
        .btb_off_in(realign_btb_off),
        .out_valid(rvc_lane_valid),
        .out_pc(rvc_lane_pc),
        .out_instr(rvc_lane_instr),
        .out_is_compressed(rvc_lane_is_comp),
        .out_fetch_fault(rvc_lane_fault),
        .out_fetch_fault_hi(rvc_lane_fault_hi),
        .out_fault_cause(rvc_lane_cause),
        .out_rvc_parcel(rvc_lane_parcel),
        .rvc_consume_block,
        .rvc_block_drained,
        .rvc_btb_terminate,
        .rvc_tail_straddle,
        .frontend_oldest_valid(rvc_oldest_valid),
        .frontend_oldest_pc(rvc_oldest_pc)
`ifdef DFE_S1
        , .dfe_s0(dfe_s0)
        , .dfe_completing(dfe_completing)
        , .dfe_straddle_pc(dfe_straddle_pc)
        , .dfe_straddle_half(dfe_straddle_half)
`endif
    );
`endif

    ooo_fetch_decode FetchDecode (
        .rst_l,
        .fetch_valid(fgrp_valid && !halted_q),
        .instr_mem_excpt(fgrp_excpt),
        .fetch_fault_lane(fgrp_fault_lane & {OOO_WIDTH{fgrp_valid}}),
        .fetch_fault_cause(fgrp_fault_cause),
        .fetch_pc(fgrp_pc),
        .instr(decode_fetch_instr),
`ifdef RVC
        .rvc_valid(rvc_lane_valid),
        .rvc_pc(rvc_lane_pc),
        .rvc_instr(rvc_lane_instr),
        .rvc_is_compressed(rvc_lane_is_comp),
        .rvc_fetch_fault(rvc_lane_fault),
        .rvc_fetch_fault_hi(rvc_lane_fault_hi),
        .rvc_fault_cause(rvc_lane_cause),
        .rvc_parcel(rvc_lane_parcel),
`endif
        .decode_lanes
    );

    rename_map_table MapTable (
        .clk,
        .rst_l,
        .restore_valid(map_restore_valid),
        .restore_map(map_restore_map),
        .rename_valid(dispatch_valid),
        .rs1(map_rs1),
        .rs2(map_rs2),
        .rd(map_rd),
        .rename_has_dest(lane_has_dest),
        .alloc_prd(free_alloc_prd),
        .prs1(map_prs1),
        .prs2(map_prs2),
        .old_prd(map_old_prd),
        .has_dest(map_has_dest),
        .snapshot_map(map_snapshot)
    );

    free_list FreeList (
        .clk,
        .rst_l,
        .restore_valid(free_restore_valid),
        .restore_head(free_restore_head),
        .restore_tail(branch_restore_free_tail),
        .restore_count(branch_restore_free_count),
        .alloc_req(alloc_req),
        .free_valid(active_free_valid),
        .free_prd(active_free_prd),
        .alloc_valid(free_alloc_valid),
        .alloc_prd(free_alloc_prd),
        .can_allocate(free_can_allocate),
        .snapshot_head(free_head_snapshot),
        .snapshot_tail(free_tail_snapshot),
        .snapshot_count(free_count_snapshot)
    );

    busy_table BusyTable (
        .clk,
        .rst_l,
        .allocate_valid(free_alloc_valid),
        .allocate_prd(free_alloc_prd),
        .writeback_valid(wakeup_valid),
        .writeback_prd(wakeup_prd),
        .src1_prd(map_prs1),
        .src2_prd(map_prs2),
        .src1_ready(busy_src1_ready),
        .src2_ready(busy_src2_ready)
    );

    priv_csr_file #(.HART_ID(HART_ID)) CSRFile (
        .clk,
        .rst_l,
        .retire_cnt(retire_count),
        .mtime(clint_mtime),
        // ALU ports read CSRs in S2 (the execute stage), so the read address comes
        // from the registered issue entry, matching the ALU pipe's csr_rdata use.
        .read_addr(alu_issue_entry_q[0].instr[31:20]),
        .read_data(csr_read_data[0]),
        .read_illegal(csr_read_illegal[0]),
        .read_addr1(alu_issue_entry_q[1].instr[31:20]),
        .read_data1(csr_read_data[1]),
        .read_illegal1(csr_read_illegal[1]),
        .write_valid(csr_commit_write),
        .write_addr(csr_commit_addr),
        .write_data(csr_commit_wdata),
        .fp_fflags_valid(csr_fp_fflags_valid),
        .fp_fflags(csr_fp_fflags),
        .frm_value(csr_frm),
        .cache_ev_l1i_miss(hpm_l1i_miss),
        .cache_ev_l1d_miss(hpm_l1d_miss),
        .cache_ev_l1d_wb(hpm_l1d_wb),
        .irq_m_timer(irq_mtimer),
        .irq_m_software(irq_msoft),
        .irq_m_external(plic_m_ext),
        .irq_s_external(plic_s_ext),
        .trap_valid(commit_take_trap || commit_take_int),
        .trap_is_interrupt(tc_is_int),
        .trap_cause(tc_cause),
        .trap_epc(commit_take_int ? commit_int_epc : commit_trap_epc),
        .trap_tval(tc_is_int ? 32'b0 : commit_exc_tval),
        .trap_target_priv(tc_target),
        .ret_valid(commit_take_ret),
        .ret_from_s(commit_ret_from_s),
        .priv(cur_priv),
        .mstatus(csr_mstatus),
        .medeleg(csr_medeleg),
        .mideleg(csr_mideleg),
        .mie_csr(csr_mie),
        .mip_csr(csr_mip),
        .mtvec(csr_mtvec),
        .stvec(csr_stvec),
        .mepc(csr_mepc),
        .sepc(csr_sepc),
        .satp(csr_satp),
        .pmpcfg_o(csr_pmpcfg_arr),
        .pmpaddr_o(csr_pmpaddr_arr),
        .menvcfg_adue(csr_menvcfg_adue)
    );

    // Trap aggregation/delegation for the instruction being committed.
    trap_controller TrapCtrl (
        .priv(cur_priv),
        .mstatus(csr_mstatus),
        .mie_csr(csr_mie),
        .mip_csr(csr_mip),
        .medeleg(csr_medeleg),
        .mideleg(csr_mideleg),
        .mtvec(csr_mtvec),
        .stvec(csr_stvec),
        .exc_valid(commit_exc_valid),
        .exc_cause(commit_exc_cause),
        .trap_valid(tc_trap_valid),
        .trap_is_interrupt(tc_is_int),
        .trap_cause(tc_cause),
        .trap_target_priv(tc_target),
        .trap_vector(tc_vector)
    );

    // A store write beat is accepted by the memory subsystem this cycle. The
    // devices snoop ACCEPTED stores only: a write beat held while the port is
    // not ready stays presented for several cycles and must produce exactly
    // one device side effect.
    logic dmem_store_fire;
    assign dmem_store_fire = dmem_req_valid && dmem_req_write && dmem_req_ready;

    // Cacheable/device split (L1D=1): a dmem request to the CLINT/PLIC/UART
    // device hole bypasses the L1D. Byte PA = word addr << ADDR_SHIFT. Mirrors
    // NIIGO_Mem::is_device_pa; kept inline so the core needn't import the memsys
    // package. Harmless when the memsys ignores it (L1=0/C1).
    logic [XLEN-1:0] dmem_req_bpa;
    assign dmem_req_bpa = {dmem_req_addr, {ADDR_SHIFT{1'b0}}};
    assign dmem_req_device =
        ((dmem_req_bpa >= XLEN'('h0200_0000)) && (dmem_req_bpa < XLEN'('h0201_0000))) ||
        ((dmem_req_bpa >= XLEN'('h0C00_0000)) && (dmem_req_bpa < XLEN'('h1000_0000))) ||
        ((dmem_req_bpa >= XLEN'('h0D00_0000)) && (dmem_req_bpa < XLEN'('h0D00_1000)));

    // fence.i L1D-writeback hold (L1D=1 only). On a fence.i retire the core
    // defers the pc+4 redirect, raises dcache_flush_req, and holds the frontend
    // until the memsys has written back every dirty L1D line (dcache_flush_done);
    // only then does it invalidate the L1I and refetch -- so the modified code is
    // in memory before the I-side refills it. On C1/L1=0 the fence.i path keeps
    // its immediate redirect and this is inert.
`ifdef NIIGO_DSIDE_WB
    logic        fencei_pending_q, fencei_pending_next;
    logic [XLEN-1:0] fencei_pc_q, fencei_pc_next;
    assign dcache_flush_req = fencei_pending_q;
`else
    assign dcache_flush_req = 1'b0;
`endif
    logic fencei_block;
`ifdef NIIGO_DSIDE_WB
    assign fencei_block = fencei_pending_q;
`else
    assign fencei_block = 1'b0;
`endif
    logic unused_flush_done;
    assign unused_flush_done = dcache_flush_done;

    // ============================ Device bus ============================
    // By default each core owns private CLINT/PLIC/UART instances. With
    // NIIGO_EXT_DEVICES (M4 SMP) they are lifted to ONE shared instance at the
    // SMP top: this core exports its snoop/load-query ports and imports the
    // shared device result/mtime/IRQs. The external result rides the clint_*
    // carriers so the data_load mux and the priv_csr_file wiring are unchanged.
`ifdef NIIGO_EXT_DEVICES
    assign dsnoop_store_en    = dmem_store_fire;
    assign dsnoop_store_waddr = dmem_req_addr;
    assign dsnoop_store_wdata = dmem_req_wdata;
    assign dsnoop_store_mask  = dmem_req_wmask;
    assign dsnoop_load_addr   = dmem_resp_addr;
    assign dsnoop_load_en     = dmem_resp_valid;
    assign dsnoop_load_off    = dev_load_off;
    // Shared-device load result rides the clint_* carrier (plic/uart unused here).
    assign clint_load_hit  = ext_load_hit;
    assign clint_load_data = ext_load_data;
    assign plic_load_hit   = 1'b0;  assign plic_load_data = '0;
    assign uart_load_hit   = 1'b0;  assign uart_load_data = '0;
    assign uart_irq        = 1'b0;
    assign clint_mtime     = ext_mtime;
    assign irq_mtimer      = ext_irq_m_timer;
    assign irq_msoft       = ext_irq_m_software;
    assign plic_m_ext      = ext_irq_m_external;
    assign plic_s_ext      = ext_irq_s_external;
`else
    // Minimal CLINT: snoops committed stores for mtimecmp / msip.
    clint Clint (
        .clk,
        .rst_l,
        .store_en(dmem_store_fire),
        .store_waddr(dmem_req_addr),
        .store_wdata(dmem_req_wdata),
        .store_mask(dmem_req_wmask),
        // Look up against the returned-load address so a CLINT hit lines up with
        // the load result the LSQ consumes (loads complete with latency).
        .load_addr(dmem_resp_addr),
        .load_hit(clint_load_hit),
        .load_data(clint_load_data),
        .irq_m_timer(irq_mtimer),
        .irq_m_software(irq_msoft),
        .mtime_out(clint_mtime)
    );

    // PLIC: external-interrupt controller (ctx0 = M-external, ctx1 = S-external).
    // No device sources are wired yet (src_irq = 0); software injects pending via
    // a write to the pending word. Drives mip.MEIP / mip.SEIP.
    // UART interrupt drives PLIC source 10 (the conventional NS16550 line); all
    // other device sources are still software-injected via the pending word.
    logic [31:0] plic_src;
    always_comb begin
        plic_src = 32'b0;
        plic_src[10] = uart_irq;
    end
    plic Plic (
        .clk,
        .rst_l,
        .src_irq(plic_src),
        .store_en(dmem_store_fire),
        .store_waddr(dmem_req_addr),
        .store_wdata(dmem_req_wdata),
        .store_mask(dmem_req_wmask),
        .load_addr(dmem_resp_addr),
        .load_en(dmem_resp_valid),
        .load_off(dev_load_off),
        .load_hit(plic_load_hit),
        .load_data(plic_load_data),
        .irq_m_external(plic_m_ext),
        .irq_s_external(plic_s_ext)
    );

    // NS16550-subset UART -> simulation console (base 0x0D00_0000, in the device
    // hole; 0x1000_0000 is arch-test RAM). Snoops the data store port like the
    // CLINT/PLIC; its loads mux into the LSQ writeback.
    uart Uart (
        .clk,
        .rst_l,
        .store_en(dmem_store_fire),
        .store_waddr(dmem_req_addr),
        .store_wdata(dmem_req_wdata),
        .store_mask(dmem_req_wmask),
        .load_addr(dmem_resp_addr),
        .load_en(dmem_resp_valid),
        .load_off(dev_load_off),
        .load_hit(uart_load_hit),
        .load_data(uart_load_data),
        .irq(uart_irq)
`ifdef FPGA_BUILD
        ,
        .vuart_tx_valid, .vuart_tx_byte,
        .vuart_rx_valid, .vuart_rx_byte, .vuart_rx_pop
`endif
    );
`endif

    // ===================== Sv32 MMU (Phase 4) =====================
    // satp / mstatus-derived translation context. Identical to the scalar core.
    logic        satp_mode;
    logic [RISCV_Priv::VM_PPN_W-1:0]  satp_ppn;
    logic [RISCV_Priv::VM_ASID_W-1:0] satp_asid;
    logic        mstatus_mprv, mstatus_sum, mstatus_mxr;
    RISCV_Priv::priv_mode_t mpp_mode, priv_data;
    logic        paging_fetch, paging_data;

`ifdef RV64
    // Sv39 satp layout: MODE[63:60] (8 = Sv39), ASID[59:44], PPN[43:0].
    assign satp_mode    = (csr_satp[63:60] == 4'd8);
    assign satp_ppn     = csr_satp[43:0];
    assign satp_asid    = csr_satp[59:44];
`else
    assign satp_mode    = csr_satp[31];
    assign satp_ppn     = csr_satp[21:0];
    assign satp_asid    = csr_satp[30:22];
`endif
    assign mstatus_mprv = csr_mstatus[RISCV_Priv::MSTATUS_MPRV_BIT];
    assign mstatus_sum  = csr_mstatus[RISCV_Priv::MSTATUS_SUM_BIT];
    assign mstatus_mxr  = csr_mstatus[RISCV_Priv::MSTATUS_MXR_BIT];
    assign mpp_mode     = RISCV_Priv::priv_mode_t'(csr_mstatus[RISCV_Priv::MSTATUS_MPP_LO+:2]);
    assign priv_data    = mstatus_mprv ? mpp_mode : cur_priv;
    assign paging_fetch = satp_mode && (cur_priv  != RISCV_Priv::PRIV_M);
    assign paging_data  = satp_mode && (priv_data != RISCV_Priv::PRIV_M);

    // TLB flush: SFENCE.VMA or any satp write (driven in the commit block).
    logic tlb_flush;

    // Compute an XLEN-capped physical byte address from a leaf translation
    // found at the given level (level > 0 substitutes the VA's low VPN slices
    // into the superpage's PPN).
    function automatic logic [XLEN-1:0] make_pa(
            input logic [RISCV_Priv::VM_PPN_W-1:0] ppn,
            input logic [1:0] level, input logic [XLEN-1:0] va);
`ifdef RV64
        unique case (level)
            2'd2:    make_pa = {8'b0, ppn[43:18], va[29:0]};  // 1 GiB
            2'd1:    make_pa = {8'b0, ppn[43:9],  va[20:0]};  // 2 MiB
            default: make_pa = {8'b0, ppn,        va[11:0]};  // 4 KiB
        endcase
`else
        if (level != 2'd0) make_pa = {ppn[19:10], va[21:0]};  // 4 MiB
        else               make_pa = {ppn[19:0],  va[11:0]};  // 4 KiB
`endif
    endfunction

    // Leaf-PTE permission fault (excludes A/D, which trigger a re-walk).
    function automatic logic perm_bad(input logic [7:0] perm,
            input logic [1:0] acc, input RISCV_Priv::priv_mode_t pr,
            input logic sum, input logic mxr);
        logic fail;
        fail = 1'b0;
        unique case (acc)
            2'd0: if (!perm[RISCV_Priv::PTE_X]) fail = 1'b1;
            2'd1: if (!(perm[RISCV_Priv::PTE_R] ||
                       (perm[RISCV_Priv::PTE_X] && mxr))) fail = 1'b1;
            2'd2: if (!perm[RISCV_Priv::PTE_W]) fail = 1'b1;
            default: ;
        endcase
        if (pr == RISCV_Priv::PRIV_U) begin
            if (!perm[RISCV_Priv::PTE_U]) fail = 1'b1;
        end else if (pr == RISCV_Priv::PRIV_S) begin
            if (perm[RISCV_Priv::PTE_U]) begin
                if (acc == 2'd0) fail = 1'b1;
                else if (!sum)   fail = 1'b1;
            end
        end
        perm_bad = fail;
    endfunction

    // --- Data-side translation request exposed by the load/store queue ---
    logic        mem_req_valid;
    logic [XLEN-1:0] mem_req_vaddr;
    logic        mem_req_store;
    logic [1:0]  data_acc;
    assign data_acc = mem_req_store ? 2'd2 : 2'd1;

    logic        data_noncanon, fetch_noncanon;
`ifdef RV64
    // Sv39 canonical check: VA bits [63:39] must all equal bit 38. A TLB
    // lookup truncates to VPN bits, so a non-canonical VA could falsely hit a
    // canonical entry -- gate the hit and walk the (faulting) access instead.
    assign data_noncanon  = paging_data &&
        (mem_req_vaddr[XLEN-1:39] != {(XLEN-39){mem_req_vaddr[38]}});
    assign fetch_noncanon = paging_fetch &&
        (pc_q[XLEN-1:39] != {(XLEN-39){pc_q[38]}});
`else
    assign data_noncanon  = 1'b0;
    assign fetch_noncanon = 1'b0;
`endif

    // --- DTLB ---
    logic        dtlb_hit;
    logic [1:0]  dtlb_level;
    logic [RISCV_Priv::VM_PPN_W-1:0] dtlb_ppn;
    logic [7:0]  dtlb_perm;
    logic        d_need_ad, dtlb_usable;
    assign d_need_ad   = !dtlb_perm[RISCV_Priv::PTE_A] ||
                         ((data_acc == 2'd2) && !dtlb_perm[RISCV_Priv::PTE_D]);
    // A non-canonical Sv39 VA must not use a (VPN-truncated) TLB hit; it goes
    // to the walker, which faults it.
    assign dtlb_usable = dtlb_hit && !d_need_ad && !data_noncanon;

    // --- Page-table walker (shared; data has priority over fetch) ---
    logic        ptw_req, ptw_done, ptw_fault, ptw_busy;
    logic [1:0]  ptw_level;
    logic        ptw_fault_access;       // PTW fault is a PMP-on-PTE access fault
    logic        ptw_pte_pmp_fault;      // PMP denies the in-flight PTE access
    logic        ptw_mem_is_write;       // in-flight PTE access is an A/D write
    logic [RISCV_Priv::VM_PPN_W-1:0] ptw_ppn;
    logic [7:0]  ptw_perm;
    logic [RISCV_Priv::VM_VPN_W-1:0] ptw_vpn;
    logic [RISCV_Priv::VM_VPN_W-1:0] ptw_walk_vpn; // VPN the walk was launched for
    logic        ptw_walk_is_data; // that walk is a data (vs fetch) access
    RISCV_Priv::priv_mode_t ptw_walk_priv;          // privilege the walk launched under
    logic [RISCV_Priv::VM_PPN_W-1:0] ptw_walk_satp; // satp.PPN the walk launched under
    logic [1:0]  ptw_access;
    RISCV_Priv::priv_mode_t ptw_priv;
    logic [XLEN-1:0] ptw_mem_addr;

    logic        itlb_hit;
    logic [1:0]  itlb_level;
    logic [RISCV_Priv::VM_PPN_W-1:0] itlb_ppn;
    logic [7:0]  itlb_perm;
    logic        data_need_walk, fetch_need_walk;
    logic        ptw_for_data;
    logic        itlb_usable;
    assign itlb_usable = itlb_hit && !fetch_noncanon;
    assign data_need_walk  = paging_data && mem_req_valid && !dtlb_usable;
    assign fetch_need_walk = paging_fetch && !itlb_usable;
    // Data accesses have priority over instruction fetch for the shared walker.
    assign ptw_for_data = data_need_walk;
    assign ptw_req    = data_need_walk || fetch_need_walk;
    assign ptw_vpn    = ptw_for_data ?
        mem_req_vaddr[RISCV_Priv::VM_VPN_W+11:12] :
        pc_q[RISCV_Priv::VM_VPN_W+11:12];
    assign ptw_access = ptw_for_data ? data_acc : 2'd0;
    assign ptw_priv   = ptw_for_data ? priv_data : cur_priv;

    ptw PTW (
        .clk, .rst_l,
        .req_valid(ptw_req),
        .req_vpn(ptw_vpn),
        .satp_ppn(satp_ppn),
        .req_access(ptw_access),
        .req_priv(ptw_priv),
        .mstatus_sum(mstatus_sum),
        .mstatus_mxr(mstatus_mxr),
        .adue(csr_menvcfg_adue),
        .req_noncanonical(ptw_for_data ? data_noncanon : fetch_noncanon),
        .mem_req(ptw_mem_req),
        .mem_we(ptw_mem_we),
        .mem_is_write(ptw_mem_is_write),
        .mem_addr(ptw_mem_addr),
        .mem_wdata(ptw_mem_wdata),
        .mem_ack(ptw_mem_ack),
        .mem_rdata(ptw_mem_rdata),
        .pte_pmp_fault(ptw_pte_pmp_fault),
        .busy(ptw_busy),
        .done(ptw_done),
        .fault(ptw_fault),
        .fault_access(ptw_fault_access),
        .ppn(ptw_ppn),
        .perm(ptw_perm),
        .leaf_level(ptw_level),
        .walk_vpn(ptw_walk_vpn),
        .walk_is_data(ptw_walk_is_data),
        .walk_priv(ptw_walk_priv),
        .walk_satp(ptw_walk_satp)
    );
    // A completed walk's result (resolved PA or fault) may be consumed only by an
    // access whose full translation request -- (VPN, satp.PPN, privilege) --
    // matches the one the walk was launched for. Fetches/loads are speculative, so
    // a walk can outlive its request: a mispredicted fetch of an unmapped VA
    // launches a walk that faults at the page-table root, and without the VPN
    // check the architectural fetch of a *different, valid* VPN in the same
    // address space adopts that root fault -> spurious page fault (this crashed
    // /sh at 0xd8c, the insn after the sret from its first syscall). walk_priv /
    // walk_satp additionally reject a walk launched in another mode / address
    // space (e.g. a speculative S-mode fetch of a user VA in a trap window,
    // walking the kernel page table). The TLB *fills* already key on walk_vpn;
    // this extends the same precision to the immediate PA/fault consumption.
    logic ptw_ctx_fetch, ptw_ctx_data;
    assign ptw_ctx_fetch =
        (ptw_walk_vpn  == pc_q[RISCV_Priv::VM_VPN_W+11:12]) &&
        (ptw_walk_priv == cur_priv) && (ptw_walk_satp == satp_ppn);
    assign ptw_ctx_data  =
        (ptw_walk_vpn  == mem_req_vaddr[RISCV_Priv::VM_VPN_W+11:12]) &&
        (ptw_walk_priv == priv_data) && (ptw_walk_satp == satp_ppn);
    assign ptw_mem_addr_w = ptw_mem_addr[XLEN-1:ADDR_SHIFT];

    // PMP on the implicit PTE access. Per the priv spec these accesses are checked
    // as Supervisor (reads need R, A/D writes need W); a violation aborts the walk
    // and surfaces as an access fault of the original access type (handled below).
    pmp_checker PtwPMP (
        .paddr(ptw_mem_addr),
        .access(ptw_mem_is_write ? 2'd2 : 2'd1),
        .priv(RISCV_Priv::PRIV_S),
        .pmpcfg(csr_pmpcfg_arr),
        .pmpaddr(csr_pmpaddr_arr),
        .fault(ptw_pte_pmp_fault)
    );

    mmu_tlb #(.ENTRIES(16)) ITLB (
        .clk, .rst_l,
        .lookup_en(paging_fetch),
        .lookup_vpn(pc_q[RISCV_Priv::VM_VPN_W+11:12]),
        .lookup_asid(satp_asid),
        .hit(itlb_hit), .hit_ppn(itlb_ppn), .hit_perm(itlb_perm),
        .hit_level(itlb_level),
        // Fill against the VPN the PTW actually walked, gated by the walk's
        // latched class -- not the live fetch/data head, which may have moved.
        .fill_en(ptw_done && !ptw_fault && !ptw_walk_is_data),
        .fill_vpn(ptw_walk_vpn),
        .fill_asid(satp_asid),
        .fill_ppn(ptw_ppn), .fill_perm(ptw_perm), .fill_level(ptw_level),
        .flush_en(tlb_flush)
    );

    mmu_tlb #(.ENTRIES(16)) DTLB (
        .clk, .rst_l,
        .lookup_en(paging_data && mem_req_valid),
        .lookup_vpn(mem_req_vaddr[RISCV_Priv::VM_VPN_W+11:12]),
        .lookup_asid(satp_asid),
        .hit(dtlb_hit), .hit_ppn(dtlb_ppn), .hit_perm(dtlb_perm),
        .hit_level(dtlb_level),
        .fill_en(ptw_done && !ptw_fault && ptw_walk_is_data),
        .fill_vpn(ptw_walk_vpn),
        .fill_asid(satp_asid),
        .fill_ppn(ptw_ppn), .fill_perm(ptw_perm), .fill_level(ptw_level),
        .flush_en(tlb_flush)
    );

    // --- Resolve the data physical address + fault/stall for the LSQ ---
    logic        data_from_ptw;
    logic [XLEN-1:0] data_pa;
    logic        data_perm_fault;
    logic        lsq_xlate_stall, lsq_xlate_fault;
    logic [4:0]  lsq_xlate_cause;
    // Consume the completed walk's result by its *latched* class, exactly as
    // the TLB fills do (ptw_walk_is_data, not the combinational ptw_for_data).
    // ptw_for_data tracks the *current* head's want; if a fetch walk completes
    // on a cycle when a data access has *newly* started wanting a walk,
    // ptw_for_data=1 but the result belongs to the fetch walk. Gating on the
    // latched class keeps the data load from grabbing a fetch walk's PPN (which
    // mistranslated VA 0x800096f0 -> PA 0x800076f0 and corrupted a syscall ptr).
    assign data_from_ptw = ptw_done && !ptw_fault && ptw_walk_is_data && ptw_ctx_data;
    always_comb begin
        if (!paging_data)        data_pa = mem_req_vaddr;
        else if (dtlb_usable)    data_pa = make_pa(dtlb_ppn, dtlb_level, mem_req_vaddr);
        else if (data_from_ptw)  data_pa = make_pa(ptw_ppn, ptw_level, mem_req_vaddr);
        else                     data_pa = mem_req_vaddr;
    end
    assign data_perm_fault =
        (dtlb_usable && perm_bad(dtlb_perm, data_acc, priv_data,
            mstatus_sum, mstatus_mxr)) ||
        (data_need_walk && ptw_walk_is_data && ptw_done && ptw_fault && ptw_ctx_data);
    // PMP on the resolved data physical address (checked in any mode, on the
    // post-translation PA). Only meaningful once the PA is resolved -- during a
    // walk data_pa is the (stale) VA fallback, so gate the PMP fault on a
    // resolved PA. A translation page fault takes priority over a PMP fault.
    logic        data_pa_resolved, pmp_data_fault;
    assign data_pa_resolved = !paging_data || dtlb_usable || data_from_ptw;
    pmp_checker DataPMP (
        .paddr(data_pa),
        .access(data_acc),
        .priv(priv_data),
        .pmpcfg(csr_pmpcfg_arr),
        .pmpaddr(csr_pmpaddr_arr),
        .fault(pmp_data_fault)
    );
    assign lsq_xlate_fault = mem_req_valid &&
        ((paging_data && data_perm_fault) ||
         (data_pa_resolved && pmp_data_fault));
    assign lsq_xlate_stall = paging_data && mem_req_valid &&
        !dtlb_usable && !data_from_ptw && !data_perm_fault;
    // A PMP fault on a PTE access during a data walk is an access fault, not a
    // page fault (priv spec); it overrides the page-fault cause below.
    logic data_ptw_access_fault;
    assign data_ptw_access_fault =
        data_need_walk && ptw_walk_is_data && ptw_done && ptw_fault && ptw_fault_access &&
        ptw_ctx_data;
    // Page fault (translation) reported ahead of a PMP access fault.
    assign lsq_xlate_cause =
        (paging_data && data_perm_fault && !data_ptw_access_fault) ?
            (mem_req_store ? RISCV_Priv::EXC_STORE_PAGE_FAULT
                           : RISCV_Priv::EXC_LOAD_PAGE_FAULT) :
            (mem_req_store ? RISCV_Priv::EXC_STORE_ACCESS
                           : RISCV_Priv::EXC_LOAD_ACCESS);
    // A returning load no longer needs address matching against the head: the
    // LSQ allows exactly one load outstanding at the data port and tracks it
    // (mem_inflight / mem_inflight_kill in load_store_queue.sv), so a response
    // belongs to that single request by construction, for any memory latency.
    // This replaces the old DMEMORY_READ_DELAY-deep VA match pipe, which baked
    // the fixed magic-memory latency into the core.

    // --- Resolve the fetch physical address + stall during a fetch walk ---
    logic        fetch_from_ptw, ptw_fetch_done;
    logic        fetch_xlate_stall;
    // Latched-class gating (mirrors the ITLB fill), not combinational ptw_for_data:
    // a fetch walk's completion must be consumed by the fetch path even on a cycle
    // when a data access is concurrently requesting a walk.
    assign fetch_from_ptw = ptw_done && !ptw_fault && !ptw_walk_is_data && ptw_ctx_fetch;
    assign ptw_fetch_done = ptw_done && !ptw_walk_is_data && ptw_ctx_fetch;
    always_comb begin
        if (!paging_fetch)       fetch_pa = pc_q;
        else if (itlb_usable)    fetch_pa = make_pa(itlb_ppn, itlb_level, pc_q);
        else if (fetch_from_ptw) fetch_pa = make_pa(ptw_ppn, ptw_level, pc_q);
        else                     fetch_pa = pc_q;
    end
    // Freeze the frontend while the walker resolves the fetch translation.
    assign fetch_xlate_stall = fetch_need_walk && !ptw_fetch_done;

    // Instruction-fetch page fault: an ITLB hit lacking execute permission for
    // the current privilege, or a fetch page-table walk that faulted. Reported
    // precisely at commit on the faulting PC (see ooo_fetch_decode / alu_pipe);
    // mtval = faulting VA.
    logic fetch_perm_fault;
    assign fetch_perm_fault =
        (itlb_usable && perm_bad(itlb_perm, 2'd0, cur_priv,
            mstatus_sum, mstatus_mxr)) ||
        (fetch_need_walk && !ptw_walk_is_data && ptw_done && ptw_fault && ptw_ctx_fetch);
    // A PMP fault on a PTE access during a fetch walk is an instruction *access*
    // fault, not a page fault (priv spec) -- selects the cause below.
    logic fetch_ptw_access_fault;
    assign fetch_ptw_access_fault =
        fetch_need_walk && !ptw_walk_is_data && ptw_done && ptw_fault && ptw_fault_access &&
        ptw_ctx_fetch;

    // PMP on the resolved fetch PA (any mode). Gated on a resolved PA so the
    // (stale VA) fallback during a walk is not checked; page fault wins over PMP.
    // A 16-byte fetch block can span multiple PMP regions, so each of the up-to-4
    // fetched words is PMP-checked independently (translation/exec-permission are
    // page-granular and identical across the block). fetch_fault_lane[i] is the
    // fault for decode lane i (VA pc_q + 4*i; same page, so PA = fetch_pa + 4*i).
    logic fetch_pa_resolved;
    logic [OOO_WIDTH-1:0] pmp_fetch_fault_lane;
    logic [OOO_WIDTH-1:0] fetch_lane_in_block;
    assign fetch_pa_resolved = !paging_fetch || itlb_usable || fetch_from_ptw;
    genvar fpl;
    generate
        for (fpl = 0; fpl < OOO_WIDTH; fpl += 1) begin : fetch_pmp_gen
            pmp_checker FetchPMP (
`ifdef RVC
                // RV64C: check the ABSOLUTE 4-byte word fpl of the 16-byte block
                // (block-aligned base), so fault_lane[w] is word w regardless of
                // the entry offset -- the realigner maps parcel s -> word s>>1.
                .paddr({fetch_pa[XLEN-1:4], 4'b0} + (fpl * 32'd4)),
`else
                .paddr(fetch_pa + (fpl * 32'd4)),
`endif
                .access(2'd0),
                .priv(cur_priv),
                .pmpcfg(csr_pmpcfg_arr),
                .pmpaddr(csr_pmpaddr_arr),
                .fault(pmp_fetch_fault_lane[fpl])
            );
            // Lane fpl is part of this block only if it lies within the 16-byte
            // fetch window starting at pc_q's offset; otherwise it is a different
            // block and must not contribute a fault.
            assign fetch_lane_in_block[fpl] =
                (int'(pc_q[3:2]) + fpl) < OOO_WIDTH;
        end
    endgenerate

    // Page/exec-permission faults are page-granular -> collapse onto lane 0;
    // PMP faults are per word. fetch_fault retains its group-level meaning (any
    // lane faults) for the existing frontend-stall/redirect logic.
    always_comb begin
`ifdef RVC
        // Absolute per-4B-word fault for the whole 16-byte block. A page/exec
        // fault covers the entire (single-page) block -> all words fault, so
        // whichever parcel the entry instruction sits at is caught; PMP faults
        // are already per absolute word (no entry-offset mask under RVC).
        if (paging_fetch && fetch_perm_fault)
            fetch_fault_lane = {OOO_WIDTH{1'b1}};
        else if (fetch_pa_resolved)
            fetch_fault_lane = pmp_fetch_fault_lane;
        else
            fetch_fault_lane = '0;
`else
        if (paging_fetch && fetch_perm_fault)
            fetch_fault_lane = {{(OOO_WIDTH-1){1'b0}}, 1'b1};
        else if (fetch_pa_resolved)
            fetch_fault_lane = pmp_fetch_fault_lane & fetch_lane_in_block;
        else
            fetch_fault_lane = '0;
`endif
    end
    assign fetch_fault = |fetch_fault_lane;
    assign fetch_fault_cause =
        (paging_fetch && fetch_perm_fault && !fetch_ptw_access_fault) ?
        RISCV_Priv::EXC_INSTR_PAGE_FAULT : RISCV_Priv::EXC_INSTR_ACCESS;

    branch_stack BranchStack (
        .clk,
        .rst_l,
        .allocate(branch_allocate),
        .active_tail_snapshot(branch_active_tail_snapshot),
        .free_head_snapshot(branch_free_head_snapshot),
        .free_tail_snapshot(branch_free_tail_snapshot),
        .free_count_snapshot(branch_free_count_snapshot),
        .map_snapshot(branch_map_snapshot),
        .resolve(branch_resolve_valid),
        .resolve_id(branch_resolve_id),
        .mispredict(branch_resolve_mispredict),
        .flush(trap_take),
        .full(branch_stack_full),
        .allocate_valid(branch_allocate_valid),
        .allocate_id(branch_allocate_id),
        .current_mask(current_branch_mask),
        .restore_valid(branch_restore_valid),
        .restore_active_tail(branch_restore_active_tail),
        .restore_free_head(branch_restore_free_head),
        .restore_free_tail(branch_restore_free_tail),
        .restore_free_count(branch_restore_free_count),
        .restore_map(branch_restore_map),
        .reset_mask(stack_reset_mask),
        .abort_mask(stack_abort_mask)
    );

    tage_sc_l_predictor #(.HISTORY_BITS(DIRECT_HISTORY_BITS)) DirectBranchPredictor (
        .clk,
        .rst_l,
        .lookup_valid(direct_lookup_valid),
        .lookup_pc(direct_lookup_pc),
        .history(ghr_q),
        .prediction(direct_prediction),
        .prediction_info(direct_prediction_info),
        .update_valid(branch_writeback.valid && branch_writeback.branch_valid &&
`ifdef FUSE_BRANCH
            // A fused master resolves the folded slave branch: train with the
            // SLAVE's identity (the master's .instr is not a branch encoding).
            ((branch_writeback.instr[6:0] == RISCV_ISA::OP_BRANCH) ||
             (branch_writeback.fuse_is_branch &&
              branch_writeback.fuse_branch_instr[6:0] == RISCV_ISA::OP_BRANCH))),
`else
            (branch_writeback.instr[6:0] == RISCV_ISA::OP_BRANCH)),
`endif
`ifdef FUSE_BRANCH
        .update_pc(branch_writeback.fuse_is_branch ?
            branch_writeback.fuse_branch_pc : branch_writeback.pc),
        .update_taken(branch_writeback.redirect_pc !=
            ((branch_writeback.fuse_is_branch ?
                branch_writeback.fuse_branch_pc : branch_writeback.pc)
             + `ILEN_INC(branch_writeback.fuse_is_branch ?
                 branch_writeback.fuse_is_compressed :
                 branch_writeback.is_compressed))),
`else
        .update_pc(branch_writeback.pc),
        .update_taken(branch_writeback.redirect_pc !=
            (branch_writeback.pc + `ILEN_INC(branch_writeback.is_compressed))),
`endif
        .update_info(branch_writeback.predictor_info)
    );

    ittage_predictor IndirectBranchPredictor (
        .clk,
        .rst_l,
        .lookup_valid(indirect_lookup_valid),
        .lookup_pc(indirect_lookup_pc),
        .prediction_valid(indirect_prediction_valid),
        .prediction_target(indirect_prediction_target),
        .prediction_info(indirect_prediction_info),
        .update_valid(branch_writeback.valid && branch_writeback.branch_valid &&
            (branch_writeback.instr[6:0] == RISCV_ISA::OP_JALR) &&
            !((branch_writeback.instr[19:15] == 5'd1) &&
              (branch_writeback.instr[11:7] == 5'd0))),
        .update_target(branch_writeback.redirect_pc),
        .update_info(branch_writeback.predictor_info)
    );

`ifdef FUSE_BRANCH
    // Fused-pair atomicity (shared-infra §4b): a fuse-master whose folded slave
    // is a branch (CMPBR/LDBR kinds) must stall WITH the branch-stack-full slave
    // so the pair dispatches together or not at all. Decode-derived (fuse_master/
    // fuse_kind_lane read decode_lanes only) — no dispatch_valid feedback loop.
    for (genvar fuse_gi = 0; fuse_gi < OOO_WIDTH; fuse_gi += 1) begin : gen_fuse_pre_branch
        assign lane_fuse_pre_branch[fuse_gi] = fuse_master[fuse_gi] &&
            ((fuse_kind_lane[fuse_gi] == FUSE_K_CMPBR) ||
             (fuse_kind_lane[fuse_gi] == FUSE_K_LDBR));
    end
`endif

    ooo_dispatch_control DispatchControl (
        .lane_valid,
        .lane_has_dest,
        .lane_is_branch,
`ifdef JAL_NO_CKPT
        .lane_needs_ckpt,
`endif
`ifdef FUSE_BRANCH
        .lane_fuse_pre_branch,
`endif
        .lane_is_memory,
        .lane_is_terminal,
        .lane_is_serializing,
        .lane_is_fp,
        .lane_fp_src_busy,
        .active_list_full(active_full),
        .int_iq_full(int_iq_full),
        .mem_queue_full(mem_queue_full),
        .branch_stack_full(branch_stack_full),
        .free_list_can_allocate(free_can_allocate),
        .free_list_available(free_count_snapshot),
        .suppress_dispatch(redirect_valid || terminal_pending_q ||
            control_pending_q || serial_pending_q || halted_q || irq_drain_q ||
            wfi_wait_q || commit_take_trap || fencei_block || predict_stall ||
            fflags_drain_stall),
        .dispatch_valid,
`ifdef DISPATCH_STATS
        .dstat_cut_valid,
        .dstat_cut_reason,
        .dstat_cut_idx,
        .dstat_stall_reason,
`endif
        .dispatch_stall
    );

    active_list ActiveList (
`ifdef CSWHY
        .cswhy_head_id, .cswhy_head_present, .cswhy_head_class,
        .cswhy_head_done, .cswhy_head_pending, .cswhy_head_xclass_ok,
        .cswhy_head_count,
`endif
        .clk,
        .rst_l,
        .restore_valid(branch_restore_valid),
        .restore_tail(branch_restore_active_tail),
        .flush(trap_take),
        .allocate_valid(dispatch_valid),
        .allocate_packet(rename_packets),
        .writeback_valid(writeback_valid),
        .writeback_id(writeback_active_id),
        .writeback_data(writeback_data),
        .writeback_exception(writeback_exception),
        .writeback_exc_cause(writeback_exc_cause),
        .writeback_halted(writeback_halted),
        .writeback_fp_write,
        .writeback_fp_rd,
        .writeback_fp_data,
        .writeback_csr_write,
        .writeback_csr_addr,
        .writeback_csr_wdata,
        .writeback_fp_fflags_valid,
        .writeback_fp_fflags,
        .reset_mask,
        .abort_mask,
        .commit_taken(retire_valid),
        .full(active_full),
        .empty(active_empty),
        .tail(active_tail),
        .commit_valid(active_commit_valid),
        .commit_packet(active_commit_packet),
        .free_valid(active_free_valid),
        .free_prd(active_free_prd)
    );

    int_issue_queue IntIssueQueue (
`ifdef CSWHY
        .cswhy_probe_valid, .cswhy_probe_id(cswhy_head_id),
        .cswhy_iq_present, .cswhy_iq_ready, .cswhy_iq_picked, .cswhy_iq_multi,
`endif
        .clk,
        .rst_l,
        .insert_valid(int_insert_valid),
        .insert_entry(dispatch_issue_entries),
        .wakeup_valid,
        .wakeup_prd,
        .spec_wake_valid,
        .spec_wake_prd,
        .issue_ready(int_issue_ready),
        .reset_mask,
        .abort_mask,
        .flush(trap_take),
        .full(int_iq_full),
        .issue_valid(int_issue_valid),
        .issue_entry(int_issue_entry)
`ifdef LOAD_SPEC_WAKE
        ,
        .load_spec_wake_valid(lsq_load_spec_wake_valid),
        .load_spec_wake_prd  (lsq_load_spec_wake_prd),
        .ld_spec_hit,
        .ld_spec_miss,
        .issue_ld_spec(iq_issue_ld_spec)
`endif
    );

    // ---- Select -> Execute pipeline register (S2) for the ALU ports ----
    // The IQ select output (S1) is registered here; the ALU pipes, their phys-reg
    // reads, and the CSR reads all run from this registered copy (S2). An entry
    // aborted at its select cycle never enters S2 (branch_mask & abort_mask gate);
    // an entry aborted while in S2 is squashed by the ALU pipe's own abort handling
    // and by the spec_wake abort gate below. A pipeline flush (trap_take) forces
    // int_issue_valid to 0 in the IQ, which clears these registers next cycle.
    always_ff @(posedge clk or negedge rst_l) begin
        if (!rst_l) begin
            alu_issue_valid_q <= '0;
`ifdef LOAD_SPEC_WAKE
            alu_issue_ld_spec_q <= '0;
`endif
            for (int p = 0; p < ALU_ISSUE_PORTS; p += 1) begin
                alu_issue_entry_q[p] <= '0;
            end
        end else begin
            for (int p = 0; p < ALU_ISSUE_PORTS; p += 1) begin
                if (!trap_take && int_issue_valid[p] &&
                        ((int_issue_entry[p].branch_mask & abort_mask) == '0)) begin
                    alu_issue_valid_q[p] <= 1'b1;
                    alu_issue_entry_q[p] <= int_issue_entry[p];
`ifdef LOAD_SPEC_WAKE
                    alu_issue_ld_spec_q[p] <= iq_issue_ld_spec[p];
`endif
                end else begin
                    alu_issue_valid_q[p] <= 1'b0;
                    alu_issue_entry_q[p] <= '0;
`ifdef LOAD_SPEC_WAKE
                    alu_issue_ld_spec_q[p] <= 1'b0;
`endif
                end
            end
        end
    end

    // Speculative ALU wakeup: an ALU op executing in S2 broadcasts its dest a cycle
    // before its writeback bus appears (gated by abort -- a squashed producer must
    // not wake anyone). has_dest implies prd != 0.
    always_comb begin
        for (int p = 0; p < ALU_ISSUE_PORTS; p += 1) begin
`ifdef LOAD_SPEC_WAKE
            // LOAD_SPEC_WAKE grandchild suppression: a spec-woken consumer
            // whose load MISSED must not spec-wake a grandchild off stale data
            // this cycle -- the cascade is bounded to depth 1 by construction.
            // On a HIT the consumer spec-wakes normally (ALU chaining kept).
            spec_wake_valid[p] = alu_issue_valid_q[p] &&
                alu_issue_entry_q[p].has_dest &&
                ((alu_issue_entry_q[p].branch_mask & abort_mask) == '0) &&
                !(alu_issue_ld_spec_q[p] && ld_spec_miss);
`else
            spec_wake_valid[p] = alu_issue_valid_q[p] &&
                alu_issue_entry_q[p].has_dest &&
                ((alu_issue_entry_q[p].branch_mask & abort_mask) == '0);
`endif
            spec_wake_prd[p] = alu_issue_entry_q[p].prd;
        end
    end

`ifdef LOAD_SPEC_WAKE
    // LOAD_SPEC_WAKE: 1-deep broadcast tracker + the global hit/miss verdict.
    // Sole-outstanding at broadcast => a response this cycle is THIS load's
    // (a hit); its absence is the miss. Under trap_take the whole pipe flushes,
    // so cancel the pending bit (the S2 consumers are flushed too).
    always_ff @(posedge clk or negedge rst_l) begin
        if (!rst_l) begin
            ld_spec_pending_q <= 1'b0;
`ifdef LSQ_MLP2
            ld_spec_id_q <= '0;
`endif
        end else begin
            ld_spec_pending_q <= lsq_load_spec_wake_valid && !trap_take;
`ifdef LSQ_MLP2
            if (lsq_load_spec_wake_valid) begin
                ld_spec_id_q <= lsq_load_spec_wake_id;
            end
`endif
        end
    end
`ifdef LSQ_MLP2
    // Adversarial finding 1: resolve by the id the response NAMES, not raw
    // dmem_resp_valid -- a response for any other transaction must never read
    // as this load's hit. (Safe-by-construction today: the broadcast is gated
    // on inflight_count_q==0 and only one load issues per cycle, so the X+1
    // response can only be this load's -- the assertion below pins that LSQ
    // invariant so a future LSQ change cannot silently reintroduce the P3b
    // stale-data class.)
    assign ld_spec_hit  = ld_spec_pending_q && dmem_resp_valid &&
        (dmem_resp_id == ld_spec_id_q);
    assign ld_spec_miss = ld_spec_pending_q &&
        !(dmem_resp_valid && (dmem_resp_id == ld_spec_id_q));
`ifndef SYNTHESIS
    always_ff @(posedge clk) begin
        if (rst_l && ld_spec_pending_q && dmem_resp_valid) begin
            assert (dmem_resp_id == ld_spec_id_q) else
                $error("LOAD_SPEC_WAKE: dmem_resp_id %0d != spec id %0d (sole-outstanding invariant broken)",
                    dmem_resp_id, ld_spec_id_q);
        end
    end
`endif
`else
    // Base arm (single outstanding via mem_inflight_q): raw dmem_resp_valid.
    assign ld_spec_hit  = ld_spec_pending_q && dmem_resp_valid;
    assign ld_spec_miss = ld_spec_pending_q && !dmem_resp_valid;
`endif
`endif

    phys_reg_file #(.READ_PORTS(PHYS_READ_PORTS)) PhysRegFile (
        .clk,
        .rst_l,
        .rs1(phys_rs1),
        .rs2(phys_rs2),
        .write_valid(phys_write_valid),
        .write_prd(phys_write_prd),
        .write_data(phys_write_data),
        .rs1_data(phys_rs1_data),
        .rs2_data(phys_rs2_data)
    );

    ooo_alu_pipe ALU0 (
        .clk,
        .rst_l,
        .issue_valid(alu_issue_valid_q[0]),
        .issue_entry(alu_issue_entry_q[0]),
        .rs1_data(phys_rs1_data[0]),
        .rs2_data(phys_rs2_data[0]),
        .csr_rdata(csr_read_data[0]),
        .csr_illegal(csr_read_illegal[0]),
        .abort_mask,
        .flush(trap_take),
`ifdef LOAD_SPEC_WAKE
        .spec_squash(alu_issue_ld_spec_q[0] && ld_spec_miss),
`endif
        .writeback(alu0_writeback)
    );

    ooo_alu_pipe ALU1 (
        .clk,
        .rst_l,
        .issue_valid(alu_issue_valid_q[1]),
        .issue_entry(alu_issue_entry_q[1]),
        .rs1_data(phys_rs1_data[1]),
        .rs2_data(phys_rs2_data[1]),
        .csr_rdata(csr_read_data[1]),
        .csr_illegal(csr_read_illegal[1]),
        .abort_mask,
        .flush(trap_take),
`ifdef LOAD_SPEC_WAKE
        .spec_squash(alu_issue_ld_spec_q[1] && ld_spec_miss),
`endif
        .writeback(alu1_writeback)
    );

    assign int_issue_ready[ISSUE_ALU0] = 1'b1;
    assign int_issue_ready[ISSUE_ALU1] = 1'b1;

`ifdef ALU4
    // 3rd integer ALU issue port. Mirrors ALU0/ALU1 (S2-registered issue + phys
    // read at index ISSUE_ALU2, auto-routed by the parameterized fan-outs); CSR is
    // tied off since the priv CSR file has only 2 read ports (the IQ N-pick keeps
    // CSR ops on ALU0/ALU1 via sel_csr).
    ooo_alu_pipe ALU2 (
        .clk,
        .rst_l,
        .issue_valid(alu_issue_valid_q[ISSUE_ALU2]),
        .issue_entry(alu_issue_entry_q[ISSUE_ALU2]),
        .rs1_data(phys_rs1_data[ISSUE_ALU2]),
        .rs2_data(phys_rs2_data[ISSUE_ALU2]),
        .csr_rdata('0),
        .csr_illegal(1'b0),
        .abort_mask,
        .flush(trap_take),
`ifdef LOAD_SPEC_WAKE
        .spec_squash(alu_issue_ld_spec_q[ISSUE_ALU2] && ld_spec_miss),
`endif
        .writeback(alu2_writeback)
    );
    assign int_issue_ready[ISSUE_ALU2] = 1'b1;
`endif

    ooo_mul_unit MulUnit (
`ifdef CSWHY
        .cswhy_probe_valid, .cswhy_probe_id(cswhy_head_id),
        .cswhy_fu_busy(cswhy_mul_busy), .cswhy_fu_wb(cswhy_mul_wb),
`endif
        .clk,
        .rst_l,
        .issue_valid(int_issue_valid[ISSUE_MUL]),
        .issue_ready(int_issue_ready[ISSUE_MUL]),
        .issue_entry(int_issue_entry[ISSUE_MUL]),
        .rs1_data(phys_rs1_data[ISSUE_MUL]),
        .rs2_data(phys_rs2_data[ISSUE_MUL]),
        .abort_mask,
        .reset_mask,
        .flush(trap_take),
        .writeback_ready(mul_writeback_ready),
        .writeback(mul_writeback)
    );

    ooo_div_unit DivUnit (
`ifdef CSWHY
        .cswhy_probe_valid, .cswhy_probe_id(cswhy_head_id),
        .cswhy_fu_busy(cswhy_div_busy), .cswhy_fu_wb(cswhy_div_wb),
`endif
        .clk,
        .rst_l,
        .issue_valid(int_issue_valid[ISSUE_DIV]),
        .issue_ready(int_issue_ready[ISSUE_DIV]),
        .issue_entry(int_issue_entry[ISSUE_DIV]),
        .rs1_data(phys_rs1_data[ISSUE_DIV]),
        .rs2_data(phys_rs2_data[ISSUE_DIV]),
        .abort_mask,
        .reset_mask,
        .flush(trap_take),
        .writeback_ready(div_writeback_ready),
        .writeback(div_writeback)
    );

    niigo_fp_unit FpUnit (
`ifdef CSWHY
        .cswhy_probe_valid, .cswhy_probe_id(cswhy_head_id),
        .cswhy_fu_busy(cswhy_fp_busy), .cswhy_fu_wb(cswhy_fp_wb),
`endif
        .clk,
        .rst_l,
        .issue_valid(int_issue_valid[ISSUE_FP]),
        .issue_ready(int_issue_ready[ISSUE_FP]),
        .issue_entry(int_issue_entry[ISSUE_FP]),
        .rs1_data(phys_rs1_data[ISSUE_FP]),
        .frm(csr_frm),
        .abort_mask,
        .reset_mask,
        .flush(trap_take),
        .writeback_ready(fp_writeback_ready),
        .writeback(fp_writeback)
    );

`ifdef FUSE_LDBR
    // ---- FUSE_LDBR: pend_fbr — the 1-deep fused-branch-resolve buffer ----
    // The LSQ emits fused_resolve_* combinationally in the fused load's
    // final-beat retire; the fused-issue gate (load_store_queue) guarantees
    // pend_fbr is EMPTY at that moment, so the capture never clobbers. The
    // buffered resolve seats onto the writeback bus as the WB_FBR source ONLY
    // when no ALU branch resolves (branch_stack has ONE resolve port) and a WB
    // lane is free — completion + resolve + drain are atomic (spec blocker 3).
    always_comb begin
        pend_fbr_next = pend_fbr_q;
        // Spec blocker 1: age the held mask by reset_mask EVERY cycle (the
        // ooo_mul_unit.sv:86-87 contract) — a missed 1-cycle reset pulse would
        // leave a stale bit that later false-aborts on a reused checkpoint.
        pend_fbr_next.branch_mask = pend_fbr_q.branch_mask & ~reset_mask;
        // Drain: seated+resolved (or abort-dropped) by the WB bus this cycle.
        if (pend_fbr_drain_ready)
            pend_fbr_next = '0;
        // Capture (slot guaranteed free by the LSQ fused-issue gate). The
        // packet retires the BRANCH's own ROB slot (2-slot model; has_dest=0)
        // and drives the resolve with the slave's prediction/training identity
        // (the fuse_* fields, like the FUSE_CMPBR master's writeback).
        if (fused_resolve_valid) begin
            pend_fbr_next                  = '0;
            pend_fbr_next.valid            = 1'b1;
            pend_fbr_next.active_id        = fused_resolve_active_id;
            pend_fbr_next.pc               = fused_resolve_pc;
            pend_fbr_next.instr            = fused_resolve_instr; // OP_BRANCH => trains
            pend_fbr_next.has_dest         = 1'b0;
            pend_fbr_next.branch_mask      = fused_resolve_branch_mask & ~reset_mask;
            pend_fbr_next.branch_valid     = 1'b1;
            pend_fbr_next.branch_id        = fused_resolve_branch_id;
            pend_fbr_next.branch_mispredict= fused_resolve_mispredict;
            pend_fbr_next.redirect_pc      = fused_resolve_redirect_pc;
            pend_fbr_next.control_predicted= fused_resolve_ctrl_pred;
            pend_fbr_next.predicted_pc     = fused_resolve_pred_pc;
            pend_fbr_next.predictor_info   = fused_resolve_pred_info;
            pend_fbr_next.exception        = 1'b0;
            pend_fbr_next.fuse_is_branch     = 1'b1;
            pend_fbr_next.fuse_branch_pc     = fused_resolve_pc;
            pend_fbr_next.fuse_branch_instr  = fused_resolve_instr;
            pend_fbr_next.fuse_is_compressed = fused_resolve_is_comp;
            pend_fbr_next.is_compressed      = fused_resolve_is_comp;
        end
        // Spec blocker 3: abort a buffered (or just-captured) resolve whose
        // older branch mispredicts this cycle (comb abort_mask — the same
        // contract the mul/div/FP in-flight ops follow).
        if (pend_fbr_next.valid &&
                ((pend_fbr_next.branch_mask & abort_mask) != '0))
            pend_fbr_next = '0;
        // Spec blocker 2: a precise trap flushes everything (ooo_mul_unit.sv:77
        // takes flush=trap_take) — a stale resolve would corrupt the trap's
        // full-pipeline flush.
        if (trap_take)
            pend_fbr_next = '0;
    end

    always_ff @(posedge clk or negedge rst_l) begin
        if (!rst_l) pend_fbr_q <= '0;
        else        pend_fbr_q <= pend_fbr_next;
    end

    assign pend_fbr_full = pend_fbr_q.valid;
    // Drive gate (mirrors the ALU pipe's internal abort/flush suppression): a
    // same-cycle-aborted or trap-flushed resolve never seats/resolves; the
    // next-state logic above drops it.
    always_comb begin
        fbr_writeback = pend_fbr_q;
        if (((pend_fbr_q.branch_mask & abort_mask) != '0) || trap_take)
            fbr_writeback.valid = 1'b0;
    end
`endif

    load_store_queue #(.COHERENT(COHERENT)) LoadStoreQueue (
`ifdef CSWHY
        .cswhy_lsq_head_id, .cswhy_lsq_head_valid, .cswhy_lsq_reason,
`endif
        .clk,
        .rst_l,
        .insert_valid(mem_insert_valid),
        .insert_entry(dispatch_issue_entries),
        .insert_rs1_data(mem_insert_rs1_data),
        .insert_rs2_data(mem_insert_rs2_data),
        .wakeup_valid,
        .wakeup_prd,
        .wakeup_data(writeback_data),
        .reset_mask,
        .abort_mask,
        .flush(trap_take),
        .data_load_valid(dmem_resp_valid),
        // A load that hits a memory-mapped device (decoded against the echoed
        // response address) returns the device register value instead of the
        // (out-of-window) DRAM result.
        .data_load(clint_load_hit ? clint_load_data :
                   plic_load_hit  ? plic_load_data  :
                   uart_load_hit  ? uart_load_data  : dmem_resp_data),
        .dmem_req_ready(dmem_req_ready),
        .snoop_kill_valid(dmem_snoop_kill_valid),
        .snoop_kill_laddr(dmem_snoop_kill_laddr),
        .commit_store,
        .commit_store_id,
        .paging_data(paging_data),
        .xlate_stall(lsq_xlate_stall),
        .xlate_fault(lsq_xlate_fault),
        .xlate_cause(lsq_xlate_cause),
        .xlate_pa(data_pa),
        .mem_req_valid(mem_req_valid),
        .mem_req_vaddr(mem_req_vaddr),
        .mem_req_store(mem_req_store),
        .full(mem_queue_full),
        .data_load_en(mem_data_load_en),
        .data_addr(mem_data_addr),
        .data_store(mem_data_store),
        .data_store_mask(mem_data_store_mask),
        .dmem_req_op(mem_dmem_op),
        .dmem_req_amo(mem_dmem_amo),
`ifdef LSQ_MLP2
        .dmem_req_id(mem_dmem_id),
        .dmem_resp_id(dmem_resp_id),
`endif
        .store_second_beat(lsq_store_second_beat),
        .store_port_busy(lsq_store_port_busy),
        .head_load_off(dev_load_off),
        .sc_commit_done(lsq_sc_commit_done),
        .load_writeback,
`ifdef FUSE_LDBR
        .pend_fbr_full,
        .fused_resolve_valid,
        .fused_resolve_active_id,
        .fused_resolve_branch_id,
        .fused_resolve_pc,
        .fused_resolve_instr,
        .fused_resolve_redirect_pc,
        .fused_resolve_mispredict,
        .fused_resolve_ctrl_pred,
        .fused_resolve_pred_pc,
        .fused_resolve_pred_info,
        .fused_resolve_branch_mask,
        .fused_resolve_is_comp,
`endif
        .lsq_head_reason(lsq_head_reason),
        .lsq_fwd_class(lsq_fwd_class)
`ifdef LOAD_SPEC_WAKE
        ,
        .load_spec_wake_valid(lsq_load_spec_wake_valid),
        .load_spec_wake_prd  (lsq_load_spec_wake_prd)
`ifdef LSQ_MLP2
        ,
        .load_spec_wake_id   (lsq_load_spec_wake_id)
`endif
`endif
    );

    ooo_writeback_bus WritebackBus (
        .alu0_writeback,
        .alu1_writeback,
`ifdef ALU4
        .alu2_writeback,
`endif
        .load_writeback,
        .mul_writeback,
        .div_writeback,
        .fp_writeback,
`ifdef FUSE_LDBR
        .fbr_writeback,
`endif
        .abort_mask_q,
        .mul_writeback_ready,
        .div_writeback_ready,
        .fp_writeback_ready,
`ifdef FUSE_LDBR
        .fbr_writeback_ready(pend_fbr_drain_ready),
`endif
        .writeback_valid,
        .writeback_active_id,
        .writeback_prd,
        .writeback_data,
        .writeback_has_dest,
        .writeback_fp_write,
        .writeback_fp_rd,
        .writeback_fp_data,
        .writeback_csr_write,
        .writeback_csr_addr,
        .writeback_csr_wdata,
        .writeback_fp_fflags_valid,
        .writeback_fp_fflags,
        .writeback_exception,
        .writeback_exc_cause,
        .writeback_halted,
        .branch_writeback
    );

    ooo_branch_recovery BranchRecovery (
        .branch_writeback,
        .stack_reset_mask(stack_reset_mask),
        .stack_abort_mask(stack_abort_mask),
        .stack_restore_valid(branch_restore_valid),
        .fetch_pc_plus4(sequential_next_pc),
        .resolve_valid(branch_resolve_valid),
        .resolve_id(branch_resolve_id),
        .resolve_mispredict(branch_resolve_mispredict),
        .reset_mask,
        .abort_mask,
        .redirect_valid,
        .redirect_pc
    );

    ooo_commit_unit #(.COHERENT(COHERENT)) CommitUnit (
        .commit_valid(active_commit_valid),
        .commit_packet(active_commit_packet),
        .store_port_busy(lsq_store_port_busy),
        .store_port_ready(dmem_req_ready),
        .sc_commit_done(lsq_sc_commit_done),
        .retire_valid,
        .free_valid(commit_free_valid),
        .free_prd(commit_free_prd),
        .commit_store,
        .commit_store_id,
        .precise_halt,
        .precise_exception
    );

    // Shadow architectural register file: write-only (read addrs tied to 0, read
    // data unused) -- it exists purely for the sim register-file dump. Excluded
    // from synthesis (the lab register_file.sv carries a `string`-based dump that
    // is not synthesizable, and the shadow state has no datapath function).
`ifndef SYNTHESIS
    register_file #(.WAYS(OOO_WIDTH), .FORWARD(0)) ArchitecturalRF (
        .clk,
        .rst_l,
        .halted,
        .rd_we(arch_rd_we),
        .rs1(arch_rs1),
        .rs2(arch_rs2),
        .rd(arch_rd),
        .rd_data(arch_rd_data),
        .rs1_data(arch_rs1_data),
        .rs2_data(arch_rs2_data)
    );
`else
    assign arch_rs1_data = '0;
    assign arch_rs2_data = '0;
`endif

    always_comb begin
        direct_lookup_valid = 1'b0;
        direct_lookup_pc = '0;
        indirect_lookup_valid = 1'b0;
        indirect_lookup_pc = '0;
        for (int i = 0; i < OOO_WIDTH; i += 1) begin
            if (decode_lanes[i].valid && !decode_lanes[i].kill &&
                    (decode_lanes[i].ctrl.pc_source == PC_cond) &&
                    !direct_lookup_valid) begin
                direct_lookup_valid = 1'b1;
                direct_lookup_pc = decode_lanes[i].pc;
            end
            if (decode_lanes[i].valid && !decode_lanes[i].kill &&
                    (decode_lanes[i].ctrl.pc_source == PC_indirect) &&
                    !((decode_lanes[i].rs1 == 5'd1) &&
                      (decode_lanes[i].rd == 5'd0)) &&
                    !indirect_lookup_valid) begin
                indirect_lookup_valid = 1'b1;
                indirect_lookup_pc = decode_lanes[i].pc;
            end
        end
    end

`ifdef DFE_S1
`ifdef RVC
    // ============ DFE S1a: fetch-side branch predecode (INERT, no consumer) ============
    // Independent raw-block scan that reproduces WHICH in-block instruction is the first
    // controlling conditional / first non-return indirect of the drain window the
    // realigner presents this cycle. Compared one-directionally against the dispatch-
    // directed lookup PCs by the assertion below. A different traversal of the same bytes
    // -- reusing rvc_lane_pc would be a tautology. RVC-only (DFE_S1 is OoO-only, OoO
    // requires RVC).
    logic            pd_cond_valid;  logic [XLEN-1:0] pd_cond_pc;
    logic            pd_ind_valid;   logic [XLEN-1:0] pd_ind_pc;

    always_comb begin
        logic [15:0]     pd_par [8];
        logic [XLEN-1:0] pd_base, pd_pc;
        logic [3:0]      pd_cur;
        logic            pd_stop;
        logic [15:0]     pd_p, pd_hi;
        logic [4:0]      pd_rs1, pd_rd;
        logic            pd_is32, pd_is_cond, pd_is_jalr, pd_is_jal, pd_is_ret;

        for (int k = 0; k < 8; k += 1)
            pd_par[k] = fgrp_data[k[2]][(k[1:0]) * 16 +: 16];   // == rvc_realign pblock
        pd_base = {fgrp_pc[XLEN-1:4], 4'b0};
        pd_cond_valid = 1'b0; pd_cond_pc = '0;
        pd_ind_valid  = 1'b0; pd_ind_pc  = '0;
        pd_stop = 1'b0; pd_cur = {1'b0, dfe_s0};
        pd_pc='0; pd_p='0; pd_hi='0; pd_rs1='0; pd_rd='0;
        pd_is32=1'b0; pd_is_cond=1'b0; pd_is_jalr=1'b0; pd_is_jal=1'b0; pd_is_ret=1'b0;

        // Straddle completion: the prev block's 32-bit low half is this cycle's lane0.
        if (dfe_completing) begin
            if (dfe_straddle_half[6:2] == 5'b11000) begin
                pd_cond_valid = 1'b1; pd_cond_pc = dfe_straddle_pc;   // 32-bit BRANCH
            end else if (dfe_straddle_half[6:2] == 5'b11001) begin
                // 32-bit JALR straddling parcel 7. rs1's upper 4 bits are in the
                // not-yet-arrived high half, so a return cannot be disambiguated here.
                // OVER-detect the indirect pick (Finding #1): the assertion is one-
                // directional and decode excludes ONLY the true return (rs1==1 && rd==0),
                // whose indirect_lookup_valid is already 0.
                pd_ind_valid = 1'b1; pd_ind_pc = dfe_straddle_pc;
                pd_stop = 1'b1;
            end else if (dfe_straddle_half[6:2] == 5'b11011) begin
                pd_stop = 1'b1;                                       // 32-bit JAL
            end
            pd_cur = 4'd1;                                           // parcel0 high half consumed
        end

        for (int step = 0; step < 8; step += 1) begin
            if (!pd_stop && (pd_cur <= 4'd7) && fgrp_valid) begin
                pd_p   = pd_par[pd_cur[2:0]];
                pd_hi  = (pd_cur < 4'd7) ? pd_par[pd_cur[2:0] + 3'd1] : 16'h0000;
                pd_pc  = pd_base + {pd_cur[2:0], 1'b0};
                pd_is32= (pd_p[1:0] == 2'b11);
                pd_rd  = pd_p[11:7];
                pd_rs1 = pd_is32 ? {pd_hi[3:0], pd_p[15]} : pd_p[11:7];
                pd_is_cond = (pd_is32 && (pd_p[6:2]==5'b11000)) ||
                             ((pd_p[1:0]==2'b01) && ((pd_p[15:13]==3'b110)||(pd_p[15:13]==3'b111)));
                pd_is_jal  = (pd_is32 && (pd_p[6:2]==5'b11011)) ||
                             ((pd_p[1:0]==2'b01) && (pd_p[15:13]==3'b101));
                pd_is_jalr = (pd_is32 && (pd_p[6:2]==5'b11001)) ||
                             ((pd_p[1:0]==2'b10) && (pd_p[15:13]==3'b100) &&
                              (pd_p[6:2]==5'd0) && (pd_p[11:7]!=5'd0));
                pd_is_ret  = pd_is_jalr &&
                             ( (pd_is32 && (pd_rs1==5'd1) && (pd_rd==5'd0)) ||
                               (!pd_is32 && (pd_p[12]==1'b0) && (pd_p[11:7]==5'd1)) );

                if (pd_is32 && (pd_cur == 4'd7)) begin
                    pd_stop = 1'b1;                    // parcel-7 low half: caught via completing
                end else if (pd_is_jal || pd_is_ret) begin
                    pd_stop = 1'b1;                    // squashes younger, not a lookup pick
                end else if (pd_is_jalr) begin
                    if (!pd_ind_valid) begin pd_ind_valid=1'b1; pd_ind_pc=pd_pc; end
                    pd_stop = 1'b1;                    // non-return indirect squashes younger
                end else if (pd_is_cond) begin
                    if (!pd_cond_valid) begin pd_cond_valid=1'b1; pd_cond_pc=pd_pc; end
                    pd_cur = pd_cur + (pd_is32 ? 4'd2 : 4'd1);   // cond does NOT squash younger
                end else begin
                    pd_cur = pd_cur + (pd_is32 ? 4'd2 : 4'd1);
                end
            end
        end
    end

`ifndef SYNTHESIS
    // #1 KILL SIGNAL: the fetch-side predecode must name the SAME conditional/indirect
    // branch PC the dispatch-directed TAGE/ITTAGE lookup keys on (identical prediction
    // input key). One-directional: lookup_valid => predecode names it here. A mismatch
    // means the FTQ would predict from a different key => accuracy would diverge =>
    // the universal-no-regression premise is false. Hard stop.
    always_ff @(posedge clk) begin
        if (rst_l && fgrp_valid && !halted_q && !fetch_flush) begin
            if (direct_lookup_valid)
                assert (pd_cond_valid && (pd_cond_pc == direct_lookup_pc))
                  else $error("DFE_S1 cond mismatch: pd=%h disp=%h (fgrp_pc=%h s0=%0d compl=%b)",
                              pd_cond_pc, direct_lookup_pc, fgrp_pc, dfe_s0, dfe_completing);
            if (indirect_lookup_valid)
                assert (pd_ind_valid && (pd_ind_pc == indirect_lookup_pc))
                  else $error("DFE_S1 ind mismatch: pd=%h disp=%h (fgrp_pc=%h s0=%0d compl=%b)",
                              pd_ind_pc, indirect_lookup_pc, fgrp_pc, dfe_s0, dfe_completing);
        end
    end
`endif
`endif
`endif

    // ---- Phys-reg read-address fan-out (FB2b false-loop break) ----
    // Extracted from the monolithic dispatch always_comb so that the read of
    // int_issue_entry / alu_issue_entry_q here does NOT alias into that block's
    // hundreds of unrelated outputs (lane_valid, dispatch_valid, commit_exc_valid,
    // branch_allocate ...). Verilator/Vivado analyze dependencies at whole-block
    // granularity, so an int_issue_entry read inside the dispatch block drew a
    // spurious edge to every output of it, closing the issue/wakeup/abort_mask
    // false combinational loops. With this as its own block the dependency graph is
    // the real (acyclic) one. Value-identical -- pure code motion.
    always_comb begin
        for (int i = 0; i < FU_ISSUE_PORTS; i += 1) begin
            // ALU ports read the phys regfile in S2 (from the registered issue
            // entry); MUL/DIV/FP read at select (combinational issue), unchanged.
            if (i < ALU_ISSUE_PORTS) begin
                phys_rs1[i] = alu_issue_entry_q[i].prs1;
                phys_rs2[i] = alu_issue_entry_q[i].prs2;
            end else begin
                phys_rs1[i] = int_issue_entry[i].prs1;
                phys_rs2[i] = int_issue_entry[i].prs2;
            end
        end
        for (int i = 0; i < OOO_WIDTH; i += 1) begin
            phys_rs1[FU_ISSUE_PORTS + i] = dispatch_issue_entries[i].prs1;
            phys_rs2[FU_ISSUE_PORTS + i] = dispatch_issue_entries[i].prs2;
        end
    end

    // ---- Mem-operand data read + writeback fan-out (wakeup / phys-write) ----
    // Reads the phys-regfile OUTPUT (phys_rs*_data) and the writeback bus, so it
    // is a SEPARATE block from the read-address fan-out above (which writes
    // phys_rs*) -- keeping them split puts the regfile flop between them in the
    // dependency graph (addr -> regfile -> data) instead of a same-block apparent
    // cycle. wakeup/phys_write are pure writeback-bus fan-out. Value-identical.
    always_comb begin
        for (int i = 0; i < OOO_WIDTH; i += 1) begin
            mem_insert_rs1_data[i] = phys_rs1_data[FU_ISSUE_PORTS + i];
            mem_insert_rs2_data[i] = phys_rs2_data[FU_ISSUE_PORTS + i];
        end
        for (int i = 0; i < OOO_WIDTH; i += 1) begin
            wakeup_valid[i] = writeback_valid[i] && writeback_has_dest[i];
            wakeup_prd[i] = writeback_prd[i];
            phys_write_valid[i] = writeback_valid[i] && writeback_has_dest[i];
            phys_write_prd[i] = writeback_prd[i];
            phys_write_data[i] = writeback_data[i];
        end
    end

    // frontend_stall: pure combinational of two module-input stalls; a
    // continuous assign keeps it out of the procedural dispatch blocks.
    assign frontend_stall = dispatch_stall || fetch_xlate_stall;

    // ================================================================
    // Dispatch pipeline, decomposed into single-purpose comb blocks
    // (FB2b Wall A). The former 700-line monolith drew false
    // combinational-loop edges between every input it read and every
    // output it wrote (Verilator/Vivado analyze dependencies at
    // whole-block granularity), corrupting the post-place STA. Splitting
    // it into the real dataflow stages -- LaneDecode -> BranchPredict ->
    // Rename, and CommitTrap -> InterruptDrain -> FrontendControl --
    // gives the tool the true (acyclic) graph. Each block is
    // value-identical pure code motion: every signal has exactly one
    // driver block, and every cross-block read is of a settled value
    // (no earlier block reads a later block's output). Inits live with
    // their owning block.
    // ================================================================
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
