pachurii-knowledge/empty-sekai-lake/src/riscv_decode.sv

/**
 * riscv_decode.sv
 *
 * RISC-V 32-bit Processor
 *
 * ECE 18-447
 * Carnegie Mellon University
 *
 * This file contains the implementation of the RISC-V decoder.
 *
 * This takes in information about the current RISC-V instruction and produces
 * the appropriate control signals to get the processor to execute the current
 * instruction.
 **/

/*----------------------------------------------------------------------------*
 *  You may edit this file and add or change any files in the src directory.  *
 *----------------------------------------------------------------------------*/

// RISC-V Includes
`include "riscv_isa.vh"             // RISC-V ISA definitions

// Local Includes
`include "internal_defines.vh"      // Control signals struct, ALU ops

// Force the compiler to throw an error if any variables are undeclared
`default_nettype none

// Define a macro that prints for simulation, does nothing for synthesis
`ifdef SIMULATION_18447
`define display(print, format, arg) \
    do begin \
        if (print) begin \
            $display(format, arg); \
        end \
    end while (0)
`else
`define display(print, format, arg)
`endif /* SIMULATION_18447 */

/**
 * The instruction decoder for the RISC-V processor.
 *
 * This module processes the current instruction, determines what instruction it
 * is, and sets the control signals for the processor appropriately.
 *
 * Inputs:
 *  - rst_l             The asynchronous, active low reset for the processor.
 *  - instr             The current instruction being executed by the processor.
 *
 * Outputs:
 *  - ctrl_signals      The control signals needed to execute the given
 *                      instruction correctly.
 **/
module riscv_decode
    (input wire logic           rst_l,
     input wire logic [31:0]    instr,
     output ctrl_signals_t  ctrl_signals);

    // Import all of the ISA types and enums (opcodes, functions codes, etc.)
    import RISCV_ISA::*;

    // The various fields of an instruction
    opcode_t            opcode;
    funct7_t            funct7;
    rtype_funct3_t      rtype_funct3;
    itype_int_funct3_t  itype_int_funct3;
    itype_load_funct3_t itype_load_funct3;
    stype_funct3_t      stype_funct3;
    sbtype_funct3_t     sbtype_funct3;
    itype_funct12_t     itype_funct12;
    csr_funct3_t        csr_funct3;

    // Decode the opcode and various function codes for the instruction
    assign opcode           = opcode_t'(instr[6:0]);
    assign funct7           = funct7_t'(instr[31:25]);
    assign rtype_funct3     = rtype_funct3_t'(instr[14:12]);
    assign itype_int_funct3 = itype_int_funct3_t'(instr[14:12]);
    assign itype_load_funct3= itype_load_funct3_t'(instr[14:12]);
    assign stype_funct3     = stype_funct3_t'(instr[14:12]);
    assign sbtype_funct3    = sbtype_funct3_t'(instr[14:12]);
    assign itype_funct12    = itype_funct12_t'(instr[31:20]);
    assign csr_funct3       = csr_funct3_t'(instr[14:12]);

        always_comb begin
            // Default initialization to prevent latch inference
            ctrl_signals = '{
                useImm: 1'b0,
                usePC: 1'b0,
                doCmp: 1'b0,
                rfWrite: 1'b0,
                mem2RF: 1'b0,
                pc2RF: 1'b0,
                memRead: 1'b0,
                memWrite: 1'b0,
                imm_mode: IMM_DC,
                alu_op: ALU_DC,
                ldst_mode: LDST_DC,
                pc_source: PC_DC,
                rd_source: RD_DC,
                exec_class: EXEC_INT,
                csr_op: CSR_NONE,
                amo_op: AMO_NONE,
                fp_op: FP_NONE,
                fp_double: 1'b0,
                fp_uses_rs1: 1'b0,
                fp_uses_rs2: 1'b0,
                fp_uses_rs3: 1'b0,
                fp_writes_fpr: 1'b0,
                fp_writes_gpr: 1'b0,
                csr_write: 1'b0,
                fence_i: 1'b0,
                serializing: 1'b0,
                isBranch: 1'b0,

                btype: sbtype_funct3,
                syscall: 1'b0,
                is_ebreak: 1'b0,
                is_mret: 1'b0,
                is_sret: 1'b0,
                is_wfi: 1'b0,
                is_sfence_vma: 1'b0,
                illegal_instr: 1'b0,
                fetch_fault: 1'b0,
                fetch_fault_cause: 5'd0
`ifdef RVC
                , is_compressed: 1'b0
                , fetch_fault_hi: 1'b0
                , rvc_parcel: 16'd0
`endif
            };

            if(~rst_l) begin
                ctrl_signals = '{
                    useImm: 1'b0,
                    usePC: 1'b0,
                    doCmp: 1'b0,
                    rfWrite: 1'b0,  // never don't care
                    mem2RF: 1'b0,
                    pc2RF: 1'b0,
                    memRead: 1'b0,  // never don't care
                    memWrite: 1'b0, // never don't care
                    imm_mode: IMM_DC,
                    alu_op: ALU_DC,
                    ldst_mode: LDST_DC,
                    pc_source: PC_DC,
                    rd_source: RD_DC,
                    exec_class: EXEC_INT,
                    csr_op: CSR_NONE,
                    amo_op: AMO_NONE,
                    fp_op: FP_NONE,
                    fp_double: 1'b0,
                    fp_uses_rs1: 1'b0,
                    fp_uses_rs2: 1'b0,
                    fp_uses_rs3: 1'b0,
                    fp_writes_fpr: 1'b0,
                    fp_writes_gpr: 1'b0,
                    csr_write: 1'b0,
                    fence_i: 1'b0,
                    serializing: 1'b0,
                    isBranch: 1'b0,

                    btype: sbtype_funct3,
                    syscall: 1'b0,
                    is_ebreak: 1'b0,
                    is_mret: 1'b0,
                    is_sret: 1'b0,
                    is_wfi: 1'b0,
                    is_sfence_vma: 1'b0,
                    illegal_instr: 1'b0,
                    fetch_fault: 1'b0,
                    fetch_fault_cause: 5'd0
`ifdef RVC
                    , is_compressed: 1'b0
                    , fetch_fault_hi: 1'b0
                    , rvc_parcel: 16'd0
`endif
                };
            end
        
            unique case (opcode)
                OP_OP: begin
                    ctrl_signals.useImm = 1'b0;
                    ctrl_signals.rfWrite = 1'b1;
                    ctrl_signals.pc2RF = 1'b0;
                    ctrl_signals.mem2RF = 1'b0;
                    ctrl_signals.memRead = 1'b0;
                    ctrl_signals.memWrite = 1'b0;
                    ctrl_signals.usePC = 1'b0;
                    ctrl_signals.imm_mode  = IMM_DC;
                    ctrl_signals.ldst_mode = LDST_DC;
                    ctrl_signals.pc_source = PC_plus4;

                    unique case (rtype_funct3)
                        // 3-bit function code for add or subtract
                        FUNCT3_ADD_SUB: begin
                            unique case (funct7)
                                // 7-bit function code for typical integer instructions
                                FUNCT7_INT: begin
                                    ctrl_signals.alu_op = ALU_ADD;
                                    ctrl_signals.rd_source = RD_ALU;
                                end
                                FUNCT7_ALT_INT: begin
                                    ctrl_signals.alu_op = ALU_SUB;
                                    ctrl_signals.rd_source = RD_ALU;
                                end
                                FUNCT7_MULDIV: begin
                                    ctrl_signals.alu_op = ALU_MUL;
                                    ctrl_signals.rd_source = RD_ALU;
                                end
                                default: begin
                                    `display(rst_l, "Encountered unknown/unimplemented 7-bit function code 0x%02x.",
                                            funct7);
                                    ctrl_signals.illegal_instr = 1'b1;
                                end
                            endcase
                        end
                        FUNCT3_SLL: begin
                            ctrl_signals.alu_op = (funct7 == FUNCT7_MULDIV) ?
                                ALU_MULH : ALU_SLL;
                            ctrl_signals.rd_source = RD_ALU;
                        end
                        FUNCT3_SLT: begin
                            if (funct7 == FUNCT7_MULDIV) begin
                                ctrl_signals.alu_op = ALU_MULHSU;
                                ctrl_signals.rd_source = RD_ALU;
                            end else begin
                                ctrl_signals.alu_op = ALU_SLT;
                                ctrl_signals.rd_source = RD_CMP;
                            end
                        end
                        FUNCT3_SLTU: begin
                            if (funct7 == FUNCT7_MULDIV) begin
                                ctrl_signals.alu_op = ALU_MULHU;
                                ctrl_signals.rd_source = RD_ALU;
                            end else begin
                                ctrl_signals.alu_op = ALU_SLTU;
                                ctrl_signals.rd_source = RD_CMP;
                            end
                        end
                        FUNCT3_XOR: begin
                            ctrl_signals.alu_op = (funct7 == FUNCT7_MULDIV) ?
                                ALU_DIV : ALU_XOR;
                            ctrl_signals.rd_source = RD_ALU;
                        end
                        FUNCT3_SRL_SRA: begin
                            unique case (funct7)
                                FUNCT7_INT: begin
                                    ctrl_signals.alu_op = ALU_SRL;
                                    ctrl_signals.rd_source = RD_ALU;
                                end
                                FUNCT7_ALT_INT: begin
                                    ctrl_signals.alu_op = ALU_SRA;
                                    ctrl_signals.rd_source = RD_ALU;
                                end
                                FUNCT7_MULDIV: begin
                                    ctrl_signals.alu_op = ALU_DIVU;
                                    ctrl_signals.rd_source = RD_ALU;
                                end
                                default: begin
                                    `display(rst_l, "Encountered unknown/unimplemented 7-bit function code 0x%02x.",
                                            funct7);
                                    ctrl_signals.illegal_instr = 1'b1;
                                end
                            endcase
                        end
                        FUNCT3_OR: begin
                            ctrl_signals.alu_op = (funct7 == FUNCT7_MULDIV) ?
                                ALU_REM : ALU_OR;
                            ctrl_signals.rd_source = RD_ALU;
                        end
                        FUNCT3_AND: begin
                            ctrl_signals.alu_op = (funct7 == FUNCT7_MULDIV) ?
                                ALU_REMU : ALU_AND;
                            ctrl_signals.rd_source = RD_ALU;
                        end
                        default: begin
                            `display(rst_l, "Encountered unknown/unimplemented 3-bit rtype integer function code 0x%01x.",
                                    rtype_funct3);
                            ctrl_signals.illegal_instr = 1'b1;
                        end
                    endcase
                end

                // General I-type arithmetic operation
                OP_IMM: begin
                    ctrl_signals.useImm = 1'b1;
                    ctrl_signals.rfWrite = 1'b1;
                    ctrl_signals.pc2RF = 1'b0;
                    ctrl_signals.mem2RF = 1'b0;
                    ctrl_signals.memRead = 1'b0;
                    ctrl_signals.memWrite = 1'b0;
                    ctrl_signals.usePC = 1'b0;
                    ctrl_signals.imm_mode = IMM_I;
                    ctrl_signals.ldst_mode = LDST_DC;
                    ctrl_signals.pc_source = PC_plus4;

                    unique case (itype_int_funct3)
                        FUNCT3_ADDI: begin
                            ctrl_signals.rd_source = RD_ALU;
                            ctrl_signals.alu_op = ALU_ADD;
                        end

                        FUNCT3_SLTI: begin
                            ctrl_signals.rd_source = RD_CMP;
                            ctrl_signals.alu_op = ALU_SLT;
                        end

                        FUNCT3_SLTIU: begin
                            ctrl_signals.rd_source = RD_CMP;
                            ctrl_signals.alu_op = ALU_SLTU;
                        end

                        FUNCT3_XORI: begin
                            ctrl_signals.rd_source = RD_ALU;
                            ctrl_signals.alu_op = ALU_XOR;
                        end

                        FUNCT3_ORI: begin
                            ctrl_signals.rd_source = RD_ALU;
                            ctrl_signals.alu_op = ALU_OR;
                        end

                        FUNCT3_ANDI: begin
                            ctrl_signals.rd_source = RD_ALU;
                            ctrl_signals.alu_op = ALU_AND;
                        end

                        FUNCT3_SLLI: begin
                            ctrl_signals.rd_source = RD_ALU;
                            ctrl_signals.alu_op = ALU_SLL;
                            // Reserved upper bits: RV64 SLLI funct6 (instr[31:26])
                            // must be 0; RV32 funct7 (instr[31:25]) must be 0 (so
                            // shamt[5]=instr[25] is reserved on RV32). Else illegal.
`ifdef RV64
                            if (instr[31:26] != 6'b000000)
                                ctrl_signals.illegal_instr = 1'b1;
`else
                            if (instr[31:25] != 7'b0000000)
                                ctrl_signals.illegal_instr = 1'b1;
`endif
                        end

                        FUNCT3_SRLI_SRAI: begin
                            // Discriminate SRLI vs SRAI by instr[30] (the
                            // "arithmetic" bit), NOT the full funct7: in RV64 the
                            // shamt is 6 bits (instr[25:20]), so instr[25] is a
                            // shamt bit and would corrupt a funct7 match for any
                            // shamt >= 32. instr[30] is the discriminator in the
                            // funct7 (RV32) and funct6 (RV64) encodings alike.
                            ctrl_signals.rd_source = RD_ALU;
                            ctrl_signals.alu_op = instr[30] ? ALU_SRA : ALU_SRL;
                            // Reserved upper bits: valid funct is 000000 (SRLI) or
                            // 010000 (SRAI) -- over instr[31:26] on RV64, instr[31:25]
                            // on RV32. Anything else (instr[26]=1 on RV64, shamt[5]=1
                            // on RV32) is a reserved encoding -> illegal.
`ifdef RV64
                            if ((instr[31:26] != 6'b000000) &&
                                (instr[31:26] != 6'b010000))
                                ctrl_signals.illegal_instr = 1'b1;
`else
                            if ((instr[31:25] != 7'b0000000) &&
                                (instr[31:25] != 7'b0100000))
                                ctrl_signals.illegal_instr = 1'b1;
`endif
                        end

                        default: begin
                            `display(rst_l, "Encountered unknown/unimplemented 3-bit itype integer function code 0x%01x.",
                                    itype_int_funct3);
                            ctrl_signals.illegal_instr = 1'b1;
                        end
                    endcase
                end

                // load instructions (i-type)
                OP_LOAD: begin
                    ctrl_signals.useImm = 1'b1;
                    ctrl_signals.rfWrite = 1'b1;
                    ctrl_signals.mem2RF = 1'b1;
                    ctrl_signals.rd_source = RD_MMU;
                    ctrl_signals.pc2RF = 1'b0;
                    ctrl_signals.usePC = 1'b0;
                    ctrl_signals.memRead = 1'b1;
                    ctrl_signals.memWrite = 1'b0;
                    ctrl_signals.imm_mode = IMM_I;
                    ctrl_signals.alu_op = ALU_ADD;
                    ctrl_signals.pc_source = PC_plus4;
    
                    unique case (itype_load_funct3)
                        FUNCT3_LW: begin
                            ctrl_signals.ldst_mode = LDST_W;
                        end

                        FUNCT3_LH: begin
                            ctrl_signals.ldst_mode = LDST_H;
                        end

                        FUNCT3_LHU: begin
                            ctrl_signals.ldst_mode = LDST_HU;
                        end

                        FUNCT3_LB: begin
                            ctrl_signals.ldst_mode = LDST_B;
                        end

                        FUNCT3_LBU: begin
                            ctrl_signals.ldst_mode = LDST_BU;
                        end

                        default: begin
`ifdef RV64
                            // RV64 LD (funct3 011) / LWU (funct3 110)
                            if (instr[14:12] == 3'b011)
                                ctrl_signals.ldst_mode = LDST_D;
                            else if (instr[14:12] == 3'b110)
                                ctrl_signals.ldst_mode = LDST_WU;
                            else
                                ctrl_signals.illegal_instr = 1'b1;
`else
                            `display(rst_l, "Encountered unknown/unimplemented 3-bit itype load code 0x%01x.",
                                    itype_load_funct3);
                            ctrl_signals.illegal_instr = 1'b1;
`endif
                        end
                    endcase
                end
        
                // store instructions (s-type)
                OP_STORE: begin
                    ctrl_signals.useImm = 1'b1;
                    ctrl_signals.usePC = 1'b0;
                    ctrl_signals.rfWrite = 1'b0;
                    ctrl_signals.pc2RF = 1'b0;
                    ctrl_signals.memRead = 1'b0;
                    ctrl_signals.memWrite = 1'b1;
                    ctrl_signals.imm_mode = IMM_S;
                    ctrl_signals.alu_op = ALU_ADD;
                    ctrl_signals.pc_source = PC_plus4;

                    unique case (stype_funct3)
                        FUNCT3_SW: begin
                            ctrl_signals.ldst_mode = LDST_W;
                        end

                        FUNCT3_SH: begin
                            ctrl_signals.ldst_mode = LDST_H;
                        end

                        FUNCT3_SB: begin
                            ctrl_signals.ldst_mode = LDST_B;
                        end

                        default: begin
`ifdef RV64
                            // RV64 SD (funct3 011)
                            if (instr[14:12] == 3'b011)
                                ctrl_signals.ldst_mode = LDST_D;
                            else
                                ctrl_signals.illegal_instr = 1'b1;
`else
                            `display(rst_l, "Encountered unknown/unimplemented 3-bit stype store code 0x%01x.",
                                    stype_funct3);
                            ctrl_signals.illegal_instr = 1'b1;
`endif
                        end
                    endcase
                end
                // branch instructions (b-type)
                OP_BRANCH: begin
                    ctrl_signals.isBranch = 1'b1;
                    ctrl_signals.useImm = 1'b0;
                    ctrl_signals.rfWrite = 1'b0;
                    // ctrl_signals.mem2RF=1'bx;
                    ctrl_signals.usePC = 1'b0;
                    ctrl_signals.pc2RF = 1'bx;
                    ctrl_signals.memRead = 1'b0;
                    ctrl_signals.memWrite = 1'b0;
                    ctrl_signals.imm_mode = IMM_SB;
                    ctrl_signals.alu_op = ALU_SUB;
                    ctrl_signals.ldst_mode = LDST_DC;
                    ctrl_signals.pc_source = PC_cond;
                    unique case (sbtype_funct3)
                        FUNCT3_BEQ: begin
                        ctrl_signals.alu_op = ALU_BEQ;
                        end
                    FUNCT3_BNE: begin
                        ctrl_signals.alu_op = ALU_BNE;
                        end
                        FUNCT3_BLT: begin
                        ctrl_signals.alu_op = ALU_BLT;
                        end

                        FUNCT3_BGE: begin
                        ctrl_signals.alu_op = ALU_BGE;
                        end

                        FUNCT3_BLTU: begin
                        ctrl_signals.alu_op = ALU_BLTU;
                        end

                        FUNCT3_BGEU: begin
                        ctrl_signals.alu_op = ALU_BGEU;
                        end

                        default: begin
                        `display(rst_l, "Encountered unknown/unimplemented 3-bit sbtype branch code 0x%01x.",
                                sbtype_funct3);
                        ctrl_signals.illegal_instr = 1'b1;
                        end
                    endcase
                end

                OP_AUIPC: begin
                    ctrl_signals.isBranch = 1'b0;
                    ctrl_signals.useImm = 1'b1;
                    ctrl_signals.rfWrite = 1'b1;
                    ctrl_signals.pc2RF = 1'b0;
                    ctrl_signals.memRead = 1'b0;
                    ctrl_signals.memWrite = 1'b0;
                    ctrl_signals.usePC = 1'b1;
                    ctrl_signals.imm_mode = IMM_U;
                    ctrl_signals.alu_op = ALU_ADD;
                    ctrl_signals.ldst_mode = LDST_DC;
                    ctrl_signals.pc_source = PC_plus4;
                    ctrl_signals.rd_source = RD_ALU;
                end

                OP_JAL: begin
                    ctrl_signals.isBranch = 1'b1;
                    ctrl_signals.useImm = 1'b1;
                    ctrl_signals.rfWrite = 1'b1;
                    ctrl_signals.pc2RF = 1'b1;
                    ctrl_signals.memRead = 1'b0;
                    ctrl_signals.memWrite = 1'b0;
                    ctrl_signals.usePC = 1'b1;
                    ctrl_signals.imm_mode = IMM_UJ;
                    ctrl_signals.alu_op = ALU_ADD;
                    ctrl_signals.ldst_mode = LDST_DC;
                    ctrl_signals.pc_source = PC_uncond;
                    ctrl_signals.rd_source = RD_PC4;
                end

                OP_JALR: begin
                    ctrl_signals.isBranch = 1'b1;
                    ctrl_signals.useImm = 1'b1;
                    ctrl_signals.rfWrite = 1'b1;
                    ctrl_signals.pc2RF = 1'b1;
                    ctrl_signals.memRead = 1'b0;
                    ctrl_signals.memWrite = 1'b0;
                    ctrl_signals.usePC = 1'b0;
                    ctrl_signals.imm_mode = IMM_I;
                    ctrl_signals.alu_op = ALU_ADD;
                    ctrl_signals.ldst_mode = LDST_DC;
                    ctrl_signals.pc_source = PC_indirect;
                    ctrl_signals.rd_source = RD_PC4;
                end

                OP_LUI: begin
                    ctrl_signals.useImm = 1'b1;
                    ctrl_signals.rfWrite = 1'b1;
                    ctrl_signals.pc2RF = 1'b0;
                    ctrl_signals.memRead = 1'b0;
                    ctrl_signals.memWrite = 1'b0;
                    ctrl_signals.usePC = 1'b0;
                    ctrl_signals.imm_mode = IMM_U;
                    ctrl_signals.alu_op = ALU_ADD;
                    ctrl_signals.ldst_mode = LDST_DC;
                    ctrl_signals.pc_source = PC_plus4;
                    ctrl_signals.rd_source = RD_IMM;
                end
                OP_MISC_MEM: begin
                    ctrl_signals.exec_class = EXEC_FENCE;
                    ctrl_signals.serializing = 1'b1;
                    ctrl_signals.useImm = 1'b0;
                    ctrl_signals.rfWrite = 1'b0;
                    ctrl_signals.memRead = 1'b0;
                    ctrl_signals.memWrite = 1'b0;
                    ctrl_signals.pc_source = PC_plus4;
                    ctrl_signals.rd_source = RD_DC;
                    ctrl_signals.fence_i = (instr[14:12] == 3'b001);
                    if ((instr[14:12] != 3'b000) && (instr[14:12] != 3'b001)) begin
                        ctrl_signals.illegal_instr = 1'b1;
                    end
                end
                OP_LOAD_FP: begin
                    ctrl_signals.exec_class = EXEC_FP;
`ifndef FP_OOO
                    ctrl_signals.serializing = 1'b1;
`endif
                    ctrl_signals.useImm = 1'b1;
                    ctrl_signals.rfWrite = 1'b0;
                    ctrl_signals.fp_writes_fpr = 1'b1;
                    ctrl_signals.memRead = 1'b1;
                    ctrl_signals.memWrite = 1'b0;
                    ctrl_signals.imm_mode = IMM_I;
                    ctrl_signals.alu_op = ALU_ADD;
                    ctrl_signals.pc_source = PC_plus4;
                    ctrl_signals.rd_source = RD_MMU;
                    unique case (instr[14:12])
                        3'b010: begin
                            ctrl_signals.ldst_mode = LDST_W;
                            ctrl_signals.fp_double = 1'b0;
                        end
                        3'b011: begin
                            // On RV64 an FLD is a native one-word access; the
                            // RV32 path keeps the two-word LDST_W split.
`ifdef RV64
                            ctrl_signals.ldst_mode = LDST_D;
`else
                            ctrl_signals.ldst_mode = LDST_W;
`endif
                            ctrl_signals.fp_double = 1'b1;
                        end
                        default: ctrl_signals.illegal_instr = 1'b1;
                    endcase
                end
                OP_STORE_FP: begin
                    ctrl_signals.exec_class = EXEC_FP;
`ifndef FP_OOO
                    ctrl_signals.serializing = 1'b1;
`endif
                    ctrl_signals.useImm = 1'b1;
                    ctrl_signals.rfWrite = 1'b0;
                    ctrl_signals.fp_uses_rs2 = 1'b1;
                    ctrl_signals.memRead = 1'b0;
                    ctrl_signals.memWrite = 1'b1;
                    ctrl_signals.imm_mode = IMM_S;
                    ctrl_signals.alu_op = ALU_ADD;
                    ctrl_signals.pc_source = PC_plus4;
                    unique case (instr[14:12])
                        3'b010: begin
                            ctrl_signals.ldst_mode = LDST_W;
                            ctrl_signals.fp_double = 1'b0;
                        end
                        3'b011: begin
                            // On RV64 an FSD is a native one-word access; the
                            // RV32 path keeps the two-word LDST_W split.
`ifdef RV64
                            ctrl_signals.ldst_mode = LDST_D;
`else
                            ctrl_signals.ldst_mode = LDST_W;
`endif
                            ctrl_signals.fp_double = 1'b1;
                        end
                        default: ctrl_signals.illegal_instr = 1'b1;
                    endcase
                end
                OP_AMO: begin
                    ctrl_signals.exec_class = EXEC_AMO;
                    ctrl_signals.serializing = 1'b1;
                    ctrl_signals.useImm = 1'b0;
                    ctrl_signals.rfWrite = 1'b1;
                    ctrl_signals.memRead = 1'b1;
                    ctrl_signals.memWrite = 1'b1;
                    ctrl_signals.ldst_mode = LDST_W;
                    ctrl_signals.pc_source = PC_plus4;
                    ctrl_signals.rd_source = RD_MMU;
                    unique case (instr[31:27])
                        5'b00010: ctrl_signals.amo_op = AMO_LR;
                        5'b00011: ctrl_signals.amo_op = AMO_SC;
                        5'b00001: ctrl_signals.amo_op = AMO_SWAP;
                        5'b00000: ctrl_signals.amo_op = AMO_ADD;
                        5'b00100: ctrl_signals.amo_op = AMO_XOR;
                        5'b01100: ctrl_signals.amo_op = AMO_AND;
                        5'b01000: ctrl_signals.amo_op = AMO_OR;
                        5'b10000: ctrl_signals.amo_op = AMO_MIN;
                        5'b10100: ctrl_signals.amo_op = AMO_MAX;
                        5'b11000: ctrl_signals.amo_op = AMO_MINU;
                        5'b11100: ctrl_signals.amo_op = AMO_MAXU;
                        default: ctrl_signals.illegal_instr = 1'b1;
                    endcase
                    unique case (instr[14:12])
                        3'b010: ctrl_signals.ldst_mode = LDST_W;
`ifdef RV64
                        3'b011: ctrl_signals.ldst_mode = LDST_D; // .D variants
`endif
                        default: ctrl_signals.illegal_instr = 1'b1;
                    endcase
                    ctrl_signals.memRead = ctrl_signals.amo_op != AMO_SC;
                    ctrl_signals.memWrite = ctrl_signals.amo_op != AMO_LR;
                end
                OP_MADD, OP_MSUB, OP_NMSUB, OP_NMADD: begin
                    ctrl_signals.exec_class = EXEC_FP;
`ifndef FP_OOO
                    ctrl_signals.serializing = 1'b1;
`endif
                    ctrl_signals.fp_uses_rs1 = 1'b1;
                    ctrl_signals.fp_uses_rs2 = 1'b1;
                    ctrl_signals.fp_uses_rs3 = 1'b1;
                    ctrl_signals.fp_writes_fpr = 1'b1;
                    ctrl_signals.fp_double = (instr[26:25] == 2'b01);
                    ctrl_signals.rfWrite = 1'b0;
                    ctrl_signals.pc_source = PC_plus4;
                    ctrl_signals.rd_source = RD_ALU;
                    unique case (opcode)
                        OP_MADD:  ctrl_signals.fp_op = FP_MADD;
                        OP_MSUB:  ctrl_signals.fp_op = FP_MSUB;
                        OP_NMSUB: ctrl_signals.fp_op = FP_NMSUB;
                        default:  ctrl_signals.fp_op = FP_NMADD;
                    endcase
                    // FMA ops always round; reserved static rm (101/110) is illegal.
                    if (instr[14:12] == 3'b101 || instr[14:12] == 3'b110) begin
                        ctrl_signals.illegal_instr = 1'b1;
                    end
                    if ((instr[26:25] != 2'b00) && (instr[26:25] != 2'b01)) begin
                        ctrl_signals.illegal_instr = 1'b1;
                    end
                end
                OP_FP: begin
                    ctrl_signals.exec_class = EXEC_FP;
`ifndef FP_OOO
                    ctrl_signals.serializing = 1'b1;
`endif
                    ctrl_signals.fp_double = (instr[26:25] == 2'b01);
                    ctrl_signals.rfWrite = 1'b0;
                    ctrl_signals.pc_source = PC_plus4;
                    ctrl_signals.rd_source = RD_ALU;
                    ctrl_signals.fp_uses_rs1 = 1'b1;
                    ctrl_signals.fp_uses_rs2 = 1'b1;
                    ctrl_signals.fp_writes_fpr = 1'b1;
                    unique case (instr[31:27])
                        5'b00000: ctrl_signals.fp_op = FP_ADD;
                        5'b00001: ctrl_signals.fp_op = FP_SUB;
                        5'b00010: ctrl_signals.fp_op = FP_MUL;
                        5'b00011: ctrl_signals.fp_op = FP_DIV;
                        5'b01011: begin
                            ctrl_signals.fp_op = FP_SQRT;
                            ctrl_signals.fp_uses_rs2 = 1'b0;
                        end
                        5'b00100: begin
                            unique case (instr[14:12])
                                3'b000: ctrl_signals.fp_op = FP_SGNJ;
                                3'b001: ctrl_signals.fp_op = FP_SGNJN;
                                3'b010: ctrl_signals.fp_op = FP_SGNJX;
                                default: ctrl_signals.illegal_instr = 1'b1;
                            endcase
                        end
                        5'b00101: begin
                            ctrl_signals.fp_op = instr[12] ? FP_MAX : FP_MIN;
                            if (instr[14:13] != 2'b00) begin
                                ctrl_signals.illegal_instr = 1'b1;
                            end
                        end
                        5'b01000: begin
                            ctrl_signals.fp_op = FP_CVT_F_F;
                            ctrl_signals.fp_uses_rs2 = 1'b0;
                            if (!(((instr[26:25] == 2'b00) &&
                                      (instr[24:20] == 5'b00001)) ||
                                  ((instr[26:25] == 2'b01) &&
                                      (instr[24:20] == 5'b00000)))) begin
                                ctrl_signals.illegal_instr = 1'b1;
                            end
                        end
                        5'b11000: begin
                            ctrl_signals.fp_writes_fpr = 1'b0;
                            ctrl_signals.fp_writes_gpr = 1'b1;
                            ctrl_signals.rfWrite = 1'b1;
                            ctrl_signals.fp_uses_rs2 = 1'b0;
                            unique case (instr[24:20])
                                5'b00000: ctrl_signals.fp_op = FP_CVT_W;
                                5'b00001: ctrl_signals.fp_op = FP_CVT_WU;
`ifdef RV64
                                5'b00010: ctrl_signals.fp_op = FP_CVT_L;
                                5'b00011: ctrl_signals.fp_op = FP_CVT_LU;
`endif
                                default: ctrl_signals.illegal_instr = 1'b1;
                            endcase
                        end
                        5'b11010: begin
                            ctrl_signals.fp_uses_rs1 = 1'b0;
                            ctrl_signals.fp_uses_rs2 = 1'b0;
                            unique case (instr[24:20])
                                5'b00000: ctrl_signals.fp_op = FP_CVT_F_W;
                                5'b00001: ctrl_signals.fp_op = FP_CVT_F_WU;
`ifdef RV64
                                5'b00010: ctrl_signals.fp_op = FP_CVT_F_L;
                                5'b00011: ctrl_signals.fp_op = FP_CVT_F_LU;
`endif
                                default: ctrl_signals.illegal_instr = 1'b1;
                            endcase
                        end
                        5'b11100: begin
                            ctrl_signals.fp_writes_fpr = 1'b0;
                            ctrl_signals.fp_writes_gpr = 1'b1;
                            ctrl_signals.rfWrite = 1'b1;
                            ctrl_signals.fp_uses_rs2 = 1'b0;
                            ctrl_signals.fp_op = instr[12] ? FP_CLASS : FP_MV_X;
                        end
                        5'b11110: begin
                            ctrl_signals.fp_uses_rs1 = 1'b0;
                            ctrl_signals.fp_uses_rs2 = 1'b0;
                            ctrl_signals.fp_op = FP_MV_F_X;
                        end
                        5'b10100: begin
                            ctrl_signals.fp_writes_fpr = 1'b0;
                            ctrl_signals.fp_writes_gpr = 1'b1;
                            ctrl_signals.rfWrite = 1'b1;
                            unique case (instr[14:12])
                                3'b010: ctrl_signals.fp_op = FP_EQ;
                                3'b001: ctrl_signals.fp_op = FP_LT;
                                3'b000: ctrl_signals.fp_op = FP_LE;
                                default: ctrl_signals.illegal_instr = 1'b1;
                            endcase
                        end
                        default: ctrl_signals.illegal_instr = 1'b1;
                    endcase
                    // Reserved static rounding modes rm=101/110 are illegal for FP
                    // ops that round (arith, sqrt, all fcvt). rm=111 (DYN) is legal
                    // (uses frm). Ops that reuse instr[14:12] as a funct3 selector
                    // (sgnj/minmax/cmp/class/move) validate that field in their own
                    // case arm above and are excluded here.
                    if ((instr[14:12] == 3'b101 || instr[14:12] == 3'b110) &&
                        (instr[31:27] inside {5'b00000, 5'b00001, 5'b00010,
                             5'b00011, 5'b01011, 5'b01000, 5'b11000, 5'b11010})) begin
                        ctrl_signals.illegal_instr = 1'b1;
                    end
                    if ((instr[26:25] != 2'b00) && (instr[26:25] != 2'b01)) begin
                        ctrl_signals.illegal_instr = 1'b1;
                    end
                end
                // General system operation
                OP_SYSTEM: begin
                    if (instr[14:12] == 3'b000) begin
                        ctrl_signals.useImm = 1'b0;
                        ctrl_signals.rfWrite = 1'b0;
                        ctrl_signals.pc2RF = 1'b0;
                        ctrl_signals.memRead = 1'b0;
                        ctrl_signals.memWrite = 1'b0;
                        ctrl_signals.usePC = 1'b0;
                        ctrl_signals.imm_mode = IMM_DC;
                        ctrl_signals.alu_op = ALU_ADD;
                        ctrl_signals.ldst_mode = LDST_DC;
                        ctrl_signals.pc_source = PC_plus4;
                        ctrl_signals.rd_source = RD_DC;
                        // All trap/return/fence instructions serialize so the
                        // pipeline reaches a precise point before redirecting.
                        ctrl_signals.serializing = 1'b1;
                        if (instr[31:25] == 7'b0001001) begin
                            // SFENCE.VMA rs1, rs2
                            ctrl_signals.is_sfence_vma = 1'b1;
                        end else begin
                            unique case (instr[31:20])
                                12'h000: ctrl_signals.syscall = 1'b1;     // ECALL
                                12'h001: ctrl_signals.is_ebreak = 1'b1;   // EBREAK
                                12'h102: ctrl_signals.is_sret = 1'b1;     // SRET
                                12'h302: ctrl_signals.is_mret = 1'b1;     // MRET
                                12'h105: ctrl_signals.is_wfi = 1'b1;      // WFI
                                default: begin
                                    `display(rst_l, "Encountered unknown/unimplemented 12-bit itype function code 0x%03x.",
                                            itype_funct12);
                                    ctrl_signals.illegal_instr = 1'b1;
                                end
                            endcase
                        end
                    end else begin
                        ctrl_signals.exec_class = EXEC_CSR;
                        ctrl_signals.serializing = 1'b1;
                        ctrl_signals.useImm = csr_funct3[2];
                        ctrl_signals.rfWrite = (instr[11:7] != 5'd0);
                        ctrl_signals.memRead = 1'b0;
                        ctrl_signals.memWrite = 1'b0;
                        ctrl_signals.imm_mode = IMM_I;
                        ctrl_signals.pc_source = PC_plus4;
                        ctrl_signals.rd_source = RD_ALU;
                        unique case (csr_funct3)
                            FUNCT3_CSRRW:  ctrl_signals.csr_op = CSR_RW;
                            FUNCT3_CSRRS:  ctrl_signals.csr_op = CSR_RS;
                            FUNCT3_CSRRC:  ctrl_signals.csr_op = CSR_RC;
                            FUNCT3_CSRRWI: ctrl_signals.csr_op = CSR_RWI;
                            FUNCT3_CSRRSI: ctrl_signals.csr_op = CSR_RSI;
                            FUNCT3_CSRRCI: ctrl_signals.csr_op = CSR_RCI;
                            default: begin
                                ctrl_signals.illegal_instr = 1'b1;
                            end
                        endcase
                        ctrl_signals.csr_write = (ctrl_signals.csr_op == CSR_RW) ||
                            (ctrl_signals.csr_op == CSR_RWI) ||
                            (((ctrl_signals.csr_op == CSR_RS) ||
                              (ctrl_signals.csr_op == CSR_RC)) &&
                             (instr[19:15] != 5'd0)) ||
                            (((ctrl_signals.csr_op == CSR_RSI) ||
                              (ctrl_signals.csr_op == CSR_RCI)) &&
                             (instr[19:15] != 5'd0));
                    end
                end

                default: begin
`ifdef RV64
                    // RV64-only OP-32 (0x3B) and OP-IMM-32 (0x1B). Dispatched here
                    // on the raw opcode bits (they are not members of opcode_t,
                    // which lives in the DO-NOT-MODIFY riscv_isa.vh). W-form ops
                    // operate on the low 32 bits, result sign-extended to XLEN.
                    if (instr[6:0] == 7'h1B) begin            // OP-IMM-32
                        ctrl_signals.useImm    = 1'b1;
                        ctrl_signals.rfWrite   = 1'b1;
                        ctrl_signals.imm_mode  = IMM_I;
                        ctrl_signals.pc_source = PC_plus4;
                        ctrl_signals.rd_source = RD_ALU;
                        unique case (instr[14:12])
                            3'b000: ctrl_signals.alu_op = ALU_ADDW;            // ADDIW
                            3'b001: begin                                       // SLLIW
                                ctrl_signals.alu_op = ALU_SLLW;
                                // W-form shamt is 5 bits (instr[24:20]); the
                                // funct7 instr[31:25] is fixed 0000000, so any
                                // set bit there (incl. shamt[5]=instr[25]) is a
                                // reserved encoding -> illegal instruction.
                                if (instr[31:25] != 7'b0000000)
                                    ctrl_signals.illegal_instr = 1'b1;
                            end
                            3'b101: begin                                       // SRLIW/SRAIW
                                ctrl_signals.alu_op = instr[30] ? ALU_SRAW
                                                                : ALU_SRLW;
                                // funct7 must be 0000000 (SRLIW) or 0100000
                                // (SRAIW); any other bit set (incl. shamt[5])
                                // is reserved -> illegal.
                                if ((instr[31:25] != 7'b0000000) &&
                                    (instr[31:25] != 7'b0100000))
                                    ctrl_signals.illegal_instr = 1'b1;
                            end
                            default: ctrl_signals.illegal_instr = 1'b1;
                        endcase
                    end else if (instr[6:0] == 7'h3B) begin   // OP-32
                        ctrl_signals.rfWrite   = 1'b1;
                        ctrl_signals.pc_source = PC_plus4;
                        ctrl_signals.rd_source = RD_ALU;
                        if (instr[31:25] == 7'b0000001) begin // RV64M W-forms
                            unique case (instr[14:12])
                                3'b000: ctrl_signals.alu_op = ALU_MULW;
                                3'b100: ctrl_signals.alu_op = ALU_DIVW;
                                3'b101: ctrl_signals.alu_op = ALU_DIVUW;
                                3'b110: ctrl_signals.alu_op = ALU_REMW;
                                3'b111: ctrl_signals.alu_op = ALU_REMUW;
                                default: ctrl_signals.illegal_instr = 1'b1;
                            endcase
                        end else begin
                            unique case (instr[14:12])
                                3'b000: ctrl_signals.alu_op = instr[30] ? ALU_SUBW // SUBW
                                                                        : ALU_ADDW;// ADDW
                                3'b001: ctrl_signals.alu_op = ALU_SLLW;            // SLLW
                                3'b101: ctrl_signals.alu_op = instr[30] ? ALU_SRAW // SRAW
                                                                        : ALU_SRLW;// SRLW
                                default: ctrl_signals.illegal_instr = 1'b1;
                            endcase
                        end
                    end else begin
                        `display(rst_l & (instr != 'h0), "Encountered unknown/unimplemented opcode 0x%02x.", opcode);
                        ctrl_signals.illegal_instr = 1'b1;
                    end
`else
                    // Skip only the diagnostic $display for all-zero words: with
                    // the flat valid memory window, speculative fetches past the
                    // program image read back as zero and would otherwise spam the
                    // log / slow simulation. The illegal_instr flag itself is still
                    // asserted: 0x00000000 is a reserved (illegal) encoding that
                    // must trap. Wrong-path zero fetches are squashed before commit
                    // (OoO) so this never raises a spurious exception.
                    `display(rst_l & (instr != 'h0), "Encountered unknown/unimplemented opcode 0x%02x.", opcode);
                    ctrl_signals.illegal_instr = 1'b1;
`endif
                end
            endcase

            // Only assert the illegal instruction exception after reset
            ctrl_signals.illegal_instr &= rst_l;

            // An illegal instruction must not engage a blocking functional unit.
            // The FP pipe issues serially, so an illegal FP op routed to FU_FP
            // (then squashed and never executed) deadlocks the FP queue and stalls
            // older ops behind it; the same applies to FU_MEM/MUL/DIV. Re-route
            // every illegal op to the single-cycle ALU (FU_ALU): it raises the
            // illegal-instruction trap at commit with no writeback and no FU
            // dependence. (fu_class_for: clear mem -> not FU_MEM; EXEC_INT with a
            // non-mul/div alu_op -> FU_ALU, not FU_FP/MUL/DIV.)
            if (ctrl_signals.illegal_instr) begin
                ctrl_signals.exec_class    = EXEC_INT;
                ctrl_signals.alu_op        = ALU_ADD;
                ctrl_signals.memRead       = 1'b0;
                ctrl_signals.memWrite      = 1'b0;
                ctrl_signals.fp_op         = FP_NONE;
                ctrl_signals.fp_uses_rs1   = 1'b0;
                ctrl_signals.fp_uses_rs2   = 1'b0;
                ctrl_signals.fp_uses_rs3   = 1'b0;
                ctrl_signals.fp_writes_fpr = 1'b0;
                ctrl_signals.fp_writes_gpr = 1'b0;
                ctrl_signals.rfWrite       = 1'b0;
                ctrl_signals.csr_op        = CSR_NONE;
                ctrl_signals.csr_write     = 1'b0;
                ctrl_signals.serializing   = 1'b0;
            end
        end


endmodule: riscv_decode
