pachurii-knowledge/empty-sekai-lake/src/mem/niigo_dir_gg.sv

/**
 * niigo_dir_gg.sv  --  M3c GRANT-AND-GO MOESI directory / coherence point
 *
 * The verified grant-and-go directory (plans/multicore-ccd.md §3; formal/moesi_ccd_v2.m + v3.m).
 * Replaces the M1 dir-mediated/blocking niigo_dir.sv. Fabric-AGNOSTIC: it speaks clean message
 * channels (req/unblk/wb in, one msg+dst out) so the SAME module runs over the direct test
 * interconnect (protocol validation) and the wheel hub-funnel (fabric validation).
 *
 * Grant-and-go (§3.3): an L2/memory-sourced grant (GetS/GetM to DIR_I/DIR_S) commits the new
 * stable directory state and returns to ready IN THE SAME STEP -- no transient, no wait. The
 * requester collects its own Inv-Acks (D6 ack-to-requester); the dir never counts acks. Only a
 * cache-to-cache forward (GetS/GetM to a peer owner) or an Upgrade goes transient (DIR_S_D/DIR_M_D)
 * and waits for the requester's UNBLOCK to finalize. ownerNext (R-a) is resolved from the UNBLOCK's
 * onext. Lost-copy Upgrade (R-b): requester not a sharer -> served as GetM. Per-line serialised
 * (one busy line; a same-line request while busy chains); grant-and-go grants are NOT busy.
 *
 * Backing store = memory over the NMI bus (NINE; no L2 data array -- always data_present).
 */
`include "niigo_mem.vh"
`include "niigo_cmi.vh"
`include "niigo_ccd_m1.vh"
`default_nettype none
module niigo_dir_gg
    import RISCV_UArch::MEMORY_ADDR_WIDTH;
    import NIIGO_Mem::*;
    import NIIGO_CMI::*;
    import NIIGO_CCD_M1::*;
#(
    parameter int CORES    = NIIGO_CMI::NUM_CORES,   // 4 (id widths match ccd_msg_t)
    parameter int DIR_SETS = 16,
    // S1 (plans/smp-4core-bug-surface.md): set-associative directory. With DIR_WAYS >= the active
    // core count the dir can track EVERY line each core caches in a given dir set without eviction
    // -- each core holds <=1 line per dir set (the dir index determines the L1 index), so at most
    // CORES distinct lines ever collide there. It is therefore inclusive and never silently forgets
    // a live owner/sharer on an aliasing admit; the old direct-mapped (1-way) dir dropped the
    // resident entry whenever a different-tag line hit the same set -> stale read / lost dirty WB.
    parameter int DIR_WAYS = NIIGO_CMI::NUM_CORES
)(
    input  wire logic clk,
    input  wire logic rst_l,
    // ---- inbound message channels (class-separated; the fabric demuxes by VC) ----
    input  wire logic      req_valid,    input  wire ccd_msg_t req_msg,    output logic req_ready,   // C0
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
