pachurii-knowledge/empty-sekai-lake/(commit log)

2026-05-19 fixed syscall flag check and PC step size upon branches
    [riscv_core_4wide.sv]
2026-05-20 widened regfile interface, fixed ALU source selection, OoO execution now operational
    [active_list.sv, int_issue_queue.sv, load_store_queue.sv, ooo_alu_pipe.sv, ooo_dispatch_control.sv, ooo_writeback_bus.sv, phys_reg_file.sv, rename_map_table.sv]
2026-05-20 partially fixed branch mispredict recovery bugs, partially fixed LSQ
    [active_list.sv, branch_stack.sv, free_list.sv, load_store_queue.sv, riscv_core_ooo.sv]
2026-05-21 fixed freelist allocation blockage for stores with no register destinations
    [free_list.sv, ooo_dispatch_control.sv, riscv_core_ooo.sv]
2026-05-21 fixed indirect branch stalls causing frontend poisoning
    [int_issue_queue.sv, ooo_dispatch_control.sv, ooo_fetch_decode.sv, riscv_core_ooo.sv]
2026-05-21 fixed benchmark register usage discrepancies; fixed a bug where indirect jumps do not function as expected in jump tables with entries pointing to pc+4; full R10K-style OoO checkpoint impl without pr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
    [load_store_queue.sv, ooo_alu_pipe.sv, riscv_core_ooo.sv]
2026-05-23 saved test scripts; fixed free list distance casting error; conservatively handle nested branches for now by blocking branches dependent on other unresolved branches
    [free_list.sv, int_issue_queue.sv, riscv_core_ooo.sv]
2026-05-24 AMO/store commits now wait for registered DONE bit instead of combinational DONE; ecall now halts on a0=0xb (ACT self test failure) too; FENCE.I instructions now flush frontend and refetch from pc+4 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
    [active_list.sv, ooo_alu_pipe.sv, riscv_core_ooo.sv]
2026-05-24 added support for multi-cycle ALU instructions. RV32M compliant, Zaamo_Zalrsc_Zicsr_Zifencei compliant, RV32D/F pending fix.
    [active_list.sv, int_issue_queue.sv, niigo_fp_unit.sv, ooo_dispatch_control.sv, ooo_div_unit.sv, ooo_mul_unit.sv, ooo_writeback_bus.sv, riscv_core_ooo.sv]
2026-05-24 swapped out custom FPU for openhwgroup/cvfpu repo's implementation. Fixed a bug where decoding an fmax instruction halts the processor. tentatively RV32G compliant.
    [load_store_queue.sv, lzc.sv, niigo_fp_unit.sv, riscv_core_ooo.sv, riscv_decode.sv, rr_arb_tree.sv, rv32g_csr_file.sv]
2026-05-31 fixed tag/PC hash collisions, fixed SC/TAGE weights, updated with speculative history
    [riscv_core_ooo.sv, tage_sc_l_predictor.sv]
2026-06-04 add privileged ISA + Sv32 virtual memory to the OoO core Bring the out-of-order core up to the same M/S/U privileged feature set as the scalar core, then layer Sv32 paging on top. RV32G ACT stays gre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
2026-06-06 ooo: take memory/fault traps precisely and add misaligned-fetch exceptions The out-of-order core did not squash younger in-flight instructions when a non-serializing fault (load/store/page/access fau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
    [active_list.sv, branch_stack.sv, int_issue_queue.sv, load_store_queue.sv, niigo_fp_unit.sv, ooo_alu_pipe.sv, ooo_div_unit.sv, ooo_mul_unit.sv]
2026-06-06 ooo: add misaligned load/store support in the LSQ Split misaligned accesses into word-granular beats inside the LSQ rather than touching the word-addressed, DO-NOT-MODIFY main_memory model. Covers wi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
    [load_store_queue.sv, riscv_core_ooo.sv]
2026-06-07 ooo: complete privileged ISA (Sv32 A/D, PMP, counters, WFI) and validate vs RISC-V ACT
    Finish the CPU-architectural privileged feature set on the out-of-order core and
    validate it against the official RISC-V arch tests (Sail 0.11 reference model),
    which surfaced two real bugs the directed tests had missed. RV32G stays 247/247
    and the existing priv suite 18/18 throughout; ACT ZicntrS/ZicntrU pass.
    Phase A - instruction-fetch page/access faults on the OoO path:
    - Carry a fetch fault through a new ctrl_signals_t.fetch_fault[+cause]: on an
    ITLB perm_bad or a faulting fetch walk, ooo_fetch_decode collapses the block
    to a single trapping NOP at the entry PC, which ooo_alu_pipe turns into a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
    [load_store_queue.sv, ooo_alu_pipe.sv, ooo_fetch_decode.sv, priv_csr_file.sv, ptw.sv, riscv_core_ooo.sv, riscv_core_scalar.sv, riscv_decode.sv]
2026-06-07 ooo: fill the TLB with the walked VPN, not the live head address (fixes Svadu)
    The Svadu arch test self-check-failed after the A/D hang fix: a load's leaf PTE
    kept A=0 (read 0x8f, expected 0xcf). Root cause is an out-of-order TLB-fill race,
    not the A/D logic.
    The DTLB/ITLB were filled with fill_vpn taken from the *live* head address
    (mem_req_vaddr/pc_q). In the OoO core the requesting access can advance before
    its page-table walk completes, so a walk launched for VPN A could be filled
    against VPN B's address while carrying A's PPN/perm -- a wrong-VPN/wrong-PPN TLB
    entry. In Svadu, the store's walk (VPN 1, PPN 0x10000) landed tagged as the
    load's VPN 2, so the load hit a bogus entry, never w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
    [ptw.sv, riscv_core_ooo.sv]
2026-06-07 ooo: add a PLIC and wire external interrupts (Phase G)
    Add a Platform-Level Interrupt Controller (src/plic.sv) and route external
    interrupts into the core, replacing the hardwired irq_m_external/irq_s_external
    = 0. This is the first platform component toward booting Linux and unblocks the
    external-interrupt coverage of the Interrupts* arch tests (the injection macros
    are wired in a later phase).
    PLIC (single hart, two contexts: ctx0 = M-external, ctx1 = S-external):
    - Standard register map at base 0x0C000000 -- per-source priority, pending,
    per-context enable bits and threshold, and claim/complete. Combinational
    reads; committed stores snooped at the data port (mirrors clint.sv).
    - Sour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
2026-06-07 plic: add software pending-clear; wire ACT interrupt injection (Phase H)
    Make the external-interrupt injection usable by the arch-test framework and
    software. Add a write-1-to-clear companion to the PLIC software-pending word
    (BASE+0x1004), so a handler can deassert a software-injected source without a
    claim -- the framework's RVMODEL_CLR_*_INT path needs this (it clears the source
    directly rather than claim/complete).
    With this, the niigo ACT model macros are wired up (in the gitignored arch-test
    config references/.../niigo-rv32g/rvmodel_macros.h) to actually fire interrupts,
    replacing the previously empty stubs that made RVTEST_IDLE/WFI wait forever:
    - SET/CLR_MEXT_INT -> PLIC source 1,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
2026-06-07 docs+config: correct CLAUDE.md PMP/PLIC, version-control the niigo ACT config
    CLAUDE.md: the architecture map claimed pmp_checker was "wired into the scalar
    core only -- not yet in the OoO data/fetch paths". That note predated Phase B
    (commit 4788374), which instantiated DataPMP/FetchPMP in riscv_core_ooo.sv
    (data -> EXC_LOAD/STORE_ACCESS via the LSQ fault path, fetch -> EXC_INSTR_ACCESS).
    Corrected to reflect PMP on both cores, and added the PLIC to the priv/MMU list.
    Track the niigo ACT DUT config. references/riscv-tests is an external, gitignored
    checkout (and a nested git repo, so its files can't be tracked from here), yet
    config/cores/niigo-lake/niigo-rv32g/ is our own project artifact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
    [niigo-rv32g.yaml]
2026-06-07 docs: document the niigo ACT config edit-in-checkout / sync-before-commit flow
    Make the workflow explicit: edit the live niigo DUT config in the gitignored
    references/riscv-tests checkout (that is what build_riscv_tests.py reads, so no
    sync is needed to build), then run scripts/sync_act_config.sh before committing
    to copy the edits back into the version-controlled act-config/. Add a hard-
    constraint note in CLAUDE.md, flip the sync script's default direction to
    checkout -> act-config (with --to-checkout to restore a fresh checkout), and
    update the act-config README to match.
2026-06-08 pmp: enable the PMP ACT suite (NUM_PMP_ENTRIES + sail.json count)
    Phase L: ACT-validate the OoO core's existing PMP. The pmp/PMPSm/PMPS/PMPU
    suites gate only on Sm + NUM_PMP_ENTRIES>0 (no Smpmp extension), so:
    - niigo-rv32g.yaml: NUM_PMP_ENTRIES 0 -> 16, PMP_GRANULARITY 2 (= G+2,
    G=0/4-byte, matching pmp_checker.sv NA4 + fully-writable pmpaddr).
    - sail.json: memory.pmp count/usable_count 0 -> 16. This was the critical
    fix: the signature golden is generated by the Sail RUN model, and with
    count 0 Sail made every PMP CSR illegal and never enforced PMP, so all
    goldens were PMP-less while the (correct) DUT enforces it -> 0/65. After
    aligning both configs: 45/65, no RV32G(247)/priv(16)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
    [niigo-rv32g.yaml]
2026-06-08 pmp: fix NAPOT sizing, per-lane fetch PMP, and PMP-on-PTE-walk
    Three real PMP correctness bugs surfaced by the ACT pmp/SvPMP suites
    (45/65 -> 61/65, no RV32G(247)/priv(23) regression):
    1. pmp_checker NAPOT off-by-one: ignore mask was xor1[30:1] (= xor1>>1),
    halving every NAPOT region, so the upper half of a region (e.g. the 4th
    word of a 16-byte region) was wrongly excluded. The ignore mask is the
    full (k+1) trailing-ones = xor1[29:0]. Matches the Sail begin/size calc.
    2. Fetch-group PMP granularity: a 16-byte fetch group [pc..pc+12] was PMP-
    checked only at the block-base pc_q, so the other lanes inherited it; an
    X-granted -> X-denied transition inside one group (sub-16B PM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
    [ooo_fetch_decode.sv, pmp_checker.sv, ptw.sv, riscv_core_ooo.sv, riscv_core_scalar.sv]
2026-06-08 uart: add NS16550-subset console UART (Phase I)
    New src/uart.sv: a minimal memory-mapped 16550-subset UART in the device
    hole at 0x0D00_0000 (0x1000_0000 is arch-test RAM). It snoops the data
    store port like the CLINT/PLIC and serves a combinational load path:
    - THR byte writes -> $write to the simulation console (TX always ready;
    LSR reads 0x60 = THRE|TEMT, so polled SBI/early-console output works).
    - IER/LCR/SCR storage; IIR reports the THR-empty interrupt when enabled.
    - The THR-empty interrupt drives PLIC source 10 (the conventional NS16550
    line) -> mip.MEIP/SEIP; its loads mux into the OoO LSQ writeback.
    tests/uart_console.S exercises all three: console string, LSR readiness,
    and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
2026-06-08 ptw: suppress the A/D write (and don't update A/D) on a PMP-denied PTE
    The Svadu no-pmp-perm tests place an A/D-update-needed PTE in a PMP region
    without write permission: each access must fault (access fault) and must NOT
    update the PTE's A/D bits. Two bugs:
    - S_AD_REQ asserted mem_we unconditionally, so a PMP-denied A/D write still
    committed to memory (the A bit got set) before the walk aborted -> a later
    access saw A=1, skipped the update, and didn't fault. Gate mem_we on
    !pte_pmp_fault so the write is suppressed.
    - Gating mem_we naively oscillated the PMP result: PtwPMP's access type was
    derived from ptw_we(=mem_we), so suppressing the write flipped STORE->LOAD
    (entry grants R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
    [ptw.sv, riscv_core_ooo.sv, riscv_core_scalar.sv]
2026-06-08 sbi: minimal in-tree M-mode SBI runtime (Phase J)
    tests/sbi_runtime.S: a self-contained SBI firmware demonstrating the M->S
    boot hand-off and the legacy-SBI calls a kernel actually uses on this
    platform:
    - M-mode init: mtvec=SBI handler, medeleg (exceptions->S), mideleg
    (SEI/STI/SSI->S), mcounteren (S reads time), mstatus.MPP=S, mret->kernel.
    - SBI console putchar -> UART THR (0x0D000000) -> console.
    - SBI set_timer -> CLINT mtimecmp + MTIE; the M-timer fires, the handler
    relays it to S (mip.STIP) and disables MTIE; S takes a supervisor-timer
    interrupt (scause=0x80000005), re-arms far away (clears STIP), then issues
    SBI shutdown -> halt.
    Exercises the CLINT/UART and th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
2026-06-08 boot: DTB-driven reset->M-firmware->S-kernel boot flow (Phase K)
    scripts/make_dtb.py builds a minimal FDT (.dtb + asm .inc) for the platform
    (dtc is unavailable): 1 rv32imafd/Sv32 hart, RAM@0x8000_0000, and the CLINT /
    PLIC / NS16550 UART nodes at their niigo addresses.
    tests/boot_dtb.S exercises the boot protocol end to end: the M-mode SBI
    firmware hands off to an S-mode kernel with a0=hartid, a1=dtb. The kernel
    (1) validates the FDT magic, (2) parses the struct block for the "ns16550a"
    UART node, (3) builds an Sv32 identity page table (1024 4 MiB RWX megapages)
    and enables satp -- confirmed engaged by reading satp back, (4) re-reads the
    DTB under translation, prints "niigo boot ok" via th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
2026-06-09 harness: flat multi-MB image loader for Linux boot (Phase H1)
    Add a manifest-driven, no-size-cap flat image loader so a Linux-class
    kernel Image + DTB + initramfs can be staged into memory, beyond the
    fixed 512 KiB segment windows. Runtime DRAM is already a sparse flat
    associative array, so only the load path needed to grow.
    - main_memory.sv: initialize_flat_images()/load_flat_image() read an
    optional mem.image.manifest ("<hexbase> <file>" per line) and byte-load
    each blob into the sparse memory[] at its base. Absent manifest -> inert,
    so every existing test is unaffected.
    - Also harden the file-load EOF checks: they detected EOF with
    `$fread==0 && $ferror!=0`, but Verilator's $ferr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
    [main_memory.sv]
2026-06-09 uart: full NS16550A for the Linux 8250 driver (Phase H2)
    Grow the TX-mostly UART subset into a 16550A the Linux 8250/of_serial
    driver probes and drives. Use the reg-shift=2 / reg-io-width=4 layout
    (one register per 32-bit word): it is a well-supported Linux NS16550
    config and maps cleanly onto the word-addressed device bus, giving each
    register its own word address -- which is what makes read-with-side-effect
    work (the bus exposes only the word address, so registers byte-packed into
    one word are indistinguishable on read).
    - uart.sv: DLL/DLM divisor latch, FCR + IIR FIFO bits (reports 16550A),
    scratch, MCR loopback (passes the 8250 autoconfig MSR&0xF0==0x90 check),
    IIR priority (RX > TH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
2026-06-09 sbi/dtb: SBI v0.2 surface + rv64/initrd device tree (Phase H3)
    Define the boot contract a real kernel needs, validated on RV32 (the
    M-mode firmware design is XLEN-agnostic and is rebuilt RV64 at boot
    integration).
    - make_dtb.py: parameterized --xlen (rv32imafd/sv32 vs rv64imafd/sv39),
    --ram-base/--ram-size, optional --initrd-start/--initrd-end (chosen
    linux,initrd-start/end for an in-RAM cpio rootfs -> no block device),
    and --bootargs. rv32 stays the default so boot_dtb is unaffected.
    - tests/sbi_v2.S: an M-mode shim implementing the SBI v0.2 EID/FID surface
    a minimal kernel calls -- Base (get_spec_version, probe_extension), TIME
    (set_timer + the M-timer->STIP->S relay), HSM (hart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
2026-06-09 harness: long-run console-watch tooling + ecall-halt gate (Phase H4)
    A booting OS can't use the ECALL_ARG_HALT pass/fail halt: the kernel's
    SBI ecalls legitimately carry a0==10 (console '\n') or 11, which would
    spuriously stop the sim. Add a plusarg gate and a console-driven run flow.
    - ooo_alu_pipe.sv: wb_next.halted is ANDed with ecall_halt_en, set from
    !$test$plusargs("no_ecall_halt"). With the gate off, an a0 in {10,11}
    ecall is no longer flagged halted, so the commit-time ECALL trap (already
    gated on !halted) fires and the ecall traps to the M-mode SBI firmware
    normally. Default (no plusarg) preserves the directed/ACT halt.
    - scripts/run_linux.sh: optionally stage a flat image,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
    [ooo_alu_pipe.sv]
2026-06-09 rv64: build foundation -- XLEN switch + rv64 test assembly (Phase R1 start)
    Lay the groundwork for the RV64G datapath. All changes are inert for the
    default RV32 build (no -DRV64).
    - verilator.mk: RV64=1 -> -DRV64 (composes with OOO/SUPERSCALAR).
    - riscv_isa.vh: XLEN is now `ifdef RV64 64 `else 32, which reparameterizes
    the register file, the memory subsystem (WORD_BYTES=XLEN_BYTES,
    MEMORY_ADDR_WIDTH) and every module that widths off RISCV_ISA::XLEN.
    - Makefile: RISCV_ARCH/RISCV_ABI vars; RV64=1 assembles tests as
    rv64g/lp64 (default rv32i/ilp32).
    - tests/rv64_smoke.S: base-integer + a 64-bit shift (1<<40) that only
    behaves correctly at XLEN=64. Assembles to a 64-bit ELF.
    RV32 OoO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
2026-06-09 rv64: widen the scalar datapath to XLEN; fix SRLI/SRAI 6-bit shamt (Phase R1)
    Bring the in-order scalar core's base-integer datapath up to 64-bit under
    -DRV64 (default RV32 unchanged). The RV64 scalar core now fetches,
    executes the base-integer ISA at 64-bit, and halts on rv64_smoke
    (a0=10); RV32 stays green (scalar rv32_smoke + OoO RV32G 247/247).
    riscv_core_scalar.sv:
    - Ports widened to the memory subsystem's parameterized widths
    ([MEMORY_READ_WIDTH-1:0][XLEN-1:0] instr/data, [XLEN-1:0] data_store,
    [XLEN_BYTES-1:0] mask, [MEMORY_ADDR_WIDTH-1:0] addrs).
    - Word-address arithmetic generalized to >> $clog2(XLEN_BYTES); RV64
    packs two 32-bit instructions per 64-bit memory word, so instru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
    [riscv_core_scalar.sv, riscv_decode.sv]
2026-06-09 rv64: W-form ops (ADDW/SUBW/SLLW/SRLW/SRAW + *IW) on the scalar core (Phase R2a)
    Add the RV64-only word-form integer ops, gated behind -DRV64. They
    operate on the low 32 bits of the operands and sign-extend bit 31 of the
    32-bit result to all 64 bits.
    - internal_defines.vh: alu_op_t gains ALU_ADDW/SUBW/SLLW/SRLW/SRAW;
    ldst_mode_t gains LDST_D/LDST_WU (used by the R2b load/store path).
    - riscv_decode.sv: OP-32 (0x3B) and OP-IMM-32 (0x1B) decoded in the
    opcode case's default arm on the raw opcode bits (they are not members
    of the DO-NOT-MODIFY opcode_t), under `ifdef RV64`. SRLIW/SRAIW and
    SRLW/SRAW discriminate by instr[30] (5-bit W shamt).
    - riscv_core_scalar.sv: ALU computes the W-o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
2026-06-09 rv64: propagate XLEN widening to the 4-wide OoO core (base-I + W-ops + 64-bit load/store)
    Widen the out-of-order datapath from 32 to XLEN bits end to end so the RV64
    base-integer ISA, W-form ops, and 64-bit loads/stores execute correctly on the
    OoO core. rv64_smoke/wops/ldst all pass (a0=10); RV32 OOO stays 247/247.
    Mechanical widening (32 -> XLEN): active_list ROB result/pc/csr fields (were
    [31:0], truncating 64-bit results), ooo_types/superscalar_types packed structs,
    phys_reg_file, ooo_writeback_bus, ooo_fetch_decode (immediates + uses_rs1/rs2 for
    OP-32/OP-IMM-32 0x3B/0x1B), ooo_alu_pipe (W-ops, 6-bit shamt, 64-bit mul/div,
    sext32), load_store_queue (XLEN-generic mem_size/format/split +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
    [active_list.sv, ittage_predictor.sv, load_store_queue.sv, ooo_alu_pipe.sv, ooo_branch_recovery.sv, ooo_fetch_decode.sv, ooo_writeback_bus.sv, phys_reg_file.sv]
2026-06-09 rv64: M-extension + A-extension at 64-bit on the OoO core (Phase R3)
    Multiply: ooo_mul_unit widened to XLEN x XLEN -> 2*XLEN (the Wallace tree and
    the signed-magnitude wrapper are now XLEN-parameterized) and MULW added (the
    low 32 product bits depend only on the low 32 operand bits, so MULW is just a
    sign-extended slice of the full product).
    Divide: ooo_div_unit widened to XLEN (radix-16 restoring, XLEN/4 iterations,
    XLEN+4-bit partial remainder) and the W-forms DIVW/DIVUW/REMW/REMUW added by
    sign-/zero-extending the low-32 operands to XLEN at issue and sign-extending
    the 32-bit result at completion -- INT32_MIN/-1 then resolves through the
    divider naturally and only the full-width INT_MIN/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
    [load_store_queue.sv, ooo_div_unit.sv, ooo_mul_unit.sv, riscv_decode.sv]
2026-06-09 rv64: MXLEN=64 privileged CSR file (Phase R4)
    priv_csr_file/trap_controller and the cores' CSR/trap plumbing widen from 32
    to MXLEN (= XLEN), with the RV64 layout differences XLEN-gated so the RV32
    build is bit-identical:
    - mcause/scause interrupt flag at bit MXLEN-1; mepc/sepc/mtvec/stvec/mtval/
    mscratch/medeleg/mideleg/mie/mip/satp and the read/write/trap ports all
    MXLEN wide.
    - misa MXL=2 on RV64; mstatus gains read-only-2 SXL/UXL (the SD bit position
    and SSTATUS_MASK move to riscv_priv.vh as MXLEN-derived).
    - The RV32-only high-half CSRs (mstatush, menvcfgh, cycleh/timeh/instreth,
    mcycleh/minstreth and the hpm*h ranges) fall to the illegal default on
    RV64; cycle/time/instret r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
2026-06-10 rv64: ACT verification at RV64 — 289/289 unpriv + priv signature-verified (Phase R7)
    Adds the niigo-rv64g ACT DUT config (MXLEN/SXLEN/UXLEN 64, Sv39, ASID 16,
    PA 56, rv64 LR/SC reservation 2^3) and brings the whole rv64 suite up on the
    RV64=1 OOO=1 build:
    - rv64 unprivileged ACT: 289/289 PASS (I/M/F/D/Zaamo/Zalrsc/Zicsr/Zifencei).
    - rv64 privileged ACT: all 29 reference-runnable tests architecturally
    verified -- 14 pass the framework's runtime selfcheck and the other 15
    (sv39 fault-path tests) produce memory signatures BIT-IDENTICAL to the
    Sail golden reference; their selfcheck disagreement is framework
    trap-budget bookkeeping, the same class as the documented rv32
    InterruptsS/U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
2026-06-10 rv64: memory-mapped device bus under 8-byte words (CLINT/PLIC/UART)
    The device bus is one memory word wide, which is 8 bytes on RV64, so adjacent
    32-bit device registers pair up within a single bus word. CLINT, PLIC and the
    NS16550 UART are reworked to decode each bus word as XLEN/32 32-bit register
    subwords (identity at RV32):
    - Stores decode per subword via the byte mask, so a 32-bit `sw`/`writel` or a
    byte `sb` to either half of an 8-byte word hits the right register (e.g. an
    `sd` of a 64-bit mtimecmp, or a `writel` to PLIC claim-complete at offset 4).
    - Loads return every accessed subword's register value; the LSQ's existing
    format_load extracts the bytes the access wants, so a 32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
    [clint.sv, load_store_queue.sv, plic.sv, riscv_core_ooo.sv, riscv_core_scalar.sv, uart.sv]
2026-06-10 rv64 OoO: fix store-commit deadlock by latching the resolved PA
    The OoO commit unit retires a store and pulses commit_store gated only on
    store_port_busy. The LSQ commit-write, however, additionally required a live
    DTLB hit (head_xlate_ok) before performing the memory write and dequeuing the
    entry. Under Sv39 paging pressure (xv6's page tables churn the 16-entry DTLB)
    the store's DTLB entry can be evicted between its completion probe and the
    commit pulse, so head_xlate_ok is 0 exactly when commit_store fires: the ROB
    retires the store but the LSQ silently drops the write and never advances, an
    orphaned committed store wedges the in-order queue, and the core deadlocks.
    This is the xv6 hang at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
    [load_store_queue.sv, testbench.sv]
2026-06-10 rv64 OoO: fix load-return matching under Sv39 paging
    The data memory read port is DMEMORY_READ_DELAY (8) cycles deep. The LSQ
    matches a returning load against its in-order head entry by address
    (data_load_addr == head VA word). In the bare path data_load_addr is
    data_addr_P -- the request address pipelined by exactly that read latency --
    so a load only ever accepts the data for its OWN request. Under paging,
    lsq_data_load_addr instead used the live mem_req_vaddr, which always equals
    the current head, so the match succeeds for the FIRST valid response in the
    read pipe regardless of which request produced it. A still-draining response
    from a previous load to a different address is then accepte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
    [riscv_core_ooo.sv]
2026-06-10 rv64 OoO: attribute PTW walk results to the requesting access (boots xv6 to the shell)
    The shared Sv39 walker in the 4-wide OoO core exposes a completed walk's result
    (resolved PA / fault / ppn / perm / leaf level) combinationally, and the core
    consumed it for whatever fetch or load was live -- without checking the walk was
    actually launched for that access. Because fetches and loads are speculative, a
    walk can outlive its (squashed or advanced) request and leak its result to the
    wrong access. Two facets, both needed to reach userspace:
    walk CLASS (data vs fetch): data_from_ptw / fetch_from_ptw / ptw_fetch_done and
    the walk-fault terms gated on the *combinational* data-vs-fetch select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
    [ptw.sv, riscv_core_ooo.sv]
2026-06-11 update CLAUDE.md to reflect RV64G+Sv39 integration
    Mirror the README update (25cf0ea): RV32G->RV32G/RV64G build switch
    (RV64=1 -> -DRV64), the rv64 ACT suite (--elf-dir niigo-rv64g, 289/289),
    the SoC device bus (CLINT/PLIC/NS16550A UART), the Sv32/Sv39 PTW and the
    PMP-on-OoO paths (PtwPMP/DataPMP/FetchPMP), the in-place banner-header
    precedent (riscv_isa.vh/riscv_uarch.vh, originals under 447ref/), and the
    xv6 boot-to-$ baseline.
2026-06-12 OoO: handshaked memory boundary + niigo_memsys passthrough (fpga-memsys N1)
    Replace the fixed-latency 18-447 magic-memory interface of the OoO core
    with a handshaked, latency-agnostic boundary served by a new passthrough
    memory subsystem (src/mem/niigo_memsys.sv) that reproduces the legacy
    2/8-cycle response timing. First step toward L1 caches + an AXI4 (512-bit)
    master for the AWS F2 FPGA port; the in-order cores keep the legacy
    interface unchanged.
    - ifetch: valid/ready request per 16B block; in-order responses associated
    by arrival order via a kill-markable metadata FIFO + 2-entry group buffer
    with bypass, consumed explicitly on dispatch. Replaces the frozen 2-deep
    PC pipe (and clo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
    [load_store_queue.sv, niigo_memsys.sv, ooo_commit_unit.sv, riscv_core.sv, riscv_core_ooo.sv, testbench.sv]
2026-06-12 OoO: memory-latency fuzzer + fix ROB dropping held commit lanes (fpga-memsys N2)
    niigo_memsys gains a reproducible timing fuzzer, enabled with +mem_fuzz
    [+mem_seed=N +mem_min/+mem_max]: per-request response latencies in
    [min,max] (default [1,20]) through in-order per-port queues (I vs D vs
    PTW reorder against each other), ~25% request-acceptance stalls with a
    7-cycle starvation bound, and 1..8-cycle PTW ack delays. Fixed LCG
    streams seeded from +mem_seed -- no $random, so any failure replays
    exactly. Fuzz off remains cycle-identical to the N1 passthrough.
    run_riscv_test.sh forwards extra plusargs via NIIGO_VTOP_ARGS.
    The fuzzer immediately exposed a pre-existing ROB/commit-unit contract
    bug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
    [active_list.sv, niigo_memsys.sv, riscv_core_ooo.sv]
2026-06-12 OoO: L1I cache + NMI line bus + sim adapter (fpga-memsys C1)
    Add the split-cache memory subsystem's first half behind a new L1=1 build
    flag (-DL1_CACHES, OoO only). niigo_memsys now instantiates a blocking,
    read-only L1I (16 KiB, 4-way, 64 B PIPT lines, sync-read tag/data arrays,
    tree-PLRU) whose misses refill one 64 B line over the NMI line bus
    (nmi_arbiter -> nmi_mem_adapter) from main_memory's I-read port; the D and PTW
    ports stay on the proven N1/N2 passthrough. fence.i flash-invalidates the L1I
    via a new core ifetch_inval output. The N2 latency fuzzer carries through (the
    adapter fuzzes refill latency); L1=0 stays cycle-identical.
    C1 task 0 resolved: the RV64 frontend consumes only the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
    [l1_data_array.sv, l1_dcache.sv, l1_icache.sv, l1_plru.sv, l1_tag_array.sv, niigo_memsys.sv, nmi_arbiter.sv, nmi_mem_adapter.sv]
2026-06-12 OoO: write-back L1D + PTW-through-L1D + device bypass (fpga-memsys C2)
    Enable the data side of the split-cache memsys behind a new L1D=1 flag
    (-DL1_CACHES -DL1D_CACHE, OoO only). niigo_memsys now routes cacheable dmem
    ops (LSQ) and PTW PTE accesses through a blocking write-back/write-allocate L1D
    (16 KiB, 4-way, 64 B PIPT lines, tree-PLRU, per-line dirty); a miss writes back
    the dirty victim then refills, all over the shared NMI bus (L1I + L1D arbitrate
    onto one sim adapter that reads main_memory's I port and writes its D port).
    - PTW goes through the L1D (DD-5) so page-table stores held dirty in the L1D
    are seen by the walker by construction -- required for correctness under a
    write-ba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
    [l1_dcache.sv, niigo_memsys.sv, riscv_core_ooo.sv]
2026-06-12 OoO: cache HPM counters (C3) + NMI->AXI4-512 bridge & sim slave (X1)
    C3: wire L1I-miss / L1D-miss / L1D-writeback event pulses from niigo_memsys
    into priv_csr_file as real mhpmcounter3/4/5 (and the hpmcounter mirrors +
    RV32 high halves), gated by mcountinhibit[3-5]; AGENT_DEBUG prints an
    end-of-sim "L1 STATS" line. The event ports are left unconnected (-> 0) on the
    scalar / L1=0 builds, so those counters read zero exactly as before.
    tests/memsys/hpm_cache.S checks the L1D-miss counter tracks ~64 cold misses and
    that mcountinhibit[4] freezes it. Gates: rv32 ACT 247/247, Zicntr priv 2/2.
    X1: add the AXI4 master path behind a new AXI=1 flag (-DAXI_MEMSYS, requires
    the caches). nmi_axi_bridge m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
2026-06-12 mem: L1 arrays infer BRAM (per-way) + Vivado FB2 synth scaffolding
    FB2 finding: the L1 tag/data arrays read all WAYS in one cycle from a 2-D
    mem[SETS][WAYS], which Vivado synthesizes as a multi-read-port register file --
    l1_icache came out 41213 LUT / 149436 FF / 0 BRAM. Restructure each way as a
    separate single-read / single-write memory (generate loop), so each infers
    RAM. Functionally identical (per-way sync read; Verilator-transparent: rv32 ACT
    247/247, all tests/memsys/* pass on the rebuilt L1D=1).
    Vivado 2025.2 OOC synthesis (xcku11p UltraScale+, 125 MHz target) after the fix:
    l1_icache 2319 LUT / ~12 RAMB36 / WNS +4.785 ns
    l1_dcache 7367 LUT / 2227 FF / ~12 RAMB36 / W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
    [l1_data_array.sv, l1_tag_array.sv]
2026-06-13 OoO: L1I/L1D coherence for self-modifying code (fpga-memsys C4)
    Close the C2 KNOWN GAP: split L1I + write-back L1D were not coherent for
    self-modifying code without fence.i. Two pieces over the reserved NMI_PROBE seam,
    entirely within the cache modules + memsys arbiter (niigo_memsys port list
    unchanged, so the core/wrapper/testbench are untouched):
    C4a (producer visibility): the L1I miss RD_LINE is snooped by the L1D before it
    reaches memory. niigo_memsys drives a new l1_dcache probe_*/probe_clean port and
    masks the L1I out of the NMI arbiter until the probe is clean. The L1D probes from
    S_IDLE (new S_PROBE_LOOK/WB_REQ/WB_WAIT states reusing the WB datapath): a dirty
    hit is written back fir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
2026-06-13 FB2: bring RTL to Vivado synth standards + full-SoC top (niigo_soc)
    Source hygiene so the OoO core and the full SoC synthesize in Vivado 2025.2, with
    the simulation build kept behavior-identical (rv32 247/247, rv64 289/289, xv6
    boot-to-$ all unchanged):
    - Explicit `input wire` net type on 487 module input/inout ports across 45 files
    (Synth 8-6735), preserving the `default_nettype none` lint. Function/task args
    left untouched (a depth-aware transform skips them).
    - internal_defines.vh wrapped in `package Internal_Defines` (+ a $unit re-export
    for backward compat); OOO_Types imports it, so the package no longer references
    $unit symbols (Synth 8-10854).
    - ooo_alu_pipe: reuse the alread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
    [active_list.sv, axi_chk.sv, axi_mem_shim.sv, branch_stack.sv, busy_table.sv, clint.sv, free_list.sv, int_issue_queue.sv]
2026-06-13 docs: CLAUDE.md — FB2 full-core/SoC synth + niigo_soc
2026-06-13 FB2b: predictor tables to RAM (per-bank flatten) -- 85% fewer FF
    The TAGE-SC-L and ITTAGE predictor tables synthesized as ~350K flip-flops + LUT
    mux trees ("tage_tag_reg with 30720 registers") because of the 3D `[3][ENTRIES]`
    array shape + a variable bank index, inout-task read-modify-write updates, blocking
    assignments, and the array-wide reset clear -- none of which infer RAM.
    Rewrote both predictors' storage to be RAM-inferable, with the prediction/update
    LOGIC unchanged: separate per-bank 1D arrays (tage_tag_0/1/2[ENTRIES] etc.),
    saturating updates as pure FUNCTIONS feeding non-blocking writes, and the array
    reset dropped under SYNTHESIS (RAM powers up to 0 = the reset value; simulation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
    [ittage_predictor.sv, tage_sc_l_predictor.sv]
2026-06-13 fpga/synth: VU47P placed-timing flow + FB2b timing root-cause
    fpga/synth/synth_vu47p.tcl: synth + opt_design + place_design on the real AWS F2
    part (xcvu47p-fsvh2892-2-e) reporting WNS at each stage -- the only way to get a
    representative (placed) timing number, since OOC synth WNS is unplaced.
    Finding: niigo_soc fits the VU47P (~31% LUT, 2.4% FF, 64 BRAM, 111 DSP) but does
    NOT meet 125 MHz -- placed WNS -272 ns. Placement made it WORSE than unplaced
    (-240 -> -272), proving the worst path is genuine logic depth, not route pessimism.
    It is 1515 logic levels (643 CARRY8) threading 1656 LoadStoreQueue + 1300
    IntIssueQueue cells: the OoO issue wakeup/select + LSQ disambiguation evaluated in
    one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
2026-06-13 FB2b: LSQ head-skip ripple -> parallel find-first (behavior-identical)
    The skip-invalid head advance was a 16-iteration sequential loop that
    re-indexed entries_next[head_next] with a rippling index -- rebuilding a
    16:1 wide-struct mux and a head_next add every iteration (~16-deep combinational
    chain feeding the 7 downstream head-op blocks). Replace it with a parallel
    leading-invalid count: each slot is read at a CONSTANT offset (head_next + k)
    so the 16 validity reads are independent, and only the small leading-count
    accumulates. Same result (head must still reach the first valid head this cycle
    -- a store the ROB commits the same cycle its predecessor hole is skipped relies
    on it), just a f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
    [load_store_queue.sv]
2026-06-13 fpga/synth: incremental VU47P place flow for fast timing iteration
    synth_vu47p.tcl now writes a placed reference checkpoint (REF_OUT) after
    place_design; synth_vu47p_incr.tcl re-synths the edited RTL then anchors to
    that reference with read_checkpoint -incremental + place_design, so only the
    changed cells are re-placed (fast per-edit WNS checks during the LSQ/IQ
    flatten loop). report_incremental_reuse prints the reuse %. The fresh
    run remains the source-of-truth WNS and refreshes the reference; periodic
    re-baselining keeps reuse high when flatten-rebuilt renaming drifts.
2026-06-13 FB2b: defer LSQ head retire -> share the head entry mux (flatten)
    The per-op head blocks (fault / misaligned-AMO / SC-fail / load-complete)
    advanced head_next mid-block, so each block's entries_next[head_next] was a
    distinct index expression -> a 16:1 wide mem_entry_t mux + write-demux rebuilt
    per block (the 55 MUXF7/F8, 548-level head-op chain that was the post-divider
    worst path: abort_mask -> LSQ entries_q[*][addr]). Now they set a head_retire
    flag instead; head_next stays constant through blocks 1-6 (one shared head mux)
    and the advance is applied once before the store-commit block.
    Correctness-preserving: only one of blocks 1-6 fires per cycle (they share the
    single load_writeback port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
    [load_store_queue.sv]
2026-06-13 FB2b: LSQ store-commit reads committing store from entries_q (flatten)
    The store-commit block read store_lo_pa/store_data/store_mask/store_hi_pa/
    store_data_hi/store_mask_hi from entries_next[head_next]. entries_next recomputes
    the store_data/store_data_hi fields via format_store_split (a 128-bit byte-offset
    shift) combinationally every cycle in the re-derive loop, so the commit data /
    double_store_data outputs inherited that shift + the upstream wakeup/abort chain
    -- the post-deferred-advance worst path (abort_mask -> double_store_data_q[63],
    935 levels). For a committing store these fields were finalized cycles ago (its
    operands resolved long before it reached the ROB head; branch_mask==0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
    [load_store_queue.sv]
2026-06-13 fpga/synth: fast logic-levels measurement flow (synth+opt, no place)
    The per-iteration timing metric is worst-path LOGIC LEVELS + endpoint module
    from synth+opt+report_timing (no place_design): directive- and placement-
    independent, ~3-4 min, and robust to the STA noise from the core's pre-existing
    combinational loops (Verilator UNOPTFLAT / Vivado LUTLP-1). Full place
    (synth_vu47p.tcl, Quick) is reserved for periodic WNS confirmation. Incremental
    place (synth_vu47p_incr.tcl) is kept but unused -- flatten-rebuilt renaming drops
    cell-match below the 80% incremental threshold so it falls back to full place.
2026-06-13 FB2b: pipeline the MUL unit (multiply from registered operands, DSP)
    The mul unit computed the full signed 64x64 multiply COMBINATIONALLY in stage 0
    (pipe_q[0] <= packet_for() with a hand-written wallace_product + sign fixups),
    then idled MUL_LATENCY-1=2 delay stages. Fed by the abort->writeback->operand
    network, that single-cycle multiply was the post-iter2 worst path
    (abort_mask -> MulUnit/pipe_q[0][data], ~906 logic levels).
    Spread the datapath across the existing 3 stages: stage 0 captures operand
    magnitudes + product sign (registered); stage 1 does |lhs|*|rhs| via
    (zero-extended -> Vivado infers a pipelined DSP cascade); stage 2 sign-restores
    and selects MUL/MULH/MULHSU/MULHU/MULW. The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
    [ooo_mul_unit.sv]
2026-06-14 FB2b: flatten ActiveList head-skip + commit-walk (ROB cone)
    The flatten-none worst-path attribution showed the deep cone is the ActiveList
    (ROB), not the LSQ (flatten-rebuilt was merging ROB logic into LSQ-named cells):
    228 ActiveList cells on the 798-level worst path. Same monolithic-always_comb
    pathology as the LSQ, worse: a 32-deep head-skip ripple + commit-walk + pop +
    allocate threading head/tail with variable-indexed 32:1 wide-struct muxes.
    (A) Head-skip ripple -> parallel constant-offset leading-count (behavior-
    identical; same transform as the LSQ find-first). (B) commit-walk copies
    commit_packet fields from entries_q[walk_id] instead of entries_next: a presented
    entry is gated on e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
    [active_list.sv]
2026-06-14 FB2b: LSQ head-ops read REGISTERED head (registered-head pipeline)
    The per-op head blocks (fault / misaligned-AMO / SC / load-issue /
    store-complete / load-complete) read their conditions + data from a registered
    snapshot headq = entries_q[head_next] instead of the combinationally-updated
    entries_next[head_next]. This takes the load AGU / data_addr / store fields off
    the deep abort->squash->wakeup->format chain -- the FB2b LSQ worst path
    (abort_mask -> LSQ AGU -> L1D ADDRARDADDR, ~915 levels). A head op now fires one
    cycle after its operand REGISTERS (+1 load-use cycle); the LSQ is latency-tolerant
    (mem_inflight), so this is functionally safe. Head-op WRITES still target
    entries_next (mergin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
    [load_store_queue.sv]
2026-06-14 FB2b: parallelize the ActiveList commit-walk (prefix, constant offsets)
    The commit presentation was a SERIAL walk_id thread -- each lane's wide 32:1
    commit_packet mux index depended on the prior lane -- which was the post-iter5
    worst-path cone (ActiveList commit_valid/commit_packet, ~259 cells / 316 levels).
    The presented entries are CONTIGUOUS from head_next, so present lane i at the
    CONSTANT offset head_next+i (4 parallel muxes) with commit_valid a 4-deep
    prefix-AND: a lane presents iff every older lane presented and none halted/
    excepted. Same selection as the serial walk (stop-on-gap, stop-on-halt/exc).
    Condition reads entries_next[idx].valid (this-cycle squash honored); payload
    reads en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
2026-06-14 FB2b: pipeline issue->execute (S2 register + speculative ALU wakeup)
    Split the single-cycle select+wakeup+regread+execute ALU cone (historically the
    1533-level global worst path; the 2nd wall after the LSQ/ROB control cone) with a
    pipeline register between IQ select (S1) and the ALU pipes (S2). alu_issue_{valid,
    entry}_q feed ALU0/1, their phys-reg reads, and their CSR reads from the registered
    entry. Speculative ALU wakeup (spec_wake_*, FU_ALU consumers only) broadcasts an
    in-S2 ALU producer's dest one cycle early, so ALU->ALU dependent chains stay
    zero-bubble; the producer's result is bypassed at the consumer's own S2 regread.
    MUL/DIV/FP read operands at select (no S2 reg) so they wake on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
    [int_issue_queue.sv, ooo_alu_pipe.sv, riscv_core_ooo.sv]
2026-06-14 FB2b: IQ occupancy via popcount (drop the serial count_next RMW)
    count_next was a serial -1/+1 read-modify-write threaded through the squash,
    issue-select, and insert loops -- ~100 sequential conditional carries in one
    always_comb, sitting on the abort_mask -> IntIssueQueue/count_q worst path. It is
    write-only in the block (full() reads the registered count_q), and count_q ==
    popcount(entries_q.valid) holds by induction, so count_next == count_q - squashed
    - issued + inserted == popcount(entries_next.valid). Replace the RMW with a single
    popcount of the final valid bits at the block end (bit-identical; a sum of 1-bit
    valids synthesizes to a shallow adder tree).
    Flatten-none worst-path logic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
    [int_issue_queue.sv]
2026-06-14 FB2b: parallelize the IQ select (independent per-FU-class picks)
    The issue select was a serial `for port(5): for entry(16):` scan threading
    selected[]/branch_issued/issue_valid[] across all 80 iterations, so the last-
    scanned port (FP) inherited the entire chain -- the placed-WNS worst path was
    abort_mask -> FpUnit/req_int_src at -40.7 ns. Each IQ entry has exactly one
    fu_class, so the four port classes never contend for the same entry: pick each
    class independently. MUL/DIV/FP become independent 16-wide priority encoders
    (lowest ready entry of their class). The two ALU ports share a class -> a 2-pick:
    a0 = lowest ALU candidate; a1 = next lowest, excluding a0 and -- if a0 is a control
    transf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
    [int_issue_queue.sv]
2026-06-14 FB2b: parallelize the IQ insert (free-slot assignment)
    The insert was `for lane(4): for slot(16): first !valid -> fill; break` -- serial
    across lanes (lane N's slot depended on lane N-1's fill) and gated by the squash/
    select clears, so it sat on the abort -> IQ entries_q tail. Parallelize: free_mask =
    ~valid after squash+select; ins_free[k] = the k-th lowest free slot (priority
    encoders, each excluding the prior); a valid lane fills ins_free[its prefix rank]
    (= #valid lanes before it) -- exactly the serial "lowest free, in lane order". !full
    guarantees >= OOO_WIDTH free slots so all ins_free[] are valid; distinct ranks ->
    distinct slots, no write collisions. Bit-identical to the serial fill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
    [int_issue_queue.sv]
2026-06-14 FB2b: parallelize the ActiveList head-skip (priority mux)
    The ROB head-advance skipped leading invalid (squashed) slots with a 32-deep serial
    +1 accumulation (`for k: if (!done && skip_n<count && !valid[head+k]) skip_n+=1`).
    iter4 made the validity reads constant-offset, but the accumulation itself stayed
    serial -- and unlike a count RMW, full opt_design does NOT crush it, so it was the
    placed-WNS worst path (abort_mask_q -> ActiveList -> dispatch -> IQ count). Replace
    with a priority mux: head_skip_n defaults to count_next, a reverse scan leaves the
    lowest in-range valid k = the first-valid offset = the leading-invalid count.
    Behavior-identical (head_skip_n = min(first_valid_offset, count_n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
    [active_list.sv]
2026-06-14 FB2b: parallelize the LSQ head-skip (priority mux)
    The LSQ head-advance had the same 16-deep serial +1 head-skip accumulation as the
    ActiveList (iter12): replace it with a priority mux (head_skip_n defaults to
    count_next; reverse scan leaves the lowest in-range valid k = the first-valid offset
    = leading-invalid count). Behavior-identical; the multi-step skip is preserved (a
    store committed the same cycle its predecessor hole is skipped is not dropped).
    Placed Quick WNS -15.8 -> -12.5 ns. LSQ off the worst path; the wall is now a
    distributed L1I-fetch-FSM -> dispatch -> {IQ insert/wakeup, ROB allocate} -> count
    cone (no single serial chain remains -- the head-skips are now all parallel).
    Ve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
    [load_store_queue.sv]
2026-06-14 fpga/synth: guard opt_design against the pwropt segfault
    opt_design's power-optimization sub-task segfaults on niigo_soc ("Too many fanin/
    fanouts" pwropt HACOOException from the high-fanout abort_mask + the false comb
    loops, aggravated as the design's fanout grew). Raise pwropt.maxFaninFanoutToNetRatio
    so the exception path (and the segfault after it) is never taken; the full logic-opt
    phases are kept, so placed-WNS numbers stay comparable across the timing-closure run.
2026-06-15 FB2b: parallelize the ROB commit-pop and allocate (constant-offset)
    The ActiveList still threaded two 4-deep serial ripples through head_next/
    tail_next: the commit-pop advanced head_next +1 per retired lane (reading
    entries_next[head_next] each step), and the allocate advanced tail_next +1
    per dispatched lane. Both fed head_q/tail_q/count_q on the remaining FB2b
    worst-path cone (L1I-FSM -> dispatch -> ROB allocate/commit -> IQ count).
    Replace both with constant-offset writes, mirroring the iter6 commit-walk /
    iter10 IQ insert pattern:
    - commit_taken (retire_valid) is a strict prefix (the commit unit's
    stop_prefix halts every younger lane once one is held/halted/excepted), so
    retired la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
    [active_list.sv]
2026-06-15 FB2b D->Q pipeline (Phase 1): defer the ROB allocate entry-write
    First stage of the dispatch->insert (D->Q) pipeline that registers the
    rename -> queue-insert boundary (plans/dispatch-insert-pipeline.md). Splits the
    ActiveList allocate so the wide rename-packet entry write happens one cycle
    after the slot is reserved -- taking the rename cone off the entry-fill input
    path (the remaining FB2b worst-path cone: L1I-FSM -> dispatch -> ROB allocate ->
    count). +1 cycle ROB-presence latency only (commit is far from the tail, so no
    commit-rate cost; the rename pointers still advance in D, so count/full are
    unchanged and queue capacity is preserved).
    Mechanism:
    - Reserve in D: tail/count advance fro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
2026-06-15 FB2b Wall A (1/n): break false comb loops via phys-reg-read block split
    The 38 false combinational loops (Verilator UNOPTFLAT / Vivado LUTLP-1) corrupt
    post-place STA -- a re-opened checkpoint reports -42 ns through them while the
    real worst path is ~-12 ns, and the number oscillates by how the STA engine cuts
    the loop. The loops are FALSE (the design is exhaustively sim-verified); they
    exist only because Verilator/Vivado analyze dependencies at whole-block
    granularity, so a read of one signal inside the 700-line dispatch always_comb
    draws a spurious edge to every output of that block.
    iter7-style fix (restructure, NOT register -> value-identical, no IPC): hoist the
    phys-reg read-address fa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
    [riscv_core_ooo.sv]
2026-06-16 FB2b Wall A (2/n): decompose the dispatch always_comb into 7 blocks
    Split the 700-line monolithic dispatch always_comb into single-purpose
    combinational blocks along the real dataflow seams:
    B1 LaneDecode -- per-lane attrs, rename src regs, dispatch/valid
    counts, partial-resume
    B2 BranchPredictCheckpt -- RAS/GHR/predictor redirects, branch-stack
    snapshots, control-predicted lane attrs
    B3 RenamePackets -- rename packets + IQ/MemQ insert payloads
    B4 CommitArchTrapRRAT -- in-order commit, arch regfile/RRAT update,
    commit-time trap/return, precise-trap rollback
    B5 Interrupt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
2026-06-16 FB2b Wall B: register the LSQ load_writeback output (+1 load-use)
    Form the load result combinationally (store-to-load forward + DTLB PA + byte
    format) into load_writeback_comb, then register it to load_writeback_q which
    drives the writeback bus / wakeup / phys-reg / ROB-done one cycle later. Splits
    the deep LSQ-load -> wakeup -> IQ-select -> count cone that is the binding
    critical path now that Wall A is decomposed (post-place worst path was
    LoadStoreQueue/entries_q[addr] -> IntIssueQueue/count_q, 79 levels, 74% route).
    +1 load-use cycle. The head FSM is untouched: it advances on the combinational
    completion as before, so the ROB entry the writeback targets stays allocated
    (cannot retire or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
    [load_store_queue.sv]
2026-06-16 Revert "FB2b Wall B: register the LSQ load_writeback output (+1 load-use)"
    This reverts commit b04da60bb51bff1ab9db492fb06ad4e200a9c7de.
    [load_store_queue.sv]
2026-06-16 FB2b loop-break (1/n): split IQ select/insert + writeback-bus branch_writeback
    Value-identical (zero IPC) split of two module-internal whole-block aliases that
    closed false combinational loops:
    - int_issue_queue: the monolithic always_comb read insert_entry (insert) AND wrote
    issue_entry (select) in one block -> Verilator drew the false dispatch_issue_
    entries -> int_issue_entry edge present on every loop. Split into A (squash +
    wakeup -> entries_wake), B (select -> issue_entry + entries_sel), C (insert +
    flush + count -> entries_next). Select runs before insert, so issue_entry never
    depended on insert_entry; pure code motion makes the acyclicity structural.
    - ooo_writeback_bus: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
    [int_issue_queue.sv, ooo_writeback_bus.sv]
2026-06-16 FB2b loop-break (2/n): split LSQ load_writeback, dispatch B1, branch-checkpoint B2c
    Three more value-identical (zero IPC) module-internal splits:
    - load_store_queue: the main always_comb formed load_writeback from the REGISTERED
    head AND read the insert operands (insert_rs*_data) -> false phys_rs_data ->
    load_writeback edge (the wakeup cycle). Split into block 1 (squash/wakeup/head-
    ops/store-commit -> entries_premerge + load_writeback, registered state only) and
    block 2 (insert, the sole insert_rs*_data reader -> entries_next). The insert only
    ever fills free/tail slots, never the occupied head, so entries_premerge[head] ==
    entries_next[head]; value-identical. count split as co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
2026-06-16 FB2b loop-break (3/n): split branch_stack resolve / allocate
    Value-identical (zero IPC) split of the branch_stack monolith. It read the
    ALLOCATE snapshots (free_head/tail/count, active_tail, map) AND wrote the RESOLVE
    outputs (abort_mask / reset_mask / restore_*) in one always_comb -- a whole-block
    alias that drew the false free_head_snapshot -> stack_abort_mask edge, on the
    binding commit/recovery cycle. Resolve and allocate are independent (resolve
    depends only on resolve_*/meta_q; allocate only on the snapshots), so split via a
    meta_premerge handoff: block R (resolve) writes the resolve outputs + meta_premerge
    (post-resolve-clear) reading NO snapshots; block A (allocate + flush) fills a f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
    [branch_stack.sv]
2026-06-16 FB2b loop-break (4/n): split active_list commit-present / allocate
    Value-identical (zero IPC) split of the active_list (ROB) monolith. It read
    alloc_count (= this cycle's allocate_valid, in "count_next += alloc_count") AND
    wrote commit_valid in one always_comb -- a whole-block alias drawing the false
    dispatch_valid -> active_commit_valid edge, the last big edge on the commit/
    recovery cycle. commit_valid is presented from the PRE-alloc count (alloc_count is
    added AFTER the presentation, and a just-allocated entry is never `done` so never
    committable), so it is independent of alloc_count. Split via entries_premerge:
    block C (squash/head-skip/commit-present/commit-pop -> entries_premerge +
    cou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
    [active_list.sv]
2026-06-16 FB2b loop-break (5/n): drop branch_stack restore_valid flush-gate
    Break the branch_restore_valid <-> trap_take false comb loop by removing the
    "if (flush) restore_valid = 0" gate in branch_stack: gating restore_valid on
    flush(=trap_take) closed the cycle branch_restore_valid -> active_commit_valid ->
    retire_valid -> trap_take -> (flush) -> restore_valid. restore_valid is now a pure
    function of the registered resolve/meta_q state.
    Correctness-safe (NOT bit-identical, but no architectural effect): on a precise-trap
    flush every architectural consumer of branch_restore_valid already prioritizes the
    trap -- the rename-map/free-list restore muxes select the architectural (RRAT /
    committed-free-he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
    [branch_stack.sv]
2026-06-16 FB2b loop-break: route experiment (loops bind WNS) + LSQ-split design doc
    The "attack the route" experiment (fpga/synth/synth_vu47p_route.tcl: fresh synth +
    default place_design + phys_opt_design + ALLOW_COMBINATORIAL_LOOPS) gave placed WNS
    -19.65 / phys_opt -19.53 -- WORSE than place-Quick's -12.27. The aggressive placer
    chases the residual false-loop phantom paths (high-fanout, unplaceable) and degrades
    WNS. CONCLUSIVE: the route cannot be attacked while the false loops are live; the -12
    was a lucky loop-cut, not a real number. And since the loops INFLATE WNS, a clean DAG
    may reveal a real WNS well below -12.
    So the last loop (LSQ wakeup<->load_writeback) must be broken for any trustworth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
2026-06-16 FB2b: break the LSQ wakeup<->load_writeback false loop (3-block split)
    The last WNS-relevant false combinational loop. The monolithic LSQ block both
    read the wakeup-written entries array (squash/wakeup) AND formed load_writeback
    (head ops), so Verilator/Vivado aliased load_writeback onto the wakeup cone at
    whole-array granularity -- a false loop (every SCC signal is a comb fn of
    registered state; load_writeback is registered-head-derived).
    Split the single always_comb into three value-identical blocks:
    HD head-skip + registered head snapshot (headq) + per-op head blocks. Reads
    entries_q + abort_mask (inline squash-valid) + registered control state
    ONLY -> produces load_writeb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
    [load_store_queue.sv]
2026-06-16 FB2b: break the last false loop (retire_valid) -- UNOPTFLAT 26 -> 0
    The ActiveList commit block read commit_taken (the POP) AND wrote commit_valid
    (the PRESENT) in one always_comb -- a whole-block alias that closed the final
    false loop: commit_valid -> commit_unit -> retire_valid(=commit_taken) -> pop.
    The present runs BEFORE the pop reads commit_taken, so the alias is false.
    Split block C into:
    C1 (present): squash + reset + head-skip + commit presentation. Writes
    commit_valid / commit_packet + the post-squash/head-skip state
    (entries_squash / head_postskip / count_postskip). Reads entries_q +
    abort_mask/reset_mask + allocate_*_q (all registered) -- NO commit_taken,
    s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
    [active_list.sv]
2026-06-16 FB2b: IQ occupancy incremental count (value-identical depth cut, WNS-neutral)
    On the clean (0-loop) DAG the worst path is ALU writeback branch_mask -> IQ
    count_q (74 levels, 77% route) -- the branch-recovery broadcast: a resolved
    branch's abort_mask squashes every speculative structure, then the IQ occupancy
    recomputes. count_next was popcount(entries_next.valid), placing it at the END of
    the deep abort -> squash -> select -> insert chain.
    Compute count_next INCREMENTALLY instead: count_q - squashed - issued + inserted.
    Value-identical -- the surviving entries are count_q minus the squashed (abort) and
    issued (selected) entries, which are DISJOINT (a squashed entry reads valid=0 in
    entries_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
    [int_issue_queue.sv]
2026-06-17 FB2b R3: defer the IQ branch squash off the select input cone
    The clean-DAG worst path is the branch-recovery cone: ALU writeback branch_mask ->
    abort_mask -> squash IQ entries -> select -> insert -> IQ entries_q (~74 levels,
    77% route). The deep squash (zeroing every ~100-bit wrong-path entry) sat at the
    FRONT of the select's input (block A: entries_wake = squash(entries_q) + wakeup).
    Defer it: block A now computes entries_wake = entries_q + wakeup + reset_mask with
    NO zeroing; block B's sel_rdy gains a cheap 2-level abort gate
    ((entries_q[i].branch_mask & abort_mask) == 0, the original pre-reset mask to match
    the squash decision); block C applies the zeroing to entries_next BEFORE the
    fre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
    [int_issue_queue.sv]
2026-06-17 FB2b R3 (ROB): defer the active_list branch squash off head-skip/present
    Extends R3 to the ActiveList (63 cells on the IQ worst path). The deep squash
    (zeroing every ~100-bit wrong-path ROB entry in block C1) fed the head-skip and
    commit-present. Replace with a shallow per-slot sq_valid = entries_q.valid &&
    ((entries_q.branch_mask & abort_mask) == 0) (= the old entries_squash[i].valid);
    the head-skip and commit-present read sq_valid, and the deep zeroing is deferred to
    entries_premerge (block C2). Bit-identical: committed entries are never wrong-path
    (present gates on sq_valid), so the pop's entries_squash reads are unaffected, and
    entries_premerge -> entries_next -> entries_q is unchanged.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
    [active_list.sv]
2026-06-17 FB2b R2': de-serialize IQ insert -- ins_free reads the registered free mask
    The R3 cuts left the worst path as the IQ insert addressing: abort_mask -> squash
    -> select -> ins_free -> entries_q (ins_free's 4-deep priority encoders read the
    POST-squash/post-select free mask entries_next.valid, serializing them after the
    select). Change the free mask to the REGISTERED occupancy entries_q.valid, taking
    ins_free off that chain -- it now reads registered state, parallel to the select.
    Correct because !full => count_q <= INT_IQ_SIZE - OOO_WIDTH => at least OOO_WIDTH
    registered-free slots, so the insert never fails; the inserted ops just land in
    slots that were free LAST cycle rather than also-this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
    [int_issue_queue.sv]
2026-06-17 FB2b: parallelize the PLIC best_id argmax (serial NSOURCES scan -> log-depth)
    After R3+R2' the top 25 worst paths were all Plic/thresh_q[0][0] -> best_id ->
    claim read -> data_load -> LSQ device-read data (75-76 levels). Root: the per-
    context best (highest-priority, lowest-id eligible source) was a SERIAL running-max
    scan over all 31 sources -- best_pri/best_id chained through every iteration.
    Replace with a value-identical parallel argmax: per-source eligibility `elig`, then
    a leading-bits loop narrows `alive` to the eligible sources AT the max priority
    (for each priority bit MSB-first: if any alive source has it, drop those lacking
    it), best_pri = that priority and best_id = the LOWEST s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
    [plic.sv]
2026-06-17 FB2b R3 (LSQ): defer the block-W branch squash off the wakeup/rederive cone
    Completes R3 across all three speculative structures (IQ, ROB, now LSQ). After the
    IQ/ROB R3 + R2' + PLIC cuts, the worst path was ALU branch_mask -> LSQ store_data:
    block W zeroed wrong-path entries in entries_wake, and the store-field rederive
    (format_store_split, a ~XLEN-wide barrel shift -- the deep tail) READ that
    post-squash array, putting the squash on the rederive's input.
    Defer it: block W now applies reset/wakeup/rederive to all valid entries with NO
    abort zeroing; block M zeroes the wrong-path entries in entries_premerge (after
    entries_premerge = entries_wake, before head_delta/store-commit). Bit-identica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
    [load_store_queue.sv]
2026-06-17 FB1: F2 CL wrapper (cl_niigo) + OCL control plane + vUART + debug interface
    Wrap niigo_soc into the AWS F2 Custom Logic shell so it can boot xv6/Linux
    on-card, with a host console and a bring-up debug window.
    RTL (fpga/rtl/, outside the verilator glob):
    - cl_niigo.sv: CL top -- niigo_soc + ocl_csr + vUART FIFOs + a reset-gated 2:1
    AXI mux ({core master, DMA_PCIS preload}) -> sh_ddr (DDR4). Host preloads DRAM
    over PCIS while the core is held in reset, so the mux replaces the SmartConnect
    crossbar (no IP dep; matches the load-only-in-reset DMA-coherence non-goal).
    - ocl_csr.sv: AXI4-Lite slave (AppPF BAR0): CTRL go/soft-reset/clear, STATUS,
    cycle/instret counters, vUART TX/RX byte FIF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
    [axi512_mux.sv, cl_niigo.sv, niigo_host.c, niigo_ocl.h, niigo_soc.sv, ocl_csr.sv, riscv_core_ooo.sv, tb_ocl_csr.sv]
2026-06-18 FB2b #1: 2-stage ROB commit (register the recovery-root) -> placed WNS +0.99ns
    Register active_list's commit_valid/commit_packet -- the ROB-recovery root, the
    broadest combinational cone in the core (it fans into the commit unit, precise-
    trap/return detection, arch-map + free-list, CSR/FP commit, frontend redirect,
    and the full-pipeline flush in one cycle). Registering it cuts every consumer
    chain at its single shared root.
    To keep 4/cycle commit across the new register, the present is moved out one
    cycle as a single-head sliding window: each cycle POP the registered window at
    head_q on commit_taken, head-skip leading squashed/invalid, then PRESENT and
    REGISTER the next <=OOO_WIDTH contigu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
    [active_list.sv]
2026-06-18 fpga/synth: add synth_vu47p_routed.tcl (default place + phys_opt + route_design)
    The real routed-closure flow vs the place_design Quick estimate used in the
    flatten loop: synth (-fanout_limit 64 to replicate the abort_mask/branch_mask/
    head_q/wakeup broadcast cones) -> opt -> default place -> phys_opt (high-fanout
    driver replication) -> route_design -> post-route WNS. For measuring the true
    net delays on the 75%-route wall-#2 cone once a change lands near closure.
    Measured (post 2-stage-ROB-commit, clean DAG): default place+phys_opt+fanout64
    = -11.4ns -- WORSE than place_design Quick -8.680 (the default placer over-chases
    the high-fanout cone; fanout_limit 64 helps vs the old -17 but Quick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
2026-06-19 FB2b wall #2: pipeline the LSQ head translate (register DTLB+DataPMP result)
    The binding placed path after the ROB-recovery register was the LSQ head's
    translate-and-decide cone: entries_q[head][addr] -> mem_req_vaddr -> (core DTLB +
    DataPMP) -> xlate_fault -> head_done/head_retire -> reservation_addr_q, all in one
    cycle (the cache index is NOT on it -- VIPT does not apply; the L1D is already
    register-separated). Register the translate result INSIDE the LSQ and consume it
    one cycle later.
    New regs: xlate_pa_q / xlate_fault_q / xlate_stall_q / xlate_cause_q, plus a
    (xlate_head_q, xlate_probe_q, xlate_reqv_q) validity tag. mem_req_vaddr is a pure
    function of (head_q, store_probe_hi_q), so xla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
    [load_store_queue.sv]
2026-06-19 FB2b wall #2: split the CVFPU FMA across 2 stages -> 62.5 MHz cleared (Quick-place)
    After the LSQ head-translate pipeline, the binding placed path was the CVFPU FMA
    (ADDMUL) arithmetic -> arbiter (~83 levels, 24 CARRY8), running as ONE
    combinational block: PipeRegs=1 + PipeConfig BEFORE = a single register in front
    of the whole mul+add. Change ADDMUL to PipeRegs=2 + PipeConfig DISTRIBUTED so the
    two pipeline registers are spread THROUGH the FMA, splitting the mul+add into two
    combinational halves. Other opgroups stay at 1.
    FP is infrequent (xv6/Linux are integer-heavy), so the +1 FMA latency is a
    negligible IPC cost, and the area cost (one more FP pipeline stage) is comfortable
    on the VU47P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
    [niigo_fp_unit.sv]
2026-06-22 fix(ooo): age mul/div in-flight branch_mask by reset_mask (deadlock)
    A long-latency mul/div op holds its branch_mask for many cycles but did
    not clear resolved-branch checkpoint bits each cycle the way the ROB and
    issue queue do. abort_mask/reset_mask are 1-cycle pulses, so a missed
    reset leaves the held mask permanently stale.
    Deadlock sequence: a div/mul issues speculatively under checkpoint bit X;
    its branch resolves correctly (reset_mask frees X) but the unit keeps X
    in its packet mask; X is later reused by a younger mispredicting branch
    (abort_mask=X); the unit's stale mask matches, so it spuriously aborts
    and drops its writeback, while the ROB entry (mask correctly aged to 0)
    waits fo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
    [ooo_div_unit.sv, ooo_mul_unit.sv, riscv_core_ooo.sv]
2026-06-22 fix(ooo/fp): serialize FP issue + age branch_mask by reset_mask (deadlock)
    Same stale-branch_mask class as the mul/div fix, but the FP op's mask
    lives partly inside the opaque cvfpu tag pipeline (held across the long
    FDIV/FSQRT latency), which the wrapper cannot age in place. Two failure
    modes: a stale mask either false-aborts a live op (ROB-head deadlock) or
    fails to drop a wrong-path op whose active-id was reused (writeback
    corrupts the new op).
    Fix (wrapper-only; cvfpu untouched): run ONE FP op end-to-end
    (issue_ready gated on req empty + cvfpu !busy_o + buffer empty). With a
    single in-flight op there is no second op to collide via active-id reuse,
    and its authoritative mask is tracked i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
    [niigo_fp_unit.sv, riscv_core_ooo.sv]
2026-06-25 fix(decode/csr): trap reserved encodings, count minstret per-retire, neutralize illegal-op FU routing
    Five conformance/robustness fixes surfaced by a Spike+Sail lockstep directed
    campaign. All regression-green afterward: rv64 ACT 289/289, rv32 OOO 247/247,
    rv32 scalar (default) 247/247, Sv32 priv 28/28, rv64 Sv39 priv 0-fail, and xv6
    boots to the $ shell.
    - minstret: increment by the per-cycle retire count (retire_cnt, 0..4), not a
    flat +1 -- the 4-wide OoO core retires up to 4 instructions/cycle, so +1
    undercounts (delta 17 vs 66 over a 64-instr block). Adds a retire_cnt port to
    priv_csr_file; the OoO core sums retiring lanes, the scalar core passes 0/1.
    - Reserved W-form shifts SLLI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
    [priv_csr_file.sv, riscv_core_ooo.sv, riscv_core_scalar.sv, riscv_decode.sv]
2026-06-25 test(verif): Spike+Sail lockstep directed-test harness + rv64 campaign testlists
    Verification infrastructure for the rv64+Sv39 correctness campaign (drove the
    fixes in the previous commit and found zero remaining divergences across the
    directed suite + random campaign vs both golden models).
    - run_riscvdv.sh: ISS=sail|spike golden select; ASM= directed mode (run a
    hand-written .S straight through compile/golden/DUT/diff, skipping random
    gen); SEED= passthrough so single-iteration calls fan out across cores;
    SPIKE_EXTRA= for per-test spike flags; VTOP= override.
    - run_riscv_test.sh: VTOP= override so parallel runs target a private, immutable
    Vtop copy -- a stray `make` in one worker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
    [riscvdv_testlist_rv64_campaign.yaml, riscvdv_testlist_trimmed.yaml]
2026-06-25 feat(ccd): M1 two-core MOESI directory + L1D agent + 2-core harness
    First RTL of the CCD coherence subsystem, correctness-first (globally
    serialised dir-mediated protocol; the verified grant-and-go + ack-to-requester
    scheme is the M3 refinement). Standalone — single-core ACT/xv6 untouched.
    - niigo_ccd_m1.vh: M1 full-line CMI message + 3-valued owner-next (R-a) +
    core-op enums (the 128b flit layer is M3).
    - niigo_dir.sv: 2-of-4-core MOESI directory FSM (the formal-model §9 logic),
    R-a owner-next, NINE data sourcing over the NMI bus, small dir cache.
    - niigo_l1d_moesi.sv: private L1D agent (MOESI + snoop FSM, blocking),
    cache-to-cache as owner, LR/SC coherence-kill, AMO RMW.
    - niigo_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
    [niigo_ccd_top.sv, niigo_dir.sv, niigo_l1d_moesi.sv, tb_niigo_ccd_m1.sv, tb_niigo_dir.sv]
2026-06-25 feat(ccd): M2 VIPT alias-free L1 invariant (machine-checked, regression-neutral)
    Formalise the load-bearing VIPT invariant for the L1s. For the frozen geometry
    (16 KiB / 4-way / 64 B -> way_size = 4 KiB = page) the index lies in the page
    offset, so VA[idx] == PA[idx]: the L1s are already VIPT-equivalent (a core's
    VA-index and a coherence snoop's PA-index select the same set, no synonym
    search). M2 makes this machine-checked, not behavioural:
    - niigo_mem.vh: L1_VIPT_ALIAS_FREE = (way_size <= page) + rationale.
    - l1_dcache.sv / l1_icache.sv: initial assert(L1_VIPT_ALIAS_FREE) + document
    the VA-index / PA-tag / PA-snoop seam.
    Verified bit-identical: OoO RV32G 247/247 (passthrough) + OoO+L1D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
2026-06-25 docs: sync CLAUDE.md + readme.md with FB2b / riscv-dv / FB1 status
    Documentation-only update reflecting already-landed work: FB2b timing closure
    (SoC clearing 62.5 MHz at Quick-place via the 2-stage ROB commit, registered LSQ
    head-translate, and 2-stage CVFPU FMA), the riscv-dv random-instruction flow and
    the two OoO deadlocks it found, the F2 cl_niigo CL wrapper + OCL debug plane (FB1),
    and the mul/div + FP branch_mask aging notes. Also lists the VIPT L1 conversion as
    a future IPC-optimization lever (TLB/L1 overlap).
2026-06-26 feat(ccd): M3a wheel NoC fabric (128b multi-flit routers + ring/hub, flit-verified)
    The M3 wheel interconnect (plans/multicore-ccd.md §W), realised + flit-level
    verified. Replaces the M1 direct full-line star with the real 128b multi-flit
    NoC: a generic input-buffered, per-VC, credit-flow wormhole router instantiated
    as the 4 radix-4 core routers (ring C0-C1-C3-C2) + 1 radix-5 hub crossbar.
    - niigo_cmi.vh: + cmi_rhdr_t (the router-visible routing header packed in the
    head flit LSBs, so a router stays agnostic of the protocol payload) +
    NUM_VC_PHYS / CMI_VC2B (the ring dateline sub-VC). Additive, non-breaking.
    - cmi_router.sv: generic radix-N VC wormhole router. Role/dst-based route com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
    [cmi_router.sv, cmi_wheel.sv, tb_cmi_wheel.sv]
2026-06-26 feat(ccd): M3b M1 coherence over the wheel NoC (128b SerDes, transparency proven)
    Re-floor the M1 MOESI coherence subsystem (niigo_l1d_moesi agents + niigo_dir)
    onto the M3a wheel fabric: the agents and directory no longer share direct
    full-line ccd links -- they exchange the canonical 128b multi-flit CMI form
    across the radix-4 core routers via SerDes.
    - cmi_msg_tx.sv / cmi_msg_rx.sv: the message SerDes -- a ccd_msg_t <-> a CMI
    flit train (HEAD = ccd_ctrl_t packed above cmi_rhdr_t, + 4 body flits for the
    512b line when the op carries data). Credit-paced, single-message-in-flight
    (M1 is blocking + serialised, so each wheel endpoint sources <=1 message at a
    time -> per-endpoint traff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
    [cmi_msg_rx.sv, cmi_msg_tx.sv, niigo_ccd_wheel.sv, tb_niigo_ccd_wheel.sv]
2026-06-26 feat(ccd): M3c-A class-aware wheel routing (peer-dst C2->ring, non-C2->spoke)
    First M3c step (plans/multicore-ccd.md §5.2): the core-node router route-compute
    becomes class-aware for peer-core destinations. Only C2 cache-to-cache data rides
    the ring; every other peer-dst class — notably an InvAck (C4) addressed
    direct-to-requester under the grant-and-go ack-to-requester scheme — takes the
    spoke and relays via the hub (spoke->hub->dst spoke), never the ring. This keeps
    the ring CDG a single-class datelined DAG and gives InvAcks a deadlock-free
    spoke path.
    - cmi_router.sv: route_port() now takes the head's mclass; peer-dst routes to the
    ring only for C2_DATA, else to the spoke.
    - tb_cm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
2026-06-26 feat(ccd): M3c-B grant-and-go MOESI protocol core (S1-S6 green, fabric-agnostic)
    The verified grant-and-go protocol (plans/multicore-ccd.md §3/§4; formal/moesi_ccd_v2/v3/v4b.m)
    in RTL, replacing the M1 blocking/dir-mediated form. Fabric-agnostic clean message channels, so
    the SAME dir/agent run on a behavioural direct interconnect (this commit, protocol validation) and
    later on the wheel hub-funnel (M3c-C, fabric validation).
    - niigo_dir_gg.sv: grant-and-go directory. An L2/memory-sourced grant (GetS/GetM to DIR_I/DIR_S)
    commits the new stable state and returns to ready in the same step -- no transient, no UNBLOCK;
    the requester collects its own Inv-Acks (D6 ack-to-requester, the dir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
2026-06-26 feat(ccd): M3c-C grant-and-go concurrency proof (deferred-snoop + concurrent AMO)
    Validate the grant-and-go protocol's distinctive non-blocking machinery under genuine concurrency
    (the paths NO sequential test can reach), with firing witnesses so a pass cannot be vacuous.
    - niigo_ccd_gg_direct.sv: + RESP_DLY (the COH_FORCE hook) -- holds an L2-sourced DATA grant a
    configurable number of cycles before delivering it, so a peer's snoop lands on a requester still
    mid-acquire (IS_D/IM_*). S1-S6 stay green at RESP_DLY=4 (correctness is latency-independent).
    - niigo_l1d_gg.sv: two correctness fixes surfaced by the concurrency tests:
    (1) a deferred snoop served in the SAME cycle as the IS_D i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
    [niigo_ccd_gg_direct.sv, niigo_l1d_gg.sv, tb_niigo_ccd_gg.sv]
2026-06-26 fix(ccd): M3c-D1 grant-and-go review fixes (DIR-1/AGT-1/DLK-1 + UNBLOCK requester-match)
    Fixes from the adversarial RTL-vs-formal-model review (all skeptic-confirmed real, none caught by
    the prior S1-S6/C1/C7 suite -> the green tests were valid but incomplete), plus a deeper bug the
    new regression tests exposed. Each fix has a regression test.
    - DIR-1 (niigo_dir_gg.sv, clean Put): a clean PutS/PutE no longer demotes a line that has a dirty
    owner (DIR_O, or DIR_EM owned by another core) to DIR_S -- that dropped the owner and a later cold
    reader got stale memory (breaks v3 PutS/PutE; I1/I2/I5). Only DIR_EM&&owner==R or the last DIR_S
    sharer leaving collapses to DIR_I; otherwise the line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
    [niigo_dir_gg.sv, niigo_l1d_gg.sv, tb_niigo_ccd_gg.sv]
2026-06-26 feat(ccd): M3c-D grant-and-go MOESI over the real wheel NoC (hub-funnel + ring)
    Wire the fabric-agnostic grant-and-go directory (niigo_dir_gg) + non-blocking agents (niigo_l1d_gg)
    onto the real wheel fabric (cmi_wheel: 4 radix-4 core routers in the ring + radix-5 hub) via the
    M3c-D funnel modules (plans/multicore-ccd.md §5). The protocol now runs over the actual 128b
    multi-flit NoC -- directory traffic on the spokes (the hub 4->1 arbiter is the serialisation point),
    cache-to-cache C2 data over the ring, InvAcks (C4) spoke->hub->spoke.
    - cmi_agent_downlink.sv: core Local-out flits -> {snoop(VC1), resp(VC2/VC2B), ack(VC3)} via three
    VC-gated cmi_msg_rx (per-endpoint per-VC traffic is seria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
2026-06-26 feat(ccd): M3d Stage-1a agent sub-word stores (c_req_wmask byte-merge)
    First M3d step (plans/multicore-ccd.md M3d Stage 1, §3.1): the grant-and-go L1D agent gains a
    per-byte write-enable so it can serve the real OoO core's byte/half stores (the core's dmem port
    carries dmem_req_wmask; the agent previously only wrote full XLEN words).
    - niigo_l1d_gg.sv: + c_req_wmask port; wmrgm() masked-merge helper; carry the byte-enable through
    the demand MSHR (m_be_q, captured at allocate); byte-merge at the live store sites -- hit-M/hit-E
    (cww_be=c_req_wmask) and the store-MISS install/ReachM (cww_be=m_be_q, postline via wmrgm so a
    deferred snoop forwards the correctly-merged line); the cache-arr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
    [niigo_ccd_gg_direct.sv, niigo_ccd_gg_wheel.sv, niigo_l1d_gg.sv, tb_niigo_ccd_gg.sv, tb_niigo_ccd_gg_wheel.sv]
2026-06-26 feat(ccd): M3d Stage-1b CCD_AGENT D-side arm (grant-and-go MOESI L1D drives OoO core; RV32G 247/247)
    Put the M3c grant-and-go MOESI L1D agent on the OoO core's data side behind a new
    CCD=1 build flag, replacing the C2 write-back L1D. Single core: coherence is inert
    (cores 1..3 never become sharers, so the directory yields ack_count==0 and broadcasts
    no INV). Gated, ifdef-isolated, baseline-safe.
    Agent (niigo_l1d_gg):
    - writeback-all flush FSM (flush_req/flush_done): drain the demand MSHR, walk every
    set, Put each dirty (M/O) line on the demand uplink (dir K_DRAINPUT writes it back +
    acks), set the line I; clean lines already match memory. Block H held off while
    flush_req is high so th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
2026-06-26 feat(ccd): M3d Stage 2 typed dmem op + AMO M-hold (COP_AMO_RD; RV32G 247/247)
    The OoO core's D-side now drives the grant-and-go MOESI L1D agent with a typed
    memory op instead of Stage 1's bare write/load:
    - LSQ emits dmem_req_op (LOAD/STORE/LR/AMO_RD), threaded riscv_core_ooo ->
    riscv_core -> testbench/niigo_soc -> niigo_memsys; the CCD adapter decodes it
    to l1_core_op_e (map_dmem_op). Harmless + sunk in non-CCD (L1D/passthrough).
    - AMO M-hold: new agent op COP_AMO_RD (atom AT_AMO_RD) acquires the line in M
    (GetM/Upgrade) and returns the OLD word with NO RMW. The LSQ keeps its full
    amo_result ALU (MIN/MAX/.W the agent's amo() lacks) and writes the result via
    the commit COP_STORE o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
2026-06-26 feat(ccd): M3d Stage 3a LSQ snoop port + reservation coherence-kill (inert single-core)
    The agent-to-LSQ snoop tap and its first consumer (RVWMO LR/SC reservation kill).
    Structurally inert at NACTIVE=1 (no peer => the directory never snoops the sole core),
    so every single-core baseline is bit-identical.
    - Agent (niigo_l1d_gg): new outputs snoop_kill_valid/snoop_kill_laddr -- pulse when an
    inbound remote-WRITE snoop (FwdGetM/INV) is ACCEPTED (snoop_rdy_c, both defer + service
    time), carrying the line address. Excludes FwdGetS (a remote read is not a kill).
    - Wrappers (niigo_ccd_gg_direct/_wheel): expose the core-0 agent's snoop_kill (mirrors
    flush_done). Memsys CCD arm drives new outpu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
2026-06-26 test(ccd): M3d Stage 3b 2-core validation harness -- live reservation-coherence-kill
    A real-core multi-agent harness that gives the (otherwise inert single-core) Stage-3
    snoop path live teeth, and is the foundation for the M4 SMP harness.
    tests/tb_ccd_stage3.sv (module `top`, make ccd-stage3-test): ONE real riscv_core_ooo
    (core 0, full OoO core) sharing niigo_ccd_gg_direct #(.NACTIVE(2)) with a behavioural
    peer (core 1). Core 0's dmem is rerouted through a replicated launch adapter (faithful
    copy of the niigo_memsys CCD arm) into c_req[0]; ifetch is served self-contained from a
    hand-loaded position-independent litmus at the reset vector (no main_memory/loader/bootstrap
    coupling); PTW tied o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
    [tb_ccd_stage3.sv]
2026-06-26 feat(smp): M4a per-core mhartid parameter (HART_ID; default 0 = single core)
    The mhartid CSR (0xF14) now reports a per-core id threaded top-down instead of
    hardwired '0 -- the precondition for any SMP test (cores self-differentiate on
    mhartid). HART_ID parameter plumbed riscv_core -> riscv_core_ooo -> priv_csr_file;
    CSR_MHARTID returns HART_ID. Default 0 at every existing instantiation, so the
    elaborated mhartid mux arm is identical to the prior constant '0 -> bit-identical.
    An SMP top sets 0,1,2,3 per core. The scalar/in-order path is untouched (its
    priv_csr_file keeps the default 0).
    Gates (all green, bit-identical): CCD 247/247; passthrough OOO 247/247 + Sv32 priv;
    scalar 247/247. Single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
2026-06-26 feat(smp): M4-S1 expose per-agent snoop_kill array (SMP enabler)
    niigo_ccd_gg_direct now exposes snoop_kill_valid/laddr as per-agent [NACTIVE]
    arrays (was a single core-0 tap) so an N-core SMP harness can route agent[g]'s
    remote-write snoop into core[g]'s LSQ. The single-core CCD build / the Stage-3
    harness use index [0] -- the same signal as before, so this is bit-identical:
    niigo_memsys (NACTIVE=1) and tb_ccd_stage3 take [0]; the message-level tbs leave
    the array output unconnected.
    Gates: CCD 247/247; ccd-gg-test pass; make ccd-stage3-test pass (reservation-kill
    contended FAILS / negative-control SUCCEEDS, unchanged).
    [niigo_ccd_gg_direct.sv, niigo_memsys.sv, tb_ccd_stage3.sv]
2026-06-26 test(smp): M4-S4 real 2-core SMP harness + LR/SC spinlock (diagnoses B9 race)
    tests/tb_ccd_smp.sv (module top, make ccd-smp-test): TWO real riscv_core_ooo cores,
    each with a distinct mhartid (#(.HART_ID(g))), sharing the grant-and-go MOESI
    directory (niigo_ccd_gg_direct #(.NACTIVE(2)), per-agent snoop_kill array from M4-S1).
    Both run the same litmus (tests/litmus_smp_lock.S, hand-loaded at the reset vector)
    and self-differentiate on mhartid; they contend for an LR/SC test-and-set spinlock
    guarding a shared counter, doing ITERS protected increments each. Per core: a
    self-contained behavioural ifetch + a replicated launch adapter -> c_req[g], PTW
    tied off. The counter is read white-box from th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
    [tb_ccd_smp.sv]
2026-06-27 feat(ccd): M4-S5a defer SC resolution to commit-cycle (COHERENT scaffold; wide-window race closed)
    B9 commit-window race: an SC decided success/fail and wrote rd at its LSQ head,
    but the store fired later at commit; a remote snoop-kill in that window killed
    the reservation yet could not un-decide the already-success SC, so the store
    fired anyway (the SMP spinlock lost increments).
    Add a COHERENT parameter (default 0 => single-core builds elaborate the verbatim
    head-decision path, netlist-identical) threaded riscv_core -> riscv_core_ooo ->
    load_store_queue. In a COHERENT build the SC:
    - at the LSQ head, marks the ROB done with a completion-only writeback
    (has_dest=0 => no rd, no wakeup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
    [load_store_queue.sv, riscv_core.sv, riscv_core_ooo.sv, tb_ccd_smp.sv, tb_ccd_stage3.sv]
2026-06-27 feat(ccd): M4-S5b agent-authoritative SC -- B9 FIXED (SMP LR/SC counter==6, mutual exclusion holds)
    The S5a LSQ-recheck closed the wide-window reservation race but NOT the tight SMP
    atomic race (tb_ccd_smp still lost 2 increments): an LSQ-local re-check cannot be
    atomic with the remote store, because the reservation-kill (remote GetM -> NoC ->
    snoop) is not synchronized with the loser's SC commit -- under tight contention
    both cores commit their SCs before either snoop arrives, so both "win".
    Fix: in a COHERENT build the SC, at its commit-store cycle, issues a COP_SC (new
    DMEM_OP_SC) instead of a plain store. The AGENT performs the reservation
    check-and-store ATOMICALLY at the directory ser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
    [active_list.sv, load_store_queue.sv, niigo_memsys.sv, ooo_commit_unit.sv, riscv_core_ooo.sv, tb_ccd_smp.sv, tb_ccd_stage3.sv]
2026-06-27 feat(smp): M4-S6a multi-hart CLINT/PLIC (NUM_HARTS / NCTX params; single-hart bit-identical)
    Parametrize the two device modules for SMP so ONE shared instance can serve all
    harts (the shared-instance integration into the SMP top is S6b):
    - clint.sv: NUM_HARTS param (default 1). Per-hart msip[h] @ BASE+4*h and
    mtimecmp[h] @ BASE+0x4000+8*h; one shared free-running mtime @ BASE+0xBFF8.
    Outputs irq_m_timer/irq_m_software widen to [NUM_HARTS-1:0] (the cross-hart
    IPI mechanism: a hart writes another hart's msip). Address decode generalized
    to (kind, hart) via a decode() helper.
    - plic.sv: NCTX param (default 2) = 2 contexts/hart (even=M-external,
    odd=S-external). enable/t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
2026-06-27 feat(smp): M4-S6b-1 multi-port CLINT/PLIC load (NPORT param)
    Add an NPORT parameter to clint.sv and plic.sv giving each device N
    independent, packed combinational load ports (one per hart sharing the
    instance). NPORT=1 (the default) is byte-for-byte the single-port layout
    -- the per-core devices and the scalar core are bit-identical.
    PLIC claims are read-with-side-effect, so a port-priority arbiter
    (claimed_mask) prevents two ports double-claiming the same source: the
    loser's claim read ALSO returns 0 (port_claim_src couples the read value
    to the arbiter), giving a true no-double-claim guarantee.
    tb_clint_plic_smp now drives NPORT=4 and adds directed checks: two harts
    claiming different co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
    [clint.sv, plic.sv, tb_clint_plic_smp.sv]
2026-06-27 feat(smp): M4-S6b shared-instance SMP devices + cross-hart IPI litmus
    Lift the per-core CLINT/PLIC/UART to ONE shared instance at the SMP top,
    behind a build-scoped NIIGO_EXT_DEVICES switch (set only by the SMP test
    targets; the default build never sees the new ports or the external arm
    => bit-identical).
    riscv_core_ooo / riscv_core: when NIIGO_EXT_DEVICES is defined, the core
    does NOT instantiate its devices -- it EXPORTS its committed-store snoop
    (dsnoop_*) + per-port device-load query and IMPORTS the shared device's
    load result, mtime, and the four per-hart interrupt lines (ext_*). The
    external load result rides the existing clint_* carrier, so the data_load
    mux and the priv_csr_file wir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
2026-06-27 feat(smp): M4 #3 agent-authoritative AMO -- closes the RMW atomicity gap
    The Stage-2 AMO path (COP_AMO_RD acquire-M read + an LSQ-computed commit
    COP_STORE) left the read->commit-store window unprotected: AT_AMO_RD has
    NO snoop-replay, so a remote AMO landing in that window is a lost update.
    Demonstrated on a 2-core amoadd.w litmus: counter=3 of an expected 6.
    Fix mirrors the B9 agent-authoritative SC. A COHERENT AMO is routed
    through the agent's atomic COP_AMO (acquire M -> read OLD -> write
    amo(op,OLD,operand) -> return OLD, one action with snoop-replay during
    the acquire). The LSQ parks the AMO at the head (completion-only
    writeback, has_dest=0 so dependents sleep), issues COP_AMO at the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
    [active_list.sv, load_store_queue.sv, niigo_l1d_gg.sv, niigo_memsys.sv, niigo_soc.sv, ooo_commit_unit.sv, riscv_core.sv, riscv_core_ooo.sv]
2026-06-27 feat(smp): M4 #4 4-core scale-up (LR/SC + AMO + IPI at NCORE=4)
    Scale the SMP harnesses to 4 real cores via a -DNCORE4 build flag (the
    2-core regressions are preserved -- NCORE defaults to 2):
    make ccd-smp4-test LR/SC spinlock -> counter == 12
    make ccd-smp-amo4-test agent-authoritative AMO -> counter == 12
    make ccd-smp-ipi4-test hart0 broadcasts msip[1..3]; harts 1,2,3 each
    take the M-software trap, hart 0 does not
    So the grant-and-go directory + agents + the B9 LR/SC fix + the
    agent-authoritative AMO + the shared-CLINT IPI all hold under REAL
    four-core contention; the deferred >=3-core coherence bugs did not bite
    the spinlock/AMO.
    The 4-cor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
    [tb_ccd_smp.sv, tb_ccd_smp_amo.sv, tb_ccd_smp_ipi.sv]
2026-06-28 feat(smp): post-M4 P1 RV64-on-CCD -- the SMP litmi at XLEN=64
    Build the three real-core SMP litmus harnesses at RV64 (-DRV64) as the
    prerequisite for the RV64 xv6-SMP boot path. The grant-and-go MOESI fabric
    + agents were already XLEN-parameterized; this proves the B9 LR/SC fix and
    the agent-authoritative AMO/SC hold at 64-bit, and exercises the shared
    NPORT CLINT cross-hart IPI at RV64.
    - tb_ccd_smp{,_amo,_ipi}: replace the hand-coded RV32 IMEM table with a
    width-gated 32-bit prog[] stream + an XLEN-aware packer (RV32 = 1 insn/
    word; RV64 = 2 insns per 64-bit machine word). RV64 encodings: lr.d/sc.d/
    ld/sd (spinlock), amoadd.d (AMO); IPI encodings are width-identical.
    RV32 paths ar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
    [tb_ccd_smp.sv, tb_ccd_smp_amo.sv, tb_ccd_smp_ipi.sv]
2026-06-28 feat(smp): post-M4 P2 directory-derived I/D coherence -- single-core CCD xv6 boots to $
    The named xv6-SMP blocker ("C4 I/D coherence re-derived from directory
    traffic"), resolved on the single-core CCD path. Before this, the CCD build
    had NO cross-core/SMC I/D coherence: the L1I refill bypassed the directory
    (read straight from memory) and the committed-store->L1I snoop was tied off
    (niigo_memsys.sv). So exec (xv6 writes program text -> L1D line goes M ->
    jumps to it) fetched STALE memory; xv6 never issues fence.i, so single-core
    CCD could not boot. (The L1D=1 build avoids this via its C4 probe + snoop;
    this ports the same mechanism to the grant-and-go agent path.)
    Mechanism (all CCD-gated;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
    [niigo_ccd_gg_direct.sv, niigo_l1d_gg.sv, niigo_memsys.sv]
2026-06-28 feat(ccd): P4-incr1 remote-dirty cross-core I-fetch (SMC litmus PASS, RV32+RV64)
    The xv6-SMP capability that single-core P2 (directory-derived I/D coherence)
    did not cover: a code line one hart writes (and still holds DIRTY in its L1D)
    fetched coherently by ANOTHER hart, with no fence.i -- exactly cross-hart exec.
    Mechanism (validated inline; each core gets a REAL l1_icache behind the shared
    grant-and-go directory): on an L1I refill, probe the LOCAL L1D agent (P2); on a
    probe MISS, inject a COP_LOAD so the directory's GetS pulls the line cold-from-
    memory OR dirty-from-the-owner, install it locally, then probe-serve it. The
    L1I therefore NEVER reads backing memory directly -- a line another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
2026-06-28 feat(ccd): P4-incr2 niigo_ccd_memsys -- reusable multi-core coherent memsys
    Factors the per-core arm validated inline in P4-incr1 into a parameterized module
    (NACTIVE real cores sharing one grant-and-go MOESI directory) -- the vehicle the
    xv6-SMP harness instantiates. Per core: a REAL l1_icache, the registered launch
    adapter (cacheable dmem + PTW muxed onto the agent's one c_req, devices bypassed
    and their loads timed), the P2 coherent-L1I probe, the FwdGetM/INV snoop-invalidate,
    and the P4 remote-dirty I-fetch (probe local L1D; on a miss inject a COP_LOAD so
    the directory's GetS pulls the line cold-from-memory or dirty-from-the-owner, then
    probe-serve). Every L1I refill is agent-served, so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
2026-06-28 feat(ccd): P6 xv6 boot harness over niigo_ccd_memsys -- NCORE=1 boots to $
    The multi-core xv6 boot harness: NCORE real RV64G+Sv39 cores (per-hart HART_ID,
    COHERENT, NIIGO_EXT_DEVICES) over the niigo_ccd_memsys module + nmi_mem_adapter ->
    main_memory (the xv6 kernel image + in-RAM fs.img ramdisk, same mem.N/manifest as
    the single-core boot) + ONE shared CLINT(NUM_HARTS)/PLIC(NCTX=2N)/UART hub. xv6 is
    SMP by design (NCPU=8, harts self-register; CPUS only affects QEMU) so the existing
    kernel image needs no rebuild; all harts reset to the load_elf_mem trampoline and
    entry.S dispatches by mhartid. CLINT/PLIC use NPORT per-hart loads; the single-port
    UART is priority-muxed by a UART-window decode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
    [tb_ccd_xv6.sv]
2026-06-28 feat(smp): P6 xv6-SMP boots to $ -- 2 coherent harts over niigo_ccd_memsys
    The capstone: TWO real riscv_core_ooo cores (RV64G+Sv39) sharing one grant-and-go
    MOESI directory through niigo_ccd_memsys boot xv6 to the interactive shell and run a
    filesystem command. No kernel changes -- the existing single-core image boots N harts
    (xv6 is SMP by design: NCPU=8, harts self-register; all reset to the load_elf_mem
    trampoline, entry.S dispatches by mhartid). Every cross-hart mechanism the boot
    exercises was de-risked first: directory-coherent D-data, agent-authoritative LR/SC +
    AMO (B9), the shared multi-hart CLINT/PLIC, PTW-through-the-agent (Sv39), and the
    P4 remote-dirty I-fetch for cross-hart exe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
    [tb_ccd_xv6.sv]
2026-06-28 docs: refresh CLAUDE.md + readme.md for the multicore-CCD / xv6-SMP capability
    Both docs predated the entire multicore work and described only the single-core
    system. Brought current against the shipped state (M1-M4 + post-M4 P1-P6):
    CLAUDE.md: overview now notes the directory-MOESI CCD + 2-core xv6-SMP boot; Build
    documents CCD=1 (-DCCD_AGENT -DL1_CACHES, mutually exclusive with L1D=1) and the
    multi-core/SMP knobs (COHERENT, HART_ID, NIIGO_EXT_DEVICES, NCORE4/NCORE1); a new
    "CCD / SMP tests" subsection lists the ccd-*/smp-* make targets; the keep-green
    baseline adds single-core CCD 247/247 + the SMP litmi + the COHERENT=0 bit-identical
    invariant; the Architecture map gains a multicore-MOES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
2026-06-29 test(ccd): S2 non-dropping device-store FIFO + 4-core diagnostics in tb_ccd_xv6
    S2 (bug-surface attack-order #1): replace the combinational lowest-index priority
    MUX device-store hub -- which silently DROPPED simultaneous cross-core device stores
    (the loser retired its store as accepted; a dropped PLIC-complete wedges the UART
    source, a dropped msip loses an IPI) -- with the non-dropping FIFO from tb_ccd_smp_ipi
    (latch every per-core ds_en pulse, drain one/cycle; dst_drop must stay 0).
    Add tb-only diagnosability for the first 4-core run (per the playbook): a dir-busy
    fabric-deadlock watchdog (dumps dir + every agent state and $finish on a stuck busy
    slot), a per-hart liveness/heartbeat (ret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
    [tb_ccd_xv6.sv]
2026-06-29 test(ccd): gg4 4-core directed protocol harness (G1/S4/S3 coverage)
    Parameterize tb_niigo_ccd_gg to NACTIVE=NC (default 2 = the proven message-level
    baseline, behaviorally unchanged) with -DNC4 selecting 4 cores plus directed tests for
    the paths structurally unreachable at 2 cores: G1 (multi-sharer GetM/AMO ack-to-
    requester, acks>1), S4 (owner-in-O UPGRADE vs an invalid peer GetM -> FwdGetM lands in
    T_OM_A), and S3 (dirty-exclusive M line evicted while a peer GetS snoops the victim).
    Each carries precise coverage (s4_hit/s3_hit confirm the exact race window was hit;
    min_acks<0 confirms the multi-ack signed down-counter went negative-then-corrected) so
    a PASS is not a coverage hole. New make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
    [tb_niigo_ccd_gg.sv]
2026-06-29 fix(ccd): S4 -- demote an in-flight UPGRADE on FwdGetM (niigo_l1d_gg)
    A FwdGetM that lands on an agent mid-UPGRADE (owner in T_OM_A, or sharer in T_SM_AD)
    hands that agent every byte of its line to the remote writer, then block-D delivers the
    re-served upgrade as a no-data grant -- so the agent keeps its STALE line and ReachM
    writes the store onto it, corrupting the words the store does not touch. OP_INV already
    demoted T_SM_AD/T_OM_A -> T_IM_AD (re-fetch WITH install); OP_FWD_GETM did not -- that
    was the gap. Mirror the demote in OP_FWD_GETM. Inert single-core (NACTIVE=1 receives no
    forwards). Reproduced + fixed deterministically by ccd-gg4-test (s4_hit=1: a FwdGetM
    serviced in T_OM_A; word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
    [niigo_l1d_gg.sv]
2026-06-29 fix(ccd): S1 set-associative directory + S3 PUTM-honors-sharers (niigo_dir_gg)
    Two directory-robustness fixes the 4-core gg harness reproduced deterministically
    (plans/smp-4core-bug-surface.md), gated behind the inclusion invariant so single-core is
    bit-identical (RV32G CCD ACT 247/247 with both fixes).
    S1 (the #1 silent corruptor): the directory was direct-mapped (1 way/set) and non-
    inclusive -- a GetS/GetM for a line aliasing an occupied dir set (same index, different
    tag) treated it as a miss and OVERWROTE the resident entry with no recall, forgetting a
    live owner/sharer. A later reader then got a fresh grant from STALE memory (dropped dirty
    WB / two owners). Make the dir SET-ASSOCIATIV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
    [niigo_dir_gg.sv]
2026-06-29 test(ccd): gg4 S1 capacity-aliasing + S5 ReachM-orphan probes
    Extend the 4-core directed harness: S1cap (two lines colliding in one dir set -> a direct-
    mapped dir forgets a live dirty owner; needs MEMLINES=1024 so dir-aliasing lines get
    distinct backing) and an S5 probe (multi-ack acquire + phase-swept concurrent snoop, with
    an s5_orphan detector = an agent stuck in T_UNBLK with d_val_q set). S1cap reproduces S1
    (fixed in niigo_dir_gg); S5 did not reproduce here (s5_orphan=0, no hang) -- it needs a
    1-cycle ReachM alignment the message-level harness cannot force, so it is left to the xv6
    deadlock watchdog. Watchdog bumped to 200k cycles for the larger program.
    [tb_niigo_ccd_gg.sv]
2026-06-29 fix(ccd): S5 -- drain a deferred snoop orphaned on the install/ReachM cycle (niigo_l1d_gg)
    THIS is the NCORE=4 xv6 boot deadlock (the instrumentation watchdog caught it: dir busy
    on a cache-to-cache K_MD/K_SD, requester stuck in T_IM_AD/T_IS_D, a PEER idle with d_val=1
    & m_val=0 -- an orphaned deferred snoop). Mechanism: block C defers a snoop (d_val_n=1) on
    the SAME cycle the acquire installs (block D T_IS_D) or reaches M (block E); serve_deferred
    there reads the REGISTERED d_val_q==0 and misses it, the FSM advances to T_UNBLK (which
    never serves), and the transaction retires (m_val->0) with d_val_q still set -- stranding
    the snoop, so the snooping peer and the single dir busy slot hang for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
    [niigo_l1d_gg.sv]
2026-06-29 test(ccd): gg4 Bstorm (4-core hot-line churn) + deadlock state dump
    Bstorm hammers two L1-set-aliasing lines from all 4 cores (evict-vs-multi-cross-core-GetS,
    then an AMO/LR-SC/GetM atomic storm) -- the protocol-level analog of the NCORE=4 xv6 boot.
    It DETERMINISTICALLY reproduces the S5 deferred-snoop orphan (the boot deadlock) where the
    gentle S5 probe could not. Adds a rich watchdog state dump (dir busy/st/bkind/blad/breq +
    per-agent m_ts/m_lad/m_vlad/d_val/sr_pend + all interconnect channel valids) that pinpointed
    the orphan (hart idle with d_val=1). Coverage: s5_orphan / s3_hit confirm the windows are hit.
2026-06-29 test(ccd): add committed-PC + last load/store capture to the xv6 heartbeat
    Per-hart last committed PC (latched on retire) + last dmem load/store addr:data (from the
    tb port arrays, no XMR) in the heartbeat and watchdog dump. Localizes a spinning/slow hart
    to a kernel function (via kernel.asm) and shows its memory access pattern -- used to confirm
    that fs writes on the CCD memsys are slow (cold misses + ramdisk writebacks, ~13M cyc/op,
    plus timer-tick scheduling), NOT hung: echo>foo + cat->abc + RESULT_DONE all complete, and
    the hart parks in scheduler wfi at the $ prompt. tb-only; single-core builds unaffected.
2026-07-01 feat(ccd): L2 Inc 1 -- niigo_l2 transparent write-back NINE cache + tb_ccd_l2
    New niigo_l2.sv: line-granular write-back/write-allocate NINE L2, NMI slave up
    (facing niigo_dir_gg's mem master) / NMI master down (nmi_mem_adapter). FSM is a
    strict simplification of l1_dcache (no word-merge / byte-mask / probe / flush);
    reuses l1_tag_array + l1_data_array at 1024x8x512 and l2_plru. Not on any live
    path yet (instantiated only by the unit tb).
    tests/tb_ccd_l2.sv + 'make ccd-l2-test': drives the NMI slave against a
    random-latency behavioural backing memory; validates cold-miss fill, hit,
    write-read coherence, dirty-victim writeback round-trip durability, write-allocate
    without fill, and held-valid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
2026-07-01 feat(ccd): L2 Inc 2 -- gate niigo_l2 into gg_direct's mem leg (default OFF)
    Add an ifdef-defaulted L2_ENABLE param to niigo_ccd_gg_direct: a generate-if
    interposes niigo_l2 on the directory's NMI memory master, a generate-else ties
    mem_req_o straight to the directory (the original, bit-identical net). Default
    OFF; -DL2_CACHE flips it ON for EVERY gg_direct instance (single-core CCD, SMP
    litmus, niigo_ccd_memsys, xv6-SMP) with no call-site edit. The L2 sits BELOW the
    coherence point (owner cache-to-cache forwarding never reaches this leg), so it
    changes only memory-leg latency, not coherence; dd_busy keys only on the
    agent-facing OP_DATA channel, unaffected.
    OFF gate (bit-identical): single-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
    [niigo_ccd_gg_direct.sv]
2026-07-01 feat(ccd): L2 Inc 3 -- turn L2 on at the memsys memory backend + value-transparency
    Turn the transparent write-back NINE L2 on (make L2=1 -> -DL2_CACHE) and prove
    value-transparency. Inc 3's regression caught a real placement bug in the Inc 2
    gg_direct seam: the single-core niigo_memsys CCD build refills the L1I on a
    SEPARATE nmi_arbiter leg from the directory, so an L2 inside gg_direct (directory
    leg only) lets the L1I bypass it -- a fence.i store written back into the L2
    leaves memory stale for the bypassing I-fetch (Zifencei-fence.i FAILED L2-on).
    Fix: interpose the L2 at the TRUE shared-memory boundary of each memsys wrapper
    (below the L1I/directory arbiter), not inside gg_direct:
    * n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
    [niigo_ccd_gg_direct.sv, niigo_ccd_memsys.sv, niigo_memsys.sv]
2026-07-01 test(ccd): ccd-xv6-4-l2-build -- 4-core xv6-SMP + shared L2 boot harness
    NCORE=4 xv6-SMP harness with the L2 on (-DL2_CACHE): the L2 sits on
    niigo_ccd_memsys's directory NMI master, so all 4 harts' memory traffic flows
    through it. Validated end-to-end: boots to the interactive $ shell and runs
    'ls' listing the real fs.img (., .., README, cat, echo, forktest, grep, ...
    with correct inodes/sizes) across 4 coherent harts -- value-transparent vs the
    L2-off 4-core boot. Same --build-jobs 1 (32GB) memory caveat as ccd-xv6-4-build.
2026-07-01 docs: reflect 4-core xv6-SMP boot (with/without shared L2) in readme
    Bring-up status + roadmap: the directory-coherent cluster boots xv6-SMP to the
    interactive $ shell at both 2 and 4 cores -- all harts reach $ and run ls, with
    or without the optional shared L2 on the directory's memory leg. Drops the now-stale
    '>2-core boot' from the scale-out remaining-work list (replaced with usertests-under-SMP).
    Follows d75241a which documented the L2 in the cache/memory + CCD sections.
2026-07-01 perf(asap7): shrink RAS 128->32 entries (hint-only area+timing win)
    The return-address stack was over-provisioned at 128 entries. It is a pure
    prediction hint -- a RAS mispredict is caught and recovered at JALR resolve --
    so depth affects accuracy (call-nesting reach) but never architectural
    correctness. 32 is a standard RAS depth.
    ASAP7 payoff: cuts the ras_stack flop array 4x (128->32 x XLEN, ~6 Kbit of
    flops at RV64) and shrinks the fetch-cycle top-of-stack read mux 128:1 -> 32:1
    (the array maps to flops, not SRAM, since push/pop/branch-checkpoint want
    parallel access). The report flagged the 128-deep RAS as a medium cell-mapping
    + timing item (fpga/openroad/ASAP7_STATIC_ANALYSIS.md, cel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
    [riscv_core_ooo.sv]
2026-07-01 perf(asap7): FMA ADDMUL PipeRegs 2->3 -- lift the binding Fmax floor 41.7->69.9 MHz
    The CVFPU FP64 FMA was the whole-core binding Fmax floor on the ASAP7 7nm ASIC
    flow (~41.7 MHz placed-parasitic; generic ABC has no DSP and no register
    retiming). The niigo_fp_unit wrapper is fully handshake-based and pipeline-depth
    agnostic (serialized issue; out_valid/out_ready; flush_i clears all internal
    stages), so raising the ADDMUL DISTRIBUTED pipeline depth is functionally
    transparent -- CVFPU inserts the registers and the wrapper waits on out_valid.
    Measured per-block sweep (fpga/openroad/char.sh, 5 ns target, placed parasitics):
    PipeRegs=2 41.7 MHz (was the floor)
    PipeRegs=3 69.9 MHz <--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
    [niigo_fp_unit.sv]
2026-07-01 docs(asap7): progress log -- landed changes, FMA sweep, memory-cell feasibility+blocker
    Records the asap7-synth implementation results (RAS 128->32, FMA PipeRegs 2->3
    lifting the floor 41.7->69.9 MHz, the reverted mul decomposition + its lesson),
    the current per-block Fmax floor, and the single-core L1 SRAM-mappability
    analysis: L1I-data/L1D-data/L1D-tag are 1RW-mappable as-is (L1D data needs
    byte-lane banking), L1I-tag needs duplicate-tags. The real blocker to a
    measurable macro mapping is geometry/tooling -- the shipped asap7_sram_0p0 set
    (1024-deep, >=16b, no byte-write) doesn't fit the L1, and FakeRAM2.0 (to
    generate the right geometries) is not installed.
2026-07-01 feat(asap7): map L1 data arrays to single-port SRAM macros (NIIGO_SRAM_MACRO)
    The #1 ASAP7 area problem is that integrated-syn has no SRAM-macro step, so every
    inferred memory flop-maps -- the L1 data array alone is 131072 bits (4 ways x 64
    sets x 512 b) per cache, and l1_dcache/l1_icache TIMEOUT in ABC at 2400 s because
    of that flop mass.
    Add an NIIGO_SRAM_MACRO-gated single-port SRAM mapping in l1_data_array.sv: each
    (way, byte-lane) becomes a niigo_sram_64x8 (64 words x 8 bits, 1RW; FakeRAM2.0-
    generated ASAP7 collateral under fpga/openroad/sram/). Both L1 controllers drive
    read and write in disjoint FSM states, so the single shared address port is muxed
    (write index when writing the lan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
    [niigo_sram.cfg]
2026-07-01 feat(asap7): map the L1D tag array to a single-port SRAM macro
    Completes the L1D memory-cell mapping. Add a SNOOP_PORT parameter to
    l1_tag_array: SNOOP_PORT=0 (L1D, which ties its 2nd read port off) maps under
    NIIGO_SRAM_MACRO to a clean single-port niigo_sram_64x52 per way (RV64
    L1_TAG_BITS=52, full-word write; read and write are disjoint FSM cycles so the
    one address port is muxed). SNOOP_PORT=1 (L1I, default) keeps the inferred
    dup-tags -- its C4 coherence snoop read (ren2) can be concurrent with a fetch
    read, which a 1RW macro cannot serve without snoop arbitration (deferred).
    Measured (l1_dcache, synth-only, data + tag mapped):
    data 256 x niigo_sram_64x8 (4403 um^2) + tag 4 x niigo_s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
    [niigo_sram_tag.cfg]
2026-07-02 feat(asap7): interleave the L1I coherence snoop onto the single tag port
    Map the L1I tag array to a single-port (1RW) SRAM by removing its 2nd read
    port (ren2) and folding the C4/P2 coherence snoop read onto the one tag
    read/write port. The fetch path already tolerates variable latency (the core
    tracks outstanding fetches in an in-order fmeta FIFO and consumes responses on
    ifetch_resp_valid -- no fixed hit latency is assumed), so a snoop may steal a
    fetch cycle: the requester simply waits, and response order/count is preserved.
    Arbitration is install-write > snoop-read > fetch/replay-read:
    - a snoop read launched in cycle X changes tag_rdata only at X+1, and servicing
    a snoop deasserts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
    [l1_dcache.sv, l1_icache.sv, l1_tag_array.sv, niigo_l2.sv]
2026-07-02 perf(asap7): sync-read + write-only-update the TAGE/ITTAGE predictor tables
    Convert both branch predictors from async-read (which flop-maps under the
    integrated ASAP7 synth and infers only distributed LUT-RAM on FPGA) to a
    registered (sync) lookup read plus a write-only resolve update, so every
    predictor table becomes a clean 1R1W memory: a registered read port (lookup)
    and a write port (update) at independent addresses. This infers dense block RAM
    on FPGA and is directly mappable to a 1R1W SRAM macro for the ASIC flow (the
    306 Kbit ITTAGE target arrays are the #1 remaining flop-mapped memory).
    tage_sc_l_predictor / ittage_predictor:
    - Stage 1 keeps the index/tag hashes combinational; a ne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
    [ittage_predictor.sv, riscv_core_ooo.sv, tage_sc_l_predictor.sv]
2026-07-04 feat(rv64c): add the RV64C compressed instruction extension
    Add an -DRVC-gated (RVC=1, requires RV64=1) RV64GC frontend. A two-wide
    expand-before-decode realign stage (rvc_realign) drains the 16-byte fetch
    group as 2-byte parcels and emits up to two canonical 32-bit instructions
    per cycle into the UNCHANGED riscv_decode/rename/execute/commit path, fed by
    a pure-combinational 16->32 expander (rvc_expand) covering all C0/C1/C2
    quadrants -- RV64-specific c.ld/c.sd/c.ldsp/c.sdsp/c.addiw/c.subw/c.addw
    included, illegal/reserved/HINT handled.
    A 32-bit instruction straddling a 16-byte block / cache line / page is
    carried by a single dangling-half latch (with its own fetch-fault status,
    flushed on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
2026-07-08 perf(ooo): add per-cycle microarchitectural counters + RV64GC benchmark harness
    Extend the SIMULATION_18447 perf block in riscv_core_ooo with ROB/IQ/LSQ/
    branch-stack occupancy, freelist/dispatch-stall, commit-starvation (front vs
    back-end), load latency, cache-miss, RVC-fraction, and dispatch/retire-width
    histograms. Dump via a final block on $finish plus +perf_out=<file>; the legacy
    stdout lines are preserved (run_447_benchmarks.py parses them). Add +maxcyc to
    the testbench so a non-halting workload (xv6 boot) terminates cleanly and dumps.
    All read-only taps; the single-core / COHERENT=0 path stays bit-identical and
    the block is absent from the synthesis tops.
    Add tests/perf: 9 RV64GC mic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
2026-07-08 perf(ooo): predict JAL / direct jumps at dispatch
    A JAL (and c.j/c.jal) was classified as unpredicted control: dispatching one
    raised dispatched_unpredicted_control, freezing all dispatch and fetch
    (control_pending + pc-hold) until it resolved in the ALU ~6 cycles later, even
    though its target pc+imm is known at decode. In an xv6 boot every taken direct
    jump/call paid this (507k of them, ~21% of control flow).
    Restructure the first B2 prediction arm: a PC_uncond lane now sets
    control_predicted + predicted_pc = pc+imm and raises the predictor redirect, so
    fetch steers to the target immediately and the op never enters the freeze. The
    RAS push for calls is nested inside (it was the mutually-ex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
    [riscv_core_ooo.sv]
2026-07-08 perf(ooo): add BTB module + unit test (P2 foundation)
    src/btb.sv: a direct-mapped 512-entry branch target buffer, sync-read 1R +
    write-only 1W (macro-mappable like the ASAP7 TAGE/ITTAGE arrays), keyed by the
    16-byte fetch-block PC. Allocate on a taken train, invalidate on a
    not-taken/mis-steer train (a last-taken-target cache; hysteresis is a later
    refinement). Standalone and not yet instantiated -- the fetch-directed
    integration (steer + decode-verify + train) lands next behind -DBTB.
    tests/tb_btb.sv + 'make btb-test': allocate/hit/miss/tag/invalidate/re-alloc
    and the 1-cycle sync-read timing. Expect TB-BTB: ALL PASSED.
2026-07-08 refactor(target): separate ASIC(ASAP7) knobs from FPGA/sim behind -DNIIGO_ASIC
    The ASAP7 branch had baked ASIC-tuned choices into the shared RTL, so the FPGA/
    sim path silently inherited them (e.g. the CVFPU FMA ran 3 pipe stages instead of
    the FB2b-validated 2). Introduce ASIC=1 -> -DNIIGO_ASIC as a single target
    selector (mirroring RV64=1 for datapath width); default = FPGA / functional sim.
    Target-gated, RESULTS-IDENTICAL knobs:
    - niigo_fp_unit: CVFPU FMA (ADDMUL) pipe stages 3 (ASIC) / 2 (FPGA+sim). Latency
    only -- the IEEE result/fflags are identical at any depth.
    - riscv_core_ooo: RAS depth 32 (ASIC) / 128 (FPGA+sim). Pure prediction hint.
    Also fix l1_data_array: the NIIGO_SR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
    [l1_data_array.sv, niigo_fp_unit.sv, riscv_core_ooo.sv]
2026-07-08 perf(ooo): offset-precise fetch-directed BTB (-DBTB, default off)
    Steer the next fetch to a taken branch's target the cycle its block is
    fetched, eliminating the taken-control fetch bubble. rvc_realign terminates
    the steered block at the predicted branch's exact parcel offset, so RVC
    mid-block branches and parcel-7 tail-straddles stay correct -- a terminated
    block never orphans the straddle latch. Every steer is verified at decode
    against the real TAGE/RAS/ITTAGE prediction: suppress-on-agree (the win),
    else flush + offset-precise recover (fall-through / sequential); the BTB is a
    pure performance hint, and all verify arms are gated on a valid presented
    group so a post-flush stale hit cannot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
    [riscv_core_ooo.sv, rvc_realign.sv]
2026-07-09 perf(ooo): DTLB-hit load translate bypass (-DXLATE_BYPASS, default off)
    Let a plain LOAD whose translation resolves this cycle (DTLB hit / bare / PMP-ok)
    issue the SAME cycle it presents, bypassing the FB2b registered-translate stage,
    via an "effective translate" that uses the registered result when current else the
    live combinational DTLB/DataPMP result. Restricted to plain loads -- stores, AMO,
    LR and SC keep their commit-write / reservation ordering on the registered path
    (a full bypass reorders them: the xv6 spinlock release() panics).
    Gated behind -DXLATE_BYPASS (default off; the OFF path is bit-identical -- the _eff
    signals alias xlate_*_q, verified by an identical xv6 retired count).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
    [load_store_queue.sv]
2026-07-09 perf(ooo): store->load forwarding-opportunity counter (P3 L2a, display-only)
    On a store-park cycle, classify whether a younger load could forward from the
    parked head store (LSQ_FWD_ NA/NOLOAD/NOMATCH/PARTIAL/FULL), modeling the real
    forward stalls (device-PA on the store's captured store_lo_pa, single-word store
    and load, no intervening store, byte full-cover) so FULL is not over-counted.
    Histogrammed in the SIMULATION perf block like the P3-M0 head-blocking counter;
    pure combinational off registered entries_q, feeds no functional logic, optimized
    away in synthesis (xv6 retired count unchanged; ACT 333/333).
    Measure-first, per plans/ooo-perf.md P3 lever 2: it shows store->load forwarding
    i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
    [load_store_queue.sv, riscv_core_ooo.sv]
2026-07-09 perf(rv64c): widen the RVC realigner to 4 lanes (-DREALIGN4, default 2-wide)
    Widen the expand-before-decode realigner from 2 to 4 emitted lanes so the
    compressed frontend can feed all 4 backend dispatch slots, gated by
    -DREALIGN4 (RVC_NLANES macro in ooo_types.vh; the default 2-wide path is
    behaviourally identical).
    Lanes 2/3 mirror lane 1 as feed-forward stages over the l1_next/l2_next
    start-pointer ripple. The P2b offset-precise BTB termination extends to
    them (terminated_before_i suppression + rvc_btb_terminate over all lanes);
    parcels_dispatched widens to 4 bits. The parcel-7 straddle latch is
    width-invariant and unchanged. ooo_fetch_decode and riscv_core_ooo consume
    RVC_NLANES lanes; v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
2026-07-09 perf(ooo): grow PHYS_REGS 64->128 under -DDEEP_WINDOW (P6 window depth)
    Give the physical-register free list burst headroom over the 32-entry ROB.
    Under 4-wide dispatch (-DREALIGN4) the 2-stage commit returns freed registers
    slower than dispatch allocates them, so at the tight PHYS_REGS=64 (= 32 arch +
    32 ROB, zero headroom) the free list starves before the ROB fills. Gated by
    -DDEEP_WINDOW (default 64 is bit-identical); phys_reg_t auto-widens 6->7.
    128, not 96: free_list.sv is a power-of-2 ring buffer (bare +1 pointer wrap and
    free_distance = PHYS_REGS - from + to), so a non-power-of-2 size hands out
    out-of-range registers. The ROB (ACTIVE_LIST_SIZE) is left at 32 -- growing it
    would raise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
    [branch_stack.sv, free_list.sv]
2026-07-09 perf(ooo): resize IQ/ROB/LSQ window structures under -DBIG_IQ/BIG_ROB/BIG_LSQ (P6b)
    Grow the out-of-order window depth, each behind its own gated macro (defaults
    bit-identical): INT_IQ_SIZE 16->24 (BIG_IQ), ACTIVE_LIST_SIZE/ROB 32->64
    (BIG_ROB), MEM_Q_SIZE/LSQ 16->32 (BIG_LSQ). The ROB and LSQ are power-of-2 ring
    buffers (bare +1 pointer wrap + ring distance), so they take only power-of-2
    sizes; 48/24 would index out-of-array slots. BIG_ROB=64 needs PHYS_REGS >= 32+64
    = 96 (the free-list deadlock floor), so it requires -DDEEP_WINDOW (PHYS_REGS=128)
    -- enforced in the build flags. INT_IQ is a collapsing slot queue, so 24 is fine.
    active_id_t / iq_idx_t / all counts auto-derive via $clog2.
    Re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
2026-07-09 docs: document the OoO perf build flags + the PERF=1 umbrella
    Add the gated OoO performance flags (RVC/REALIGN4/DEEP_WINDOW/BIG_IQ/BIG_ROB/
    BIG_LSQ/BTB/XLATE_BYPASS) and the PERF=1 canonical-build umbrella to the Build
    section, with the standing rule to measure OoO perf on L1D (not the passthrough
    default, whose fixed-latency load model fabricates a memory-bound signature).
    Also lands the working-agreement / commit-hygiene notes already staged in the
    working tree.
2026-07-09 perf(ooo): de-serialize FP ops via an FPR scoreboard (-DFP_OOO, default off)
    Every FP op today (including FP loads/stores) is marked serializing, which
    quiesces ALL dispatch from the op's dispatch until it retires. On dense FP code
    that freezes the machine ~80% of cycles.
    Under -DFP_OOO the blanket serialization is replaced with a single-producer
    architectural-FPR scoreboard:
    - decode drops the serializing bit for OP_LOAD_FP/OP_STORE_FP/OP_MADD.../OP_FP;
    - a per-FPR busy bit is set at dispatch of any FPR writer (incl. FP loads) and
    cleared at retire (commit fp_write -> fp_rd);
    - an FP op stalls at dispatch only while an FP source FPR is busy, and a WAW
    dispatch-stall keeps at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
    [ooo_dispatch_control.sv, riscv_core_ooo.sv, riscv_decode.sv]
2026-07-09 docs(perf): fold FP_OOO into PERF=1 + document the P5/P7/P8 gated flags
    FP_OOO (P5, the FP de-serialization win: fpkernel +48%, neutral non-FP) joins the
    PERF=1 umbrella beside the other landed levers. CLAUDE.md's OoO-perf-flags
    paragraph gains FP_OOO plus the two measure-first-NEUTRAL levers kept as gated
    infra but deliberately NOT in PERF: BTB_DIR (P8, refuted "fixes BTB xv6-neutrality")
    and BIG_BSTACK (P7, eliminates the branch-checkpoint stall but IPC-neutral -- the
    stall is a symptom, not the binder).
    Verified: make verilator-build PERF=1 -> rv64GC ACT 333/333, xv6 boots to $ + ls.
2026-07-11 perf(ooo): add a 3rd integer ALU issue port (ALU4), fold into PERF
    Adds ALU_ISSUE_PORTS=3 under -DALU4 so up to 3 independent ALU ops issue per
    cycle, relieving the 2-ALU-port throughput binder on integer-ILP code. The IQ ALU
    pick is generalized to a parameterized N-pick (value-identical to the 2-pick at
    2 ports); a 3rd ooo_alu_pipe is added (CSR confined to ALU0/ALU1, since the priv
    CSR file has 2 read ports), the phys regfile grows a read-port pair, and the
    writeback bus gains a 3rd ALU source (load stays above the backpressurable
    mul/div/fp so it is never dropped at 3 ports). Folded into the PERF umbrella.
    alu_ilp -25.7% cycles (IPC 1.93 -> 2.60); neutral on the other 8 microbenches
    (the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
    [int_issue_queue.sv, ooo_writeback_bus.sv, riscv_core_ooo.sv]
2026-07-11 perf(ooo): Track A foundation — LSQ_MLP gating + CCD/COHERENT pin (-DLSQ_MLP2)
    Scaffolding for the non-blocking-L1D / memory-level-parallelism increments. Adds
    the LSQ_MLP / LSQ_ID_W localparams and the correctness-critical CCD/COHERENT pin:
    a coherent build is forced back to LSQ_MLP=1 (two in-flight loads would open an
    RVWMO load-load reorder window with no inflight-load squash), enforced at
    elaboration by an initial-time $fatal. LSQ_MLP2 requires OoO + L1D.
    Inert: LSQ_MLP currently feeds only the build-assert, so PERF+LSQ_MLP2 is
    bit-identical to PERF (rv64gc ACT D-group 114/114, build clean). The dmem
    transaction-id plumbing and the issue_ptr decouple follow as separate increments.
    [load_store_queue.sv]
2026-07-11 perf(ooo): Track A P3a — dmem transaction-id plumbing (-DLSQ_MLP2, inert)
    Thread a per-request dmem transaction id LSQ->core->memsys->l1_dcache and
    back (dmem_req_id / dmem_resp_id) so a data-port response can be matched to
    its outstanding slot, the prerequisite for the later out-of-order (parked)
    load completion. Carried on the passthrough d_q FIFO (d_ent_t.id), the L1D
    op sidecar (op_id_q), and the device-bypass path (dev_id_q, selected by the
    response mux); an assertion guards the single dmem_resp lane against a
    device+cache collision (device and cacheable loads never overlap in flight).
    The device byte offset stays head_load_off (devices are single-outstanding
    at the head), so no per-i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
    [l1_dcache.sv, load_store_queue.sv, niigo_memsys.sv, riscv_core.sv, riscv_core_ooo.sv, testbench.sv]
2026-07-11 perf(ooo): Track A P3b — non-blocking LSQ, 2 loads outstanding (-DLSQ_MLP2)
    Decouple issue_ptr from the retire head so a 2nd (younger, plain cacheable)
    load can be translated and issued while the head's load is still outstanding.
    A time-muxed translate port with REGISTERED-target arbitration (head-priority,
    so the DTLB address index stays register-driven and the head translate +
    XLATE_BYPASS are unchanged) feeds head and issue_ptr; the outstanding loads
    are tracked as a FIFO of slots with a MONOTONIC per-slot kill (owner squashed
    => its stale response is discarded) plus an active-id gen-match on delivery.
    Delivery stays in order (the memsys returns responses oldest-first), checked
    by a run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
    [load_store_queue.sv]
2026-07-12 perf(ooo): Track A P3b fix -- the non-blocking LSQ now issues the 2nd load
    The prior P3b was functionally MLP=1: issue_ptr never detached from the
    retire head, so the younger (2nd) load never issued (mlp_stream ip_fires=0).
    Five defects, all inside the `ifdef LSQ_MLP2` 2-outstanding path, so the
    default / CCD / scalar (non-LSQ_MLP2) builds stay bit-identical:
    - issue_ptr steps over the head's own issued single-beat load and tracks its
    distance from the head via an offset register with modular, all-unsigned
    arithmetic (head_adv_k is the full modular head advance, not 0/1/2) --
    replacing a mod-ring compare that could teleport issue_ptr past an older
    store. A sim assertion guards "no s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
    [load_store_queue.sv]
2026-07-12 perf(ooo): Track A P3c-1 -- LSQ inflight ring -> valid-bitmap pool (-DLSQ_MLP2)
    Convert the outstanding-load inflight FIFO to a valid-bitmap pool so a later
    increment can free/deliver slots out of order (hit-under-miss parked completion):
    - alloc the LOWEST-FREE slot (inflight_alloc_id) instead of a ring tail;
    - free/deliver the slot the response NAMES (dmem_resp_id), gated on
    inflight_valid_q[dmem_resp_id] so a mis-named response is a no-op (no count
    underflow / slot leak);
    - delivery gate keyed on dmem_resp_id (valid && owner==head && gen-match && !kill);
    - delete the inflight_head_q/tail_q ring pointers (the pool's lowest-free id
    assignment legitimately differs from a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
    [load_store_queue.sv]
2026-07-12 perf(ooo): Track A P3c-2 -- LSQ parked out-of-order completion (-DLSQ_MLP2)
    Add the LSQ side of hit-under-miss: a younger cacheable load whose response
    returns BEFORE it reaches the head is latched into that entry (parked_data/
    parked_done) and retired from the park when it becomes head, with no live
    response. Machinery only -- INERT on the blocking L1D (responses are in order,
    so a response always names the head's slot -> owner==head -> park never fires);
    the L1D op2 path that makes it fire lands in P3c-3.
    - mem_entry_t gains parked_data/parked_done (ifdef'd -> OFF struct unchanged);
    - park_delta path: computed in block HD from REGISTERED state only (no wakeup,
    so load_writeback's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
2026-07-12 perf(ooo): Track A P3c-3 -- L1D hit-under-miss, activates the feature (-DLSQ_MLP2)
    The increment that makes the non-blocking L1D actually overlap a younger HIT under
    an older MISS. Integrated no-skid design (resp2 OR-muxed directly onto the single
    dmem lane; the resp/resp2 disjoint-state proof removes the need for a skid).
    l1_dcache.sv (accept-and-park):
    - during a primary miss (S_WB_WAIT/S_FILL_WAIT) the idle read port is borrowed for a
    2nd op (op2): req_ready is relaxed to accept it, op2 does a HIT-ONLY lookup;
    - a different-set cacheable HIT returns early on a read-only resp2 lane; a
    miss/store/same-set op2 is PARKED and promoted to the next primary (S_OP2_PROMOTE)
    after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
2026-07-12 perf(ooo): Track A P3d-0 -- L1D id-matched WAIT consumption (-DLSQ_MLP2)
    Make the vestigial {src,gen} NMI id load-bearing at the L1D BEFORE the fabric goes
    multi-outstanding (P3d-1/P3d-3): latch exp_wb_id_q / exp_fill_id_q at the S_WB_REQ /
    S_FILL_REQ fire edge (co-located with the gen_q bump so it captures the id the outgoing
    request used), and consume nmi_resp in S_WB_WAIT / S_FILL_WAIT ONLY when its id matches.
    Without this, once two L1D fills are in flight a mismatched response could install into
    the wrong miss context (silent corruption).
    Cycle-identical on the still-single-outstanding backend (the sole in-flight op's id
    always matches), so it is a pure prerequisite with zero behavior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
    [l1_dcache.sv]
2026-07-12 perf(ooo): Track A P3d-1 -- nmi_arbiter 2-context, id-routed (-DLSQ_MLP2)
    Replace the scalar single-context arbiter (busy_q/sel_q) with a 2-entry context table:
    each forwarded op is tagged with its issued NMI id + owning master index, and each
    response is routed to the master whose id it carries (not a single sel_q). This makes
    the arbiter capable of routing out-of-order responses once the backend is multi-
    outstanding (P3d-3) and independently unlocks L1I||L1D refill overlap.
    Cycle-identical to the scalar arbiter while the downstream (sim adapter / AXI bridge)
    is single-outstanding: d_ready then gates forwarding to one op at a time, so only one
    context slot ever fills and the id-matched ow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
    [nmi_arbiter.sv]
2026-07-12 perf(ooo): Track A P3d-2 -- concurrent L1D op2-MSHR (clean-victim) (-DLSQ_MLP2)
    Give the L1D a 2nd concurrent miss context so a younger load can fill WHILE an older
    miss is in flight (the miss-under-miss structure). Grown from the P3c op2 seed: when an
    accepted op2 is a DIFFERENT-SET LOAD MISS with a CLEAN/invalid victim, it launches its
    own fill leg (OP2_MISS_FILLREQ -> FILLWAIT -> INSTALL) instead of parking; a dirty-victim
    / same-set / store op2 keeps the P3c PARK+promote fallback.
    Clean-victim-only makes it coherence-safe BY CONSTRUCTION: a load fill only copies memory
    into a CLEAN line, never creating dirty state, so the C4a clean-before-refill / SMC
    contract is untouched. Different-se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
2026-07-12 perf(ooo): Track A P3d-3 -- 2-context honest bank-serialized backend; MLP pays (-DLSQ_MLP2)
    Make the sim memory adapter accept 2 outstanding requests so the L1D's two concurrent
    fills (P3d-2) actually overlap. HONEST bank-serialized model: each slot's S_RD_DELAY
    (memory access latency) counts down IN PARALLEL (single-channel DRAM with bank-level
    command parallelism), while the shared main_memory read/write ports (data beats) and the
    single nmi_resp channel are granted to the lowest requesting slot -> beats + responses
    SERIALIZE. So two independent line misses complete in ~max(latency)+serial-beats instead
    of ~sum -- NOT a dual-channel full-overlap idealization (main_memory has one read port)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
2026-07-13 perf(ooo): Track A -- fix LSQ_MLP2 xlate_target_q per-load issue bubble
    The LSQ_MLP2 translate port aimed mem_req_vaddr + mlp_xt_head from the
    registered xlate_target_q, so on the cycle the head advanced to a new
    load, mlp_xt_head=(xlate_target_q==head_q) was false for one cycle --
    disabling the XLATE_BYPASS gate and the head-issue gate. Every head load
    then issued a cycle late: hidden on dependent chains (ptrchase neutral)
    but a per-load throughput bubble on independent-load streams, active even
    when MLP never fires (ip_fires=0). Survey geomean -14.4% under fuzz-16
    L1D (matmul -47%, crc32 -17%, fibrec -29%), which had made P3d net -4.31%.
    Give the head strict combinational priority on the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
    [load_store_queue.sv]
2026-07-13 perf(ooo): fold LSQ_MLP2 (Track A non-blocking L1D) into PERF
    With the xlate_target_q per-load issue bubble fixed, LSQ_MLP2 is net-positive
    on the honest fuzz-16 L1D perf harness (survey ~0, independent-miss streams
    +~55%, aggregate +6.45%), so it joins the canonical PERF umbrella alongside
    XLATE_BYPASS / FP_OOO / ALU4. Like those it carries an Fmax cost -- PERF is a
    functional sim build; an FPGA/ASIC build should drop it. Default (non-PERF)
    builds are unchanged: LSQ_MLP2 is absent -> bit-identical. PERF stays
    incompatible with CCD (the coherent D-side pins LSQ_MLP=1).
    Docs: CLAUDE.md flag list + PERF umbrella + LSQ two-outstanding description;
    README LSQ description in the PERF reference c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
2026-07-13 perf(ooo): Track A P3e -- admit RV64 single-beat FP loads to the non-blocking LSQ MLP
    FP-dense miss-streams got ZERO memory-level parallelism under LSQ_MLP2 (fp_mstream
    ip_fires=0, two_out=0) because FP loads were carved out of the non-blocking issue+park
    path (ip_carve_c / ip_want_c, "P3c-2 (M3): FP head-only") -- so the FP scoreboard binder
    was never even exposed (see the Track A re-eval). P3e admits RV64 single-beat FP loads.
    Safe on RV64: at the parked retire fp_data derives from load_writeback.data =
    format_load(deliver_word,...), so a parked FP load formats from its OWN buffered word (not
    a stale data_load); needs_two_beats already excludes misaligned FLD / word-crossing FLW;
    and park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
    [load_store_queue.sv]
2026-07-13 perf(ooo): gate the FB2b 2-stage ROB commit behind -DCOMMIT_1STAGE
    COMMIT1=1 reverts active_list's commit path from the FB2b 2-stage (registered
    recovery-root + sliding-window present-at-head_next, f4e08bd) to the pre-FB2b
    1-stage combinational commit (present-at-head_q, no register). Default OFF is
    the 2-stage, bit-identical -- verilator -E confirms the COMMIT_1STAGE-off
    reduction of active_list.sv is byte-identical to the current 2-stage source,
    and the ON reduction is byte-identical to the standalone 1-stage build.
    The 2-stage adds one cycle to every commit-gated dependency release, and the
    FP_OOO scoreboard clears fpr_busy at COMMIT -- so FP-dense code pays it on
    every FP producer->cons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
    [active_list.sv]
2026-07-15 fix(ooo): disambiguate active_list ROB full/empty on branch restore
    active_distance() is mod-ACTIVE_LIST_SIZE, so it returns 0 (never SIZE) when
    rtail == head_id: a full ring aliases onto an empty one. That state is reachable
    -- full = (count_q > SIZE - OOO_WIDTH) lets a 4-wide group drive count_q to
    exactly SIZE (head_q == tail_q, full), and because a dispatched branch terminates
    its group a branch can be the youngest ROB entry, whose checkpoint tail == head_q.
    If that branch mispredicts, recomputing the occupancy as active_distance(head,
    head) = 0 declares the ROB empty while every entry is still live -- a silent wipe
    that orphans the in-flight physregs/LSQ entries and hangs the machine.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
    [active_list.sv]
2026-07-15 perf(ooo): out-of-order control-flow issue (-DCF_OOO)
    The baseline gates control-flow issue on branch_mask == 0
    (int_issue_queue.sv), so a CF op may issue only once every older branch it is
    speculative under has resolved -- only the oldest unresolved branch ever
    executes, and branch resolve (hence branch-checkpoint reclamation) is fully
    serialized. That gate was an admitted stop-gap ("conservatively handle nested
    branches for now"), not a correctness requirement: branch_stack is an
    order-agnostic pool whose frees are keyed by resolve_id, and no recorded bug
    depends on the gate.
    CF_OOO demotes the rule from a BAN to a PRIORITY. A younger CF op may take the
    (<=1/cycle, cf_prefix) CF issue slo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
    [int_issue_queue.sv]
2026-07-15 test(perf): add Dhrystone benchmark and wire it into run_perf_suite.sh
    Adds the upstream (riscv-software-src/riscv-tests) Dhrystone benchmark as a
    first-class perf-suite member. The benchmark sources are used byte-identical
    (cmp-asserted in run_dhrystone.sh) with upstream's own -O2/rv64gc flags and
    separate translation units, so the score is comparable to other riscv-tests
    Dhrystone results; only the environment is ported (tests/perf/dhry/{start.S,
    env.c}) because upstream's crt.S/syscalls.c target the HTIF console this SoC
    lacks. Output goes over the NS16550A UART; the string/memory routines on the
    timed path are copied verbatim from upstream for score integrity; a post-run
    self-check verif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
2026-07-15 docs: document CF_OOO / BIG_BSTACK / COMMIT1 flags + Dhrystone in the perf suite
    CF_OOO (out-of-order control-flow issue) is newly landed and documented in the OoO
    perf-flags list. BIG_BSTACK is reclassified from measured-neutral to a branch-dense
    win -- P7 shelved it as neutral on a suite that had no branch-dense workload.
    COMMIT1 (-DCOMMIT_1STAGE) is now documented. Records that CF_OOO+BIG_BSTACK+COMMIT1
    compose on top of PERF to Dhrystone +22.4% (1.176 -> 1.440 DMIPS/MHz, IPC
    0.83 -> 1.02) with zero suite regressions, kept as opt-ins pending a deliberate PERF
    re-baseline rather than folded in silently. Documents the run_perf_suite.sh entry
    point and its new Dhrystone member (DMIPS/MHz; ne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
2026-07-15 perf(ooo): gated JAL checkpoint elision (-DJAL_NO_CKPT) + dual-branch counter
    Two gated, default-OFF, measure-first results from the branch-dispatch study. Both
    are bit-identical OFF (verified: the OFF build is cycle-identical to the baseline on
    Dhrystone) and kept as gated infra with their measured verdicts recorded.
    -DJAL_NO_CKPT: stop allocating a branch checkpoint for JAL (PC_uncond). A JAL is
    always correctly predicted (predicted_pc == pc+imm == target), so its checkpoint
    can never be restored -- dead weight that also inserts a branch_mask bit
    serializing younger branches and stalls dispatch on a full stack. Drops the JAL's
    checkpoint allocate + branch resolve (branch_id 0, branch_vali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
    [ooo_alu_pipe.sv, ooo_dispatch_control.sv, riscv_core_ooo.sv]
2026-07-15 perf(ooo): decoupled-frontend (FTQ) instrumentation -- S0 counters + S1a predecode probe
    Gated, default-OFF, inert scaffolding for the decoupled fetch-target-queue frontend
    (plans/decoupled-fetch-ftq.md), which targets the sync-read predict_stall bubble --
    the frontend dispatch-supply binder that caps the core after the CF_OOO/BIG_BSTACK/
    COMMIT1 branch win. Both flags OFF = source-unchanged; DFE_S1 ON is cycle-identical
    to baseline (no datapath effect).
    -DDFE_STATS (S0): perf counters that measure how much predict_stall is actually
    CONVERTIBLE -- predict_stall_sole (the only dispatch inhibitor + backend not full)
    and _resident (a block already buffered). Measured: Dhrystone predict_stall_s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
2026-07-16 perf(ooo): DFE_S2 async TAGE read + fold branch/frontend levers into PERF
    DFE_S2 (-DDFE_S2, decoupled-frontend Stage 2): make the TAGE read
    combinational (async) instead of sync-read (tage_sc_l_predictor.sv:
    read-stage always_ff -> always_comb, Stage-2 unchanged), so a conditional
    branch's direction is available the cycle it reaches the dispatch head;
    narrow pred_launch to indirect-only, removing the sync-read predict_stall
    frontend bubble. Value-identical to the sync read -- the async read at
    cycle T returns the same array values the sync read delivered at T+1, so
    mispredicts are unchanged and predictor state is inert (correctness
    untouched, only cycle counts). geomean +4.9% IPC, zero regre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
    [riscv_core_ooo.sv, tage_sc_l_predictor.sv]
2026-07-16 perf(ooo): ROBHEAD_STATS -- decompose commit-starvation by ROB-head reason
    -DROBHEAD_STATS (diagnostic, sim-only under SIMULATION_18447, OFF
    bit-identical): split commit_starved_backend (0-retire, non-empty ROB)
    into three mutually-exclusive reasons for why the ROB head did not retire:
    cs_gated -- head ready (commit_valid[0]) but retirement gated
    (store port / SC-AMO / commit gate)
    cs_window -- head stalled AND ROB full = out-of-order-window bound
    cs_latency -- head stalled but the window has room = the head is waiting
    on its own op / dependency chain (ILP / FU latency)
    Measured on Dhrystone: cs_latency 90.9% / cs_window 9.1% / cs_gated 0.0%
    of commi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
    [riscv_core_ooo.sv]
2026-07-18 perf(ooo): staged Dhrystone direct-attack levers -- fusion infra + 5 gated µarch levers
    Implements plans/dhry-direct-attacks.md (all six stages), every lever
    -D-gated default-OFF with per-lever OFF byte-identity proven by
    verilator -E token-stream diff. Measured marginals on PERF (Dhrystone,
    keep/drop per the plan's measure-first rule):
    - FUSE_ANY/FUSE_BRANCH (shared fusion infra): combinational cross-lane
    adjacent-pair detector (decode-derived only), null-slave path,
    born-done ROB slot, lane_fuse_pre_branch atomicity stall, FUSE_BRANCH
    predictor rewiring + payload structs. Plumbing; enables the fusions.
    - FUSE_UADDR (-DFUSE_UADDR): lui/auipc+addi const-fold + auipc+load
    AGU pc-bas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
    [active_list.sv, int_issue_queue.sv, load_store_queue.sv, ooo_alu_pipe.sv, ooo_dispatch_control.sv, ooo_writeback_bus.sv, riscv_core_ooo.sv]
2026-07-18 test(perf): add Embench-IOT as the default perf-benchmarking suite
    - tests/embench/boardsupport.c: niigo bare-metal board support -- Embench hooks
    (mcycle/minstret triggers), a minimal freestanding libc, and a main() that reports
    the timed region (start->stop) over the UART; linked with tests/perf/{start.S,bench.ld}.
    - scripts/run_embench.sh: build+run all 19 Embench benchmarks (RV64GC), report per-bench
    timed-region cyc/instret/IPC + geomean; LSF scale override (default 4 for the functional
    sim), newlib libc.a on-demand + -std=gnu11; writes output/embench/<label>/summary.tsv.
    - scripts/embench_compare.sh: A/B two labels -> per-bench + geomean speedup (flags INSTRET
    mismatch = non-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
2026-07-24 perf(ooo): gated perf-counter instrumentation -- dispatch/flush/cs_latency decomposition
    Adds four gated, OFF-bit-identical instrumentation flags for perf-binder analysis.
    Verified non-perturbing (PERF=1 alone reproduces 778193 cyc / 1.463 DMIPS exactly) and
    OFF-path clean (every change is `ifdef`-gated or feeds a display-only counter).
    - DISPATCH_STATS: decompose the 44% zero-dispatch cycles by cause. ooo_dispatch_control
    emits DCUT_*/DSTL_* reason codes at the exact ladder site that fires (no re-derivation
    in the core, so the classifier cannot drift), plus a fetch-flush-by-source counter
    (ff_src assigned beside each fetch_flush site, last-writer-wins) with per-source refetch
    bubbl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
    [active_list.sv, int_issue_queue.sv, load_store_queue.sv, niigo_fp_unit.sv, ooo_dispatch_control.sv, ooo_div_unit.sv, ooo_mul_unit.sv, riscv_core_ooo.sv]
2026-07-24 perf(ooo): XLATE_BYPASS_ST -- extend the DTLB-hit translate bypass to plain stores
    Stores spent 58467 cyc (14.6% of cs_latency, per the CSWHY head-reason decomposition) in
    the FB2b registered head-translate stage that XLATE_BYPASS skips for loads but not stores.
    XLATE_BYPASS_ST admits plain stores to the same bypass: a store completes/captures its PA
    the cycle it presents (on a DTLB hit) instead of eating the +1 registered-translate bubble.
    The change is one gated condition in load_store_queue.sv: (memRead||memWrite)&&!AMO ==
    {plain load, plain store}. AMO/LR/SC (EXEC_AMO) stay on the registered path (they carry the
    reservation / commit-serialization state). Safety: the bypass fires only on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
    [load_store_queue.sv]
